anand2532/PocketMate/mechanical/freecad/README.md

# mechanical/freecad

> **Superseded:** the current enclosure is [`../release_v5/`](../release_v5/) (see [`../README.md`](../README.md)).

**Last FreeCAD version: v4_22c** — passive 22 mm aluminium unibody (layout final positions).
- `pocketmate_enclosure_v4_22c.FCStd` – FreeCAD model, built by `build_v4_22c.py`
- STEP: `pocketmate_al_unibody_v4_22c.step`, `pocketmate_assembly_v4_22c.step`, `pocketmate_plastics_v4_22c.step`, `pocketmate_sidekey_flex_v4_22c.step`
- Renders: `pocketmate_enclosure_v4_22c_*.png`
- Board outline: `board_outline_v4_22c.dxf` (generated by `gen_board_v4_22c.py`)
- Keep-outs: `keepouts_v4_22c.md` (a delta on v4_22b, which is not in this repo)

Earlier v2 files (`*_v2.*`, `build_enclosure_v2.py`) are kept for reference and are superseded.
Thermal notes live in `../` (`thermal_v2.md`, `thermal_v3.md`, `thermal_v3_ribs.md`, `thermal_v5_22.md`).
