anand2532/PocketMate/hardware/layout/placement_plan_v1.md

# PocketMate CM5 carrier: stackup and placement plan v1, rev B: mechanical v3 (2026-10-21)
Inputs: mechanical **v3** (`mechanical/board_outline_v3.dxf`, `keepouts_v3.md`; it supersedes v2), schematic v1 (`hardware/kicad`, ERC clean, final netlist still to come).
PCB: `hardware/kicad/PocketMate.kicad_pcb` (generated by `hardware/layout/make_pcb_v3.py`; net classes in `PocketMate.kicad_pro`, layer-specific impedance rules in `PocketMate.kicad_dru`).
Coordinates: **mech frame** = body centre origin, +Y to top edge, viewed from the display side (same as keepouts_v2). KiCad Y = -mech Y.

## 1. Stackup: JLCPCB JLC06161H-3313 (6 layers, 1.6 mm, 1 oz outer / 0.5 oz inner)
Source: JLCPCB stackup table (https://jlcpcb.com/impedance): L1 Cu 0.035 | PP 3313 0.0994 (Er 4.1) | L2 0.0152 | core 0.55 (Er 4.6) | L3 0.0152 | PP 2116 0.1088 (Er 4.16) | L4 0.0152 | core 0.55 | L5 0.0152 | PP 3313 0.0994 | L6 0.035. Solder mask Er 3.8.

| Layer | Use |
|---|---|
| L1 F (display side) | components, short HS breakouts to FPCs/USB-C, power copper |
| L2 | **solid GND** (reference for L1 and L3) |
| L3 | **HS stripline**: DSI, CSI, USB (refs L4 at 0.109 mm and L2 at 0.55 mm), plus slow signals |
| L4 | **solid GND** |
| L5 | power planes: VSYS, +5V_CM5 (wide pour under CM5 5V pins), VBAT, 3V3 islands |
| L6 B (back) | J1/J2 only inside the CM5 footprint; GND pour; HS escape stubs from J1/J2 |

Impedances: computed with my own 2D quasi-static finite-difference field solver using the JLC geometry above (`hardware/layout/fd_impedance.py`, results in `impedance_results.txt`). **JLC verification status: NOT JLC-verified.** I tried JLC's calculator page and its backend (`POST https://jlcpcb.com/api/jlcTools/impedance/calc`). The endpoint answers, but the calculation runs asynchronously: the page sends a job (accessId + uuid + param MD5) and gets the result back on a push channel inside the browser session. A plain fetch cannot get the results without driving the site's internal session, so I stopped there. Enter these in https://jlcpcb.com/pcb-impedance-calculator:
- Layers 6, thickness 1.6 mm, outer copper 1 oz, inner 0.5 oz, unit mm; select stackup **JLC06161H-3313**.
- (a) 100 Ω differential, layer L1 (ref L2), spacing 0.15 → expected width ≈0.12. (b) Same on L6 (ref L5; **note L5 is my power plane, so JLC refs L5. Either make L5 GND under the L6 escapes or keep L6 HS to ≤3 mm stubs.**) (c) 100 Ω differential, L3, upper ref L2, lower ref L4, spacing 0.15 → ≈0.11.
- (d) 90 Ω differential L1/L2, spacing 0.15 → ≈0.15. (e) 90 Ω differential L3 (L2/L4), spacing 0.15 → ≈0.14.
- (f) 50 Ω single-ended L1 (ref L2) → ≈0.18. (g) 50 Ω single-ended L3 (L2/L4) → ≈0.15.
If JLC returns widths more than ±0.01 mm different, update `PocketMate.kicad_dru` and the net classes to the JLC numbers. Production uses JLC's numbers.

| Target | Layer | Width / gap (mm) | Solved | JLC-verified |
|---|---|---|---|---|
| 100 Ω diff (DSI, CSI) | L1/L6 microstrip | 0.12 / 0.15 | 99.8 Ω | no (pending) |
| 100 Ω diff | L3 stripline | 0.11 / 0.15 | 101.5 Ω | no (pending) |
| 90 Ω diff (USB 2.0) | L1/L6 | 0.15 / 0.15 | 90.8 Ω | no (pending) |
| 90 Ω diff | L3 | 0.14 / 0.15 | 90.2 Ω | no (pending) |
| 50 Ω SE | L1/L6 | 0.18 | 49.8 Ω | no (pending) |
| 50 Ω SE | L3 | 0.15 | 50.7 Ω | no (pending) |
Keep GND pours at least 3× the width away from pairs, or ≥0.3 mm. Place GND stitching vias next to every layer-change via. Do not route L3 HS pairs across any L4 split; L4 stays unbroken.

## 2. Board file (done, rev B to v3)
- v3 changes: boss keep-outs R3.2 at (57.5,±31.5), off-board, so no corner trim. SoC pad zone (no B-side parts except J1/J2) moved to X 7..37, Y -28..2. **No-copper, no-parts rule area, all layers, X 47.5..54, Y -11.5..-0.5** (CM5 antenna edge). No parts on F/B along the U.FL pigtail path at Y 0..2, X 47.5..54. F-side no-parts area X 9..21, Y 24..27 for the display FPC drop onto J3 (≥15 mm free length). The RF free volume X 54.4..60, Y -25..11 is off-board (marked on User.Comments); the board edge at X 54 sits 0.4 mm short of it.
- USB-C **J6 = HRO TYPE-C-31-M-17** (KiCad `USB_C_Receptacle_HRO_TYPE-C-31-M-17`), placed and locked at (20,-32.1), mouth at Y -35.5. No fully SMD 16-pin USB2 receptacle exists in the KiCad library (GCT USB4135 is 6-pin/power only), so I chose the one whose rear shell pegs are at **Y -29.1 (<-29 ✔)**. Their pad copper reaches Y -28.25 at X 24.32. That is only ≈0.15 mm from the J2 body edge (Y -28.4) in Y, on the opposite side. Check this against the real J2 footprint once it is placed. Cleaner alternative: move USB-C to centre X 12 (needs an enclosure opening change). Front pegs at -32.9 sit 0.25 mm from the board edge (local rule J6 edge ≥0.2 mm).
- J_NTC (JST SH SM02B-SRSS-TB) placed at (2,-20).
- DRC after v3: **0 errors**, 0 unconnected (warnings: silk/text only).
- Earlier v2-based content:
- 6 layers, 1.6 mm. Outline from v2: X -1..54, Y -34..35, R3 corners, camera notch removed (X≥27, Y≥10.5).
- H1–H4: M2.5 Ø2.7 at (2.5,-26.5) (50.5,-26.5) (2.5,6.5) (50.5,6.5), no copper. Rule areas R3.0 around each hole (no tracks/vias/pours, F+B).
- Boss keep-out R3.2 at (57,-31), all layers.
- B side: rule area over the CM5 footprint (X -1..54, Y -30..10), J1/J2 only. SoC pad zone (11.5..41.5, -25..5) also allows no footprints on B.
- F.Fab/B.Fab: drawings of the connector zones, CM5 and J1/J2; User.Comments: height limits. DRC: 0 errors (only text/silk warnings).

## 3. CM5 B2B J1/J2 (Amphenol 10164227-1001A1RLF, 1.5 mm stack), verified against the official drawing
Source: Raspberry Pi *Compute Module 5 datasheet*, §4.1.1 Figure 4 "Mechanical specification… viewed from the top" (https://datasheets.raspberrypi.com/cm5/cm5-datasheet.pdf, p.16), plus Table 13 (mounting holes at (3.5,3.5) (51.5,3.5) (3.5,36.5) (51.5,36.5)).
From the figure (module top view, origin at the bottom-left corner): both connectors are centred **21.5 mm from the hole centre = X 25.0**. Their centrelines are **3.0 mm** from the long edges (Y 3.0 for pins 101–200, Y 37.0 for pins 1–100). Pin 1/2 and pin 101/102 sit at the right (high-X) end. The SoC centre is at (31.99, 16.975). The UFL is 2.567 mm from the left edge, in the wireless cut-out at the left edge.
Mapping (inverted CM5 seen from the display side = mirror in X): **carrier X = 54 - mx, Y = -30 + my**. The holes map onto H1–H4 exactly.

| Ref | Side | Centre, mech (X,Y) | Centre, KiCad (X,Y) | Orientation |
|---|---|---|---|---|
| **J1** (CM5 pins 1–100) | B | **(29.0, 7.0)** | (29.0, -7.0) | long axis along X; pin 1/2 end at X≈18 (low-X end) |
| **J2** (CM5 pins 101–200) | B | **(29.0, -27.0)** | (29.0, 27.0) | long axis along X; pin 101/102 end at X≈18 |
- Each body is about 22.5 × 2.8 mm (J1 X 17.75..40.25 / Y 5.6..8.4; J2 Y -28.4..-25.6). Mirror the footprint (B side), then check pin 1 against the module with a 1:1 print before release. The datasheet figure is labelled "approximate". **Cross-check the exact centres against the CM5 design-files package (KiCad/STEP) once downloaded** before routing.
- **Correction to keepouts_v2**: it shows J1/J2 at "X 3..25 / 28..50, Y 0..4". That is wrong. The two connectors run along the two 55 mm edges (Y 7 and Y -27), both at X≈18..40.
- SoC lands at mech **(22.0, -13.0)**. The v2 pad/pedestal is centred at (26.5,-10), 4.5 mm/3 mm off. It still covers the die but should be recentred.
- The wireless cut-out/antenna is at carrier X≈47.5..54, Y≈-11.5..-0.5. The UFL is at about (51.4, 1.0) and faces the Al back plate.

## 4. Connector placement (top/F side unless noted)
| Item | Position (mech) | Notes |
|---|---|---|
| USB-C J6 | X 15.5..24.5, Y -34..-28.1, mouth flush at Y -35.5 wall | Its body sits directly over J2 (B side, Y -28.4..-25.6). **Use an SMD-only receptacle with SMD shell tabs, or keep the THT shell pegs at Y < -29.** No THT may enter the J2 B-side area. ESD (USBLC6) and TVS go right behind it at X 9..15. |
| J_BATT (J7) JST ZH 3p side-entry S3B-ZR-SM4A-TF | X 0.75..8.25, Y 21.75..26.25, mouth −X, 3.5 mm tall | BAT+/NTC/BAT−. The 10 mΩ gauge shunt and MAX17055 go within 10 mm at X 2..12, Y 12..20. BAT+/BAT− get ≥1.5 mm traces plus a pour on L1/L5. |
| DSI J3 22p 0.5 mm | X 10..20, Y 20..24 | Display flex exit still to verify. 4.0 mm ledge band if it is within 2 mm of the glass edge. |
| CSI J4 22p 0.5 mm | X 28..40, Y 7..10 | Flex to the camera in the notch (X 28..53, Y 11..35). Lies over J1 on the opposite side. Fine, but keep its vias out of the J1 pad field. |
| Flex J (speaker, 2 mics, mute switch, 4 buttons, ALS, **case NTC**) | X 44..52, Y -33..-30 | Proposed: 0.5 mm FPC, about 24p. The pin count needs the final netlist. |
| **Case NTC** (on the Al back plate inner face at (-55.3,-10)) | wiring | It is not on the carrier, and schematic v1 has **no case-NTC circuit**. Proposal: 10 k NTC (0402 on a small Kapton flex, or a glued bead) → 2-wire 32 AWG / flex tail along the back plate under the battery-pocket bottom edge (Y≈-33, X -55→-1, ~65 mm) → **dedicated 2-pin JST SH SM02B-SRSS-TB (top side, 2.9 mm tall) at X 0..4, Y -22..-18**. Alternative: join the main flex, but that adds ~110 mm of routing to the right end. The divider goes to a +3V3_AON 10 k ref and an STM32U031 ADC pin (MCU next to it, see §5), with 100 nF at the ADC. |
| SWD TC2030 | X 4..12, Y -8..-2 (top) | |

## 5. Power / PMIC / thermal zoning (top side)
- **Input/charger zone**, bottom-left, X -1..15, Y -33..-14: STUSB4500, Q1, BQ25895 plus its 1 µH/2.2 µH inductor (max 4.9 mm; choose ≤2.0 mm, e.g. 4×4×2). Keep the input loop ≤10 mm from USB-C. Put VBUS/VSYS/BAT pours on L1 and duplicate them on L5. Thermal vias go into L2/L4.
- **Boost zone**, X 0..14, Y -12..4: TPS61088 with ≥10 thermal vias under its PowerPad, a 1 µH/≥6 A inductor ≤2 mm tall, and output caps. +5V_CM5 runs on an L5 pour to the J2 and J1 5V pins (the CM5 5V pins are on J1 pins 77–87 area; confirm against the netlist). Load switch Q2/Q3 sits near the boost output. Keep the boost hot loop on L1 only, over solid L2.
- **MCU + AON LDO**, X 2..12, Y 8..20 (near J_BATT, buttons flex via L3), plus the case-NTC connector.
- **Audio** (MAX98357A) near the flex at X 36..44, Y -33..-28. Its BCLK/LRCLK/DOUT come from J2-side GPIOs.
- **Sensors** (VEML7700 sits behind the ALS window at (-58,20) on the far left, so it goes on the flex, not the carrier; DRV2605L DNP) near the flex.
- Thermal: the SoC heat path is CM5 → pad → Al pedestal → back plate. The carrier top under the display holds the charger/boost: keep them ≥15 mm apart, keep the boost and charger out from under the display-backlight centre where possible, and put the charge/boost thermal vias into the L2/L4 GND. Fit a 0402 NTC on the board near the charger for skin-temperature control (BQ TS is used for the cell NTC).

## 6. High-speed routing
All MIPI and USB2 signals live on **J2** (CM5 pins 101–200, Y -27) on the CM4/CM5 pinout: USB2 D± ~103/105, MIPI0 CSI ~115–145, MIPI1 DSI ~157–193. Confirm the exact pins with the final netlist.
- **USB2 (90 Ω)**: J2 → L6 stub → via → L1 → USB-C. Length <10 mm, no stubs, ESD placed in-line on L1.
- **DSI (2 lanes + clk, 100 Ω)**: J2 B-side escape (≤3 mm) → via → **L3** stripline north under the CM5 area at X 12..20 → via near J3 → L1 into the FPC. Length ~55 mm. Intra-pair ≤0.1 mm, lane-to-clock ≤1 mm, pair-to-pair gap ≥0.45 mm (3W), 2 vias per signal max with GND stitch vias.
- **CSI (2 lanes + clk, 100 Ω)**: J2 → L3 north at X 28..36 → J4 (X 28..40, Y 7..10). Length ~38 mm. Avoid the J1 pad field: cross Y 5.6..8.4 only on L3.
- Keep L3 HS pairs away from the boost switch node (≥5 mm laterally, and L4 GND is unbroken beneath).
- I2C/I2S/GPIO go on L3/L1 in the remaining space. 5V and GND pins of J1/J2 get direct vias to L5/L2/L4.

## 7. Height limits (from keepouts_v2)
Top: 4.9 mm everywhere, 4.0 mm in the display-ledge band. B side in the CM5 footprint: J1/J2 only. B side Y -34..-30 / 10..10.5: 5.6 mm. Hole R3.0 and boss R3.2: no parts. Tallest planned top parts: USB-C 3.3, J_BATT 3.5, inductors ≤2.0, SH 2.9: all OK.

## 8. Changes needed from Enclosure
1. **Fix J1/J2 in keepouts/DXF**: J1 centre (29.0, 7.0), J2 centre (29.0, -27.0), both 22.5×2.8 mm, B side (not "X 3..25 / 28..50, Y 0..4").
2. **Recentre the thermal pad/pedestal on the SoC at (22.0, -13.0)** (currently (26.5,-10)).
3. **Wi-Fi antenna**: the CM5 antenna/UFL edge (X 47.5..54, Y -11.5..-0.5, UFL at ~(51.4,1.0)) faces the Al back plate, which will detune or block the onboard antenna. Either cut a window or a plastic insert in the plate over X 46..55, Y -13..1, or route a UFL pigtail to an external flex antenna (e.g. under the plastic right-end/action-button area). An external antenna is my recommendation.
4. **Boss (57,-31) clearance**: the board edge at X 54 is 3.0 mm from the boss centre, but the R3.2 requirement needs 3.2. Either move the boss to X 57.2+ or let me cut the board corner: X ≤ 53.8 for Y < -28. Please confirm which.
5. **Case NTC lead path**: provide a channel/clip along the back plate from (-55.3,-10) to the carrier at about (2,-20) (~65 mm) for a 2-wire 32 AWG or 3 mm flex tail.
6. Display FPC drop defined in v3 (X 9..21, Y 24..27); still verify it against the panel drawing. Previously: confirm the display FPC exit position (DSI J3 at X 10..20, Y 20..24) and the camera flex length/bend into J4.
7. USB-C: confirm the receptacle's mid-plane Z (9.6..12.9) and whether any shell pegs are allowed to go through the board (they would clash with J2).

## 9. Open issues
- **Schematic**: add the case-NTC circuit and its connector. Final netlist still pending: the J1/J2 pin-to-signal split and the flex pin count are provisional.
- J1/J2 centres come from the datasheet figure; confirm them in the CM5 design-files CAD.
- The impedances come from my own solver, not the fab's tool; JLC calculator confirmation is pending.
- The Akyga cell PCM length is unverified (Enclosure note).

## 10. Open items after v3
- **JLC impedance confirmation** (inputs in §1). The L6 microstrip reference is L5 (power), so keep the L6 HS escapes ≤3 mm or add a GND island on L5 under them.
- J6 rear pegs are ~0.15 mm from the J2 body edge (Y); decide whether to keep X 20 or move USB-C to X 12 (needs an Enclosure change).
- The RF free volume begins at X 54.4. The board ends at 54, but the CM5 edge is also at 54, so 0.4 mm margin, as Enclosure stated.
- CM5 firmware external-antenna setting: verify. The custom FPC antenna needs RF/SAR certification.

---
## 11. Rev C (netlist v2.1, JLC impedance, rough placement). This section supersedes conflicting text above.
### 11.1 Impedance: JLC calculator values (JLC06161H-3313, finished 1.54 mm, gap 0.15), now used in net classes and `PocketMate.kicad_dru`
| Target | Layer | JLC width | Used (w / gap) | Status |
|---|---|---|---|---|
| 100 Ω diff | L1/L6 | 0.1041 | 0.105 / 0.15 | JLC-verified |
| 100 Ω diff | L3 | 0.0975 (below 0.1 min, flagged) | **0.10 / 0.16 provisional** | my solver calibrated to JLC's 0.0975/0.15 point; **re-check 0.10/0.16 in JLC** |
| 90 Ω diff | L1/L6 | 0.1356 | 0.135 / 0.15 | JLC-verified |
| 90 Ω diff | L3 | 0.1278 | 0.128 / 0.15 | JLC-verified |
| 50 Ω SE | L1/L6 | 0.1509 | 0.15 | JLC-verified |
| 50 Ω SE | L3 | 0.1420 | 0.142 | JLC-verified |
My FD solver came out **10–15 % wider than JLC** for the same impedance. JLC's numbers govern; the solver is used only for relative moves. My solver puts L3 at w 0.10 → 100 Ω at a gap of about 0.155–0.16 (grid noise ±2 Ω), not 0.18–0.20. Skew: MIPI ≤0.1 mm, USB ≤3.8 mm.

### 11.2 CM5 signal locations (netlist v2.1)
- **J1**: I2S on pins 25/26/27/49 (plus power/GPIO). The audio block (U1, mics, mute switch) therefore routes to J1 (Y 7), not J2.
- **J2**: USB D− 103 / D+ 105, CSI 115–141, DSI 175–196. All high-speed signals start at the J2 row at Y −27 (pin 101 end at X 19.2, pin 199 end at X≈38.8).
- DSI (J2 175–196 = X≈34..38.4) → L3 north → J3. CSI (115–141 = X≈22..27) → L3 north → J4.

### 11.3 Placement (rough, done in PCB; no routing except USB)
- No UI flex. VEML7700 (U10), buttons SW1–SW4 and the mute switch SW5 are on the carrier.
- **J3 DSI FH12-22S** at (17, 19.1) rot 180: courtyard X 8.45..25.55, Y 16.1..24.0. The cable enters from +Y (FPC drop X 9..21, Y 24..27 kept clear).
- **J4 CSI FH12-22S** at (36, 5.4) rot 180: X 27.45..44.55, Y 2.4..10.3, cable from +Y (camera notch). FH12 is 17.1 mm wide, so it extends beyond the old 10–12 mm zones.
- **J6 USB-C HRO TYPE-C-31-M-12** moved from X 20 to **centre X 13.5** (mouth Y −35.5). At X 20, the rear shell pegs (S1 at fp y −3.13 → Y −28.72) and the NPTH Ø0.65 pegs (Y −29.25) landed on or right beside the J2 B-side pads (verified by DRC shorts). Note: in the footprint, +1.05 is the *front* (mouth-side) peg pair; the rear pair is at −3.13. At X 13.5: pegs X 9.18/17.82, NPTH 10.61/16.39. Right rear peg copper ends at X 18.32 vs J2 pad 101 at 19.1, so 0.78 mm clear. Courtyard X 8.13..18.86, Y −36.05..−26.54. **Enclosure USB opening X: 20 → 13.5.**
- (superseded by §17–18) **J7 Molex Pico-Lock 205338-0005 (was 504050-0391)** at (4.6, 23.6) rot 270, mouth −X: courtyard **X 0.73..8.45, Y 18.32..28.88** (10.46×7.62; it extends 2.6 mm further in +Y than the old JST zone). Pins 1 BAT+, 2 NTC, 3 BAT−.
- **J10** (case NTC, SH 2p) at (2,−20).
- L2 XAL5030 (3.1 mm) at (13,−5) top, outside the ledge band. The boost U8, Q2, Q3 are nearby. Charger U5/L1 at (8..14,−17). STUSB4500 U4 at (10,−24). The gauge U6 sits at the J7-side power area (auto-nudged).
- MCU U9 (6,13), LDO U7 (13,14), SWD J8 (20,13), Q4/Q5 at Y 10.
- Top strip Y 28..35: MK1 (25,33.2) by mic port X 22; MK2 (2.5,32); mute SW5 (6.5,32.3) by the slider at X 8; D1; SW1 power (14,31.3).
- SW3/SW4 had no room in the top strip and are parked at (32,−4)/(38,−4). SW2 action is at (40,−1). **The buttons don't line up with the case:** power/vol are at X −45..−18 over the cell, and the action button is at X 62.5, Y 20, both off-board. Enclosure must provide plungers/light-pipes or move the buttons, or they go back on a flex.
- U10 VEML7700 at (30,1): the ALS window is at (−58,20), off-board, so it needs a light pipe or a window move.
- Audio U1 (42,−26), speaker J5 (47,−30); U11/J9 haptics (42..46,−14..−18).
- Passives are auto-placed next to the IC they share a signal net with (rough; they need hand placement).

### 11.4 USB route (done)
J6 A6/A7 (B6/B7 tied through L3 vias) → F.Cu 0.135/0.15 north to U2 USBLC6 (rot 0 at (17.6,−22), flow-through pins 1→6 / 3→4) → vias (0.45/0.2) at (20.2,−24.3) DP and (19.4,−23.6) DM → B.Cu into J2 105/103 pad tips. Open: **DP/DM length mismatch of 6.4 mm** (DRC skew error vs 3.8 mm), mainly from the B6 tie dogleg. It needs a tune or a tie rework.

## 12. Rev D (keepouts_v4_22)
- **Z limits (v4_22)**: carrier Z 9.94..11.54. Top side 4.9 mm (4.0 in the ledge band). B side outside the CM5 7.6 mm, but 5.6 mm in the heat-sink zone X 2..42, Y -33..7. Inside the CM5 footprint J1/J2 only. (Noted on User.Comments in the PCB.)
- **J6 HRO TYPE-C-31-M-12**: centre **(13.5, -33.25)**, mouth **Y -36.9** (0.6 mm inside the outer wall at -37.5). Moved 1.4 mm in -Y, not 3 mm: the front shell legs (fp +1.05 → Y -34.3) must stay on copper. To allow this the carrier gets a **local tab X 8.3..18.7 down to Y -35.3** (0.2 mm short of the inner wall at -35.5). The shell overhangs the tab by 1.6 mm and the nominal edge (-34) by 2.9 mm. Rear legs at **Y -30.12** (<-29 ✔), 0.78 mm clear of the J2 pads in X. Courtyard X 8.13..18.86, Y -37.45..-27.93.
- USB-C Z: the shell sits on the carrier top (Z 11.54) → Z 11.54..14.70 against the opening Z 11.45..15.05. That leaves 0.09 mm below and 0.35 mm above; recentre the opening to about Z 11.36..14.96, or accept it. **Opening X must move 20 → 13.5.**
- **J3**: centre (18.33, 19.1), courtyard X 9.71..26.89 (it cannot fit X 11..21; the FH12-22S is 17.1 wide), Y 16.05..24.05. It clears the J7 window (X ≤ 9.73) by 0.03 mm courtyard / ~0.5 mm copper, and sits 0.1 mm courtyard (0.65 mm copper) inside the camera-notch edge at X 27.
- **D2** at (6.5,-31.0) rot 90, clear of the edge.
- **USB length-matched**: DP 24.944 / DM 24.964 mm (Δ 0.02 mm), using a 2-bump meander on DM (L1, h 1.6 mm) between J6 and U2.
- **FH12-16S side-key flex (requested X 22..35, Y 27..31): NOT placed.** X ≥ 27 at Y ≥ 10.5 is the camera notch (no board), and the FH12-16S is about 12 mm wide. Candidate spots: X 14.5..26.5, Y 28..32 (after the carrier buttons/mics move to the flex), or the top-left strip X 0..12, Y 29..34.

## 13. Rev E (new parts, side-key flex)
- **Side-key flex FH12-16S**: the top-left X 0..12, Y 29..34 **does not fit**. The connector courtyard is 7.9 mm deep (Y), but only 6.1 mm is free between the J7 window top (Y 28.88 courtyard) and the board edge (Y 35). It is placed instead at **(19, 30.1) rot 180, courtyard X 11.9..26.09, Y 27.05..35.05**, with cable entry at the top edge. It clears the DSI FPC drop zone (Y ≤ 27) and the camera notch. Reserved as board-only `J_SIDEKEY`. The current schematic calls it J11 (fan = J12), but **PocketMate.net (155 parts) has not been re-exported** with J11/J13/U13/C58/R54. Once it is, J11 lands on the same spot.
- U12 TLV62585 at (17.5,-5.3) and L3 at (16,-9.7), both in the boost/power zone next to U8/L2.
- J12 fan (DNP) on the display side at the bottom edge (29.7,-29.8), courtyard X 25.7..33.6, Y -33.1..-26.5. That is outside the RF, USB and ribbon zones.
- D5 (24.5,26), TP3 (17.5,14.6).
- Temporarily moved to make room (they go to the flex): MK1 (44,-6), SW5 mute (36,-9).
- **Board outline fix**: the three corner arcs were drawn as 270° (concave) since v1. They are corrected to 90° convex R3 corners, and `make_pcb_v3.py` is fixed too.

## 14. Rev F (netlist v3, 160 parts; 141 on the carrier)
- **Flex parts (SideFlex sheet, not on the carrier)**: J13 (flex tail), SW1 POWER, SW2 ACTION, SW3 VOL+, SW4 VOL−, SW5 mic-mute DPDT, D1 mute LED + R54 1k, MK1/MK2 SPH0645 + C55/C56 100 nF, R50/R51 0R, R52/R53 100k, U10 VEML7700 + C57 100 nF / C58 1 µF. DRC shows these as "missing footprint" (expected).
- **J11 FH12-16S** at (19, 30.1) rot 180, locked (J_SIDEKEY removed).
- J11 support parts on the **B side directly under J11** (outside the CM5 footprint and the heat-sink zone, B limit 7.6 mm). The top side above J3 has no room. U13 TPD4E05U06 (19,32), D5 (13.5,31.5), D4 (24.5,31.5); C49–C52, R7, R8, R19, R20, R41–R44 (pull-ups, 10 nF, 33R mic data, 10k/100k divider) in two rows at Y 28.6 / 26.4, X 12.6..25.2. This needs short vias from J11 pads.
- U7 is now SOT-23-5: no clearance issue, no local rule needed (there was none).
- TP3 removed. Locked: J1, J2, J3, J4, J6, J7, J11, J12 (J12 nudged to (30,−30.2) for edge clearance). USB route kept (DP 24.944 / DM 24.964 mm).

## 15. Impedance: final, all JLC-verified (JLC06161H-3313, finished 1.54 mm)
| Target | Layer | Width / gap (mm) | JLC result | Status |
|---|---|---|---|---|
| 100 Ω diff | L1/L6 | 0.105 / 0.15 | 0.1041 @0.15 | JLC-verified |
| 100 Ω diff | L3 | **0.106 / 0.18** | 0.1064 @0.18 (0.16 gave 0.1011, flagged <4 mil) | JLC-verified |
| 90 Ω diff | L1/L6 | 0.135 / 0.15 | 0.1356 | JLC-verified |
| 90 Ω diff | L3 | 0.128 / 0.15 | 0.1278 | JLC-verified |
| 50 Ω SE | L1/L6 | 0.15 | 0.1509 | JLC-verified |
| 50 Ω SE | L3 | 0.142 | 0.1420 | JLC-verified |
This supersedes the provisional L3 0.10/0.16 in §11.1. The MIPI net class default stays 0.105/0.15 (outer); `PocketMate.kicad_dru` enforces 0.106/0.18 on L3.

## 16. Rev G (netlist v3.1, placement pass)
- Flex list additions: **D6 GREEN REC LED + R57 1.3k** (also R55 100k, R56 1k on SideFlex).
- **U14 TPS22917 (MIC_FEED switch)** on the B side right under J11 (19.8,23.0). C53 (VIN 100 nF) and R46 (EN 100k pulldown) are at X 16.4; C54 (MIC_FEED 100 nF) and R45 (QOD 0R) at X 23.2. MIC_FEED → J11 pin 3 is about 6 mm via one via. +3V3_PERIPH comes from U12 (17.5,-5.3) on an L5 pour.
- Passive pass (`place_passives.py`): each F-side R/C goes to the nearest free spot next to the IC pad it serves. Decoupling caps (power+GND) are placed first, and spots are courtyard-, track-, hole- and keep-out-checked. Still >5 mm from their pin (power zone is dense; hand-tune during routing): U5 charger caps C22/C23/C29/C30/C39/C40 (~8–9 mm), U8 boost caps C36–C38 (~6 mm), U4 C14–C16 (~6 mm), U3 C27/C28 (~6 mm).
- Renders: `pcb_top_render.png`, `pcb_bottom_render.png` (kicad-cli 3D render).

## 17. Rev: netlist v3.2, J7 205338-0005, power copper rules (2026-10-21)
- **J7 footprint vs Molex 2053380000-SD** (sales drawing p.2 recommended pattern, chart p.1): signal pads 1.10x1.45 at 2.00 pitch (B=8.0 for 5 ckt) match; mounting pads 1.35x2.90 match; MP c-c 13.79 vs chart A=13.95 (same 0.16 offset as KiCad stock -0004/-0006 vs A=11.95/15.95), consistent; signal-row to MP-centre 5.995 vs 1.45/2+3.8+2.9/2 = 5.975 (0.02 mm, same as stock). No change needed.
- **J7 placed** at (3.7, 25.2) rot 270, cable mouth -X at the left edge. Courtyard X -1.01..8.34, Y 17.09..33.31; MP pad 0.5 mm inside the (2,32) R3 corner arc. Clear of J3 (X>=9.71) and J11 (X>=11.9). Enclosure: battery window moves from X -0.73..9.73 / Y 20.19..27.81 to about Y 17.1..33.3, mated height 2.6 mm.
- R18 (10 mOhm 1206) at (3.4, 14.9), U6 MAX17055 at (7.2, 12.3), U9 moved to (14.5, 11.5), J8 to about (20, 3.4). Kelvin CSP/CSN sense traces go from the inner pad edges of R18, as a separate pair, to U6 (manual routing, which DRC cannot enforce).
- Power DRU rules added: VBAT and BAT_N track min 1.0, opt 3.0 (route as pours >=3 mm; via 0.6/0.3); VBUS_C, VBUS_CHG, VSYS, CHG_PMID, +5V_BOOST and the SW nodes (CHG_SW, BST_SW, BUCK3V3_SW) min 1.5, opt 2.0. ">=4 x 0.3 mm vias per VBAT layer change" is a routing checklist item (KiCad has no via-count rule). BAT_N pour: J7 to R18 to GND.
- U5 footprint (RTW-24 _ThermalVias) has 3x3 = 9 thermal vias in the EP, which meets the >=6 requirement.

## 18. Rev: netlist v3.4, Enclosure v4_22b, charger moved (2026-10-21)
- **Netlist v3.4** imported (v3.3 changes plus the J11 part number FH12-16S-0.5SH(55), same footprint). Q6 2N7002 mute-status inverter is at B-side (9.8, 30.4) beside the J11 group. Its 10k pull-up and the 100k/100nF on MIC_SW_LIVE are in the J11 B-side passive grid, which picks parts by J11/U13 nets, so the changed pins 11 (MIC_SW_LIVE) and 15 (+3V3_PERIPH) are re-checked automatically. D5 is on MIC_SW_LIVE. The old 10k/100k divider is gone. Nothing is routed in that group yet.
- **Outline v4_22b:** the DXF top edge is Y 34.5, not 35, so the board's top edge is now 34.5, with the R3 corner centre at (2, 31.5). Every other edge and the J6 tab (X 8.3..18.7 to Y -35.3) match the DXF.
- **J7 205338-0005** centre (3.76, 23.7) rot 270. Courtyard X -0.95..8.39 (0.05 inside X -1.0), Y 15.59..31.82, below the mute slider (Y >= 31.9). The brief asked for X 3.7; it is 3.76 to keep the 0.05 mm.
- **J11:** (19, 29.4), courtyard Y 26.36..34.34. The J11 B-side group moved -0.7 too. The DSI-drop keep-out is trimmed to Y 24.05..26.3, because the v4_22b tail drops into J3 at Y 24.05..26.5 and folds above J11.
- **J4:** (36, 4.9).
- **J12:** stays SM04B-SRSS-TB, right-angle, 2.95 tall.
- **Top-side keep-out:** no passives at Y >= 30.5 (side-key flex, slider, LED and mic zone).
- **Charger group:** U5 is at (5.8, 12), L1 at (12, 5.5), U6 at (9.8, 12.5), R18 at (1.0, 12.5) rot 90. VBAT runs 14.5 mm from the J7 pads to the U5 pads (target < 20). VBUS from J6 to U5 is about 45 mm along the left column, routed as a 1.5–2 mm trace or pour.
- **Moved:** U9 to (14, -2), U12/L3 to (13/17, -13), Q4/Q5/U7 to (13.2/17.1/21.7, 12.6), J8 SWD to (36, -12).
- **U5 thermal vias:** 9 PTH (3x3, 0.2 drill / 0.5 pad, GND) in the EP. Back-side placement now blocks the area over all PTH pads.
- **Flex parts (SideFlex sheet, not on the carrier):** C57, C58, C59 100nF; C60 1uF; D1 red mic-muted; D6 green REC; J13 flex tail; MK1/MK2 SPH0645LM4H-B; R51/R52 0R; R53 100k; R54 1k; R55 1.3k; SW1 POWER, SW2 ACTION, SW3 VOL+, SW4 VOL-, SW5 MIC MUTE (DPDT slide); U10 VEML7700-TT.
- **Open:** about 12–20 non-bulk passives (depending on the auto-placer seed) are 3–7 mm from their pin, mostly U8 FB/COMP, U5 ILIM/TS, and U1/J4 decoupling. They need a manual nudge before routing.
