anand2532/PocketMate/software/os/keys/CUSTODY.md

# Signing-key custody record (TEMPLATE — no secrets, §2.2.1)

| Asset | Fingerprint (SHA-256) | Token serial | Valid from → to | Location (generic) | Last verified |
|---|---|---|---|---|---|
| K-root (root CA) | TODO | n/a (offline USB A/B) | TODO | home / off-site | TODO |
| K-rel (release intermediate) | TODO | TODO (T1) | TODO | token T1 + offline backups | TODO |
| K-mcu (MCU fw ed25519) | TODO | TODO (T1 slot) | TODO | token T1 + offline backups | TODO |
| CRL | TODO | — | next update: TODO | repo `os/keys/public/` | TODO |

Annual drill log: (date, result) — TODO
