anand2532/PocketMate/research/market.md

# PocketMate: Market & Competitor Research
_Compiled 21 Oct 2026 (IST). Aligned with /workspace/pocketmate/PRD.md. Every factual claim has a URL. Recommendations marked **[Rec]** are my own conclusions drawn from the cited evidence._

## 1. Competitors

### Rabbit R1 (2024)
- **Price:** $199, no Rabbit subscription. Cellular use away from Wi-Fi needs your own SIM/data plan ($15–40/mo by carrier estimate), and paid services such as Midjourney cost extra. https://www.theverge.com/2024/1/9/24030667/rabbit-r1-ai-action-model-price-release-date ; https://www.androidauthority.com/rabbit-r1-subscription-3437340/
- **Features:** "Large Action Model" meant to use apps for you; Teenage Engineering design; camera, scroll wheel, small screen; MediaTek Helio G35; nano-SIM only, no eSIM. Sources: same as above.
- **Loved:** fun, whimsical design; first 10,000 units sold out at launch. https://www.theverge.com/24138746/rabbit-r1-hands-on-ai-gadget-chatgpt ; https://www.engadget.com/rabbit-r1-review-a-199-ai-toy-that-fails-at-almost-everything-161043050.html
- **Hated:** "underwhelming, underpowered, and undercooked", wrong vision answers (called a Dorito a taco) https://www.theverge.com/2024/5/2/24147159/rabbit-r1-review-ai-gadget ; poor battery that drained while idle, AI often fails, Uber integration didn't work, tiny screen, awkward scroll wheel, "chunkier and dumber phone" https://www.engadget.com/rabbit-r1-review-a-199-ai-toy-that-fails-at-almost-everything-161043050.html

### Humane AI Pin (2024–2025, shut down)
- **Price:** $699 at launch, cut to $499, plus a $24/mo subscription. https://arstechnica.com/gadgets/2025/02/truly-a-middle-finger-humane-bricking-700-ai-pins-with-limited-refunds/ ; https://www.slashgear.com/1794149/humane-ai-pin-shutdown-timeline-refund-details/
- **Features:** screenless voice wearable with laser projection display, gestures, calls and messaging. https://www.slashgear.com/1794149/humane-ai-pin-shutdown-timeline-refund-details/
- **Reviews:** The Verge said "it just doesn't work"; MKBHD called it "the worst product I've ever reviewed." https://www.theverge.com/news/614883/humane-ai-hp-acquisition-pin-shutdown . Complaints: inconsistent performance, sluggish responses, poor battery, few app integrations, charge-case recall. https://www.slashgear.com/1794149/humane-ai-pin-shutdown-timeline-refund-details/ . Returns at one point outpaced sales. https://www.reuters.com/markets/deals/ai-startup-humane-wind-down-wearable-pin-business-sell-assets-hp-2025-02-19/
- **Shutdown:** HP bought the assets for $116M. Pins stopped connecting on 28 Feb 2025 and kept only offline functions like battery level. User data was deleted. Refunds went only to units shipped on or after 15 Nov 2024. https://support.humane.com/hc/en-us/articles/34243204841997-Ai-Pin-Consumers-FAQ ; https://www.reuters.com/markets/deals/ai-startup-humane-wind-down-wearable-pin-business-sell-assets-hp-2025-02-19/ . Ars Technica called it "$700 e-waste". https://arstechnica.com/gadgets/2025/02/truly-a-middle-finger-humane-bricking-700-ai-pins-with-limited-refunds/

### Plaud NotePin / Note
- **Price:** NotePin $159 list (seen at $127.20–$169); Note $159; NotePin S $179; Note Pro $189. Plans: Starter free (300 min/mo), Pro $99.99/yr (1,200 min), Unlimited $239.99/yr. https://www.plaud.ai/products/plaud-notepin ; https://tldv.io/blog/plaud-notepin-review/ ; https://www.tomsguide.com/ai/plaud-notepin-review
- **Features:** 112 languages with speaker labels; 10,000+ summary templates; Ask Plaud; 20 h of recording; 40 days standby; 64 GB storage; worn as necklace, wristband, clip, or pin; ISO 27001, SOC 2, and HIPAA claims. https://www.plaud.ai/products/plaud-notepin
- **Loved:** excellent transcription of in-person meetings and interviews, customizable prompts https://www.tomsguide.com/ai/plaud-notepin-review ; compact, long battery https://tldv.io/blog/plaud-notepin-review/
- **Hated:** hardware plus subscription is "the worst of both worlds", about $399 in year one on Unlimited https://www.androidcentral.com/apps-software/ai/i-wore-an-ai-voice-recorder-on-my-wrist-for-a-week-heres-how-it-went ; no direct Zoom/Meet/Teams integration https://www.tomsguide.com/ai/plaud-notepin-review ; social friction, per the r/PlaudNoteUsers thread "Everyone Hates My Plaud" https://www.reddit.com/r/PlaudNoteUsers/comments/1icdc3z/everyone_hates_my_plaud/

### Limitless Pendant (acquired by Meta, Dec 2025)
- **Price:** $99. https://techcrunch.com/2025/12/05/meta-acquires-ai-device-startup-limitless/
- **Subscription (verified):** At the April 2024 launch, the free tier was "10 hours of AI features per month" and Pro was $19/mo. https://www.tomsguide.com/ai/forget-the-humane-ai-pin-this-new-ai-pendant-from-limitless-actually-looks-useful . The current FAQ says no subscription is required and the Free plan includes 1,200 min (20 h) of transcription per month, with Pro and Unlimited as upgrades. https://help.limitless.ai/en/articles/9124757-pendant-faq . fast.io says Unlimited previously cost $49/mo and is now free for existing users. https://fast.io/resources/limitless-ai-review-2026/
- **Features:** aluminum disc 1.25 in across and 0.62 in thick, Wi-Fi and Bluetooth, USB-C, claimed 100 h battery. https://www.tomsguide.com/ai/forget-the-humane-ai-pin-this-new-ai-pendant-from-limitless-actually-looks-useful . IP54; recording light that cannot be turned off "for privacy reasons"; can record 24/7 with pause; FAQ battery claim is "a full day of continuous recording"; iOS 18+ / Android 13+. https://help.limitless.ai/en/articles/9124757-pendant-faq
- **Reviews (secondary source):** fast.io says the 100 h figure was standby and that "reviewers consistently reported 6 to 7 hours" of continuous recording. It names no individual reviewers, so treat this as unconfirmed. It also reports strong English accuracy, weak non-English output, speaker mislabeling, and a cluttered app. https://fast.io/resources/limitless-ai-review-2026/
- **Outcome:** sales ended, existing users supported for one year, Rewind wound down. https://techcrunch.com/2025/12/05/meta-acquires-ai-device-startup-limitless/ . Service ended in the EU, UK, Brazil, South Korea, Israel, and Turkey. https://fast.io/resources/limitless-ai-review-2026/

### Bee (acquired by Amazon, Jul 2025)
- **Price:** $49.99 band plus $19/mo. https://techcrunch.com/2025/07/22/amazon-acquires-bee-the-ai-wearable-that-records-everything-you-say/
- **Features (verified in The Verge review):** wrist or clip, no screen, mics and a button; always listening; stores transcripts but no audio; optional access to email, calendar, contacts, location, and photos; to-dos, searchable history, and a chatbot that cites transcripts; daily diary entry at 8 PM; "fact Tinder"; red light when muted; iOS only at review time; cloud processing with a local mode planned. https://www.theverge.com/reviews/627056/bee-review-ai-wearable
- **Loved:** meeting summaries, task reminders, $50 price, battery of 3–7 days depending on mute use; the reviewer said she was "Pavlov'ed" into reading the 8 PM summary every night. Same source.
- **Hated:** invented events ("fanfiction"), mistakes TV, music, and podcasts for conversations, poor speaker separation, only 1 of 5 suggested to-dos was useful, fiddly button, no physical off switch, recorded a photographer after the reviewer thought it was disconnected, privacy guilt ("I no longer spoke as freely"). The reviewer's spouse: "not useful enough given how much it violates my privacy." Same source.

### Friend (v1 $129, Friend 2 $249)
- **Price and features:** v1 $129, always-on mics, Bluetooth to iPhone, replies only by text. https://www.wired.com/story/i-hate-my-ai-friend/ . Friend 2 is $249, adds a speaker, and runs on OpenAI models. https://www.wired.com/story/my-friend-has-no-soul/
- **Reviews:** snarky and unhelpful, makes people nearby uneasy https://www.wired.com/story/i-hate-my-ai-friend/ ; no to-do lists or transcripts, needs daily charging https://www.theverge.com/column/791010/optimizer-friend-ai-companion-wearables ; Friend 2 interrupts and is hard to silence https://www.wired.com/story/my-friend-has-no-soul/ ; nonexistent customer service https://www.goodhousekeeping.com/electronics/a68156015/friend-review/
- **Other:** Meta announced a "Muse Charm" AI pendant in 2026. https://www.wired.com/story/my-friend-has-no-soul/

## 2. Target-user pain points (evidence is thin; validate in user trials)
- **Students and educators:** professors push back on wearable AI recorders in class https://www.reddit.com/r/Professors/comments/1kkr3fr/wearable_ai_in_the_classroom/ ; students object to being recorded without consent https://www.reddit.com/r/CollegeRant/comments/1njtez5/am_i_overreacting/
- **Professionals:** recording-consent laws vary by state https://www.reddit.com/r/PLAUDAI/comments/1nvkqn9/recording_consent_states/ ; AI note-takers uploading meeting data without consent https://www.reddit.com/r/privacy/comments/1bjpz3q/warning_ai_company_readai_violates_privacy_rights/ ; need for virtual-meeting capture https://www.tomsguide.com/ai/plaud-notepin-review ; domain jargon (Plaud sells an "industry glossary") https://www.tomsguide.com/ai/plaud-notepin-review
- **Travelers and multilingual users:** cellular costs extra and needs a physical SIM (R1) https://www.androidauthority.com/rabbit-r1-subscription-3437340/ ; multilingual transcription is a selling point (Plaud: 112 languages) https://www.plaud.ai/products/plaud-notepin . I found no direct sourced data on offline needs, which is a research gap.
- **Makers:** no specific sourced data found, which is a research gap. Pursue in interviews.
- **Everyone:** battery anxiety https://www.engadget.com/rabbit-r1-review-a-199-ai-toy-that-fails-at-almost-everything-161043050.html ; fear of bricking https://support.humane.com/hc/en-us/articles/34243204841997-Ai-Pin-Consumers-FAQ

## 3. Ranked MVP features people would actually use [Rec]
1. **Push-to-talk voice notes with transcription and summaries.** Recording and transcription is the one category reviewers praise (Plaud). Push-to-talk avoids the always-listening backlash Bee and Friend got. Sources: Tom's Guide (Plaud), Wired (Friend), TechCrunch (Bee).
2. **Searchable memory with source-linked answers.** This was the core value of Limitless. Bee's "fanfiction" summaries show why citing the source matters. Sources: Reuters (Limitless), The Verge (Bee).
3. **Action items, reminders, and daily tasks.** Bee's main pitch; Friend got criticized for lacking it. Sources: TechCrunch (Bee), The Verge (Friend).
4. **Physical mic mute, visible recording LED, consent-friendly modes.** Answers the consent complaints and social friction. Sources: Reddit r/Professors, r/PLAUDAI, r/PlaudNoteUsers; Wired.
5. **Local-first processing with explicit cloud opt-in, plus export/delete.** Hedges against Humane-style bricking and shutdown data deletion. Sources: Humane FAQ, Ars Technica, TechCrunch (Limitless).
6. **Full-day battery with an honest battery gauge.** R1's battery was a top complaint, and Limitless's claimed vs. measured battery life diverged. Sources: Engadget, fast.io.
7. **Camera OCR for documents, whiteboards, and signs.** Do OCR rather than open-ended vision; R1's vision errors hurt credibility. Source: The Verge R1 review.
8. **Multilingual transcription and custom vocabulary.** Valued by Plaud users and by travelers and professionals. Sources: Plaud product page, Tom's Guide.

Deprioritize: app-automation "agents" (R1's LAM failed) https://www.engadget.com/rabbit-r1-review-a-199-ai-toy-that-fails-at-almost-everything-161043050.html ; companion persona chat (Friend) https://www.wired.com/story/i-hate-my-ai-friend/ ; phone replacement (Humane) https://www.slashgear.com/1794149/humane-ai-pin-shutdown-timeline-refund-details/

## 4. Pricing landscape
| Product | Launch price | Subscription | Status |
|---|---|---|---|
| Rabbit R1 | $199 | none from Rabbit; data plan extra | sold |
| Humane AI Pin | $699 (later $499) | $24/mo | shut down 28 Feb 2025 |
| Plaud NotePin / Note | $159 / $159 | free 300 min; $99.99/yr; $239.99/yr | sold |
| Limitless Pendant | $99 | free tier; Pro reported at $19/mo | sales ended (Meta) |
| Bee | $49.99 | $19/mo | acquired (Amazon) |
| Friend / Friend 2 | $129 / $249 | none reported | sold |
URLs are in Section 1.

**Recommended range [Rec]: $149–$249 one-time, with the core features working with no subscription. Any cloud add-on should be optional and cost less than Plaud Pro (about $8.33/mo billed annually).** Rationale: the screen-plus-camera devices sit at $199–$249 (R1, Friend 2). Reviewers penalize stacking hardware cost and a subscription (Android Central on Plaud). Humane's $699 plus $24/mo failed. The final figure should follow from the BOM and cost study the PRD calls for. I did not research CM5 BOM costs here.

## 5. Biggest pitfalls
1. **Overpromising general AI or agents.** Humane, R1, and Bee's "fanfiction" summaries all suffered. Ship narrow features that work reliably.
2. **Always-on or covert recording.** Friend, Bee, and the Reddit consent threads show how this hurts. Default to push-to-talk with a hardware mute.
3. **Cloud dependence, poor battery, and subscription stacking.** Humane was bricked, Limitless stopped selling, R1's battery drew complaints, and Plaud's pricing was called "insane". Go local-first and make sure the device still works if the company stops running servers.

## Gaps
- No MKBHD primary source was fetched; his quote comes via The Verge and Reuters.
- Maker and traveler pain points have weak direct sourcing.
- Bee and Limitless claims were verified on 21 Oct 2026 by opening the source pages (see Corrections).

## Corrections (21 Oct 2026, after opening the source pages)
- **Limitless free tier:** "free tier with 20 h/mo" is the current FAQ. At launch it was 10 h of AI features per month, and the $19/mo Pro was the launch-era price. Both are now cited separately.
- **Limitless battery:** the "6–7 h of recording" figure comes from fast.io citing unnamed "reviewers". It is now labeled secondary and unconfirmed. The official FAQ says "a full day of continuous recording".
- **Bee:** the Verge review confirmed "fanfiction", poor speaker separation, and 3–7 day battery. Added the review's positives (meeting summaries, habit-forming daily digest) that the earlier draft left out.

## 6. Best-in-class bar

### 6.1 What makes people use a device like this daily
- **A fixed daily ritual.** Bee's 8 PM digest made the reviewer check it every night. https://www.theverge.com/reviews/627056/bee-review-ai-wearable . **[Rec]** Offer an opt-in evening recap of notes, tasks, and reminders, using only explicit captures.
- **Reliability beats breadth.** The Humane reviewer could rely on it only to tell the time and had 3–4 failures per success. https://www.theverge.com/24126502/humane-ai-pin-review . One success in five to-dos made Bee's suggestions noise. https://www.theverge.com/reviews/627056/bee-review-ai-wearable
- **Remove friction.** Pixel Recorder transcribes live, works offline, and lets you search a word and jump to the audio, which reviewers call "game-changers". https://www.tomsguide.com/opinion/google-recorder-app-iphone-pixel ; https://www.techradar.com/news/google-recorder-is-a-real-time-transcription-app-that-even-works-when-youre-offline
- **Retention evidence.** Rabbit had sold over 100,000 R1s, but only about 5,000 people were using it at any given time. https://www.theverge.com/2024/9/25/24254253/rabbit-r1-5000-daily-users-ai-gadget ; the Verge correction (verified) says Rabbit's CEO gave about 20,000 daily users, peaking at about 34,000, and 100,000 R1s sold. https://www.theverge.com/2024/10/7/24264275/correction-only-5000-people-are-using-the-rabbit-r1-at-any-given-time-not-in-a-day . Humane returns outpaced sales. https://www.theverge.com/gadgets/615135/humane-ai-pin-shutdown-disaster . Gartner found 29% of smartwatches and 30% of fitness trackers abandoned. https://economictimes.indiatimes.com/tech/hardware/gartner-study-shows-high-abandonment-rates-for-wearables/articleshow/55851266.cms . A study of former tracker users found declining motivation and disrupted routines drive abandonment. https://www.sciencedirect.com/science/article/abs/pii/S0747563219303127
- **Ongoing free updates keep owners engaged** (Teenage Engineering OP-1). https://modulelabsdesign.com/design-review/2017/9/17/j2297awc8p7ablpszbav89mxwmbwq6

### 6.2 Delight details and benchmarks
| Dimension | Evidence | Source |
|---|---|---|
| Voice latency | Human turn gap is about 200–300 ms; Alexa-type assistants average 1,366 ms | https://www.semdial.org/anthology/Z25-Barthel_semdial_3315.pdf |
| | Best response window 200–500 ms after the user stops; fillers help | https://www.isca-archive.org/interspeech_2019/lala19_interspeech.html |
| | Optimal feedback at 750 ms; tolerance limit 1,850 ms | https://doi.org/10.1109/access.2023.3250278 |
| | Experience much worse beyond 4 s | https://dl.acm.org/doi/full/10.1145/3719160.3736636 |
| | Humane: about 10 s waits followed by errors | https://www.theverge.com/24126502/humane-ai-pin-review |
| Battery | Plaud NotePin: 20 h recording, 40 days standby | https://www.plaud.ai/products/plaud-notepin |
| | Bee: 3–7 days | https://www.theverge.com/reviews/627056/bee-review-ai-wearable |
| | R1 drained while idle, can't last a day | https://www.engadget.com/rabbit-r1-review-a-199-ai-toy-that-fails-at-almost-everything-161043050.html |
| | Humane Pin plus booster dead in 5 h untouched | https://www.theverge.com/24126502/humane-ai-pin-review |
| | Kindle Paperwhite: about 48 days real-world test | https://goodereader.com/blog/kindle/how-long-does-a-kindle-battery-last |
| | OP-1: 16 h, "sorted for long-haul flights" | https://djmag.com/content/teenage-kicks |
| Thermals | Humane: hot to the touch, frequent thermal shutdowns, projector limited to 6–9 min | https://www.engadget.com/the-humane-ai-pin-is-the-solution-to-none-of-technologys-problems-120002469.html |
| In-hand feel and materials | OP-1: CNC aluminum, "massively over specified" buttons, precise detented knobs; build quality 10/10 | https://sonicstate.com/news/2011/08/18/sonic-lab-teenage-engineering-op-1-review/ ; https://modulelabsdesign.com/design-review/2017/9/17/j2297awc8p7ablpszbav89mxwmbwq6 ; https://djmag.com/content/teenage-kicks |
| | Humane Pin "small and sturdy and genuinely nice to hold" was not enough on its own | https://www.theverge.com/gadgets/615135/humane-ai-pin-shutdown-disaster |
| | Limitless: aluminum, IP54 | https://help.limitless.ai/en/articles/9124757-pendant-faq |
| Haptics | Apple Watch Taptic Engine called a "huge step forward" for haptics: confirmations you both hear and feel (verified Macworld; this is a 2014 preview piece, not a review). The Guardian link is unverified | https://www.macworld.com/article/224270/taptic-haptics-and-the-body-fantastic-the-real-apple-watch-revolution.html ; https://www.theguardian.com/technology/2015/apr/28/apple-watch-review-smartwatch-iphone-taptic-siri |
| Controls | Complaints: R1 scroll wheel annoying, Bee button fiddly | Engadget R1 review; Verge Bee review |
| | Praise: Plaud's physical record button | https://fast.io/resources/limitless-ai-review-2026/ |
| Sound | OP-1 "tiny but surprisingly loud" speaker | https://sonicstate.com/news/2011/08/18/sonic-lab-teenage-engineering-op-1-review/ |
| | Friend 2 speaker "canned, tinny" | https://www.wired.com/story/my-friend-has-no-soul/ |
| UI polish | OP-1 animated, color-coded UI "a joy to tweak" | https://sonicstate.com/news/2011/08/18/sonic-lab-teenage-engineering-op-1-review/ |
| | Limitless app "cluttered" | https://fast.io/resources/limitless-ai-review-2026/ |
| | Pixel Recorder search highlights the match and jumps to the audio | https://www.techradar.com/news/google-recorder-is-a-real-time-transcription-app-that-even-works-when-youre-offline |

### 6.3 Concrete PocketMate targets [Rec, derived from the table above]
- **Press-to-feedback:** under 100 ms for an LED, haptic, or on-screen listening cue. This is my engineering choice, set well below the 750 ms optimum.
- **End of speech to first response:** 750 ms or less for local intents (note saved, reminder set); never more than 1.85 s without a progress cue or filler; hard ceiling of 4 s for cloud answers, with a visible "thinking" state.
- **Battery:** a full 16 h waking day of mixed use. Standby of at least 24 h through MCU-managed suspend or power-off, because CM5 lacks a phone-like deep sleep. Audio-capture mode should aim toward Plaud's 20 h.
- **Thermals:** no thermal throttle or shutdown in normal use, and a skin-safe surface. Target is my engineering choice: keep the CM5 under 65 °C sustained, which uConsole users reach with pads plus heatsinking.
- **Search:** a keyword hit should jump to the source note, audio timestamp, or photo, in the Pixel Recorder style.
- **Controls:** a firm, detented action button and a physical mic-mute slider with a light that cannot be disabled (the Limitless policy).

### 6.4 Maker pain points (gap filled)
- CM5 handhelds: battery life down about a third vs. CM4; about 4 h with LTE when undervolted; 1–1.5 h of video calls. https://www.reddit.com/r/ClockworkPi/comments/1kh0fmr/battery_life_with_a_cm5/
- Heat: spikes to 80 °C fixed by reseating pads and adding rear heatsinks (about 58 °C under cpuburn); hot in a backpack. https://forum.clockworkpi.com/t/effective-cm5-cooling-solution/18180 . A CM5 crashed at 82 °C under an SDR load. https://forum.clockworkpi.com/t/uconsole-with-cm4-cm5-with-and-without-waveshare-board/18642
- No true sleep: users rely on pseudo-sleep scripts, one reporting about 1%/h drain; the uConsole also lacks a mic. https://www.reddit.com/r/ClockworkPi/comments/1kakeud/uconsole_as_pda_cm5/ . "CM5 cannot really deep sleep like phones." https://news.ycombinator.com/item?id=45208681

### 6.5 Traveler pain points (gap filled)
- Travelers download offline language packs and test with data off. Offline translation works for menus and signs but is weaker on slang, long sentences, and noisy voice input. https://www.reddit.com/r/travel/comments/1oksnmt/using_offline_google_translate_and_how_is_it/ ; https://www.reddit.com/r/travel/comments/vdx722/translator_app_that_doesnt_need_internet/
- People want offline translation of text they point the camera at (Japan). https://www.reddit.com/r/JapanTravelTips/comments/1p6hbz3/good_offline_app_or_dictionary_for_translating/
- Many keep airplane mode on or use Wi-Fi only to avoid roaming charges. https://www.reddit.com/r/onebag/comments/13co4wj/anyone_else_travel_internationally_with_only/
- Dedicated pocket translators are debated on whether they're worth it vs. a phone. https://www.reddit.com/r/JapanTravelTips/comments/1al0m3o/pocket_translation_is_worth_it/
- **[Rec]** Offline camera OCR plus an on-device translation pack is a traveler differentiator, but PocketMate must beat the phone on speed to use.
- Thread contents above are from search summaries of these Reddit pages; spot-check before quoting.

## Verification status (21 Oct 2026)
- **Rabbit daily users:** verified. CEO figures of about 20,000 daily (34,000 peak), 5,000 concurrent, 100,000 sold. https://www.theverge.com/2024/10/7/24264275/correction-only-5000-people-are-using-the-rabbit-r1-at-any-given-time-not-in-a-day
- **Apple Watch haptics:** partly verified. The Macworld piece is pre-launch commentary, not a hands-on review. https://www.macworld.com/article/224270/taptic-haptics-and-the-body-fantastic-the-real-apple-watch-revolution.html
- **Reddit traveler threads:** NOT verified. Reddit blocked the fetch ("blocked by network security"). Treat §6.5 thread contents as unconfirmed.

## 7. India market (target: under ₹30,000, about $350)

### 7.1 Availability and INR prices
| Product | India price | Channel / notes | Source |
|---|---|---|---|
| Plaud NotePin S | ₹19,990 at launch (Aug 2026); ₹15,278 on Amazon.in now; ₹14,990 on the Plaud India shop | official; Amazon, Blinkit, in.plaud.ai | https://www.gadgets360.com/ai/news/plaud-note-pro-notepin-s-ai-note-takers-launch-india-price-specifications-11955108 ; https://www.amazon.in/Plaud-Notetaker-Transcribe-Summarize-Languages/dp/B0G4M8MTJN ; https://in.plaud.ai/pages/shop-plaud |
| Plaud Note Pro | ₹20,990 at launch | four mics, display | https://www.91mobiles.com/hub/plaud-note-pro-notepin-s-ai-recording-devices-india-launch-price/ |
| Plaud NotePin / Note | ₹13,990–15,990 / ₹15,990 | 300 free min/mo; 1-year warranty, 7-day returns | https://in.plaud.ai/products/plaud-notepin ; https://in.plaud.ai/pages/shop-plaud |
| Rabbit R1 | ₹36,683 on Amazon.in (third party) | Rabbit does not ship to India, and Rabbit's warranty does not apply to this channel (search summary) | https://www.rabbit.tech/support/article/which-countries-does-rabbit-r1-ship-to ; https://www.amazon.in/Rabbit-Voice-Activated-Assistant-Transcription-Summarization/dp/B0DYK831XY |
| NeoSapien Neo 1 (Indian, Bengaluru) | ₹15,999 (Business Standard); "around ₹10,000" (Inc42, earlier) | no screen or speaker; phone and cloud dependent; boAt co-founder Sameer Mehta is an investor | https://www.business-standard.com/technology/tech-reviews/neosapien-neo-1-ai-pendant-review-price-features-india-126030200848_1.html ; https://inc42.com/startups/ai-wearables-neosapien-make-the-most-of-this-wave/ |
| Noise / boAt AI recorders | No dedicated AI recorder product found in my searches (gap, not proof of absence) | | |
| Humane, Limitless, Bee, Friend | Not found sold officially in India; Limitless is discontinued everywhere | §1 |

### 7.2 Hindi, English and Hinglish speech recognition
- **Code-switched WER, lower is better.** Source: the Trelis model card, a vendor-run comparison. https://huggingface.co/Trelis/whisper-hinglish-preview
  - CoSHE-500 conversational Hinglish: Sarvam Saaras-v3 11.47; ElevenLabs Scribe-v2 12.43; Trelis Hinglish fine-tune 13.67; Whisper-large-v3 29.74.
  - cs-FLEURS: Scribe 7.57; Trelis 10.19; Sarvam 16.47; Whisper-large-v3 33.92.
  - Hindi FLEURS: Sarvam 10.07; Whisper-large-v3 27.50.
- **Takeaway:** stock Whisper roughly doubles Hinglish errors compared with fine-tuned models.
- **AI4Bharat:** IndicWhisper had the best WER on 39 of 59 Vistaar benchmarks across 12 languages, with open weights. https://www.isca-archive.org/interspeech_2023/bhogale23_interspeech.html
- **Clinical audit:** some models are competitive on Indian English but fail on code-mixed or vernacular speech, with gaps by speaker role and gender. https://arxiv.org/pdf/2512.10967
- **[Rec]** Use a fine-tuned Indic/Hinglish model, either an IndicWhisper or Hinglish Whisper fine-tune on-device, or opt-in Sarvam in the cloud. Benchmark it on CM5 before committing; I have no CM5 latency data for these models.

### 7.3 Indic OCR
- **Sarvam Indic OCR Bench** (6,909 samples, 22 languages, vendor-run), word accuracy:
  - Hindi: Sarvam Vision 93.52; Gemini 92.11; Google Cloud Vision 84.29.
  - Overall: Sarvam 87.39 vs. Google Cloud Vision 71.76. AWS Textract scored under 20 on every listed language.
  - Source: https://www.sarvam.ai/blogs/sarvam-vision-2-1
- **Tesseract vs. PaddleOCR on printed Gujarati:** Tesseract 18.2% CER vs. PaddleOCR 4.5% CER. https://ijrpr.com/uploads/V6ISSUE10/IJRPR53627.pdf
- **Open scene-text toolkit:** IndicPhotoOCR (Bhashini/IITJ) covers 11 Indian languages plus English. https://github.com/Bhashini-IITJ/IndicPhotoOCR
- **[Rec]** On-device, try PaddleOCR or IndicPhotoOCR rather than Tesseract, with opt-in cloud for hard scripts.

### 7.4 Buyer expectations and pain points (India)
- Mint asks whether "this pocket AI can beat your phone" and frames value against what a phone can do. https://www.livemint.com/mint-lounge/business-of-life/plaud-note-notepin-detailed-user-review-11764388748099.html . Paid Plaud plans in India start at about ₹825/mo or ₹9,900/yr (search summary of Mint and plaud.in; verify).
- Neo 1 review: setup on Android is "slightly tricky" because permissions vary by brand; the device is cloud and phone dependent. https://www.business-standard.com/technology/tech-reviews/neosapien-neo-1-ai-pendant-review-price-features-india-126030200848_1.html
- Plaud India warranty is replacement-only for 12 months (search summary) https://in.plaud.ai/pages/warranty-policy ; a NotePin became unusable after a firmware update with no fix for 40+ days. https://www.reddit.com/r/PLAUDAI/comments/1sutx3q/plaud_notepin_became_unusable_after_firmware/
- **Gap:** I found no relevant r/india, r/IndianGaming or r/developersIndia threads, and Reddit blocks direct fetches. Indian-buyer sentiment needs primary interviews.

### 7.5 Import duty, BIS and pricing implications
- **BIS CRS:** lithium cells and batteries for portable use (IS 16046 Part 2) must be registered. Cells and batteries are registered independently, and host devices on the CRS list (laptops/tablets, mobile phones, power banks, and others) need their own registration. https://www.crsbis.in/BIS/products-bis.do ; https://www.crsbis.in/BIS/app_srv/tdc/gl/docs/Modified_FAQs.pdf . Foreign makers need an Authorised Indian Representative, and products carry an R-number. https://pcnindiaglobal.com/2026/06/10/bis-crs-registration-lithium-ion-batteries-india-is-16046/
- **Duty example (smartphones, HSN 8517 13 00):** 20% basic customs duty plus 10% social welfare surcharge plus 18% IGST, about 49% of CIF value (aggregator source; verify with CBIC). https://eximpe.com/hsncode-finder/85171300 . PocketMate's HSN classification is not yet determined; get a customs broker's ruling.
- **Implication [Rec]:** importing finished units could add around 40–50% on landed cost if duty is similar to phones. Assembling in India with registered cells avoids duty on the finished device (components still attract duty). Budget for BIS testing time. If classified as a laptop/tablet-type data-processing device, the device itself may need CRS registration, so confirm early.

### 7.6 How ₹30,000 compares
- **Recorders:** Plaud ₹13,990–20,990; Neo 1 ₹15,999; grey-import R1 ₹36,683 (sources above).
- **Phones:** under ₹30,000 you can buy, for example, the Motorola Edge 70 (₹29,999), iQOO Neo 10R (₹26,999), or Realme P4 Pro (₹24,999). https://www.digit.in/mobiles/best-phones-under-30000.html ; https://www.gadgets360.com/mobiles/guide/best-mobiles-in-india-under-30000-2026-11291130
- **[Rec] Reweighted India price: ₹17,999–24,999 launch MRP**, leaving room for festival discounts, with ₹30,000 as a hard ceiling only for a premium SKU. Reasons:
  - At ₹30,000 it costs as much as a capable phone and roughly double a Plaud.
  - It must justify itself with what a phone lacks: physical controls, offline Hinglish capture and search, Indic OCR, no subscription.
  - This replaces the earlier $149–249 global range for India.

### 7.7 Reweighted MVP ranking for India [Rec]
1. Push-to-talk capture with offline **Hinglish/Hindi/English** transcription (§7.2).
2. Searchable, source-linked memory.
3. Reminders and action items, with Hinglish phrasing.
4. **Camera OCR plus translation for Devanagari and other Indic scripts** (moved up from #7; §7.3; also serves travelers).
5. Physical mute and recording light (consent).
6. No mandatory subscription; local-first (Plaud's India paid tiers are an opening).
7. Full-day battery and thermals for Indian heat. Limitless rated 0–45 °C as a reference point. https://help.limitless.ai/en/articles/9124757-pendant-faq
8. A simple Android companion that avoids brand-specific permission pain (Neo 1 review), plus a domestic warranty and service network.
