anand2532/PocketMate/mechanical/release_v5/drawings/pocketmate_drawings_release_v5.pdf

40

## UNIBODY 6061-T6 - plan section Z=10.0 (cell/CM5 level) and Z=14.0 (LTE shelf level)

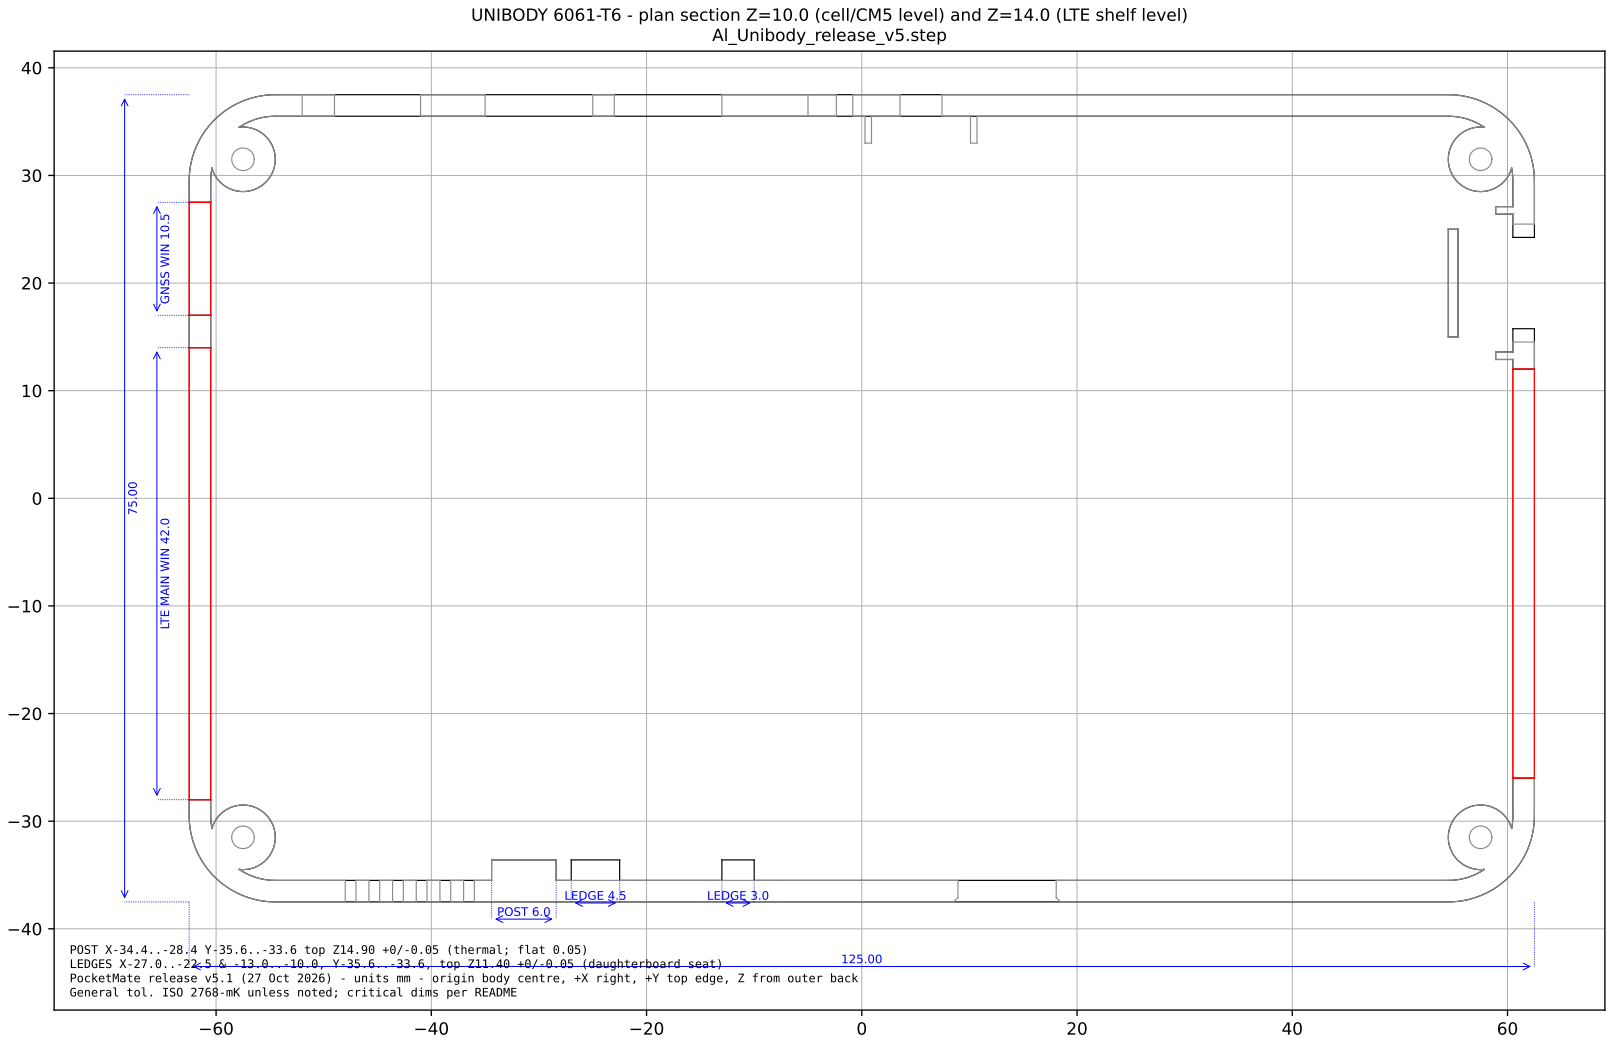
[picture p1: page 1]
POST 6.0; LEDGE 4.5; LEDGE 3.0; LEDGES X-27.0..-22.5; top Z11.40 +0/-0.05 (daughterboard seat); PocketMate release v5.1 (27 Oct 2026) - units mm -; origin body centre, +X right,; +Y top edge, Z from outer back; Al_Unibody_release_v5.step

LTE MAIN WIN 42.0 GNSS WIN 10.5

POST X-34.4..-28.4 Y-35.6..-33.6 top Z14.90 +0/-0.05 (thermal; flat 0.05)
General tol. ISO 2768-mK unless noted; critical dims per README

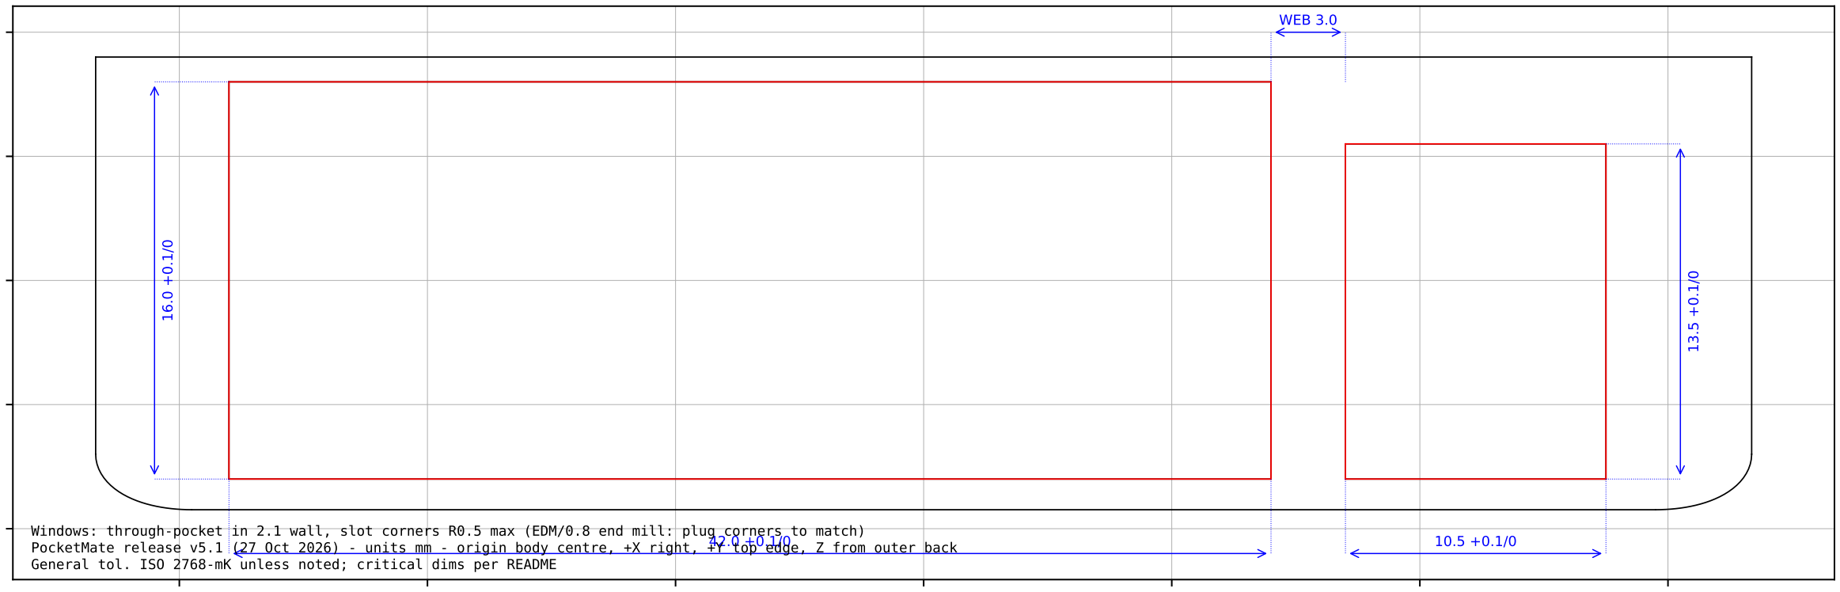
[picture p2: figure]
WEB 3.0

−30 | −20 | −10 | 0 | 10 | 20 | 30

0

5

10

15

20

Windows: through-pocket | in 2.1 wall, slot corners R0.5 max (EDM/0.8 end mill: | plug corners to match)
PocketMate release | v5.1 | (27 Oct 2026) - units mm - origin body centre, +X right, +Y top edge, Z from outer | back
General tol. ISO 2768-mK unless noted; critical | dims per README

## LEFT END WALL - section X=-61.5 (looking +X) - LTE main + GNSS windows Al_Unibody + RF windows

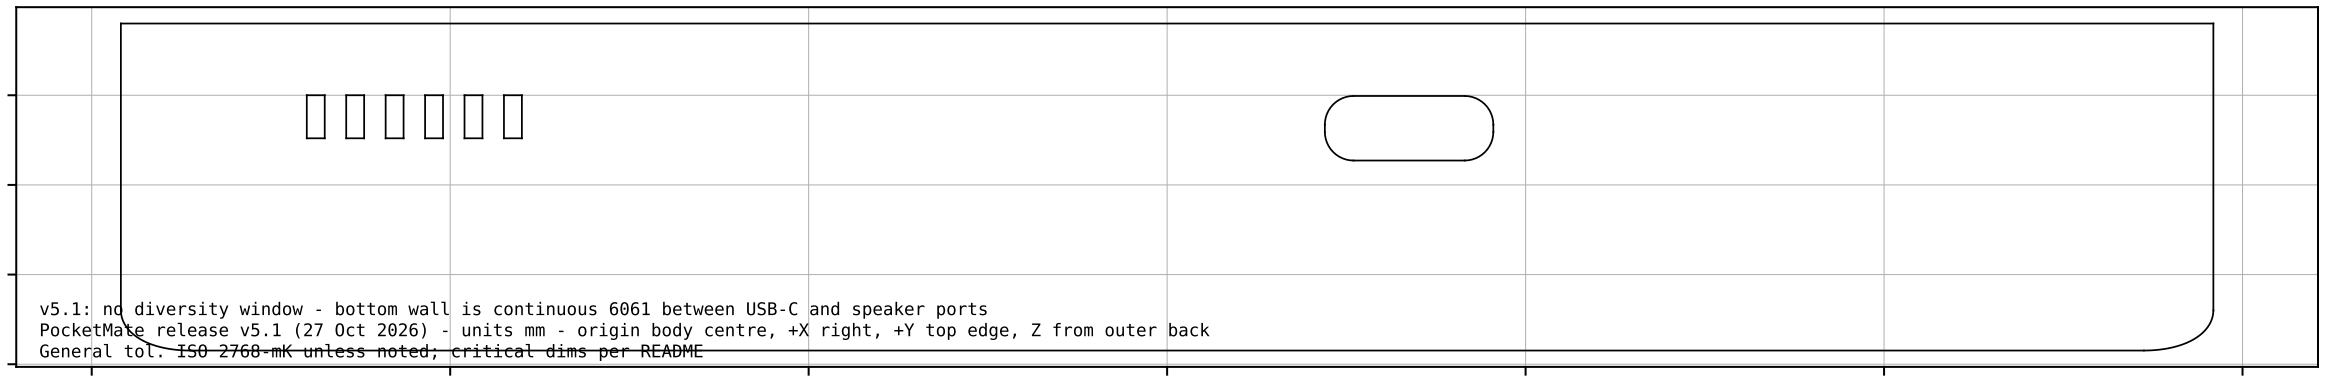
[picture p3: figure]

−60 | −40 | −20 | 0 | 20 | 40 | 60

0

5

10

15

v5.1: | no diversity window - bottom wall | is continuous 6061 between USB-C | and speaker ports
PocketMate release v5.1 (27 Oct 2026) - | units mm - origin body centre, +X | right, +Y top edge, Z from outer | back
General tol. ISO 2768-mK unless noted; | critical dims per README

## BOTTOM WALL - section Y=-36.5 - plain Al (v5.1: diversity window deleted) Al_Unibody + RF windows

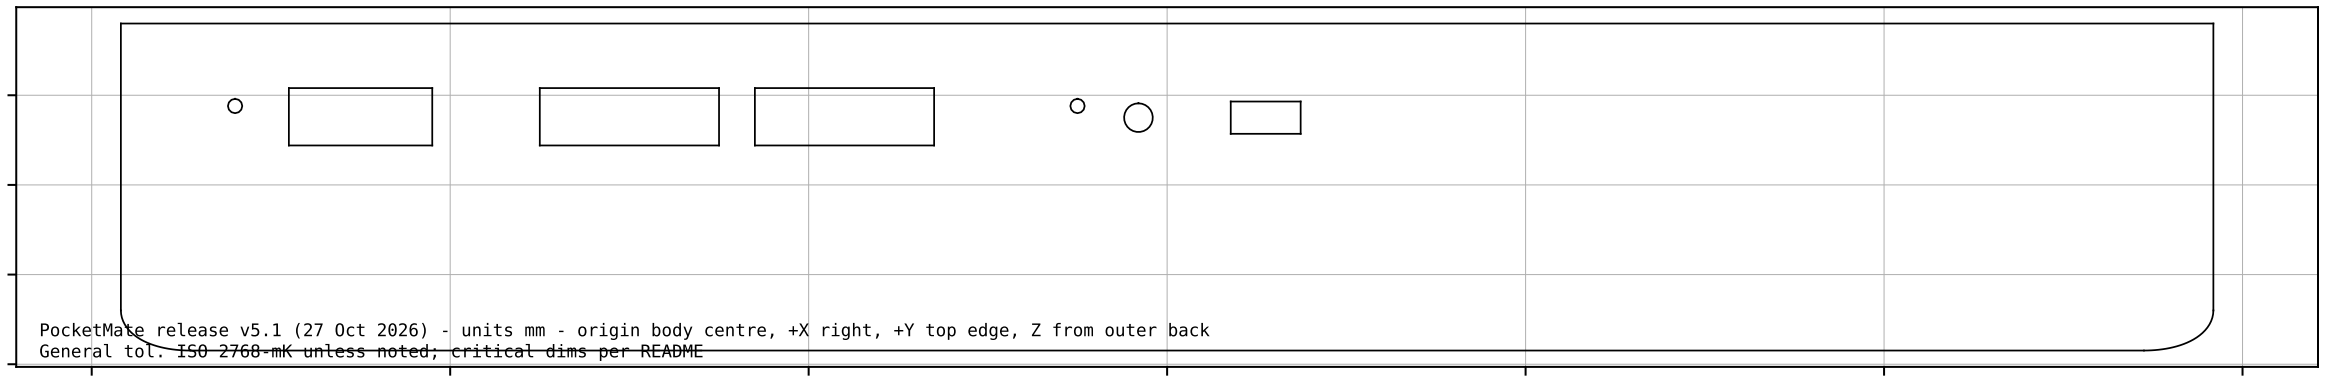
[picture p4: figure]

−60 | −40 | −20 | 0 | 20 | 40 | 60

0

5

10

15

PocketMate release v5.1 (27 Oct 2026) - | units mm - origin body centre, +X | right, +Y top edge, Z from outer | back
General tol. ISO 2768-mK unless noted; | critical dims per README

## TOP WALL - section Y=36.5 (unchanged from v4_22e) Al_Unibody + RF windows

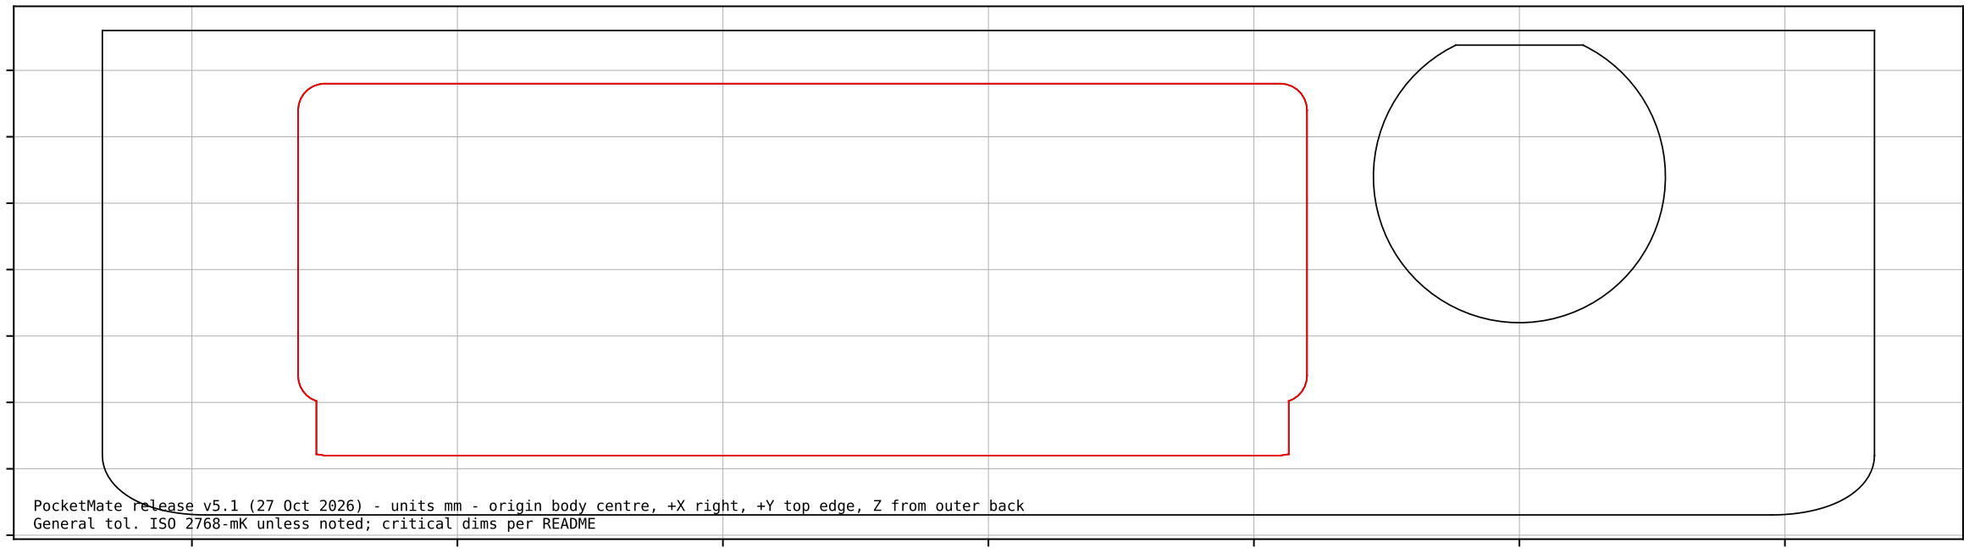
[picture p5: figure]

−30 | −20 | −10 | 0 | 10 | 20 | 30

0.0

2.5

5.0

7.5

10.0

12.5

15.0

17.5

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

## RIGHT END WALL - section X=61.5 - Wi-Fi window (unchanged) Al_Unibody + RF windows

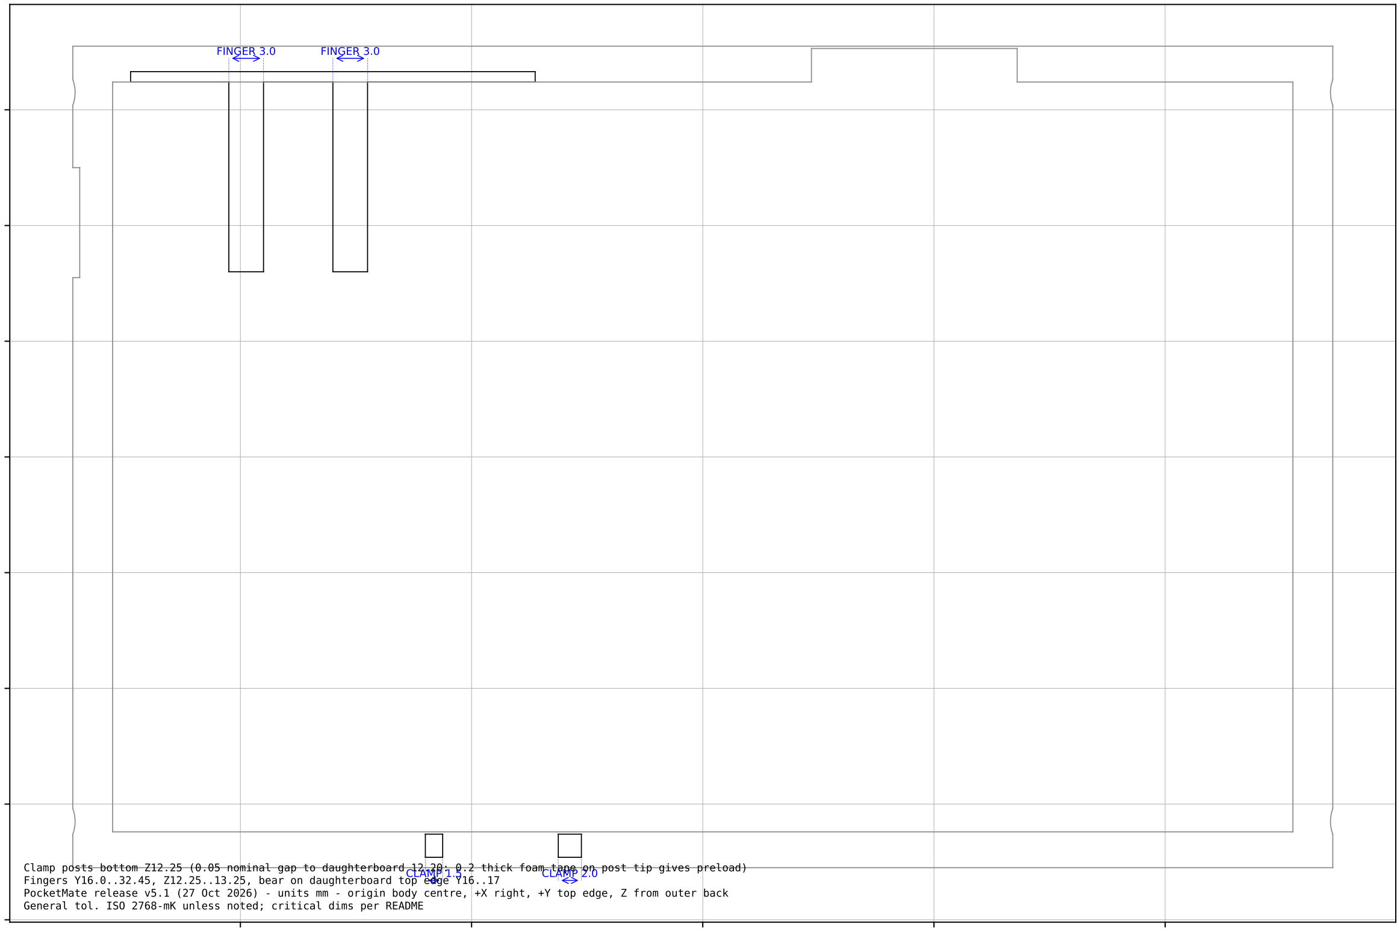
[picture p6: figure]
CLAMP; FINGER 3.0

−40 | −20 | 0 | 20 | 40

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
Clamp posts bottom Z12.25 (0.05 nominal gap to daughterboard 12.20: 0.2 thick foam tape on post tip gives preload) Fingers Y16.0..32.45, Z12.25..13.25, bear on daughterboard top edge Y16..17
PocketMate release v5.1 (27 Oct 2026) - units mm - origin body centre, | +X right, +Y top edge, Z from outer | back
General tol. ISO 2768-mK unless noted; critical dims per README

## BEZEL / DISPLAY FRAME (PC) - plan sections Z=13.0 (clamps, fingers) and Z=16.4 (lips)

## Bezel_DisplayFrame_PC_release_v5.step

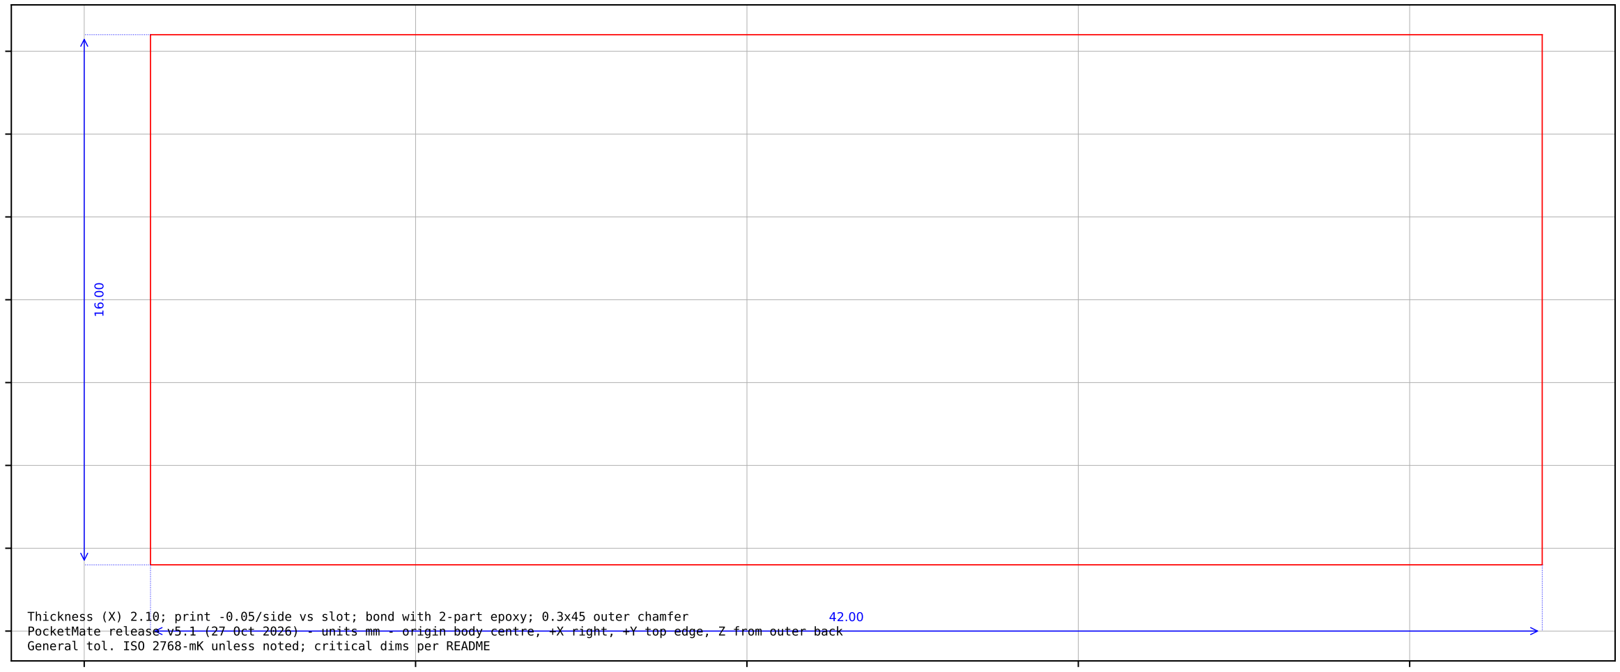
[picture p7: figure]

−30 | −20 | −10 | 0 | 10

0.0

2.5

5.0

7.5

10.0

12.5

15.0

17.5

Thickness (X) 2.10; print -0.05/side vs slot; bond with 2-part epoxy; 0.3x45 outer chamfer
PocketMate release v5.1 (27 Oct 2026) - units mm - origin body centre, +X right, +Y top edge, Z from outer back
General | tol. ISO 2768-mK unless noted; critical dims | per README

## RF WINDOW RFWindow_LTE_Main_L_PC - SLA clear/tough resin (NO metal-filled resin)

## stl/RFWindow_LTE_Main_L_PC_release_v5.stl

16 | 18 | 20 | 22 | 24 | 26 | 28

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
| | | 10.50
Thickness (X) PocketMate release v5.1 (27 Oct General tol. ISO 2768-mK unless | 2.10; print -0.05/side vs slot; bond with 2-part epoxy; 0.3x45 outer chamfer | 2026) - units mm - origin body centre, +X right, +Y top edge, Z from outer back noted; critical dims per README

13.50

## RF WINDOW RFWindow_GNSS_TL_PC - SLA clear/tough resin (NO metal-filled resin)

## stl/RFWindow_GNSS_TL_PC_release_v5.stl

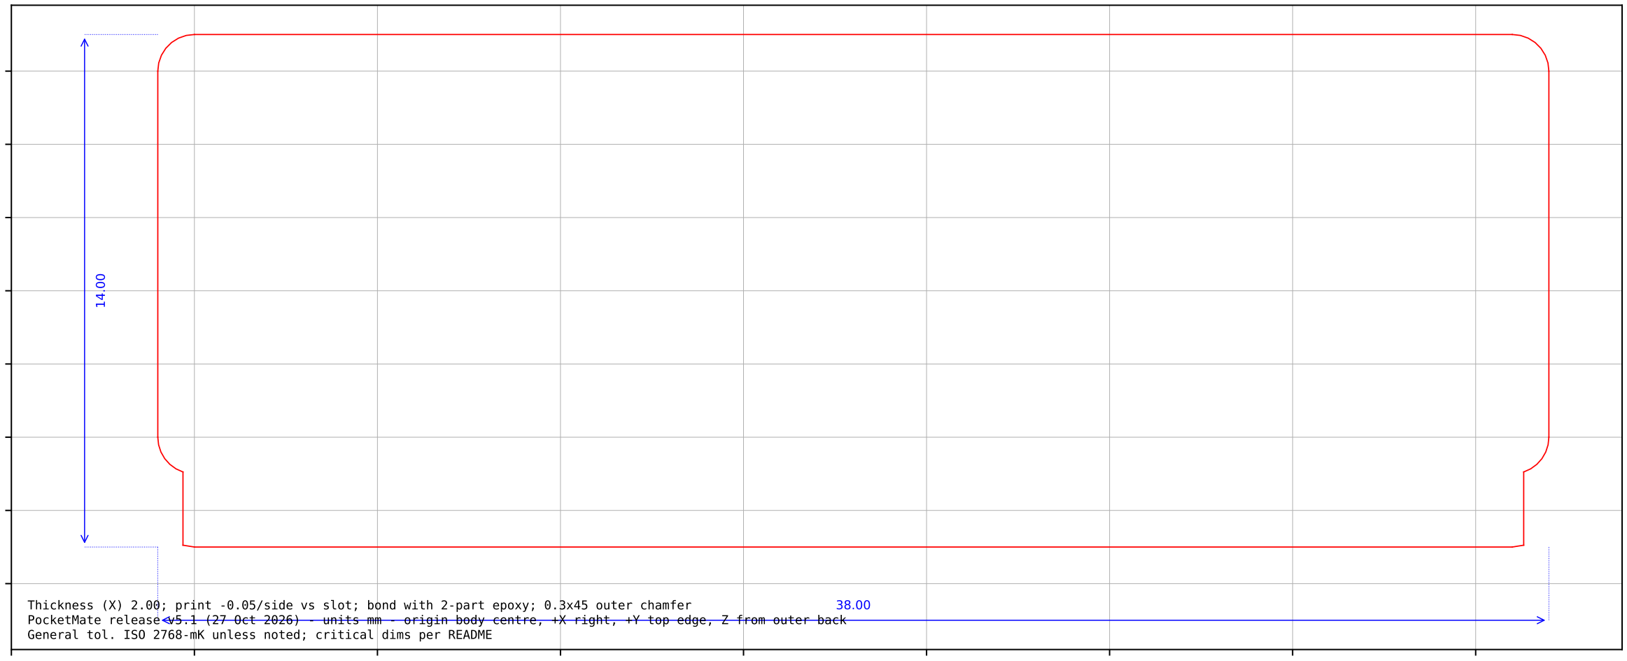
[picture p8: figure]

−30 | −25 | −20 | −15 | −10 | −5 | 0 | 5 | 10

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
Thickness (X) 2.00; print -0.05/side vs slot; bond with 2-part epoxy; 0.3x45 outer chamfer
PocketMate release v5.1 (27 Oct 2026) - units mm - origin body centre, +X right, +Y top edge, Z from outer back General tol. ISO 2768-mK unless noted; critical dims per README

## RF WINDOW RFWindow_PC - SLA clear/tough resin (NO metal-filled resin)

## stl/RFWindow_PC_release_v5.stl

−50 | −40 | −30 | −20 | −10

−30

−20

−10

0

10

46.40

48.40

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

## FLAT PATTERN Foam_Prod_0p5 PE/PU closed-cell foam 0.5 (production cell) - die/laser cut

−50 | −40 | −30 | −20 | −10

−30

−20

−10

0

10

46.40

48.40

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

## FLAT PATTERN Foam_Proto_2p0 PE/PU closed-cell foam 2.0 (Akyga proto cell)

−50 | −40 | −30 | −20 | −10

−30

−20

−10

0

10

20

30

50.50

61.60

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

## FLAT PATTERN Liner_PET_Prod PET/polyimide 0.1 insulating liner, adhesive one side, onto cell top

−50 | −40 | −30 | −20 | −10

−30

−20

−10

0

10

20

30

50.50

65.10

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

## FLAT PATTERN Liner_PET_Proto PET/polyimide 0.1 liner, Akyga cell; relief around leads

−55 | −50 | −45 | −40 | −35 | −30 | −25 | −20

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
| | | 29.40
PocketMate release General tol. ISO 2768-mK unless noted; | v5.1 (27 Oct 2026) | - units mm - origin critical dims per README | body centre, +X right, +Y top edge, Z | from outer back

33.00

## FLAT PATTERN ThermalPad_Shield_0p5 Gap pad 0.5, >=3 W/mK, 29.4 x 33.0

−36 | −34 | −32 | −30 | −28

−38

−37

−36

−35

−34

6.00

1.90

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

## FLAT PATTERN ThermalPad_Post_0p3 Gap pad 0.3, >=3 W/mK, 6.0 x 1.9

−55 | −50 | −45 | −40 | −35 | −30 | −25 | −20

−40

−30

−20

−10

0

10

30.20

46.80

Developed length tab+joggle+plate approx 46.0 (bend allowance 0.7 offset joggle); cut flat then form
PocketMate release v5.1 (27 Oct 2026) - units mm - origin body centre, | +X right, +Y top edge, Z from outer back
General tol. ISO 2768-mK unless noted; critical dims per | README

## FLAT PATTERN HeatSpreader_Cu_0p5

C1100 Cu 0.5, Ni plate; joggle 0.7 down at Y-22.7/-24.5; Kapton 0.05 on top face (display side)

−50 | −40 | −30 | −20 | −10

−30

−20

−10

0

10

47.0

40.40

NOTCH 8.6

U1 EC25/EC200U ROTATED 90 deg, centre (-35.8,-5.5); J1 FH12-22 rot 90 | mouth +X at X-5.0, contacts centred Y-6.5 (aligns with carrier J14)
v5.1: 47 mm wide (X-52..-5) per Layout; keep | speaker notch X<-34.4/Y<-23.4 and J7 notch X>-9.4/Y>15.5; NSIM-2-C at X-17.75..-5.35 Y-31.6..-17.6
Ears X-27..-22.5 and -13..-10 to Y-35.0 sit | on Al ledges; bezel clamp | posts above. No screws (no room over the cell).
PocketMate release | v5.1 (27 Oct 2026) - units mm - origin body centre, | +X right, +Y top edge, Z | from outer back
General tol. ISO 2768-mK unless noted; critical dims per README

## LTE DAUGHTERBOARD OUTLINE (Edge.Cuts proposal for hardware/kicad-lte) - 0.8 mm 4L mech coords; KiCad Y = -mech Y

−25 | −20 | −15 | −10 | −5 | 0 | 5 | 10 | 15

0

5

10

15

20

loop width 19.88 (c/l)

loop height 13.8 (c/l, R6.9)

Stock 66 mm Abracon cable: 73.6 mm centre line from solder tail to J2 (assumed, see README O15/O16); bends R6.9 (rule >=6.8) Post B: PA12/tough-resin printed, bonded to floor; prongs flank the left arc (0.10 gap/side) and let the loop Saddle A: floor clip on the bottom run, base Z1.5..2.7, prongs 0.5 thick, 0.10 gap to PocketMate release v5.1 (27 Oct 2026) - units mm - origin body centre, +X right, +Y top edge, Z from outer back General tol. | ISO 2768-mK unless noted; critical dims per README
cable. Clips NON-METAL; | grow 1.5 mm in width (+3 mm cable) only cable + clips enter the LTE keep-out

O15 STOCK-CABLE SLACK LOOP - elevation, section plane X=-55.59 (view from +X), Coax_Main centre line + clips + zone

## Coax_Main / Clip_Slack_Saddle_A / Clip_Slack_Post_B / Vol_Coax_SlackZone

−62.5 −60.0 −57.5 −55.0 −52.5 −50.0 −47.5

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
keep-out edge/cell X-60.2..-54.0

Window: view | limited by section | of | Z=3.5; cell face X=-54.0, keep-out X-60.2..-55.0, FPC X-60.4..-60.2; floor top Z1.5
PocketMate release v5.1 (27 Oct | 2026) - | units mm | - origin | body | centre, +X right, +Y top edge, Z from outer back
General tol. | ISO 2768-mK unless | noted; critical dims per | README

## O15 STOCK-CABLE SLACK LOOP - plan section Z=3.5 (bottom run, clips, cell face) Coax_Main / clips / Vol_Battery / Al_Unibody / FPC volume
