anand2532/PocketMate/design/overview.png

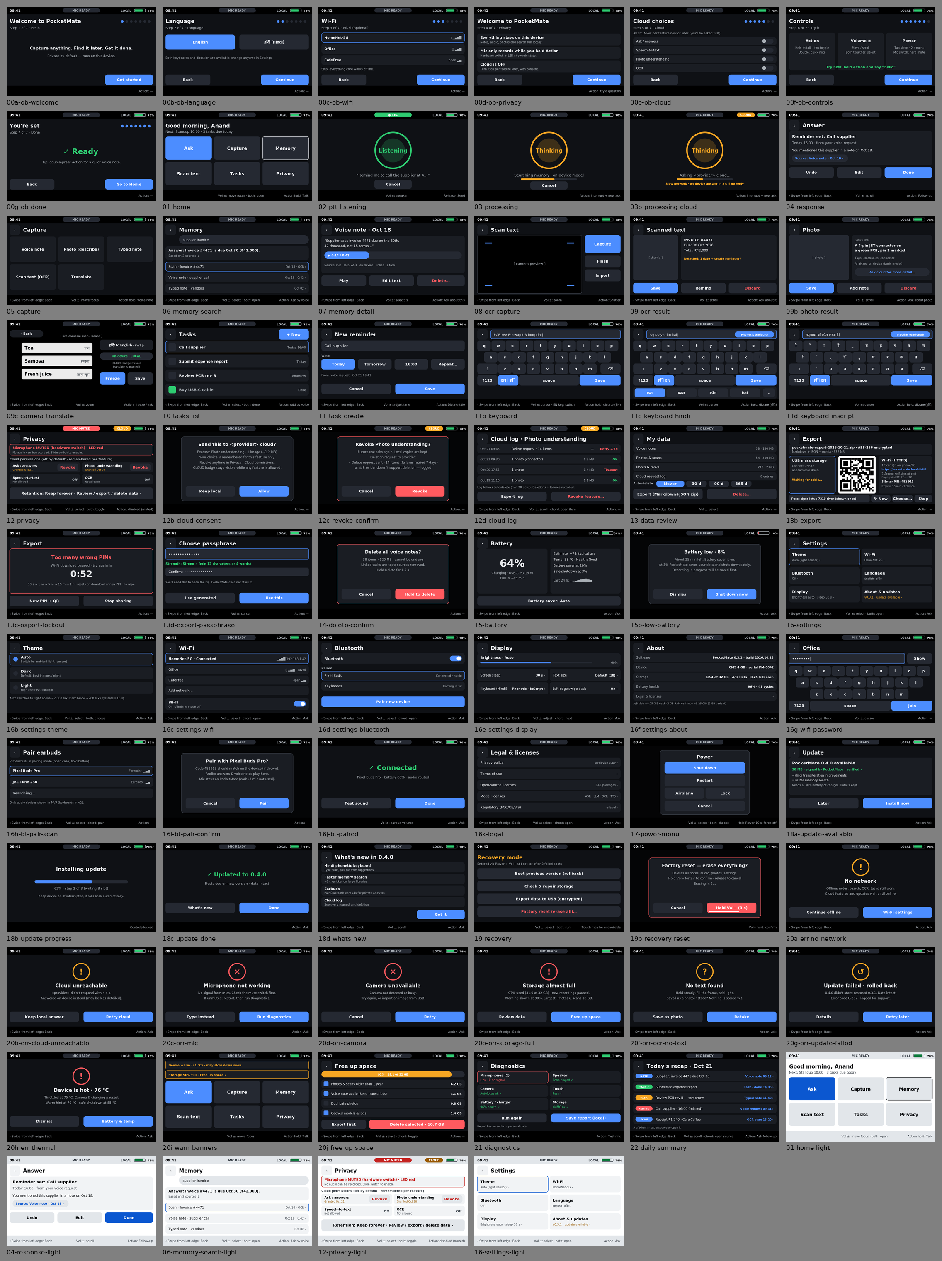
design/overview.png
