anand2532/PocketMate/design/png/00a-ob-welcome.png

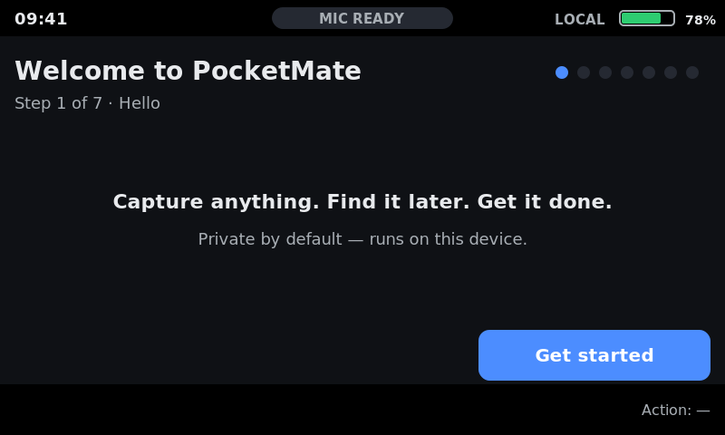
design/png/00a-ob-welcome.png
