anand2532/PocketMate/design/png/00b-ob-language.png

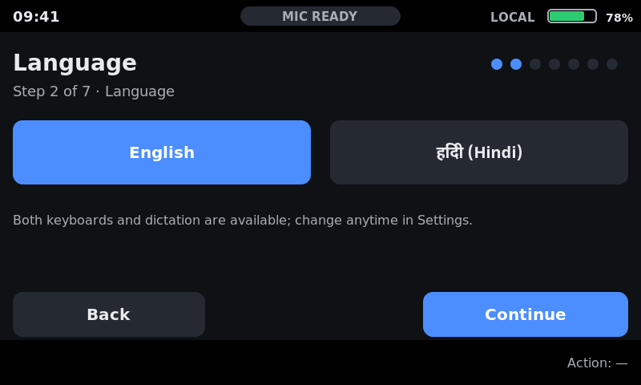
design/png/00b-ob-language.png
