anand2532/PocketMate/design/png/00c-ob-wifi.png

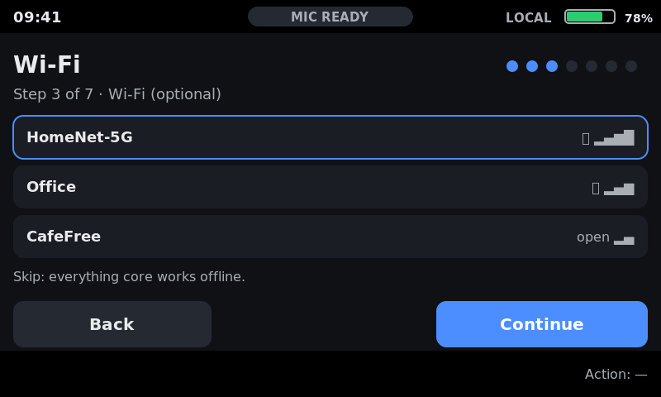
design/png/00c-ob-wifi.png
