anand2532/PocketMate/design/png/00d-ob-privacy.png

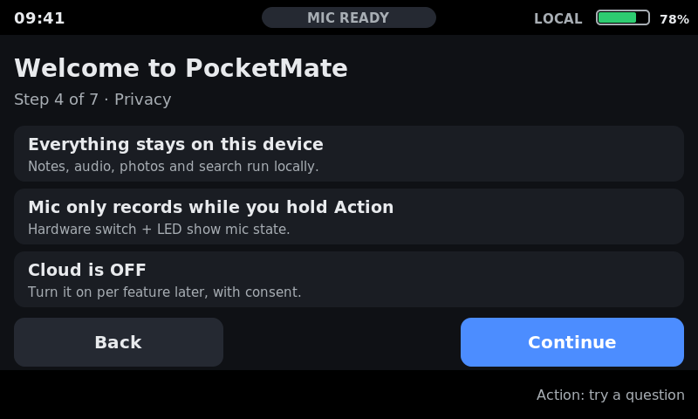
design/png/00d-ob-privacy.png
