anand2532/PocketMate/design/png/00e-ob-cloud.png

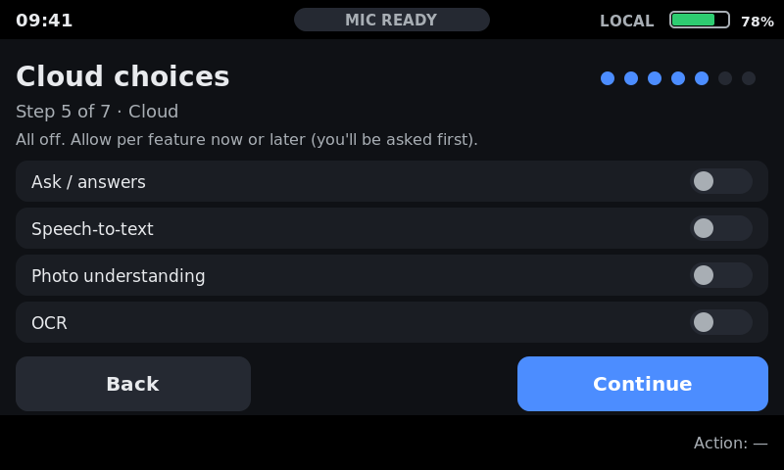
design/png/00e-ob-cloud.png
