anand2532/PocketMate/design/png/00f-ob-controls.png

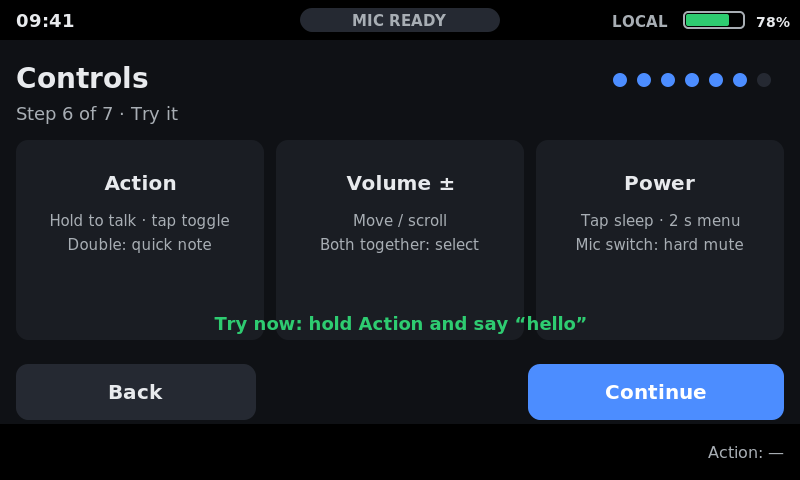
design/png/00f-ob-controls.png
