anand2532/PocketMate/design/png/00g-ob-done.png

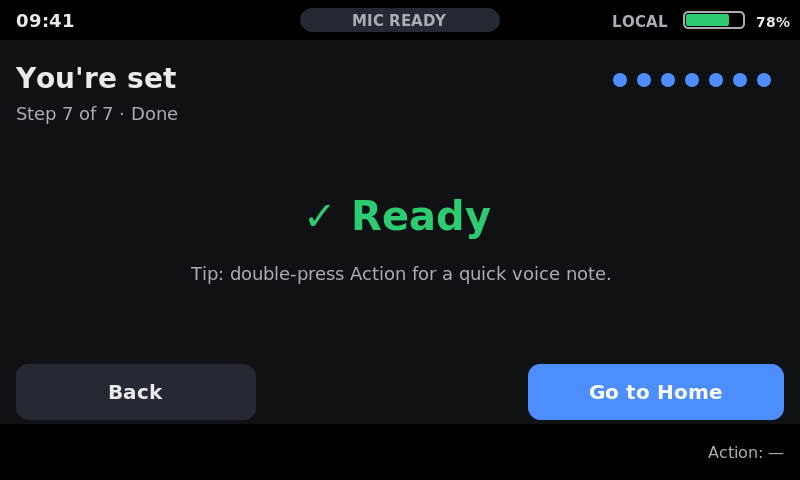
design/png/00g-ob-done.png
