anand2532/PocketMate/design/png/01-home-light.png

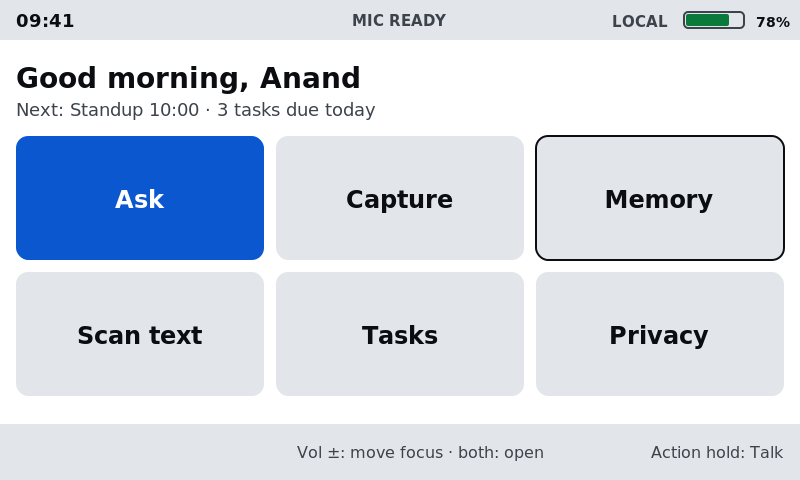
design/png/01-home-light.png
