anand2532/PocketMate/design/png/01-home.png

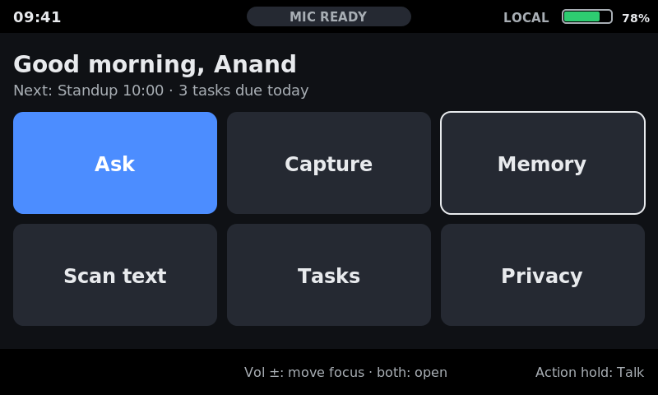
design/png/01-home.png
