anand2532/PocketMate/design/png/02-ptt-listening.png

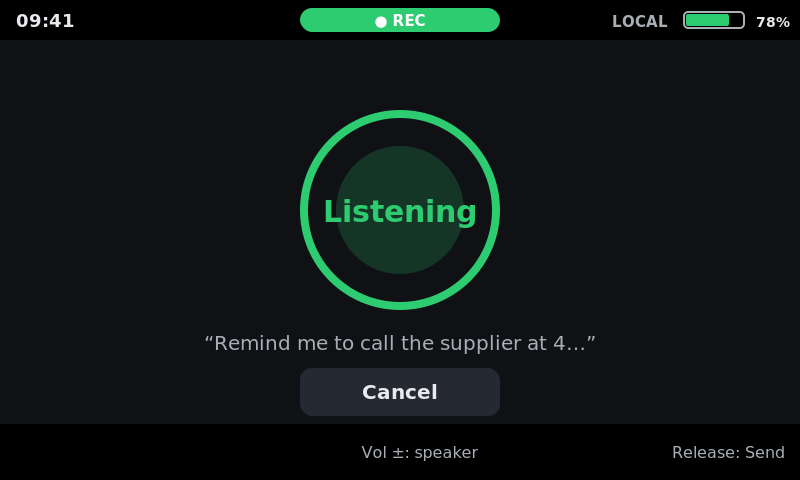
design/png/02-ptt-listening.png
