anand2532/PocketMate/design/png/03-processing.png

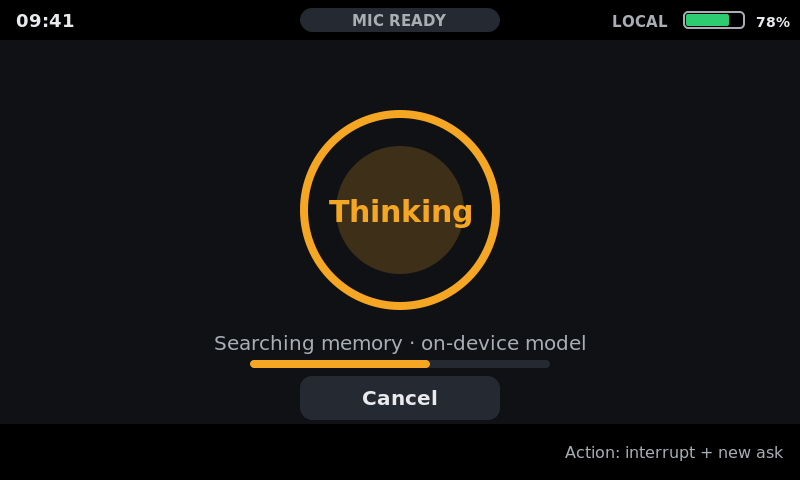
design/png/03-processing.png
