anand2532/PocketMate/design/png/04-response-light.png

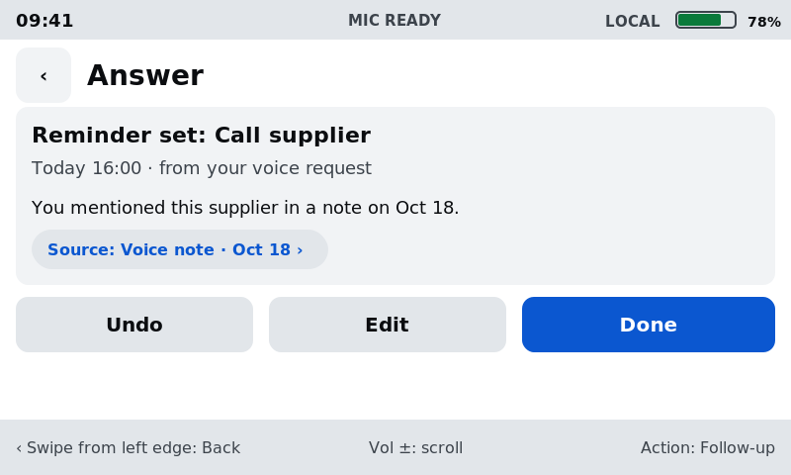
design/png/04-response-light.png
