anand2532/PocketMate/design/png/04-response.png

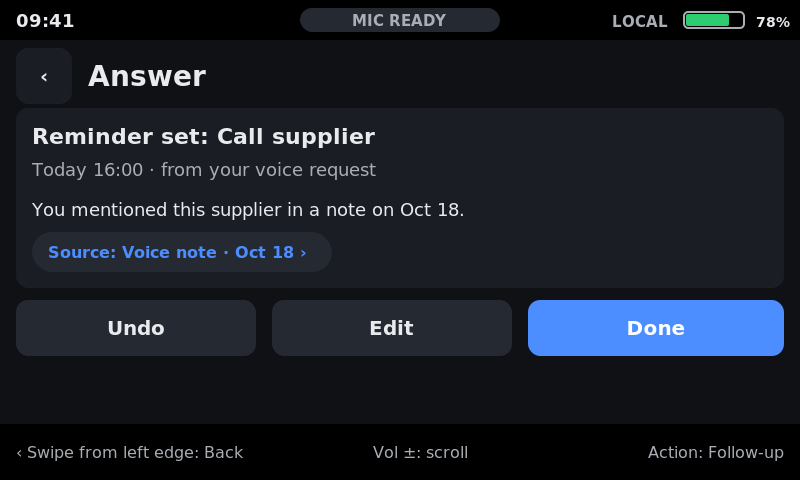
design/png/04-response.png
