anand2532/PocketMate/design/png/05-capture.png

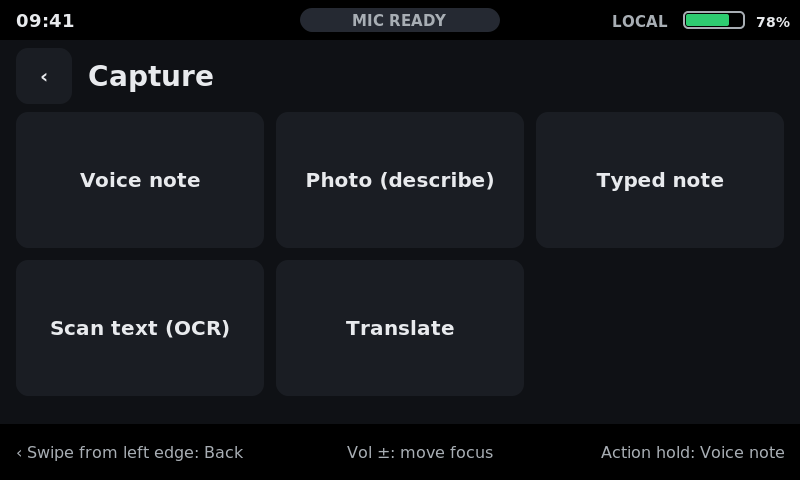
design/png/05-capture.png
