anand2532/PocketMate/design/png/06-memory-search-light.png

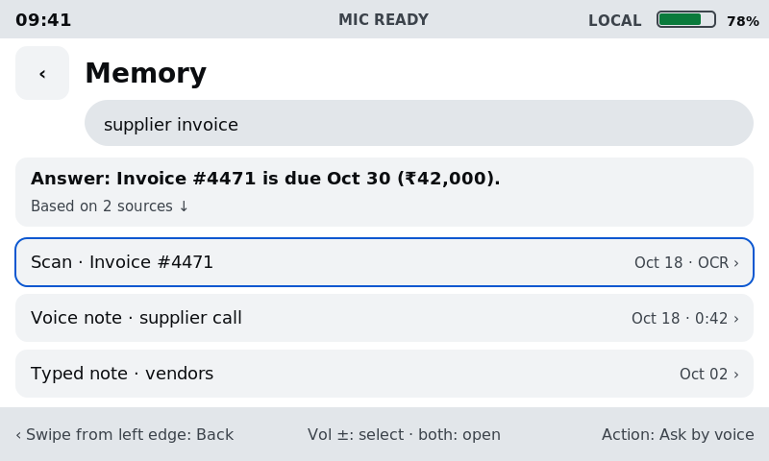
design/png/06-memory-search-light.png
