anand2532/PocketMate/design/png/06-memory-search.png

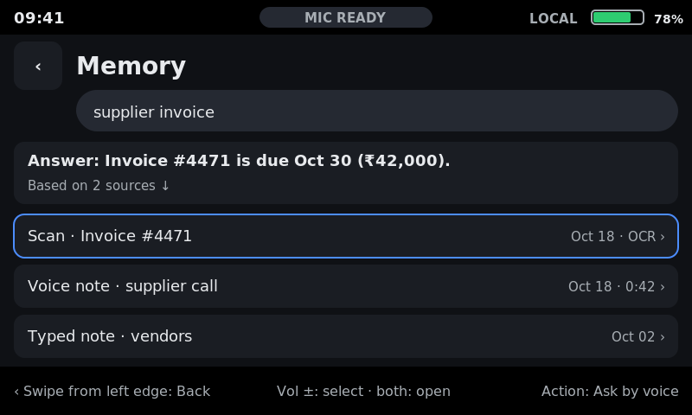
design/png/06-memory-search.png
