anand2532/PocketMate/design/png/07-memory-detail.png

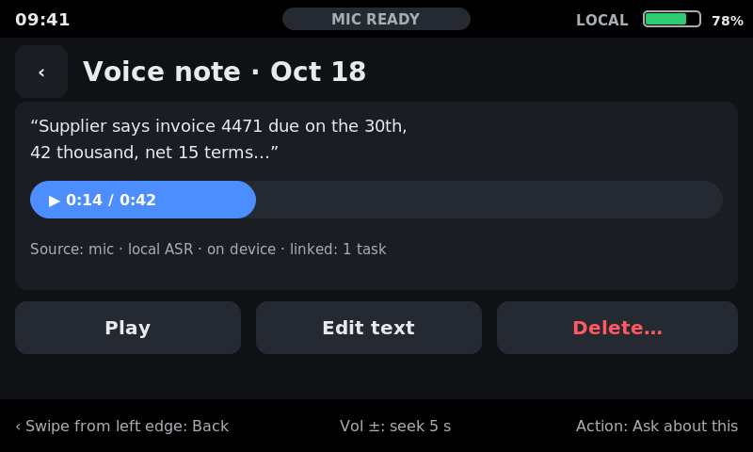
design/png/07-memory-detail.png
