anand2532/PocketMate/design/png/08-ocr-capture.png

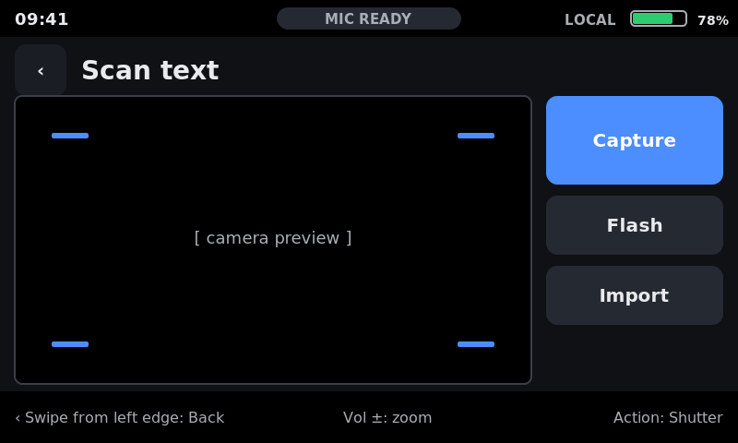
design/png/08-ocr-capture.png
