anand2532/PocketMate/design/png/09c-camera-translate.png

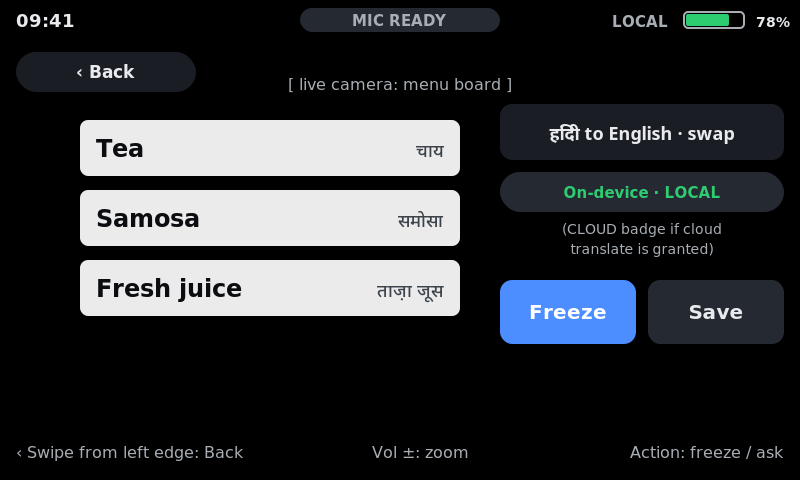
design/png/09c-camera-translate.png
