anand2532/PocketMate/design/png/10-tasks-list.png

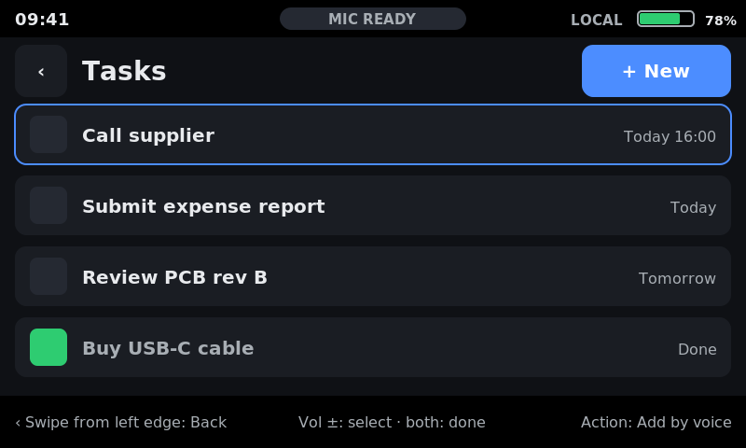
design/png/10-tasks-list.png
