anand2532/PocketMate/design/png/11-task-create.png

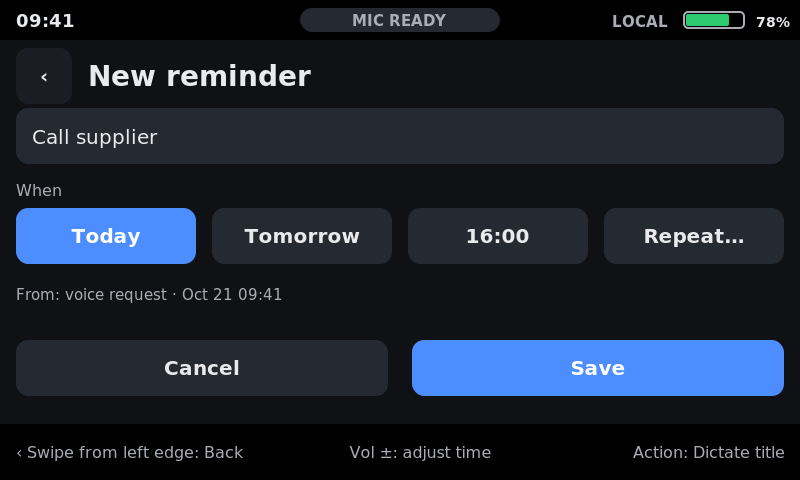
design/png/11-task-create.png
