anand2532/PocketMate/design/png/11b-keyboard.png

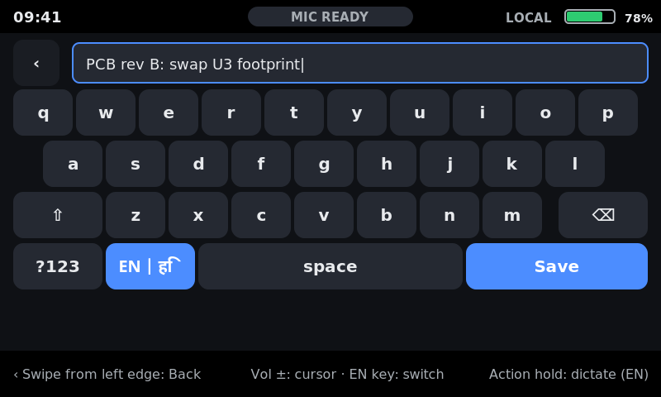
design/png/11b-keyboard.png
