anand2532/PocketMate/design/png/11c-keyboard-hindi.png

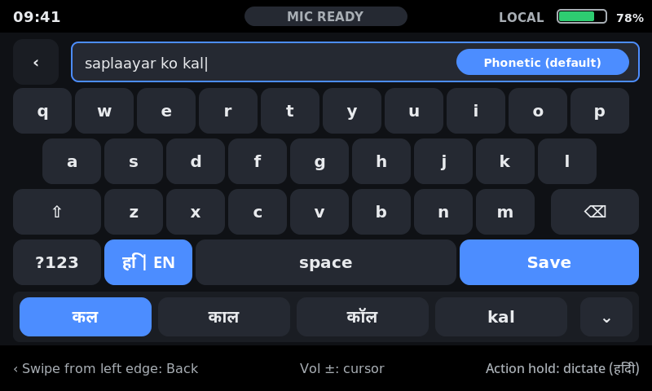
design/png/11c-keyboard-hindi.png
