anand2532/PocketMate/design/png/11d-keyboard-inscript.png

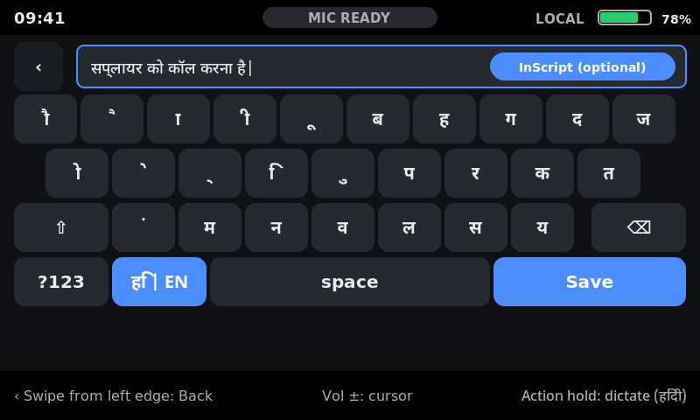
design/png/11d-keyboard-inscript.png
