anand2532/PocketMate/design/png/12-privacy-light.png

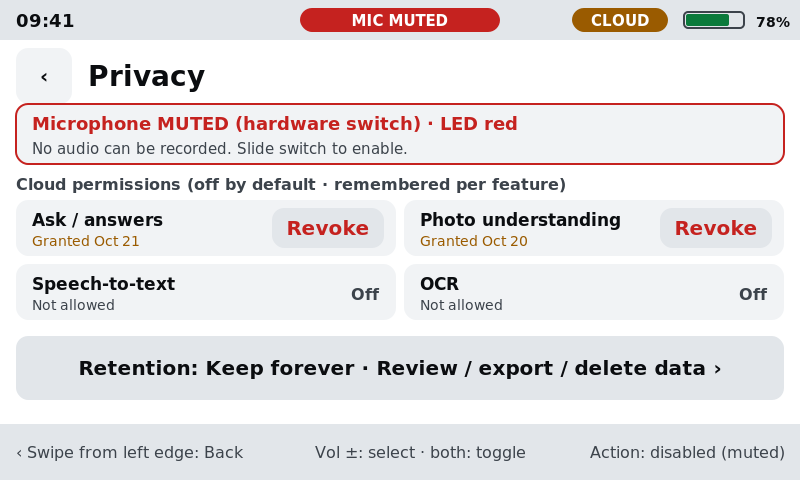
design/png/12-privacy-light.png
