anand2532/PocketMate/design/png/12-privacy.png

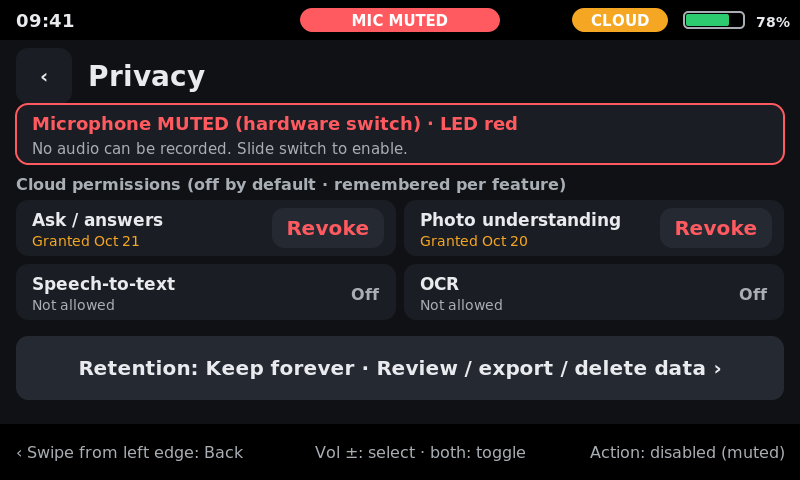
design/png/12-privacy.png
