anand2532/PocketMate/design/png/12b-cloud-consent.png

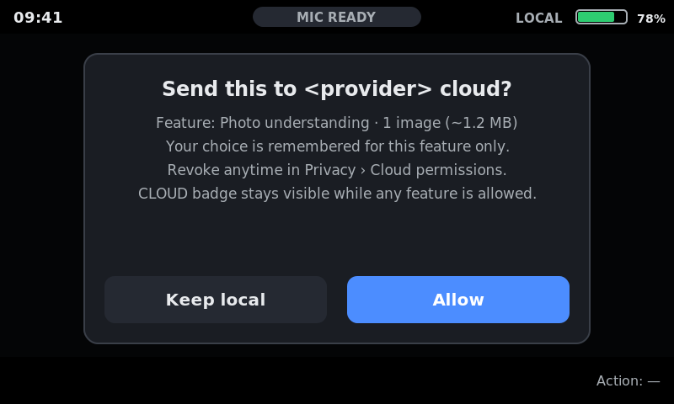
design/png/12b-cloud-consent.png
