anand2532/PocketMate/design/png/12c-revoke-confirm.png

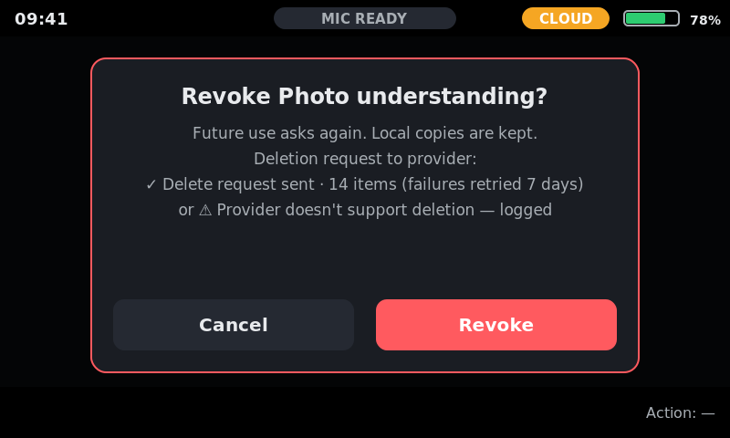
design/png/12c-revoke-confirm.png
