anand2532/PocketMate/design/png/12d-cloud-log.png

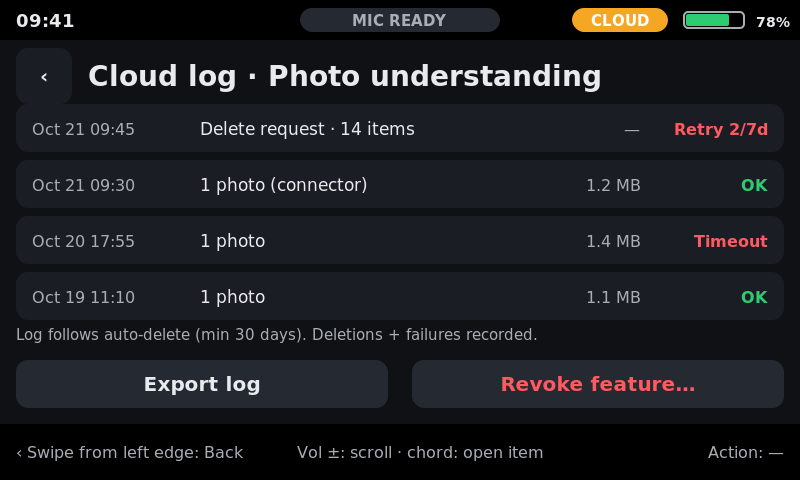
design/png/12d-cloud-log.png
