anand2532/PocketMate/design/png/13-data-review.png

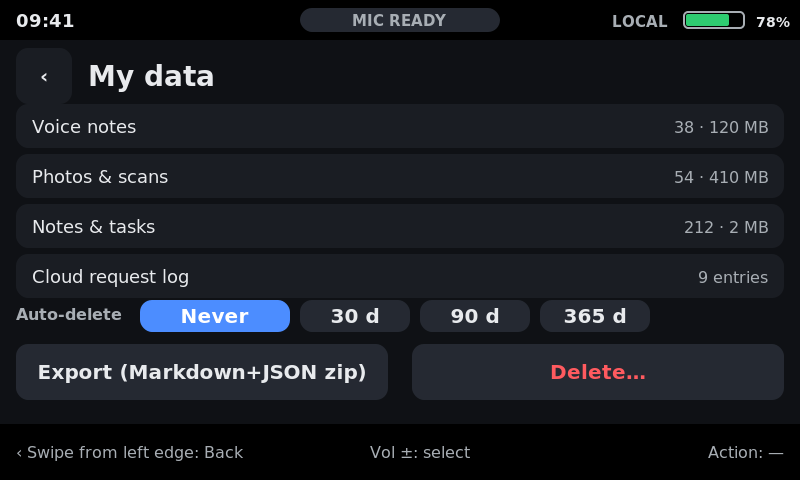
design/png/13-data-review.png
