anand2532/PocketMate/design/png/13b-export.png

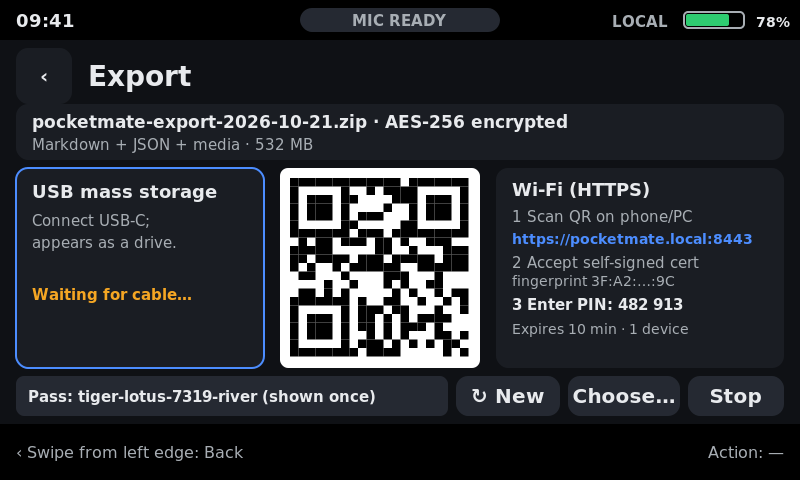
design/png/13b-export.png
