anand2532/PocketMate/design/png/13c-export-lockout.png

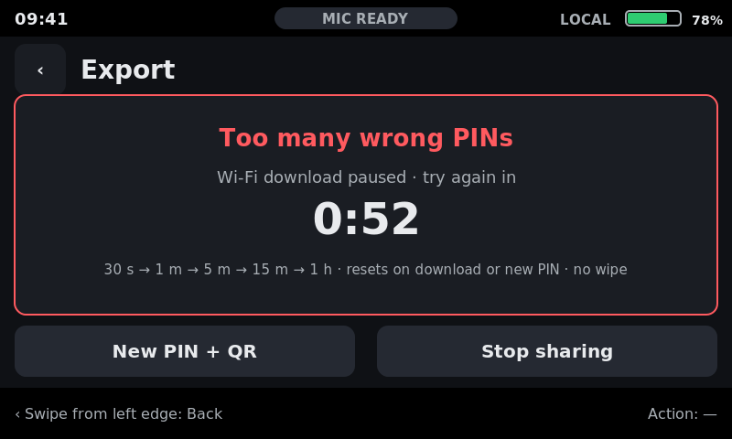
design/png/13c-export-lockout.png
