anand2532/PocketMate/design/png/13d-export-passphrase.png

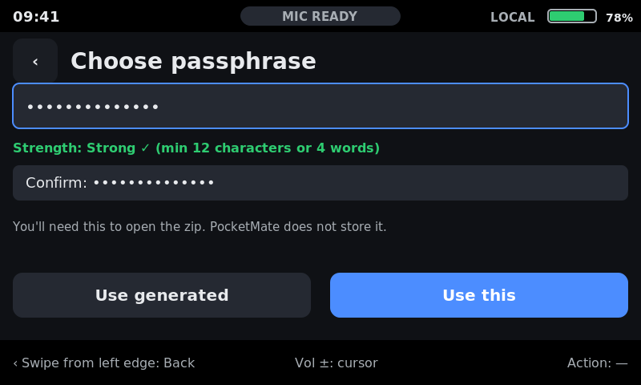
design/png/13d-export-passphrase.png
