anand2532/PocketMate/design/png/14-delete-confirm.png

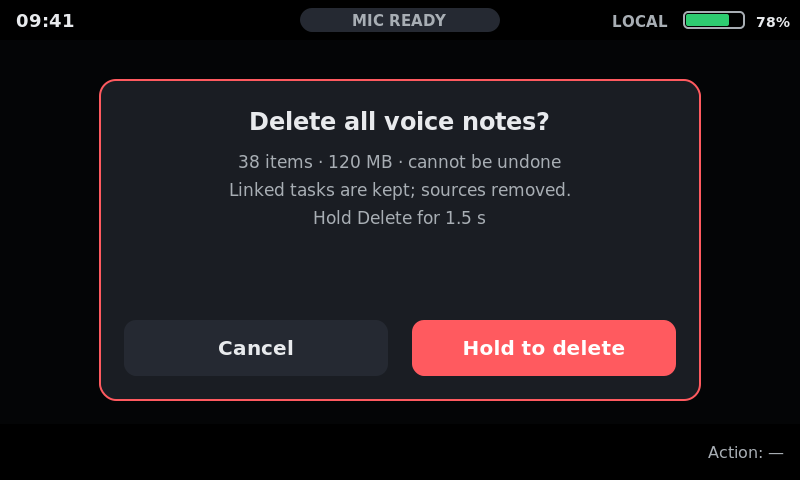
design/png/14-delete-confirm.png
