anand2532/PocketMate/design/png/15-battery.png

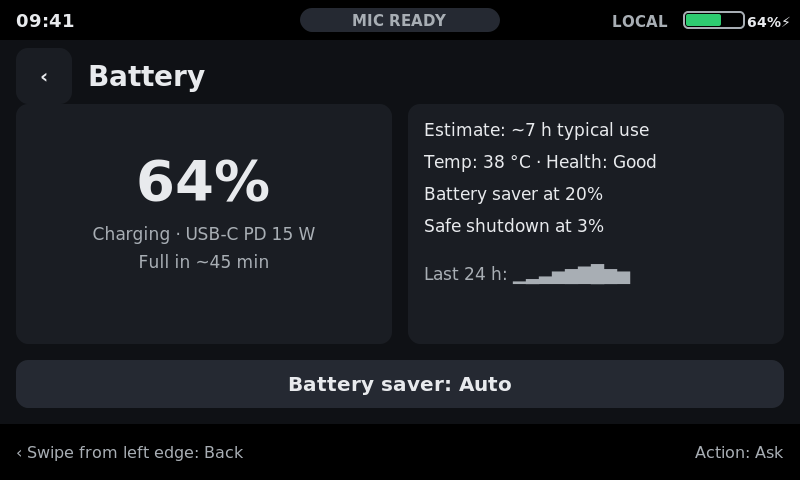
design/png/15-battery.png
