anand2532/PocketMate/design/png/16-settings-light.png

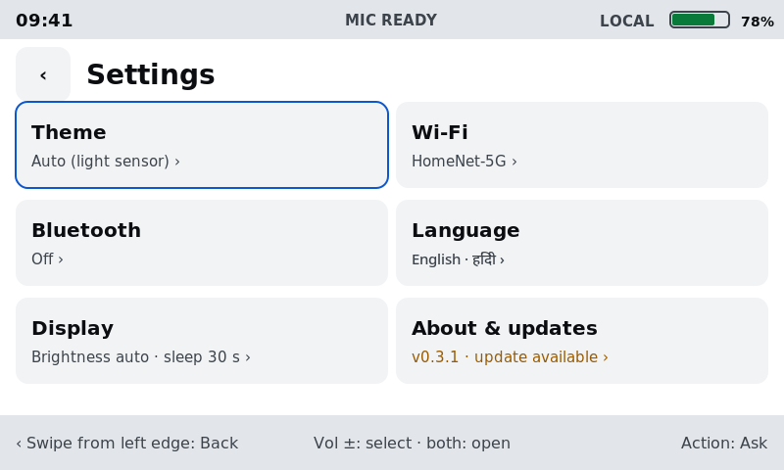
design/png/16-settings-light.png
