anand2532/PocketMate/design/png/16-settings.png

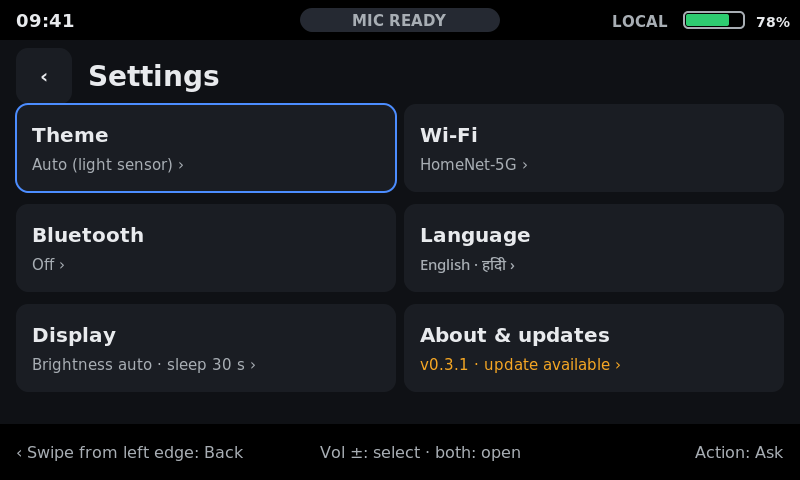
design/png/16-settings.png
