anand2532/PocketMate/design/png/16b-settings-theme.png

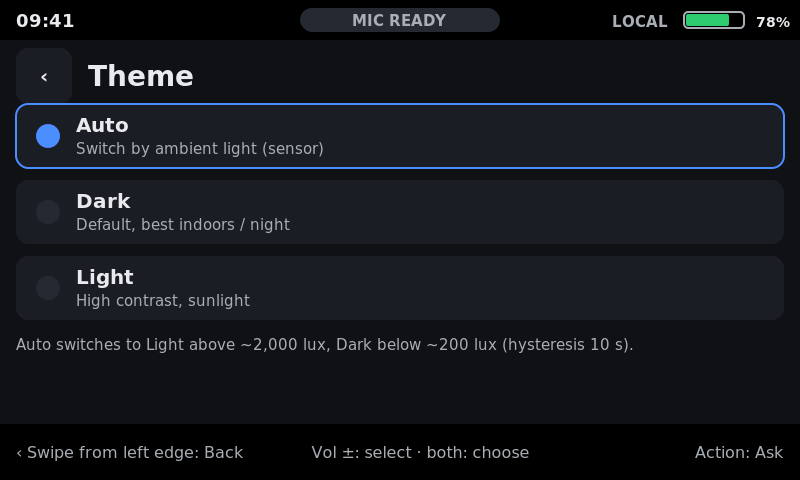
design/png/16b-settings-theme.png
