anand2532/PocketMate/design/png/16c-settings-wifi.png

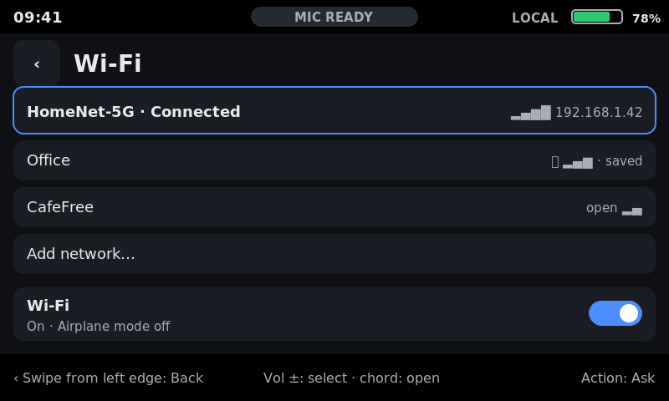
design/png/16c-settings-wifi.png
