anand2532/PocketMate/design/png/16d-settings-bluetooth.png

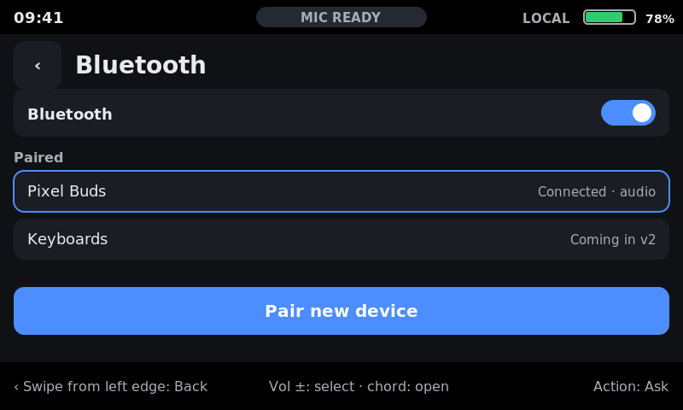
design/png/16d-settings-bluetooth.png
