anand2532/PocketMate/design/png/16e-settings-display.png

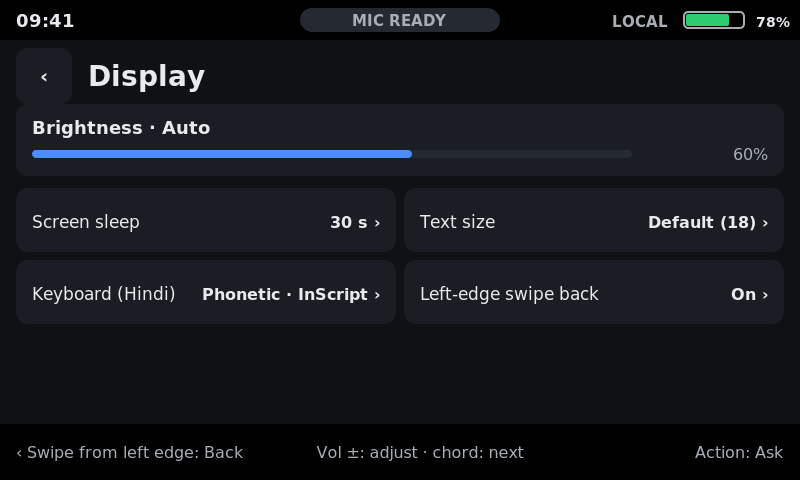
design/png/16e-settings-display.png
