anand2532/PocketMate/design/png/16f-settings-about.png

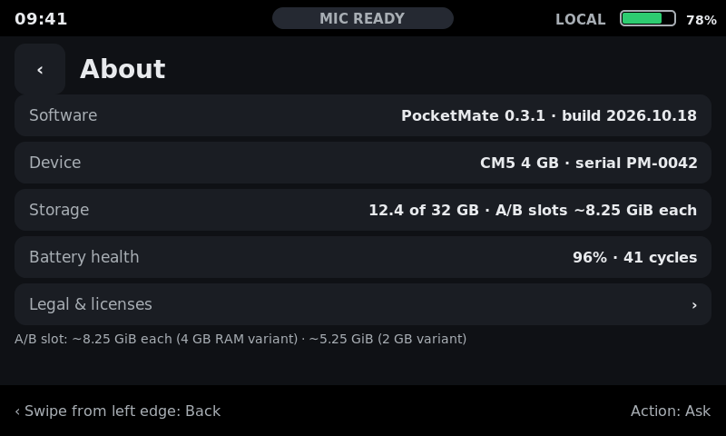
design/png/16f-settings-about.png
