anand2532/PocketMate/design/png/16g-wifi-password.png

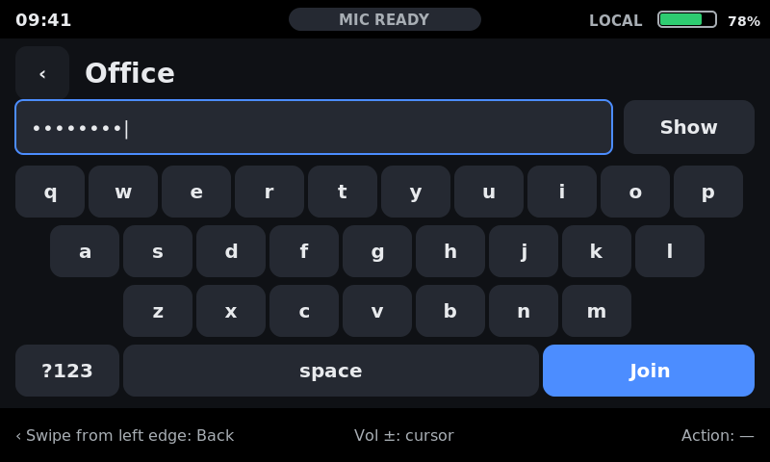
design/png/16g-wifi-password.png
