anand2532/PocketMate/design/png/16h-bt-pair-scan.png

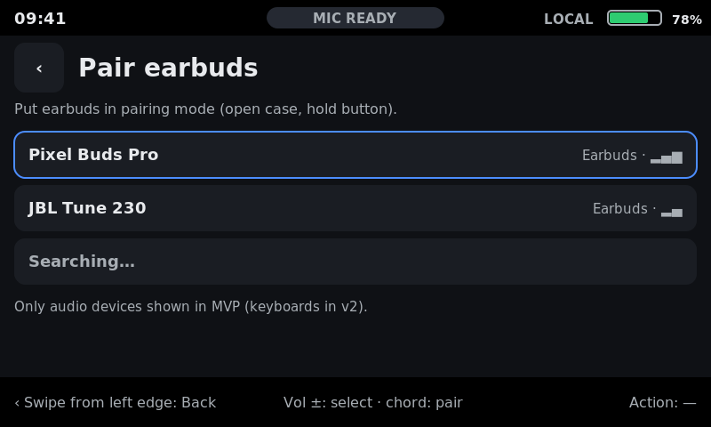
design/png/16h-bt-pair-scan.png
