anand2532/PocketMate/design/png/16j-bt-paired.png

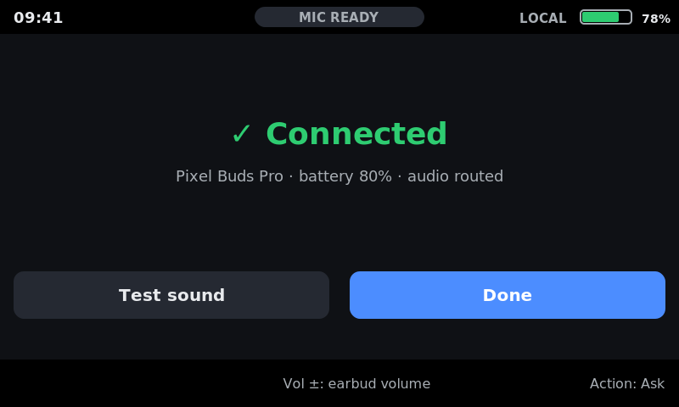
design/png/16j-bt-paired.png
