anand2532/PocketMate/design/png/16k-legal.png

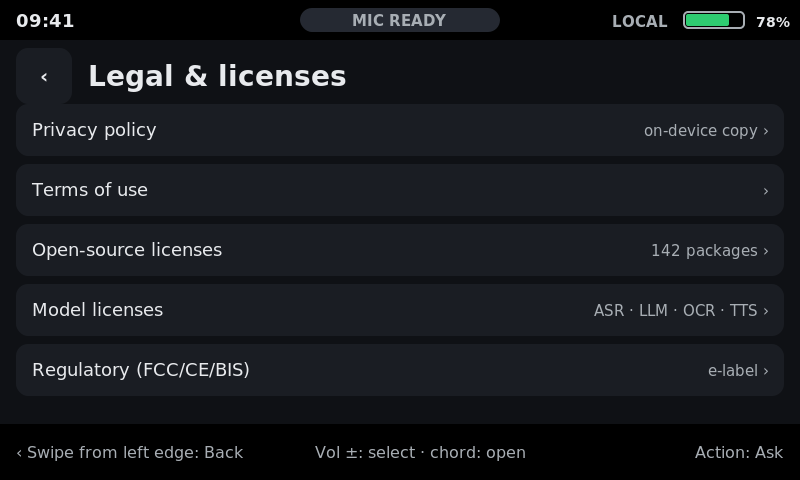
design/png/16k-legal.png
