anand2532/PocketMate/design/png/17-power-menu.png

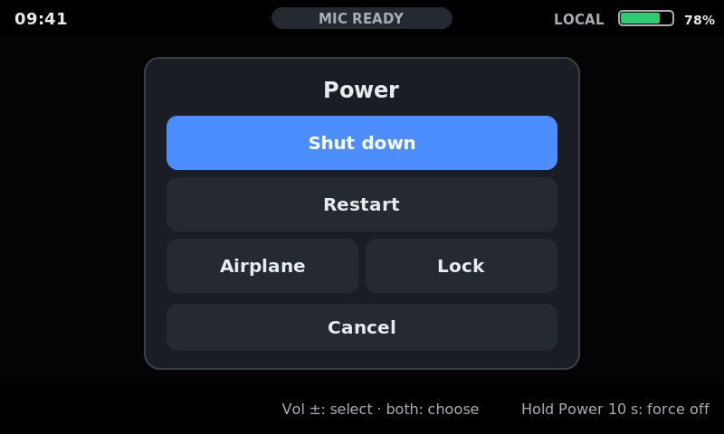
design/png/17-power-menu.png
