anand2532/PocketMate/design/png/18a-update-available.png

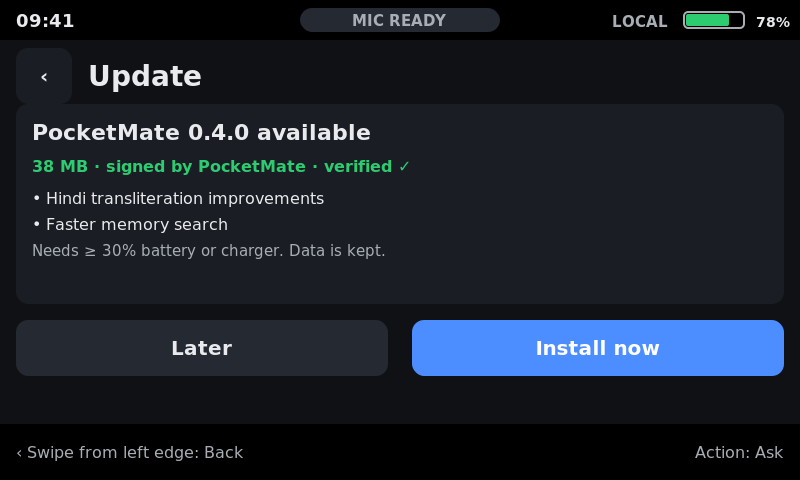
design/png/18a-update-available.png
