anand2532/PocketMate/design/png/18b-update-progress.png

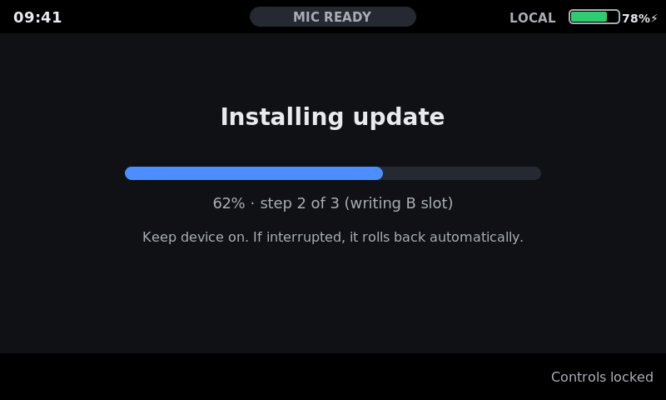
design/png/18b-update-progress.png
