anand2532/PocketMate/design/png/18c-update-done.png

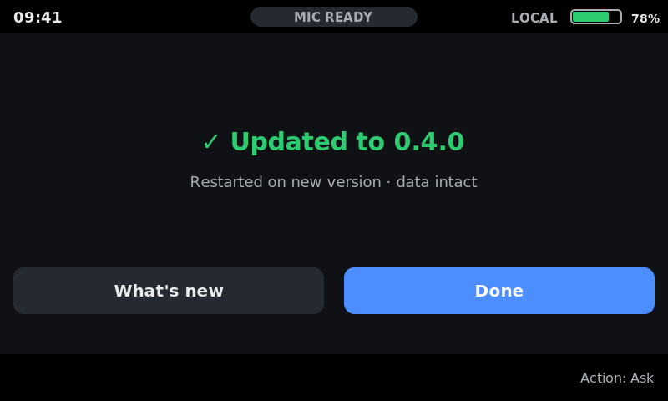
design/png/18c-update-done.png
