anand2532/PocketMate/design/png/18d-whats-new.png

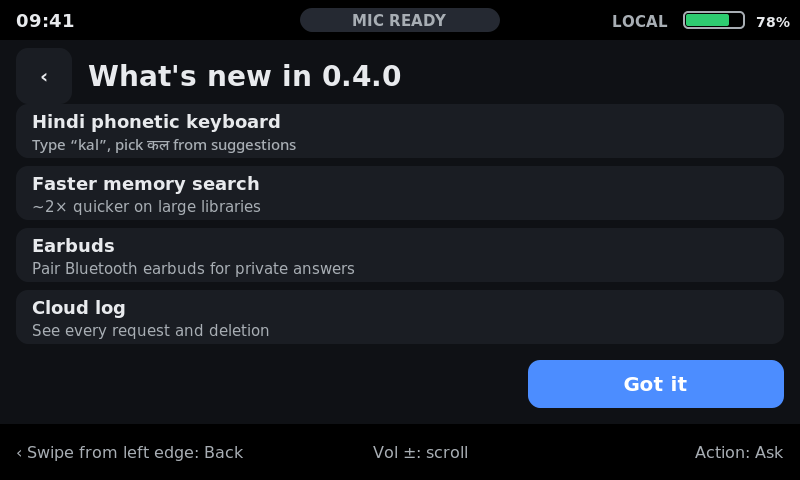
design/png/18d-whats-new.png
