anand2532/PocketMate/design/png/19-recovery.png

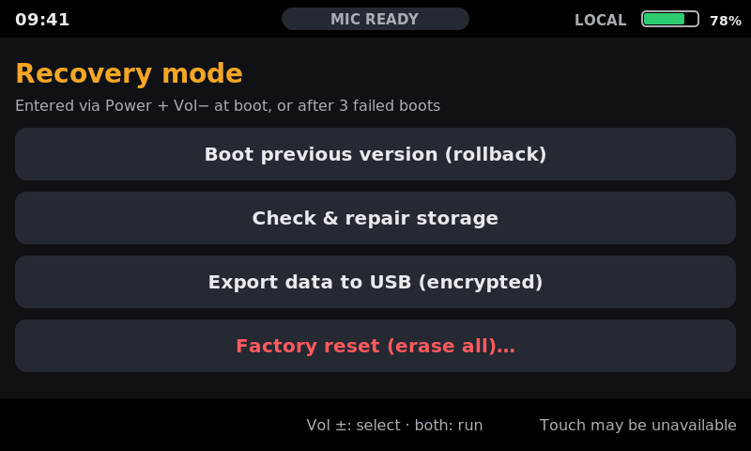
design/png/19-recovery.png
