anand2532/PocketMate/design/png/19b-recovery-reset.png

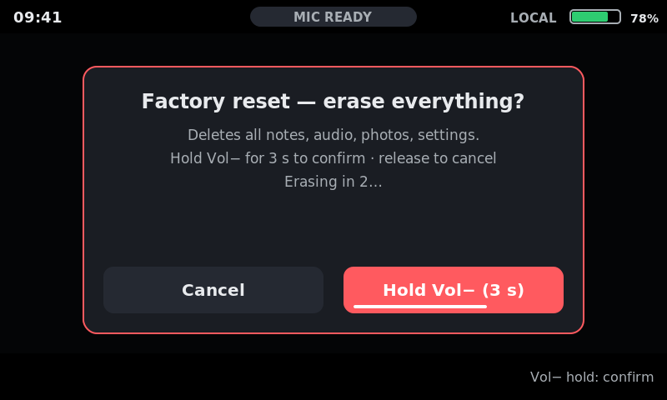
design/png/19b-recovery-reset.png
