anand2532/PocketMate/design/png/20a-err-no-network.png

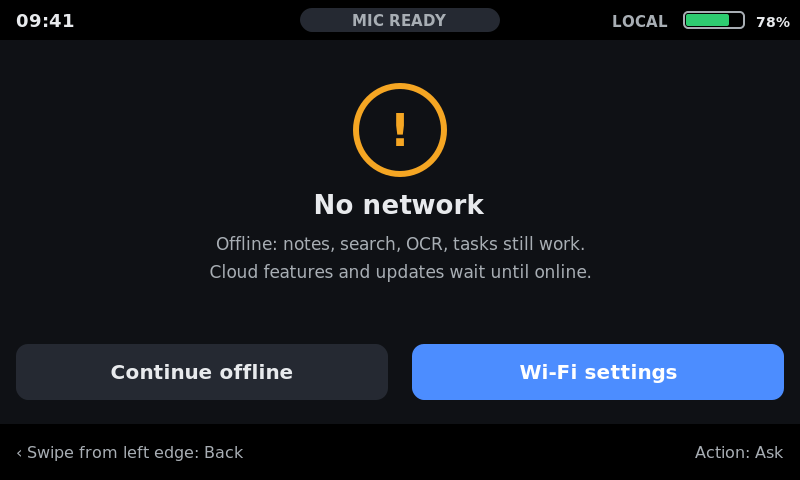
design/png/20a-err-no-network.png
