anand2532/PocketMate/design/png/20e-err-storage-full.png

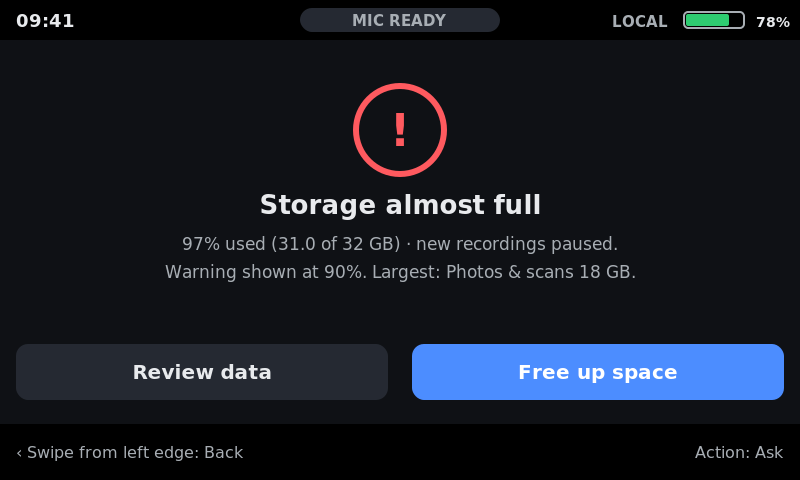
design/png/20e-err-storage-full.png
