anand2532/PocketMate/design/png/20j-free-up-space.png

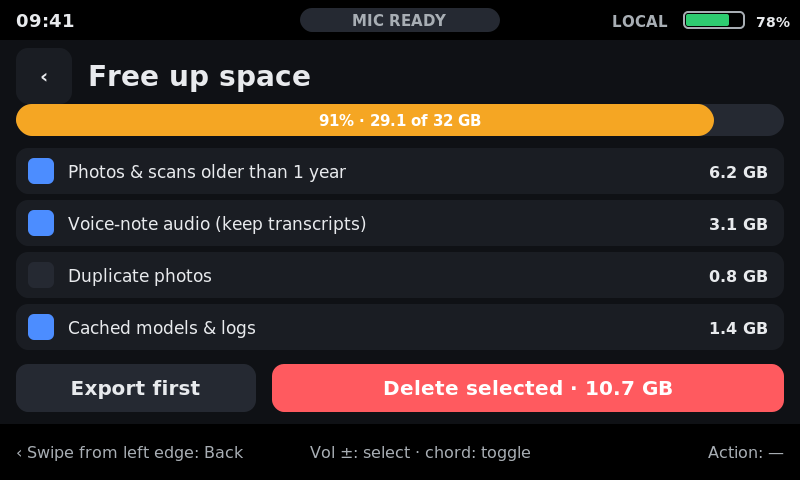
design/png/20j-free-up-space.png
