anand2532/PocketMate/design/png/21-diagnostics.png

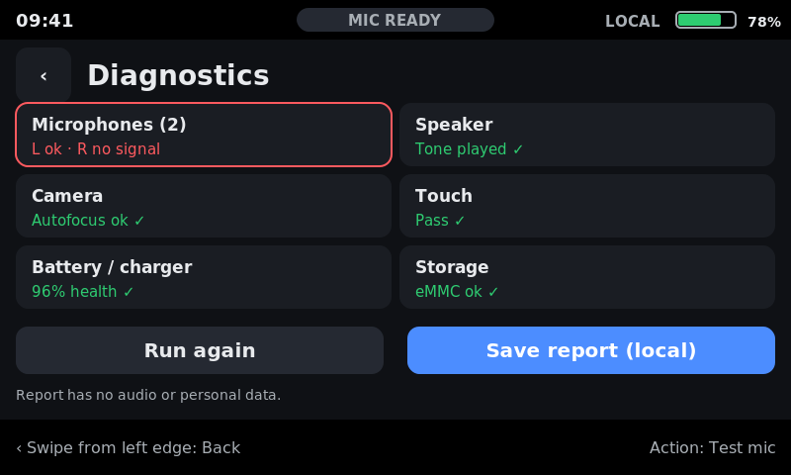
design/png/21-diagnostics.png
