anand2532/PocketMate/design/png/22-daily-summary.png

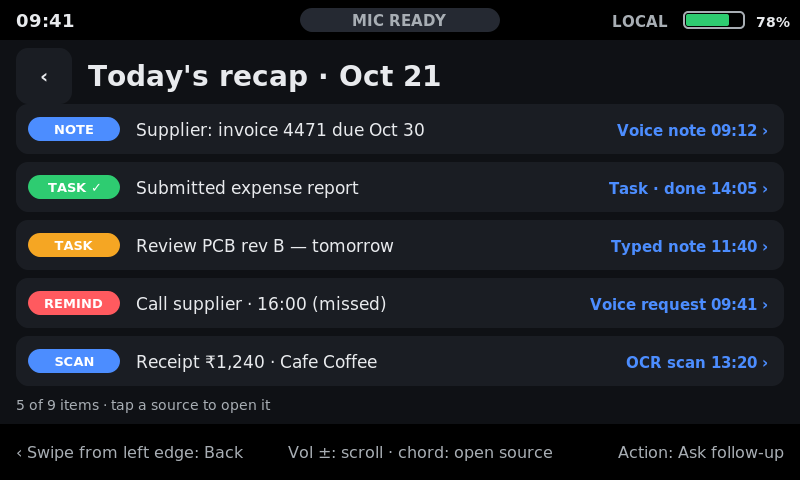
design/png/22-daily-summary.png
