anand2532/PocketMate/hardware/layout/pcb_bottom_render.png

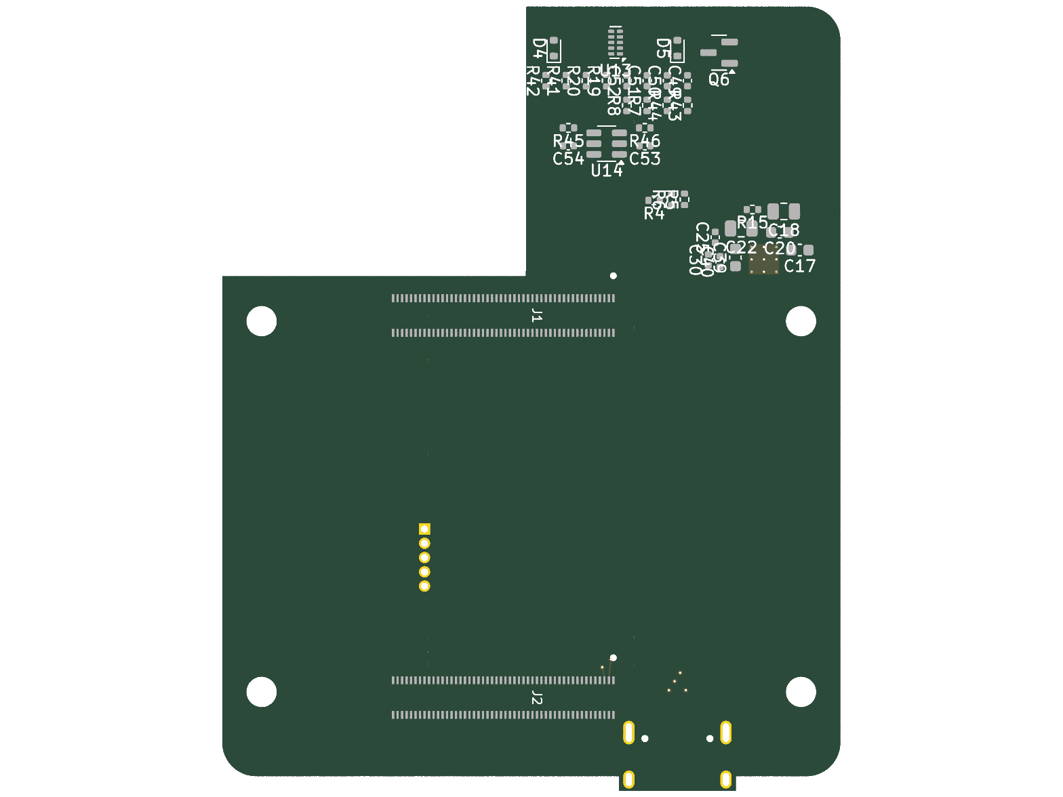
hardware/layout/pcb_bottom_render.png
