anand2532/PocketMate/hardware/layout/pcb_top_render.png

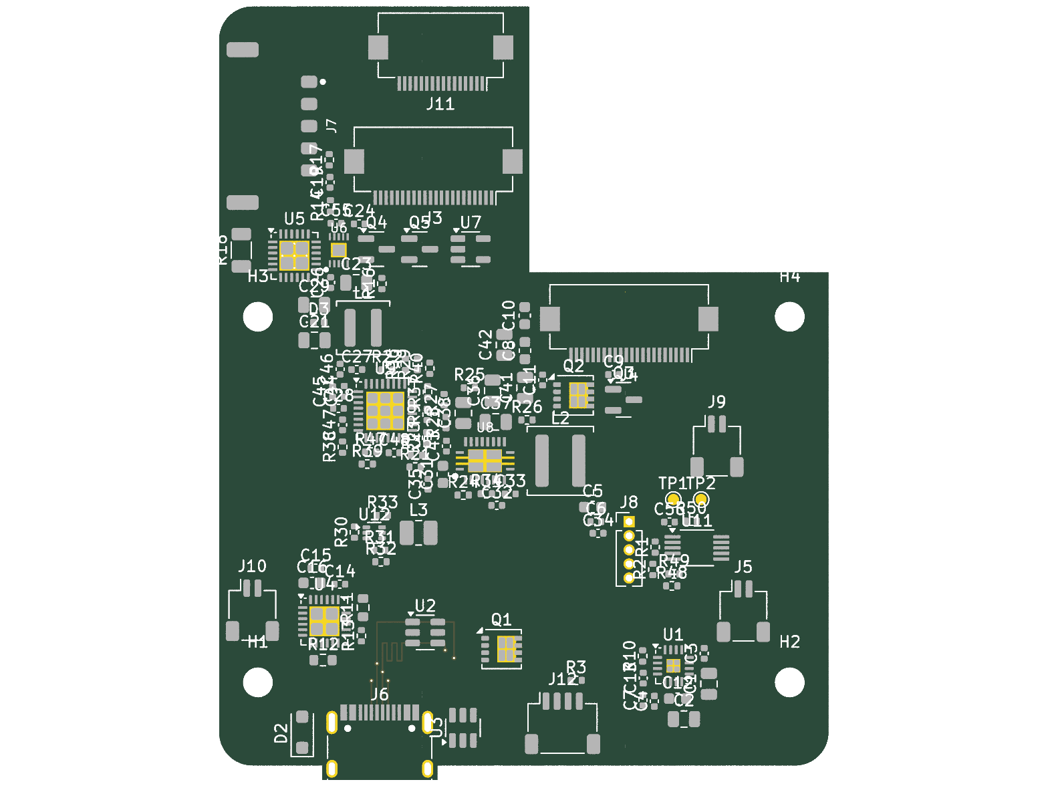
hardware/layout/pcb_top_render.png
