anand2532/PocketMate/mechanical/freecad/pocketmate_enclosure_v2_rear_iso.png

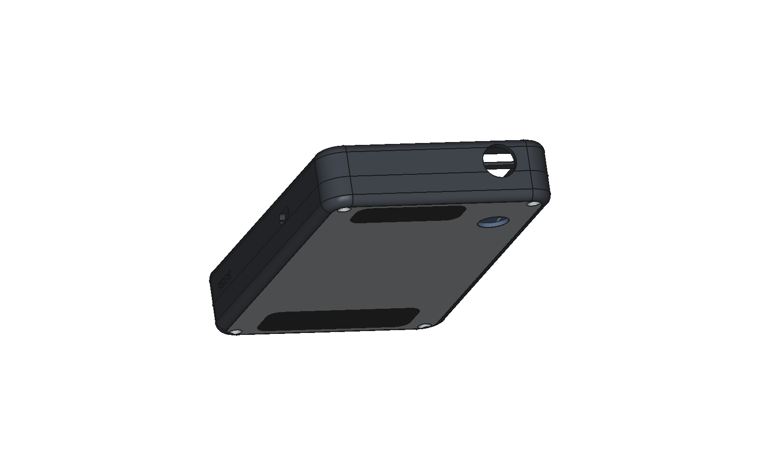
mechanical/freecad/pocketmate_enclosure_v2_rear_iso.png
