anand2532/PocketMate/mechanical/freecad/pocketmate_enclosure_v4_22c_internal_top.png

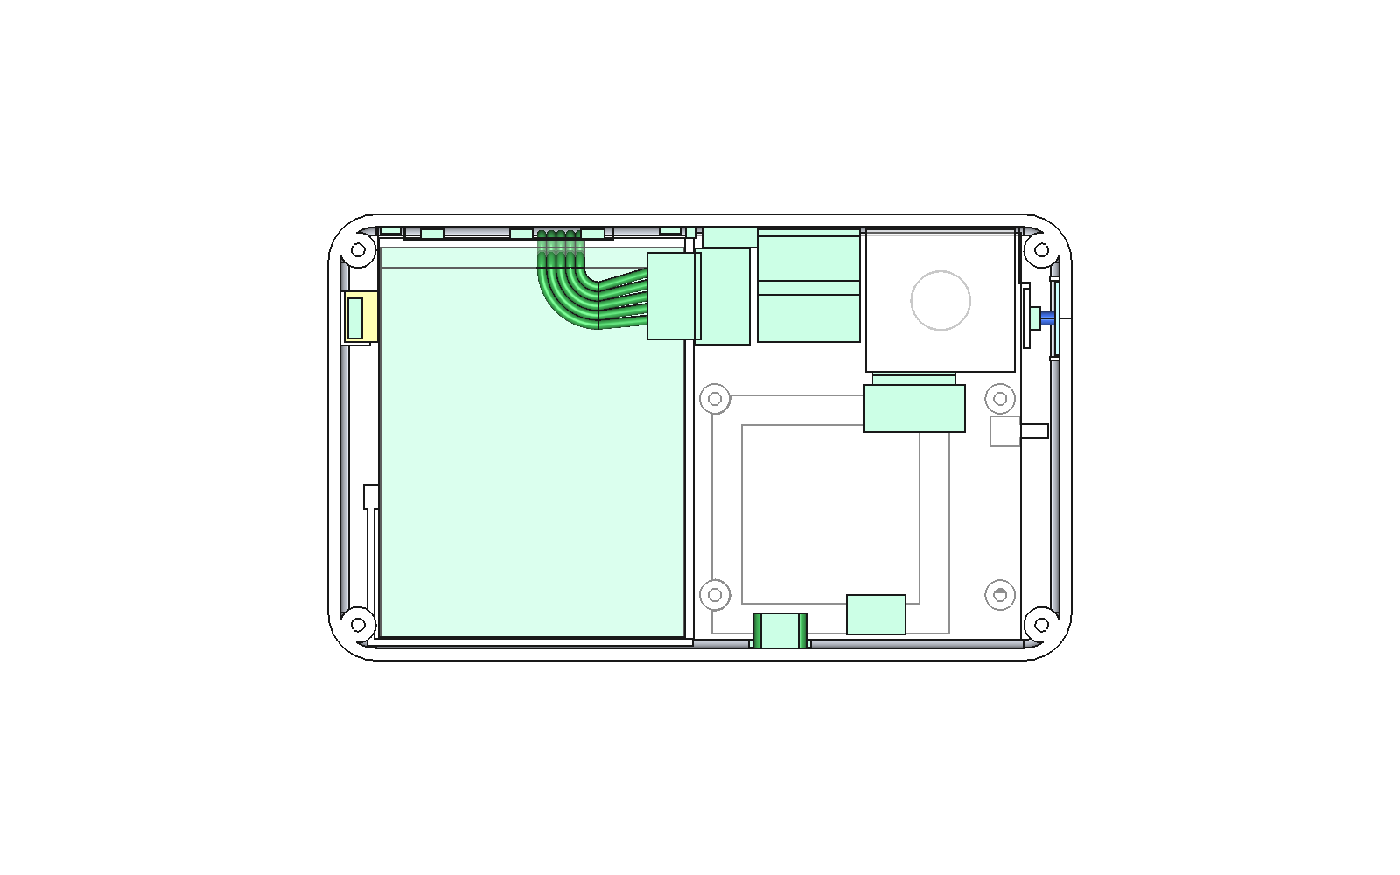
mechanical/freecad/pocketmate_enclosure_v4_22c_internal_top.png
