anand2532/PocketMate/mechanical/freecad/pocketmate_enclosure_v4_22c_rear_iso.png

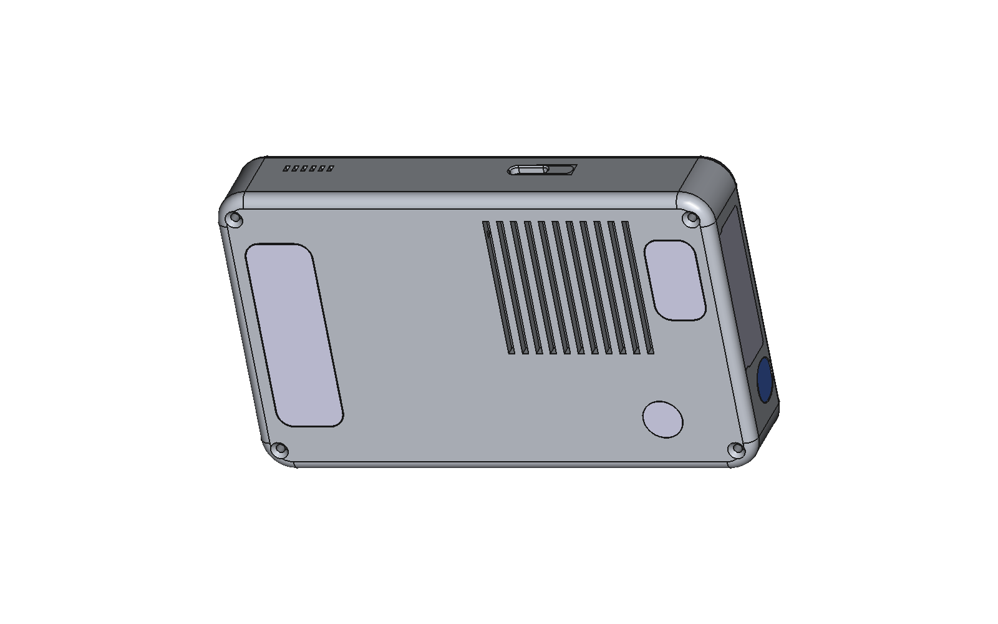
mechanical/freecad/pocketmate_enclosure_v4_22c_rear_iso.png
