anand2532/PocketMate/mechanical/freecad/pocketmate_enclosure_v4_22c_top_edge.png

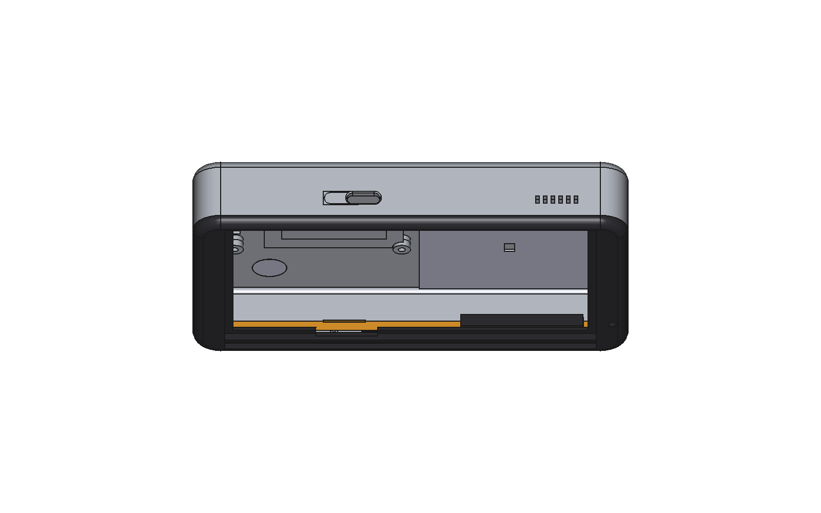
mechanical/freecad/pocketmate_enclosure_v4_22c_top_edge.png
