anand2532/PocketMate/mechanical/release_v5/renders/01_front_iso_closed.png

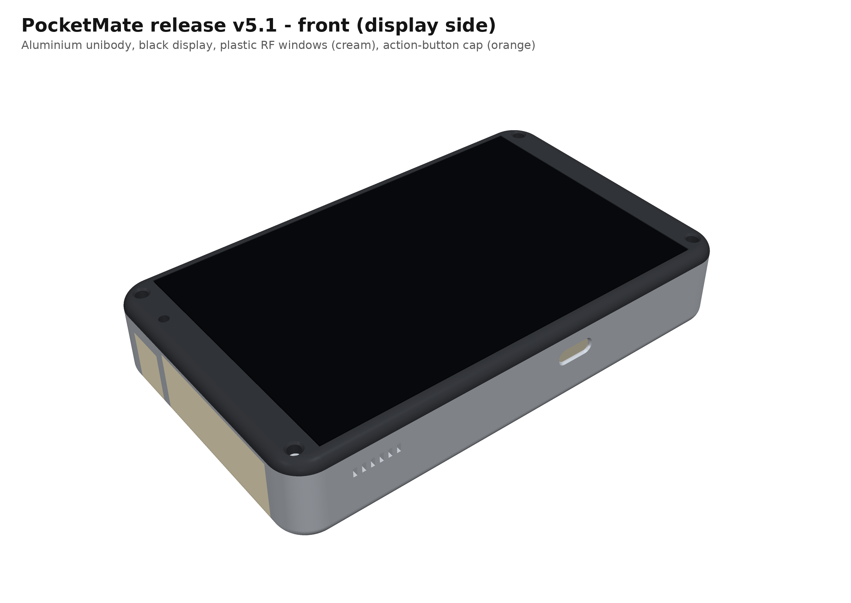
mechanical/release_v5/renders/01_front_iso_closed.png
