anand2532/PocketMate/mechanical/release_v5/renders/01b_front_iso_closed_right.png

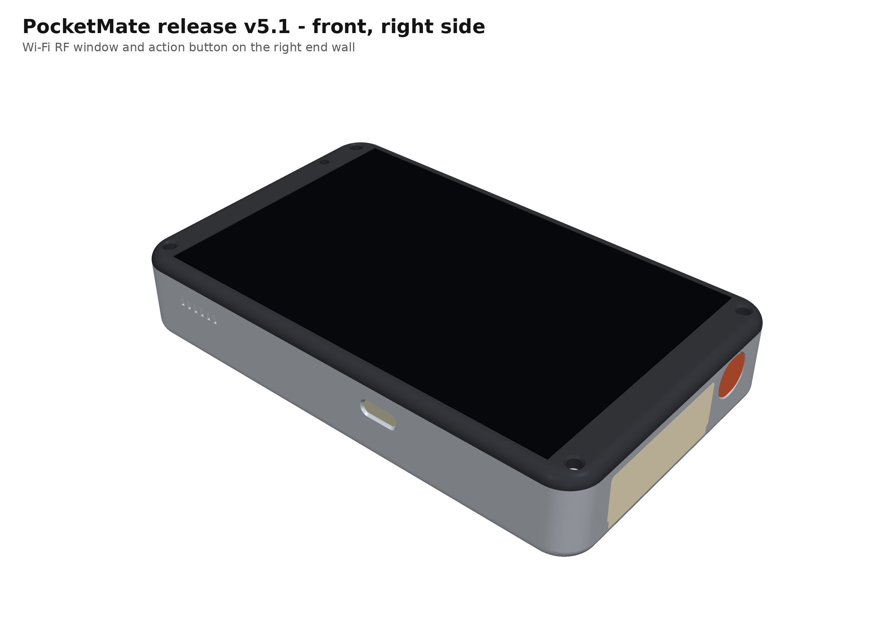
mechanical/release_v5/renders/01b_front_iso_closed_right.png
