anand2532/PocketMate/mechanical/release_v5/renders/02_back_iso.png

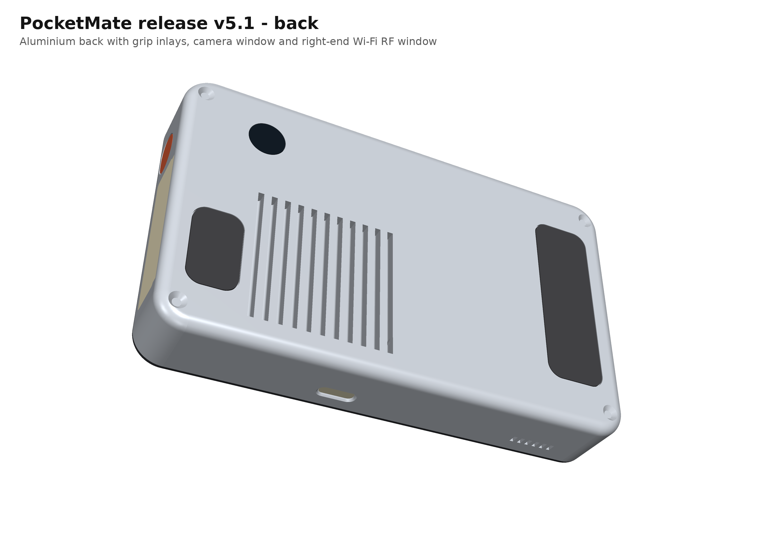
mechanical/release_v5/renders/02_back_iso.png
