anand2532/PocketMate/mechanical/release_v5/renders/03_exploded.png

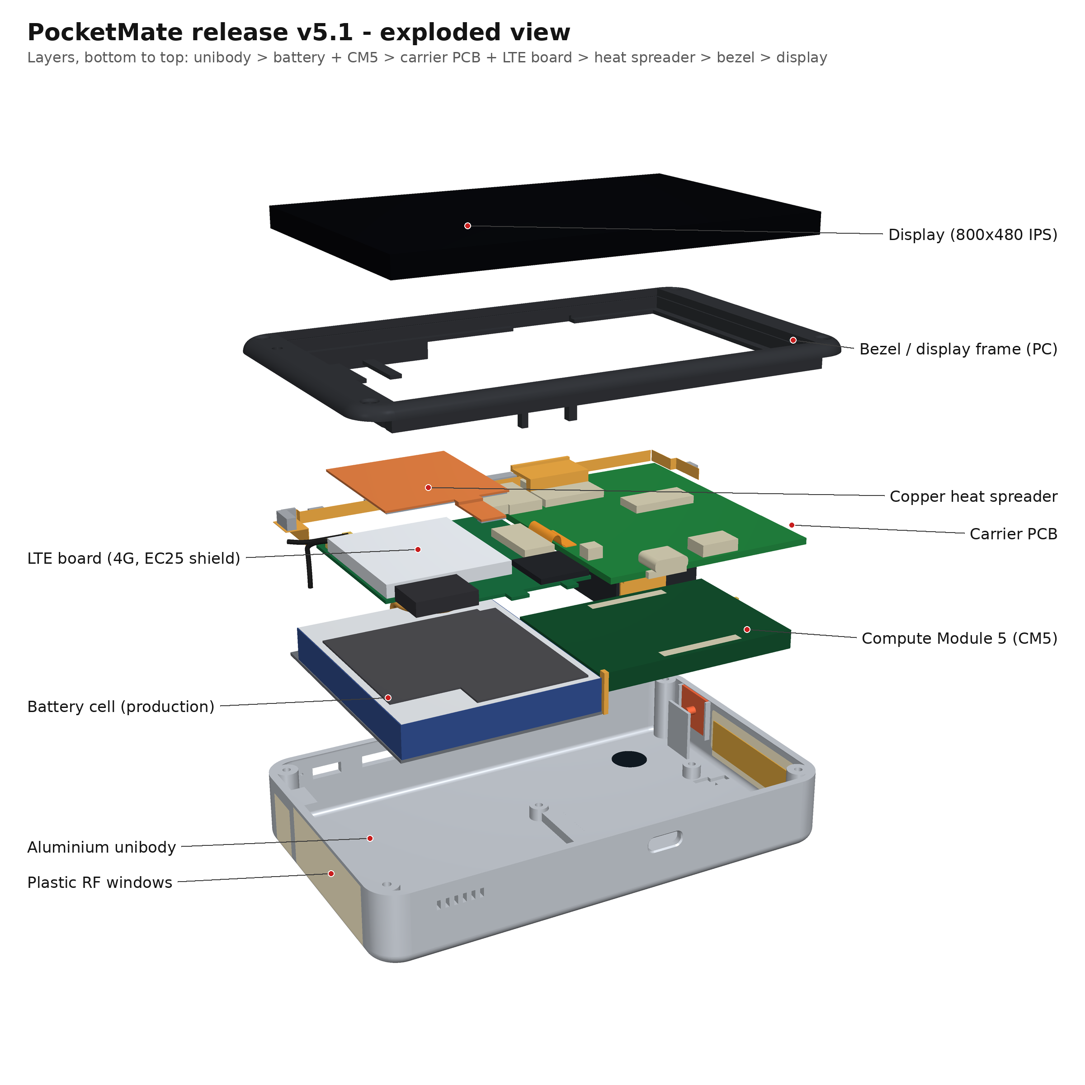
mechanical/release_v5/renders/03_exploded.png
