anand2532/PocketMate/mechanical/release_v5/renders/04_cutaway_section.png

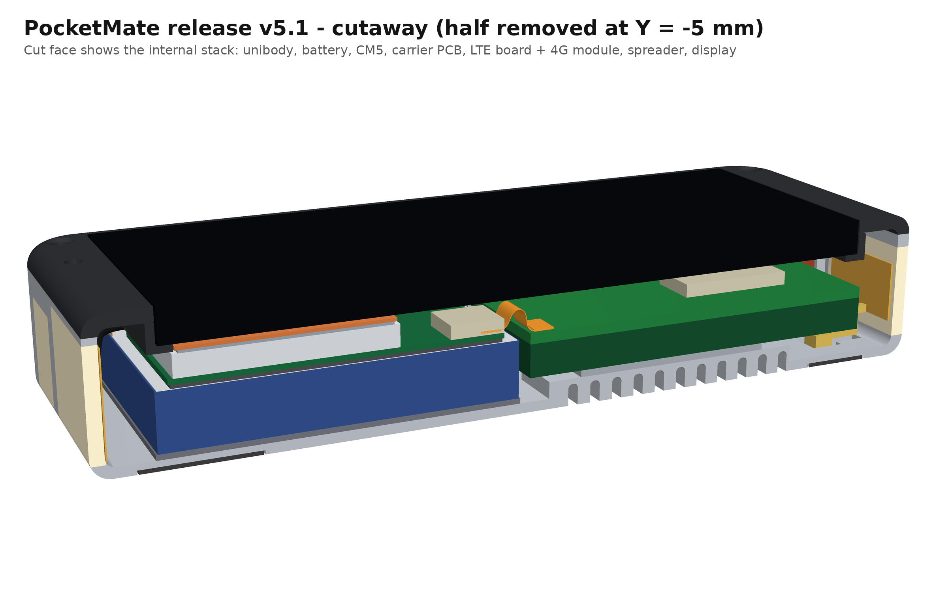
mechanical/release_v5/renders/04_cutaway_section.png
