anand2532/PocketMate/mechanical/release_v5/renders/04b_section_elevation.png

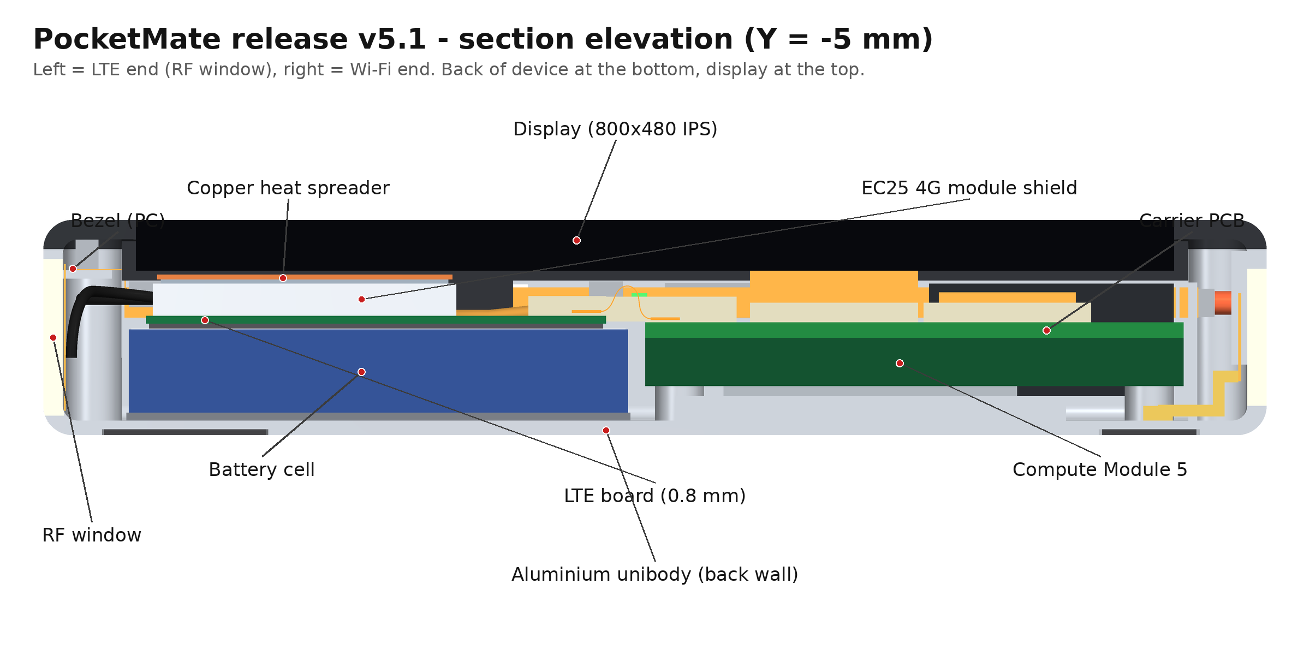
mechanical/release_v5/renders/04b_section_elevation.png
