anand2532/PocketMate/hardware/kicad/PocketMate_BOM.csv

Reference | Value | Footprint | QUANTITY | DNP
C1,C2,C21,C22,C29,C36,C37,C38,C41,C42 | 22uF | Capacitor_SMD:C_0805_2012Metric | 10
C3,C4,C6,C9,C11,C13,C24,C28,C30,C32,C40,C44,C45,C47,C48,C53,C54,C57,C58,C59 | 100nF | Capacitor_SMD:C_0402_1005Metric | 20
C5,C8,C10,C12,C39 | 10uF | Capacitor_SMD:C_0603_1608Metric | 5
C7,C14,C15,C26,C27,C46,C55,C56,C60 | 1uF | Capacitor_SMD:C_0402_1005Metric | 9 | DNP
C16,C17 | 1uF | Capacitor_SMD:C_0603_1608Metric | 2
C18,C23 | 10uF | Capacitor_SMD:C_0805_2012Metric | 2
C19,C33 | 47nF | Capacitor_SMD:C_0402_1005Metric | 2
C20 | 4.7uF | Capacitor_SMD:C_0603_1608Metric | 1
C25 | 470nF | Capacitor_SMD:C_0402_1005Metric | 1
C31 | 2.2uF | Capacitor_SMD:C_0603_1608Metric | 1
C34 | 2.7nF | Capacitor_SMD:C_0402_1005Metric | 1
C35 | 18pF | Capacitor_SMD:C_0402_1005Metric | 1
C43,C49,C50,C51,C52 | 10nF | Capacitor_SMD:C_0402_1005Metric | 5
D1 | RED mic-muted | LED_SMD:LED_0402_1005Metric | 1
D2 | SMF15A (VBUS TVS) | Diode_SMD:D_SOD-123F | 1
D3 | GREEN charge | LED_SMD:LED_0402_1005Metric | 1
D4 | RB521S30 (QON wake) | Diode_SMD:D_SOD-523 | 1
D5 | PESD5V0S1BB (ESD, MIC_SW_LIVE) | Diode_SMD:D_SOD-523 | 1
D6 | GREEN REC (APTD1608LZGCK) | LED_SMD:LED_0603_1608Metric | 1
J1 | 10164227-1001A1RLF | PocketMate:CM5_B2B_10164227_Pins1-100 | 1
J2 | 10164227-1001A1RLF | PocketMate:CM5_B2B_10164227_Pins101-200 | 1
J3 | DSI1 22p 0.5mm FH12-22S-0.5SH (Pi5 DSI pinout) | Connector_FFC-FPC:Hirose_FH12-22S-0.5SH_1x22-1MP_P0.50mm_Horizontal | 1
J4 | CSI0 22p 0.5mm FH12-22S-0.5SH (Pi5 CSI pinout) | Connector_FFC-FPC:Hirose_FH12-22S-0.5SH_1x22-1MP_P0.50mm_Horizontal | 1
J5 | Speaker 8R 1W | Connector_JST:JST_SH_SM02B-SRSS-TB_1x02-1MP_P1.00mm_Horizontal | 1
J6 | TYPE-C-31-M-12 | Connector_USB:USB_C_Receptacle_HRO_TYPE-C-31-M-12 | 1
J7 | Molex 205338-0005 (BAT+,BAT+,BAT-,BAT-,NTC) | PocketMate:Molex_Pico-Lock_205338-0005_1x05-1MP_P2.00mm_Horizontal | 1
J8 | SWD (TC2030 pads) | Connector_PinHeader_1.27mm:PinHeader_1x05_P1.27mm_Vertical | 1
J9 | LRA motor | Connector_JST:JST_SH_SM02B-SRSS-TB_1x02-1MP_P1.00mm_Horizontal | 1 | DNP
J10 | Skin NTC 10k B3435 | Connector_JST:JST_SH_SM02B-SRSS-TB_1x02-1MP_P1.00mm_Horizontal | 1
J11 | FH12-16S-0.5SH(55) | Connector_FFC-FPC:Hirose_FH12-16S-0.5SH_1x16-1MP_P0.50mm_Horizontal | 1
J12 | Fan 5V/GND/PWM/TACH | Connector_JST:JST_SH_SM04B-SRSS-TB_1x04-1MP_P1.00mm_Horizontal | 1 | DNP
J13 | Flex tail to carrier J11 (placeholder) | PocketMate:FlexTail_16P_P0.50mm | 1
L1 | 1uH XAL4020-102ME | Inductor_SMD:L_Coilcraft_XAL4020-XXX | 1
L2 | 1uH XAL5030-102ME | Inductor_SMD:L_Coilcraft_XAL5030-XXX | 1
L3 | 1uH DFE252012F-1R0M | Inductor_SMD:L_1008_2520Metric | 1
MK1 | SPH0645LM4H-B (Left, SEL=GND) | Sensor_Audio:Knowles_SPH0645LM4H-6_3.5x2.65mm | 1
MK2 | SPH0645LM4H-B (Right, SEL=VDD) | Sensor_Audio:Knowles_SPH0645LM4H-6_3.5x2.65mm | 1
Q1,Q2 | DMP3013SFV | Package_SON:Diodes_PowerDI3333-8 | 2
Q3,Q4,Q5,Q6 | 2N7002 | Package_TO_SOT_SMD:SOT-23 | 4
R1,R2,R4,R17,R49,R50 | 2.2k | Resistor_SMD:R_0402_1005Metric | 6 | DNP
R3,R9,R21,R22,R23,R28,R32,R36,R40 | 10k | Resistor_SMD:R_0402_1005Metric | 9 | DNP
R5,R6,R19,R20 | 4.7k | Resistor_SMD:R_0402_1005Metric | 4
R7 | 33R | Resistor_SMD:R_0402_1005Metric | 1
R8,R13,R29,R33,R34,R35,R41,R42,R43,R44,R46,R47,R48,R53 | 100k | Resistor_SMD:R_0402_1005Metric | 14 | DNP
R10 | 1M | Resistor_SMD:R_0402_1005Metric | 1
R11 | 1k | Resistor_SMD:R_0603_1608Metric | 1
R12 | 220R | Resistor_SMD:R_0603_1608Metric | 1
R14 | 130R 1% | Resistor_SMD:R_0402_1005Metric | 1
R15 | 5.23k | Resistor_SMD:R_0402_1005Metric | 1
R16 | 30.1k | Resistor_SMD:R_0402_1005Metric | 1
R18 | 10m 1% 1206 0.5W | Resistor_SMD:R_1206_3216Metric | 1
R24 | 150k 1% | Resistor_SMD:R_0402_1005Metric | 1
R25 | 127k 1% | Resistor_SMD:R_0402_1005Metric | 1
R26 | 182k 1% | Resistor_SMD:R_0402_1005Metric | 1
R27 | 56k 1% | Resistor_SMD:R_0402_1005Metric | 1
R30 | 100k 1% | Resistor_SMD:R_0402_1005Metric | 1
R31 | 22.1k 1% | Resistor_SMD:R_0402_1005Metric | 1
R37 | 10k 1% | Resistor_SMD:R_0402_1005Metric | 1
R38,R39,R54 | 1k | Resistor_SMD:R_0402_1005Metric | 3
R45,R51,R52 | 0R | Resistor_SMD:R_0402_1005Metric | 3
R55 | 1.3k | Resistor_SMD:R_0402_1005Metric | 1
SW1 | POWER | Button_Switch_SMD:SW_SPST_PTS810 | 1
SW2 | ACTION | Button_Switch_SMD:SW_SPST_PTS810 | 1
SW3 | VOL+ | Button_Switch_SMD:SW_SPST_PTS810 | 1
SW4 | VOL- | Button_Switch_SMD:SW_SPST_PTS810 | 1
SW5 | MIC MUTE (DPDT slide) | Button_Switch_SMD:SW_DPDT_CK_JS202011JCQN | 1
TP1 | nRPIBOOT | TestPoint:TestPoint_Pad_D1.0mm | 1
TP2 | GND | TestPoint:TestPoint_Pad_D1.0mm | 1
U1 | MAX98357AETE+ | Package_DFN_QFN:TQFN-16-1EP_3x3mm_P0.5mm_EP1.23x1.23mm | 1
U2 | USBLC6-2SC6 (D+/D-) | Package_TO_SOT_SMD:SOT-23-6 | 1
U3 | USBLC6-2SC6 (CC1/CC2) | Package_TO_SOT_SMD:SOT-23-6 | 1
U4 | STUSB4500QTR | Package_DFN_QFN:QFN-24-1EP_4x4mm_P0.5mm_EP2.7x2.7mm | 1
U5 | BQ25895RTWR | Package_DFN_QFN:Texas_RTW_WQFN-24-1EP_4x4mm_P0.5mm_EP2.7x2.7mm_ThermalVias | 1
U6 | MAX17055ETB+ | PocketMate:Maxim_TDFN-10-1EP_2x2.5mm_P0.4mm_EP1.4x1.3mm_MAX17055 | 1
U7 | TPS7A0233PDBVR | Package_TO_SOT_SMD:SOT-23-5 | 1
U8 | TPS61088RHLR | PocketMate:TI_RHL0020A_VQFN-20_3.5x4.5mm_TPS61088 | 1
U9 | STM32U031K8U6 | Package_DFN_QFN:QFN-32-1EP_5x5mm_P0.5mm_EP3.45x3.45mm | 1
U10 | VEML7700-TT | PocketMate:Vishay_VEML7700 | 1
U11 | DRV2605LDGSR | Package_SO:VSSOP-10_3x3mm_P0.5mm | 1 | DNP
U12 | TLV62585DRLR | Package_TO_SOT_SMD:SOT-563 | 1
U13 | TPD4E05U06DQAR (flex buttons ESD) | Package_SON:USON-10_2.5x1.0mm_P0.5mm | 1
U14 | TPS22917DBVR | Package_TO_SOT_SMD:SOT-23-6 | 1
