anand2532/PocketMate/mechanical/release_v5/pocketmate_assembly_release_v5.step

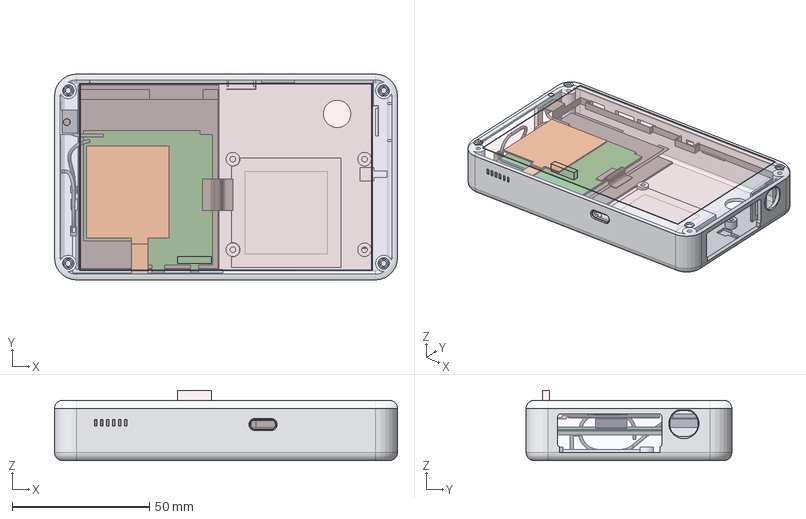
[picture p83: CAD file, 2026-10-27]
mechanical/release_v5/pocketmate_assembly_release_v5.step
125.0 x 75.0 x 25.6 mm
Al_Unibody
Bezel_DisplayFrame_PC
RFWindow_PC
GripInlay_L
GripInlay_R
CameraWindow_PC
BattPad_NTCpocket
ActionCap_PC
SideKey_Flex
Vol_Display
Vol_ThermalPad
Vol_CM5
Vol_UFL
Vol_J1_B2B
Vol_J2_B2B
Vol_NTC_Rise
Vol_J_NTC_SH
Vol_Carrier
Vol_Battery
Vol_NTC_Batt
Vol_NTC_Case
Vol_Antenna_FPC
Vol_Antenna_Keepout
Vol_Pigtail
Vol_Camera
Vol_Speaker
Vol_J6_USBC_HRO
Vol_J6_CarrierTab
Vol_J7_Molex205338
Vol_J7_Housing205341
Vol_Cell_Prod_62
Vol_Cell_Proto_Akyga
Vol_Leads_Prod62
Vol_Leads_ProtoAkyga
Vol_J3_FH12_22
Vol_DSI_FPC_b
Vol_J4_FH12_22
Vol_CamFPC
Vol_J11_FH12_16
Vol_J12_FanHdr_DNP
Vol_Mic1_SPH0645
Vol_Mic2_SPH0645
Vol_SW5_JS202011JCQN
Vol_SW5_Actuator_throw
Vol_MuteLED
Vol_ALS_VEML7700
Vol_SW_Pwr
Vol_SW_VolUp
Vol_SW_VolDn
Vol_SW_Action
LTE_Daughterboard_PCB
Vol_LTE_EC25_Shield
Vol_LTE_U1_Courtyard
Vol_LTE_UFL_GNSS
Vol_LTE_UFL_Main
Vol_LTE_NanoSIM_Hinged
Vol_LTE_SIM_LidSwing
Vol_LTE_DB_Conn_FH12_22
Vol_J14_FH12_22_Courtyard
LTE_Flex_22P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
