anand2532/PocketMate/mechanical/release_v5/step_parts/Coax_Main_release_v5.step

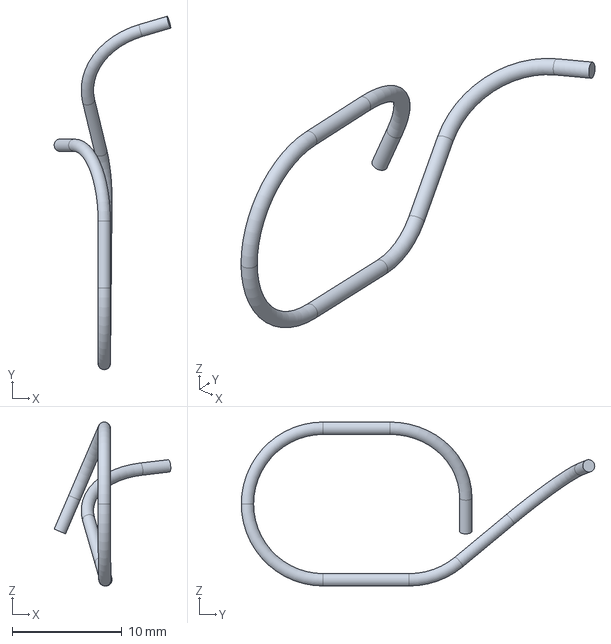
[picture p84: CAD file, 2026-10-27]
mechanical/release_v5/step_parts/Coax_Main_release_v5.step
10.6 x 32.2 x 14.9 mm
