anand2532/PocketMate/mechanical/freecad/pocketmate_assembly_v2.step

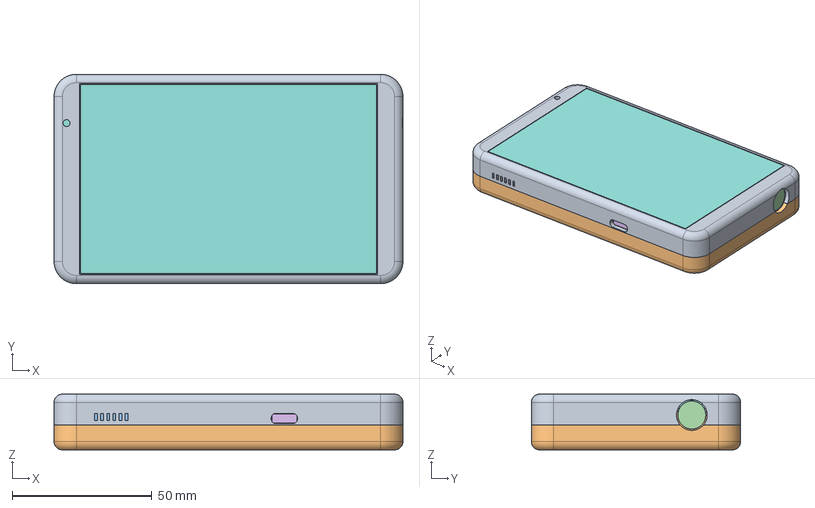
[picture p86: CAD file, 2026-10-21]
mechanical/freecad/pocketmate_assembly_v2.step
125.0 x 75.0 x 20.0 mm
FrontShell
BackFrame
AlBackPlate
GripInlay_L
GripInlay_R
CameraWindow_PC
BattPad_NTCpocket
Vol_Display
Vol_ThermalPad
Vol_CM5
Vol_Carrier
Vol_Battery
Vol_NTC_Batt
Vol_NTC_Case
Vol_BattConn_ZH
Vol_ALS
Vol_BattLeads
Vol_Camera
Vol_Speaker
Vol_ActionBtn
Vol_SideBtns
Vol_USBC
