anand2532/PocketMate/mechanical/release_v5/step_parts/RFWindow_LTE_Main_L_PC_release_v5.step

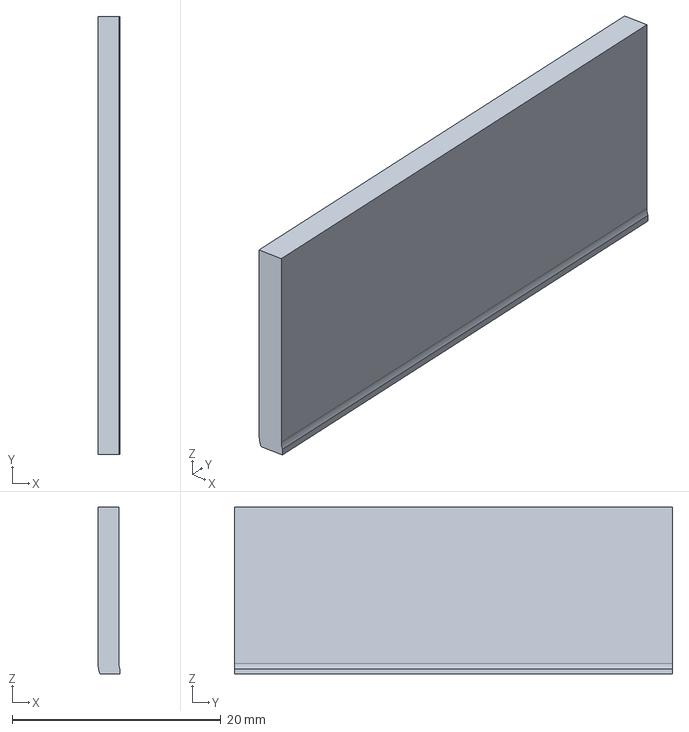
[picture p88: CAD file, 2026-10-27]
mechanical/release_v5/step_parts/RFWindow_LTE_Main_L_PC_release_v5.step
2.10 x 42.0 x 16.0 mm
