anand2532/PocketMate/mechanical/release_v5/drawings/unibody_top_wall_release_v5.dxf

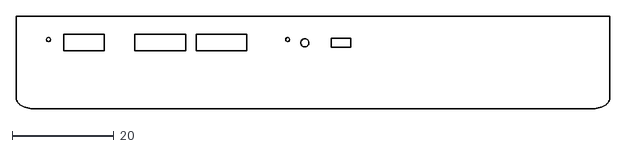
[picture p89: CAD file, 2026-10-27]
mechanical/release_v5/drawings/unibody_top_wall_release_v5.dxf
116.7 x 18.2
