anand2532/PocketMate/mechanical/release_v5/step_parts/Al_Unibody_release_v5.step

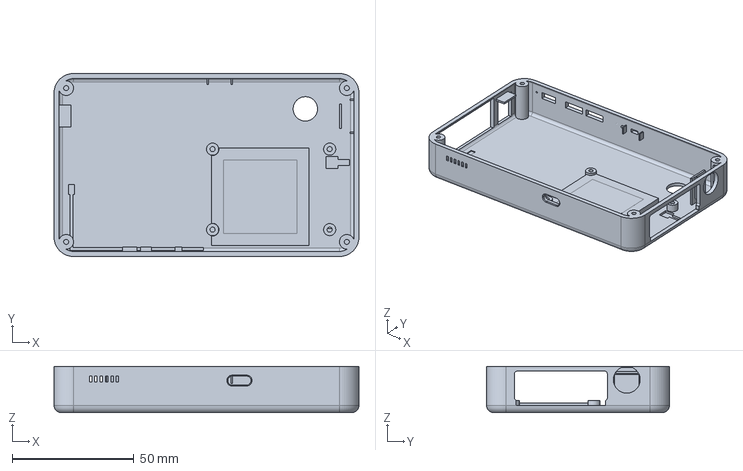
[picture p90: CAD file, 2026-10-27]
mechanical/release_v5/step_parts/Al_Unibody_release_v5.step
125.0 x 75.0 x 19.0 mm
