anand2532/PocketMate/mechanical/freecad/pocketmate_plastics_v4_22c.step

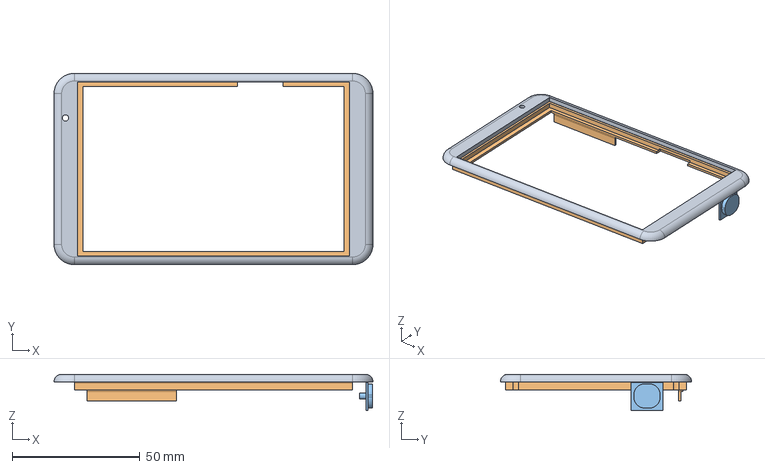
[picture p91: CAD file, 2026-10-27]
mechanical/freecad/pocketmate_plastics_v4_22c.step
125.0 x 75.0 x 14.3 mm
Bezel_DisplayFrame_PC
ActionCap_PC
