anand2532/PocketMate/mechanical/freecad/board_outline_v4_22c.dxf

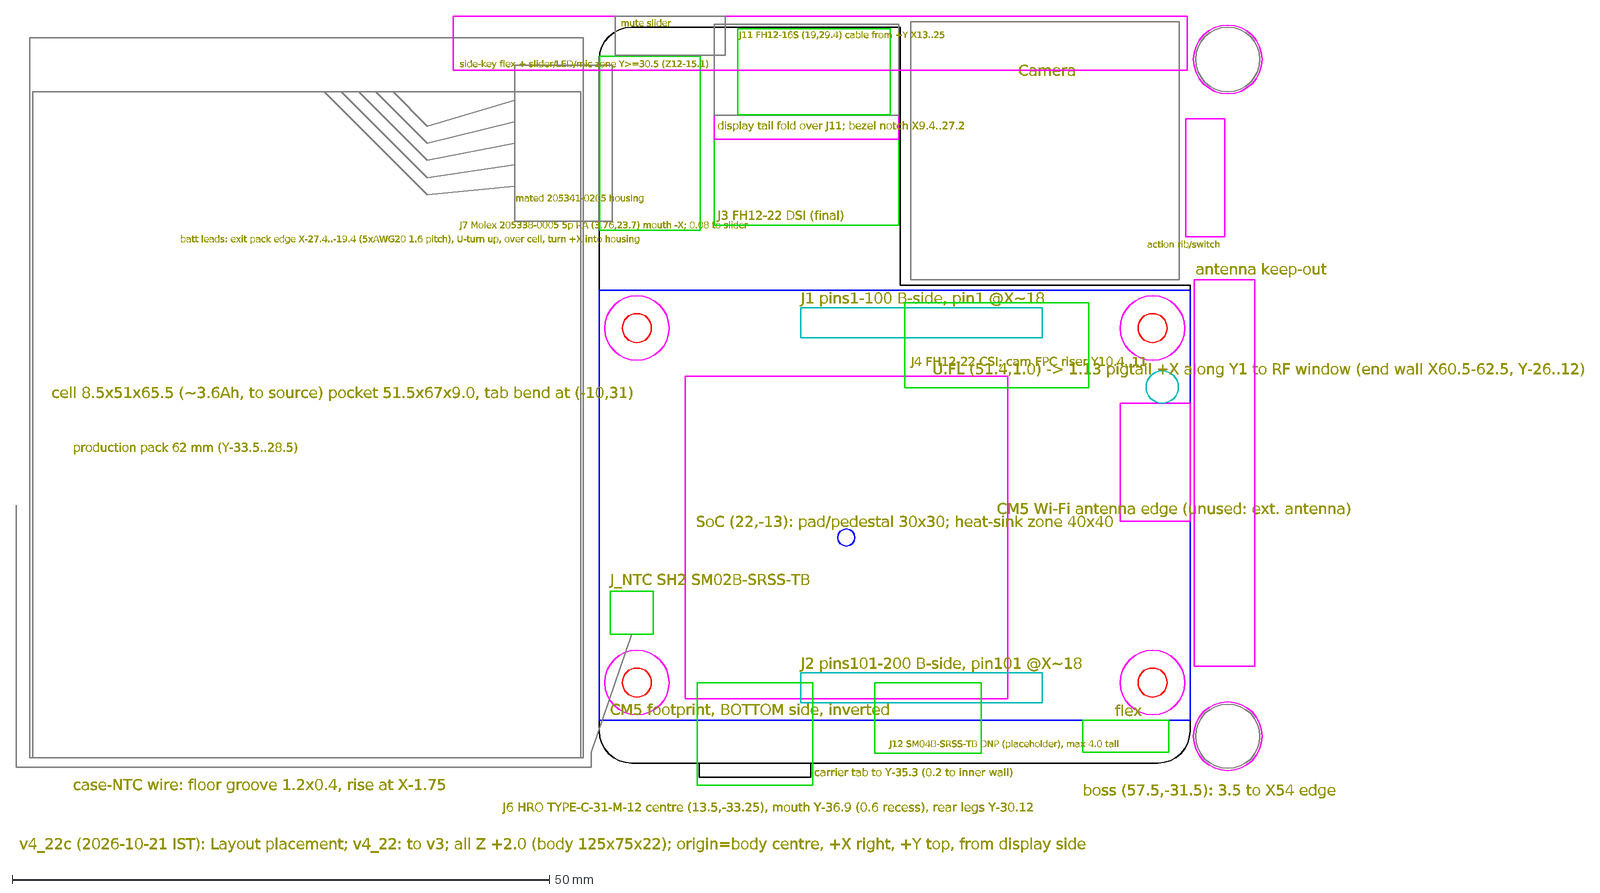
[picture p94: CAD file, 2026-10-27]
mechanical/freecad/board_outline_v4_22c.dxf
boss (57.5,-31.5): 3.5 to X54 edge
CM5 footprint, BOTTOM side, inverted
SoC (22,-13): pad/pedestal 30x30; heat-sink zone 40x40
J1 pins1-100 B-side, pin1 @X~18
J2 pins101-200 B-side, pin101 @X~18
CM5 Wi-Fi antenna edge (unused: ext. antenna)
U.FL (51.4,1.0) -> 1.13 pigtail +X along Y1 to RF window (end wall X60.5-62.5, Y-26..12)
antenna keep-out
flex
J_NTC SH2 SM02B-SRSS-TB
case-NTC wire: floor groove 1.2x0.4, rise at X-1.75
Camera
cell 8.5x51x65.5 (~3.6Ah, to source) pocket 51.5x67x9.0, tab bend at (-10,31)
v4_22c (2026-10-21 IST): Layout placement; v4_22: to v3; all Z +2.0 (body 125x75x22); origin=body centre, +X right, +Y top, from display side
J6 HRO TYPE-C-31-M-12 centre (13.5,-33.25), mouth Y-36.9 (0.6 recess), rear legs Y-30.12
carrier tab to Y-35.3 (0.2 to inner wall)
J7 Molex 205338-0005 5p RA (3.76,23.7) mouth -X; 0.08 to slider
mated 205341-0205 housing
batt leads: exit pack edge X-27.4..-19.4 (5xAWG20 1.6 pitch), U-turn up, over cell, turn +X into housing
production pack 62 mm (Y-33.5..28.5)
J3 FH12-22 DSI (final)
display tail fold over J11; bezel notch X9.4..27.2
J4 FH12-22 CSI; cam FPC riser Y10.4..11
J11 FH12-16S (19,29.4) cable from +Y X13..25
J12 SM04B-SRSS-TB DNP (placeholder), max 4.0 tall
side-key flex + slider/LED/mic zone Y>=30.5 (Z12-15.1)
mute slider
action rib/switch
