anand2532/PocketMate/mechanical/release_v5/drawings/slack_loop_plan_release_v5.dxf

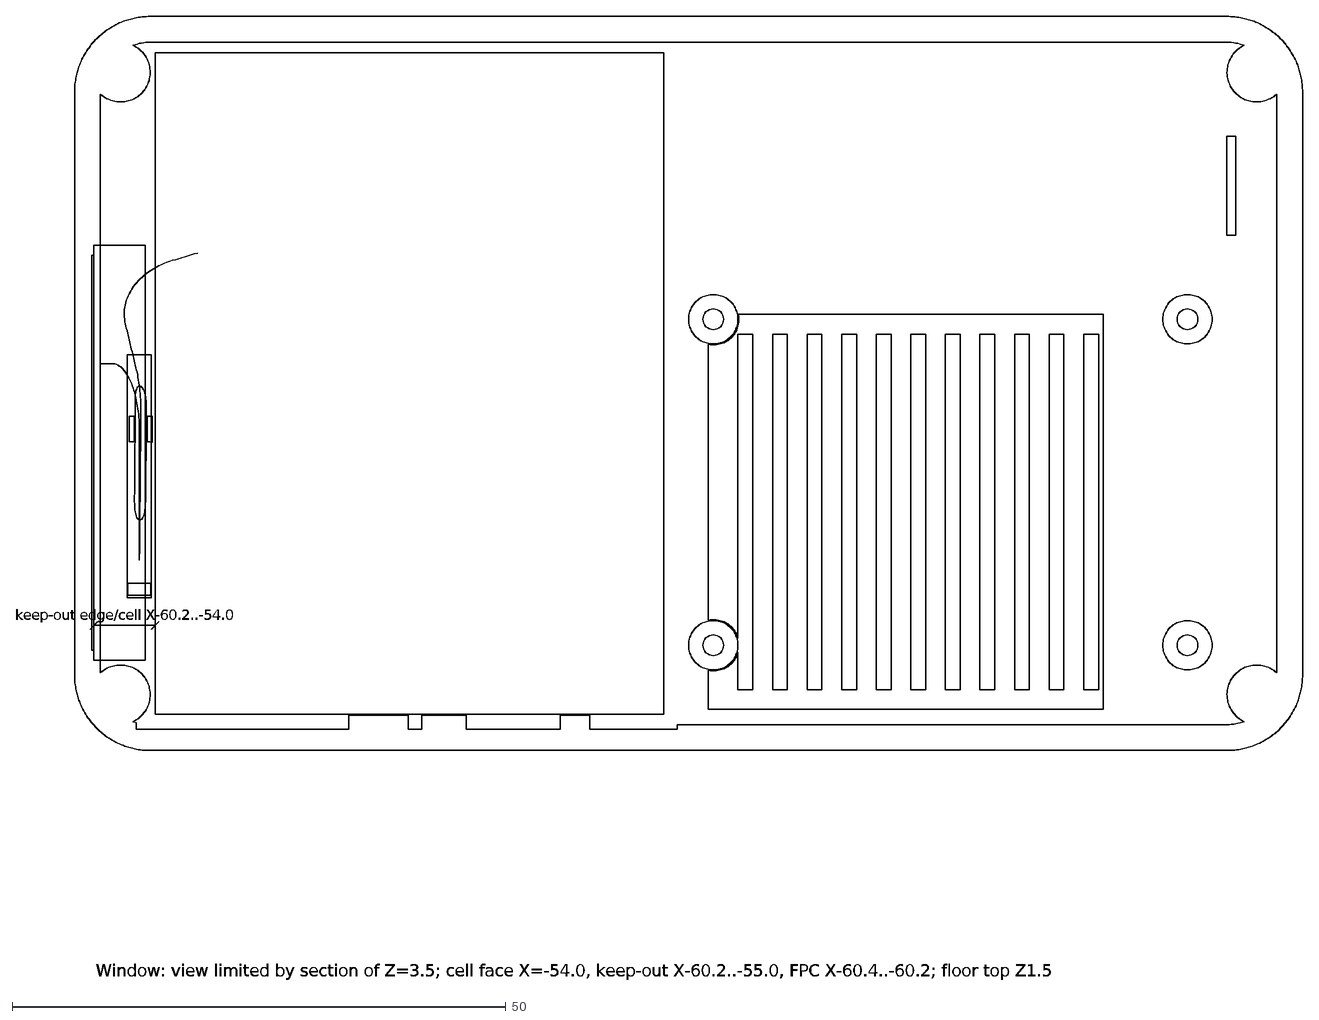
[picture p95: CAD file, 2026-10-27]
mechanical/release_v5/drawings/slack_loop_plan_release_v5.dxf
keep-out edge/cell X-60.2..-54.0
Window: view limited by section of Z=3.5; cell face X=-54.0, keep-out X-60.2..-55.0, FPC X-60.4..-60.2; floor top Z1.5
