anand2532/PocketMate/mechanical/release_v5/step_parts/LTE_Daughterboard_PCB_release_v5.step

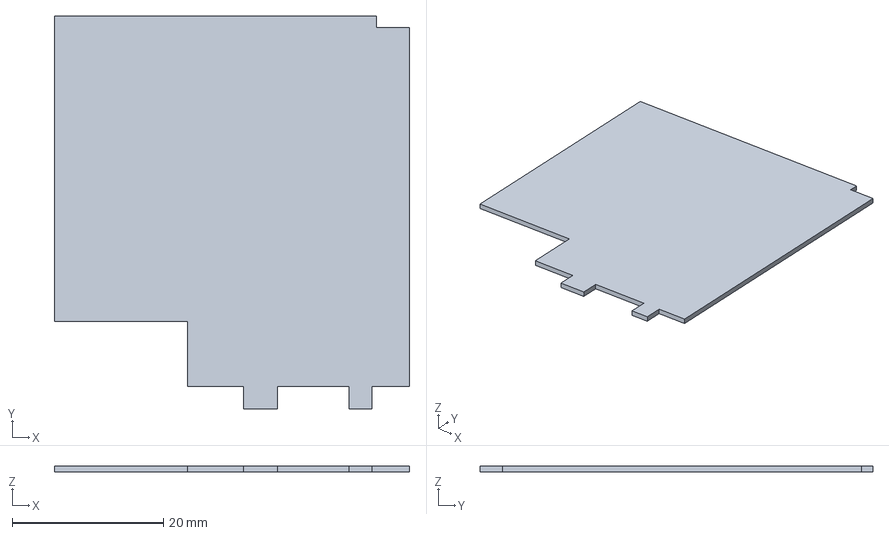
[picture p96: CAD file, 2026-10-27]
mechanical/release_v5/step_parts/LTE_Daughterboard_PCB_release_v5.step
47.0 x 52.0 x 0.8 mm
