anand2532/PocketMate/mechanical/freecad/pocketmate_sidekey_flex_v4_22c.step

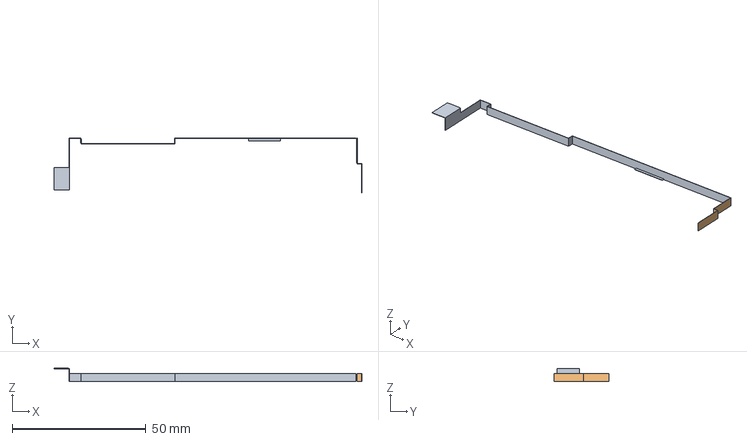
[picture p97: CAD file, 2026-10-27]
mechanical/freecad/pocketmate_sidekey_flex_v4_22c.step
115.3 x 20.5 x 4.97 mm
