anand2532/PocketMate/mechanical/release_v5/drawings/lte_daughterboard_outline_release_v5.dxf

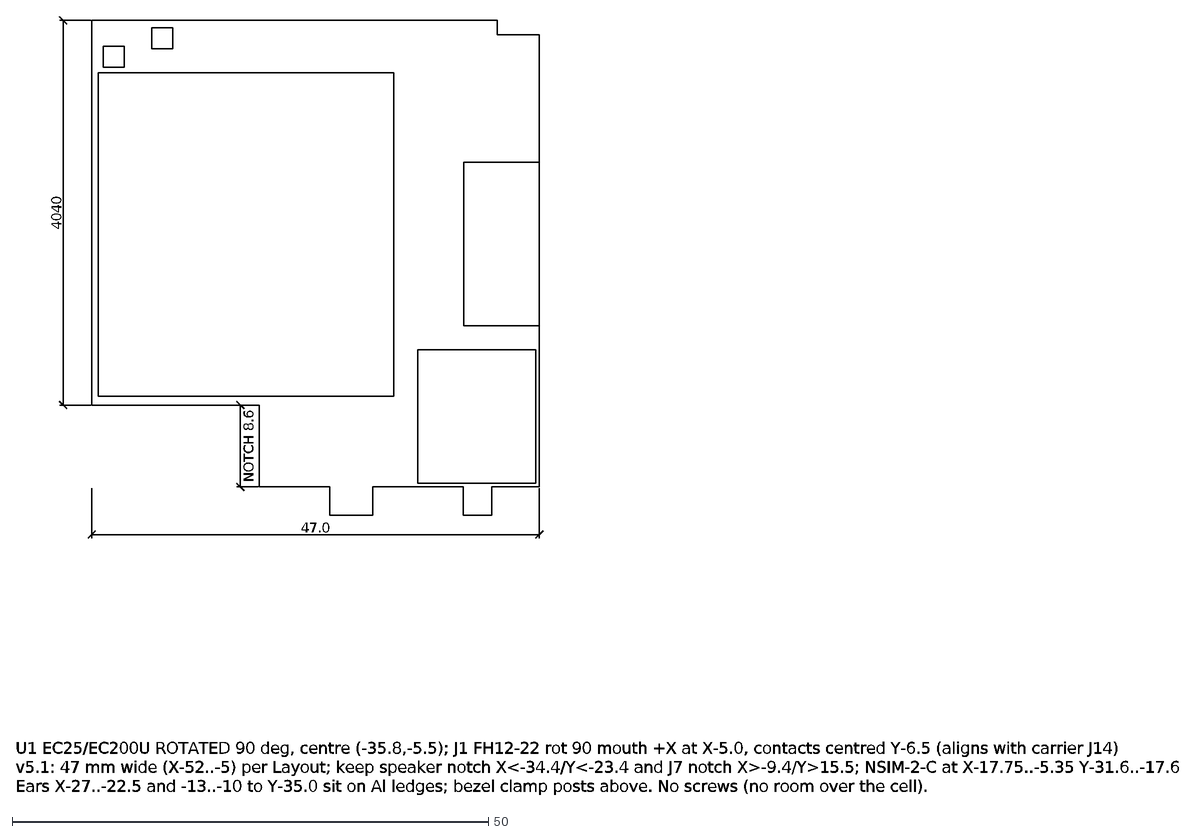
[picture p98: CAD file, 2026-10-27]
mechanical/release_v5/drawings/lte_daughterboard_outline_release_v5.dxf
47.0
4040
NOTCH 8.6
U1 EC25/EC200U ROTATED 90 deg, centre (-35.8,-5.5); J1 FH12-22 rot 90 mouth +X at X-5.0, contacts centred Y-6.5 (aligns with carrier J14)
v5.1: 47 mm wide (X-52..-5) per Layout; keep speaker notch X<-34.4/Y<-23.4 and J7 notch X>-9.4/Y>15.5; NSIM-2-C at X-17.75..-5.35 Y-31.6..-17.6
Ears X-27..-22.5 and -13..-10 to Y-35.0 sit on Al ledges; bezel clamp posts above. No screws (no room over the cell).
