anand2532/PocketMate/mechanical/freecad/pocketmate_al_unibody_v4_22c.step

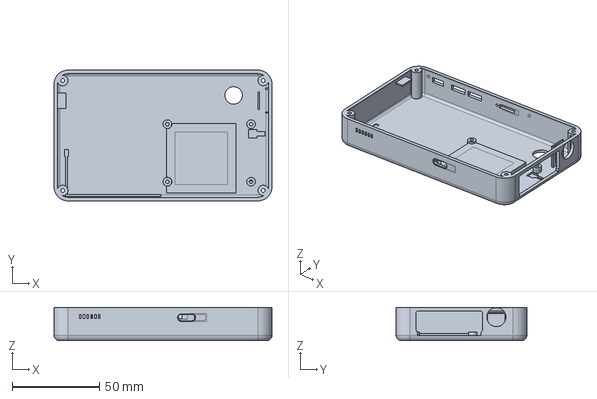
[picture p99: CAD file, 2026-10-27]
mechanical/freecad/pocketmate_al_unibody_v4_22c.step
125.0 x 75.0 x 19.0 mm
