anand2532/PocketMate/mechanical/release_v5/drawings/slack_loop_elevation_release_v5.dxf

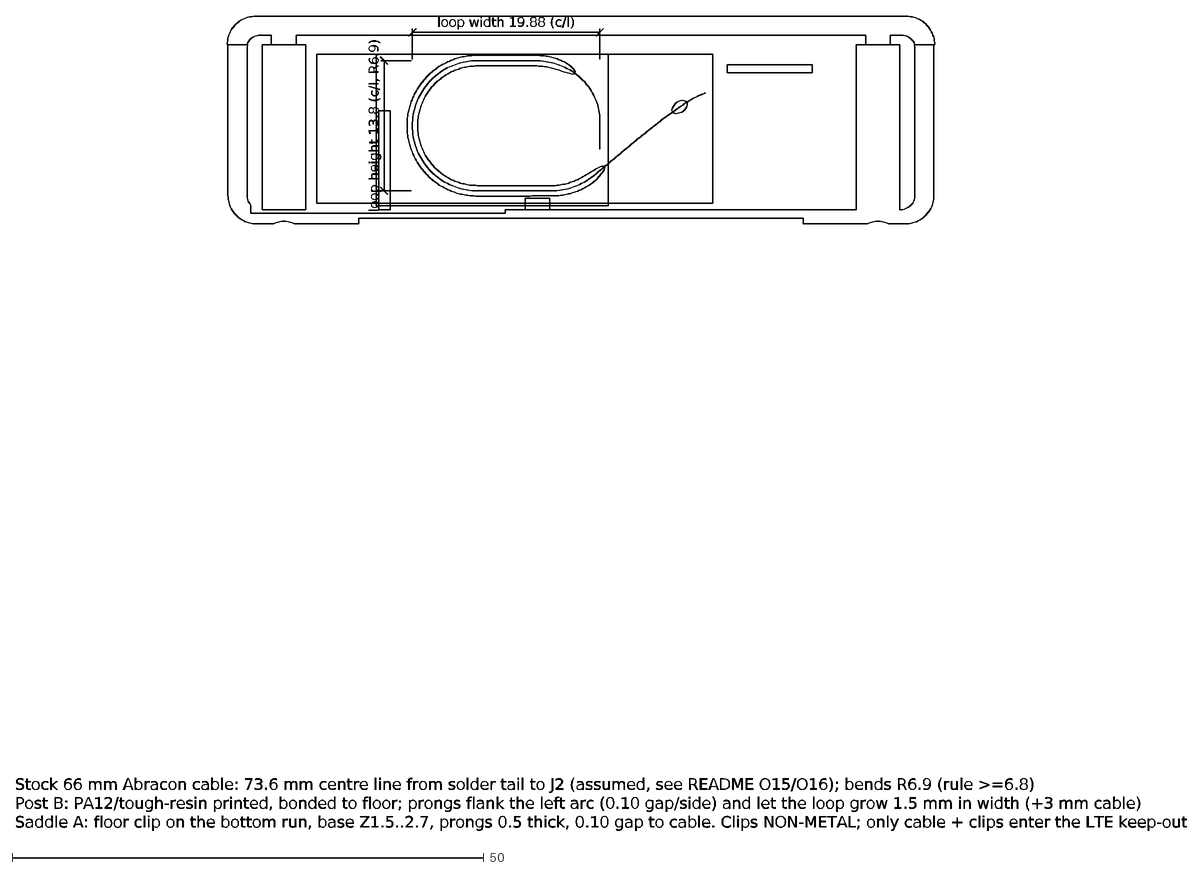
[picture p100: CAD file, 2026-10-27]
mechanical/release_v5/drawings/slack_loop_elevation_release_v5.dxf
loop width 19.88 (c/l)
loop height 13.8 (c/l, R6.9)
Stock 66 mm Abracon cable: 73.6 mm centre line from solder tail to J2 (assumed, see README O15/O16); bends R6.9 (rule >=6.8)
Post B: PA12/tough-resin printed, bonded to floor; prongs flank the left arc (0.10 gap/side) and let the loop grow 1.5 mm in width (+3 mm cable)
Saddle A: floor clip on the bottom run, base Z1.5..2.7, prongs 0.5 thick, 0.10 gap to cable. Clips NON-METAL; only cable + clips enter the LTE keep-out
