anand2532/PocketMate/mechanical/release_v5/step_parts/Liner_PET_Proto_release_v5.step

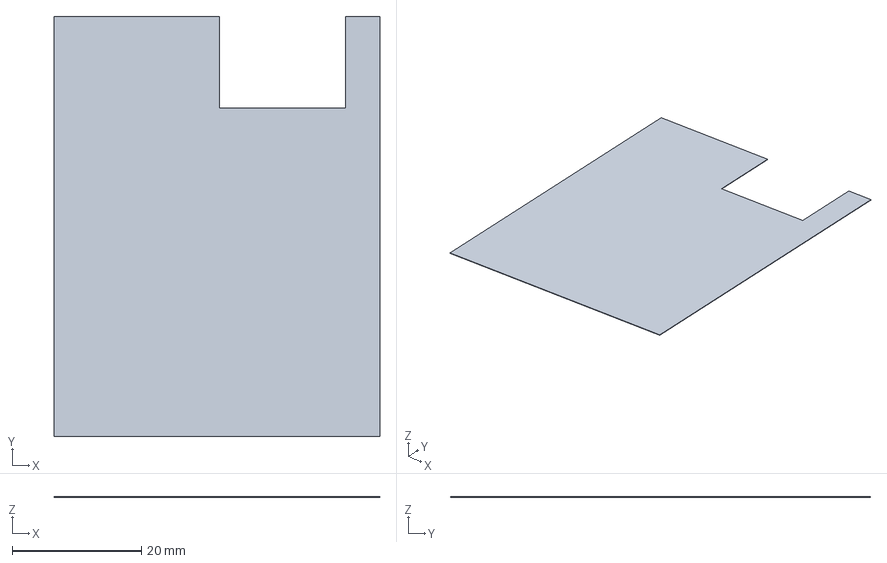
[picture p101: CAD file, 2026-10-27]
mechanical/release_v5/step_parts/Liner_PET_Proto_release_v5.step
50.5 x 65.1 x 0.1 mm
