anand2532/PocketMate/mechanical/release_v5/drawings/window_RFWindow_GNSS_TL_PC_release_v5.dxf

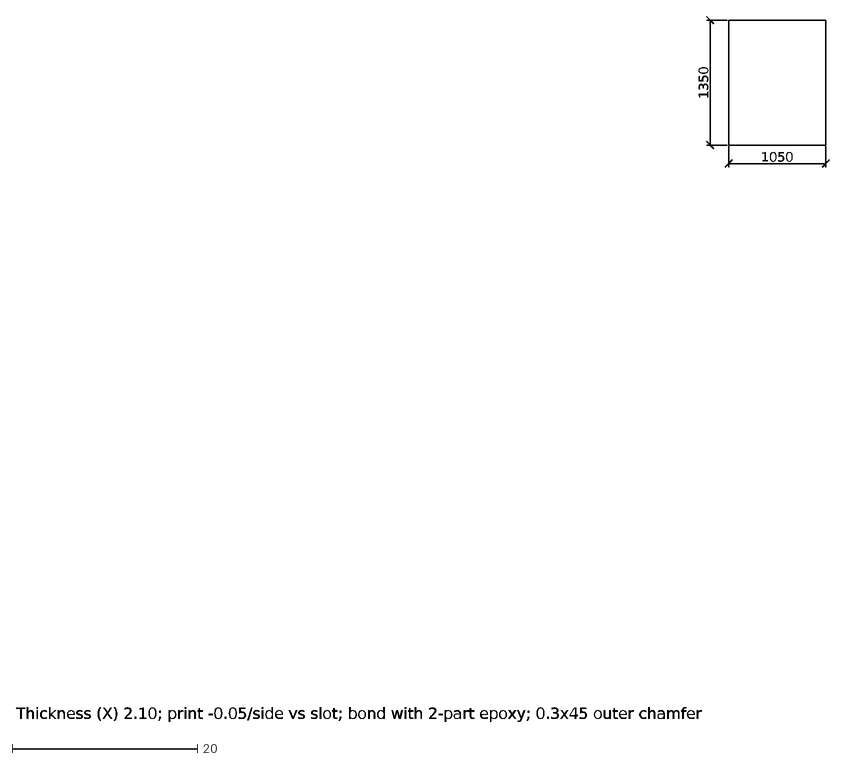
[picture p102: CAD file, 2026-10-27]
mechanical/release_v5/drawings/window_RFWindow_GNSS_TL_PC_release_v5.dxf
1050
1350
Thickness (X) 2.10; print -0.05/side vs slot; bond with 2-part epoxy; 0.3x45 outer chamfer
