anand2532/PocketMate/mechanical/release_v5/step_parts/RFWindow_PC_release_v5.step

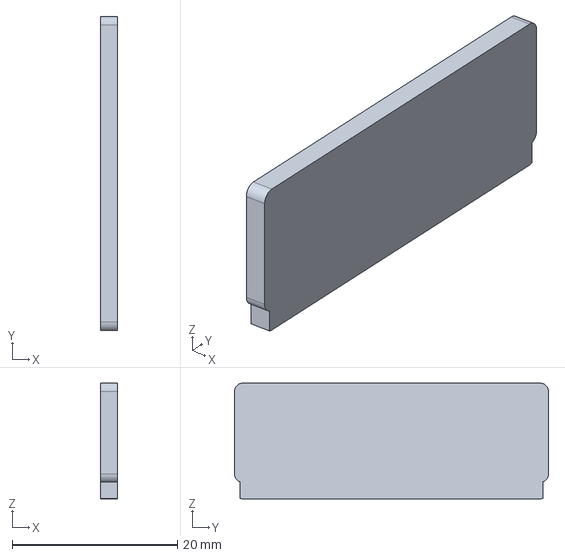
[picture p103: CAD file, 2026-10-27]
mechanical/release_v5/step_parts/RFWindow_PC_release_v5.step
2.00 x 38.0 x 14.0 mm
