anand2532/PocketMate/mechanical/freecad/pocketmate_back_frame_v2.step

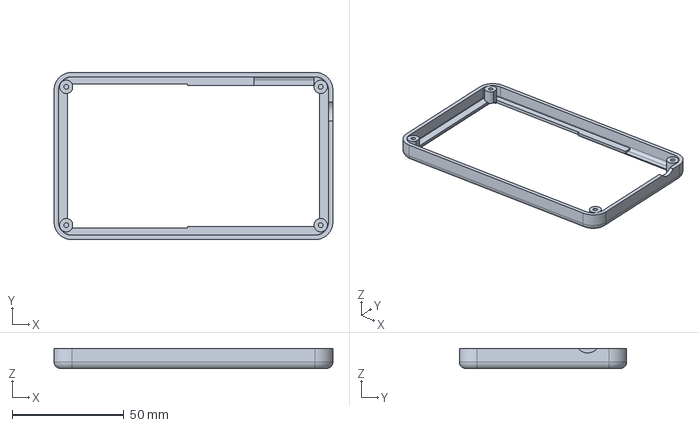
[picture p104: CAD file, 2026-10-21]
mechanical/freecad/pocketmate_back_frame_v2.step
125.0 x 75.0 x 9.00 mm
