anand2532/PocketMate/mechanical/release_v5/drawings/window_RFWindow_PC_release_v5.dxf

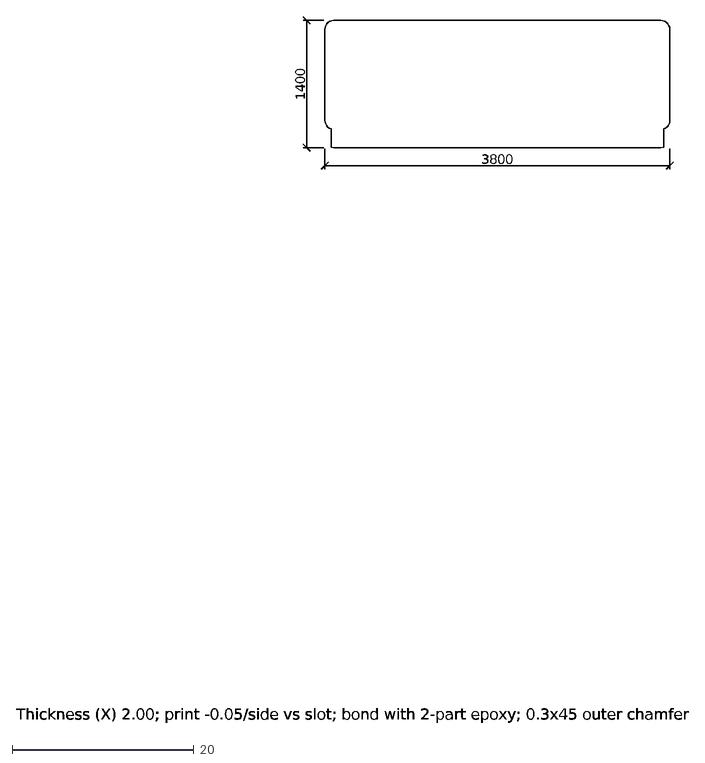
[picture p105: CAD file, 2026-10-27]
mechanical/release_v5/drawings/window_RFWindow_PC_release_v5.dxf
3800
1400
Thickness (X) 2.00; print -0.05/side vs slot; bond with 2-part epoxy; 0.3x45 outer chamfer
