anand2532/PocketMate/mechanical/release_v5/step_parts/LTE_Flex_22P_release_v5.step

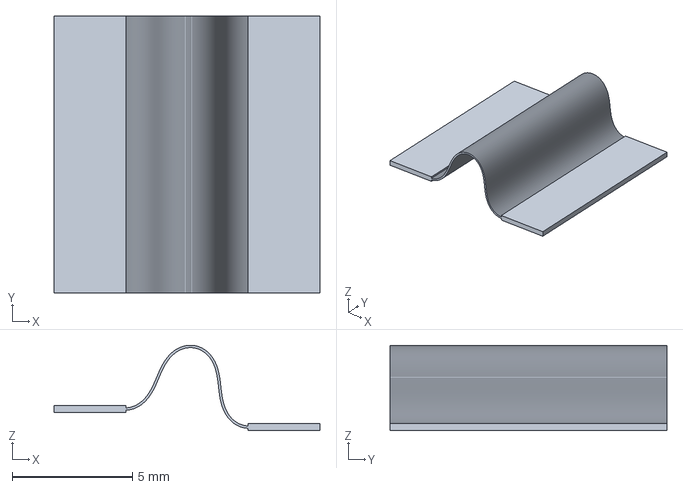
[picture p106: CAD file, 2026-10-27]
mechanical/release_v5/step_parts/LTE_Flex_22P_release_v5.step
11.1 x 11.5 x 3.55 mm
