anand2532/PocketMate/mechanical/freecad/pocketmate_al_back_plate_v2.step

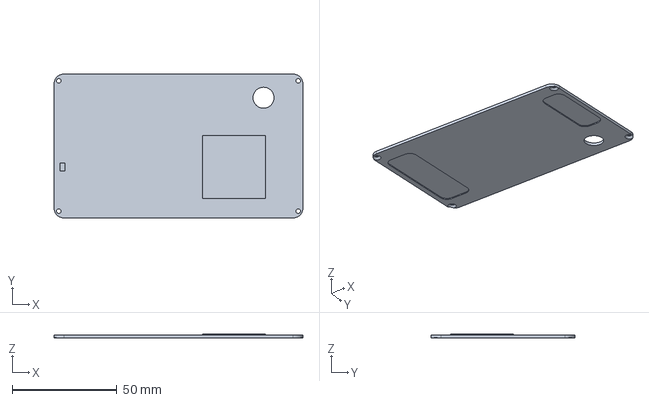
[picture p107: CAD file, 2026-10-21]
mechanical/freecad/pocketmate_al_back_plate_v2.step
118.6 x 68.6 x 2.00 mm
