anand2532/PocketMate/mechanical/release_v5/drawings/flat_Foam_Proto_2p0_release_v5.dxf

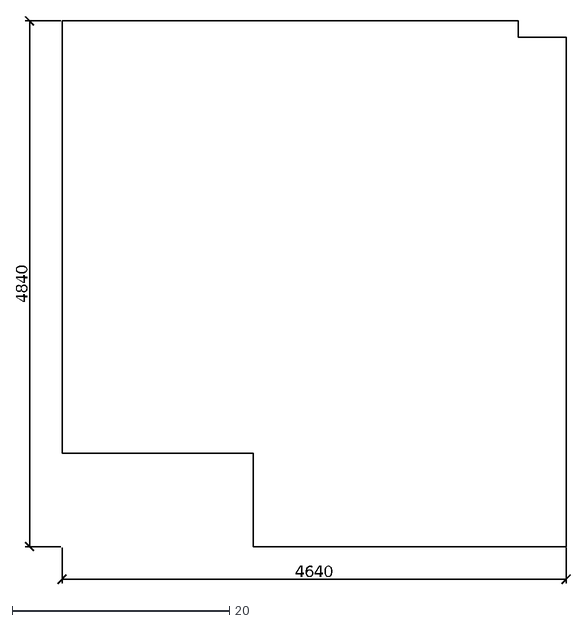
[picture p108: CAD file, 2026-10-27]
mechanical/release_v5/drawings/flat_Foam_Proto_2p0_release_v5.dxf
4640
4840
