anand2532/PocketMate/mechanical/release_v5/step_parts/Foam_Prod_0p5_release_v5.step

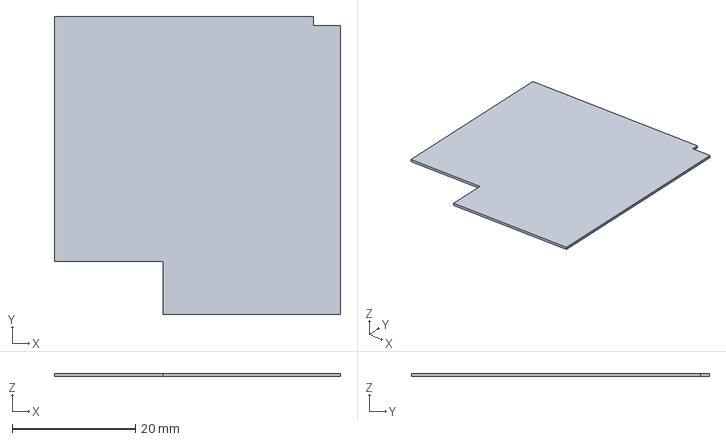
[picture p109: CAD file, 2026-10-27]
mechanical/release_v5/step_parts/Foam_Prod_0p5_release_v5.step
46.4 x 48.4 x 0.5 mm
