anand2532/PocketMate/mechanical/freecad/pocketmate_inserts_v2.step

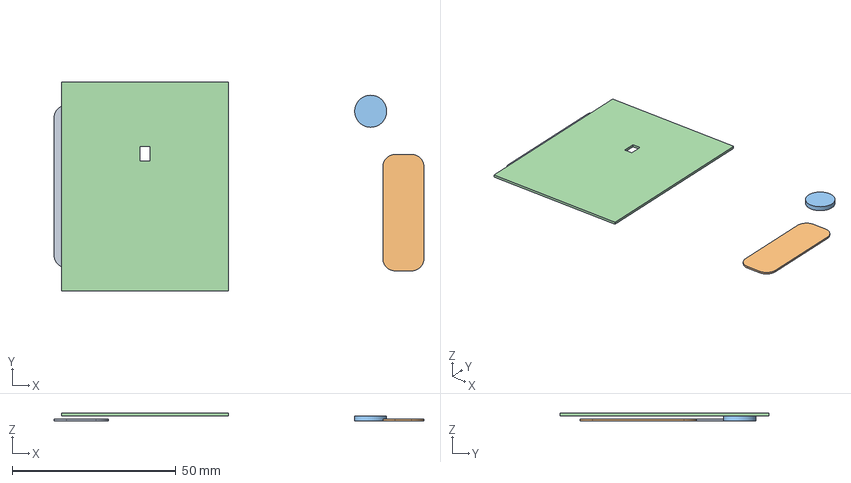
[picture p110: CAD file, 2026-10-21]
mechanical/freecad/pocketmate_inserts_v2.step
113.1 x 64.0 x 2.30 mm
GripInlay_L
GripInlay_R
CameraWindow_PC
BattPad_NTCpocket
