anand2532/PocketMate/mechanical/release_v5/drawings/flat_ThermalPad_Shield_0p5_release_v5.dxf

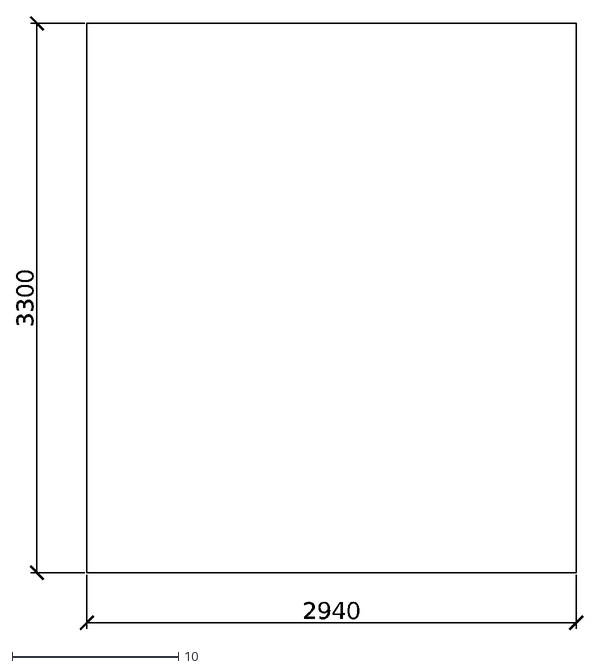
[picture p111: CAD file, 2026-10-27]
mechanical/release_v5/drawings/flat_ThermalPad_Shield_0p5_release_v5.dxf
2940
3300
