anand2532/PocketMate/mechanical/release_v5/step_parts/SideKey_Flex_release_v5.step

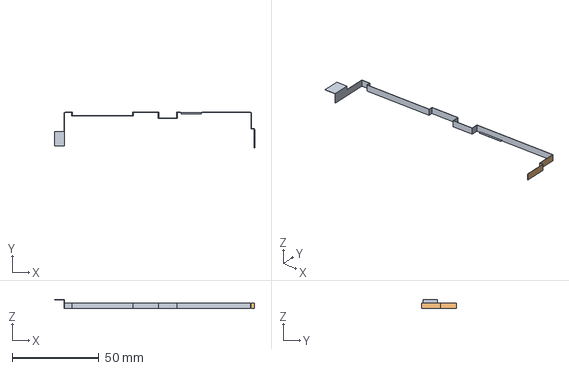
[picture p112: CAD file, 2026-10-27]
mechanical/release_v5/step_parts/SideKey_Flex_release_v5.step
115.3 x 20.5 x 4.97 mm
