anand2532/PocketMate/mechanical/release_v5/drawings/unibody_left_end_release_v5.dxf

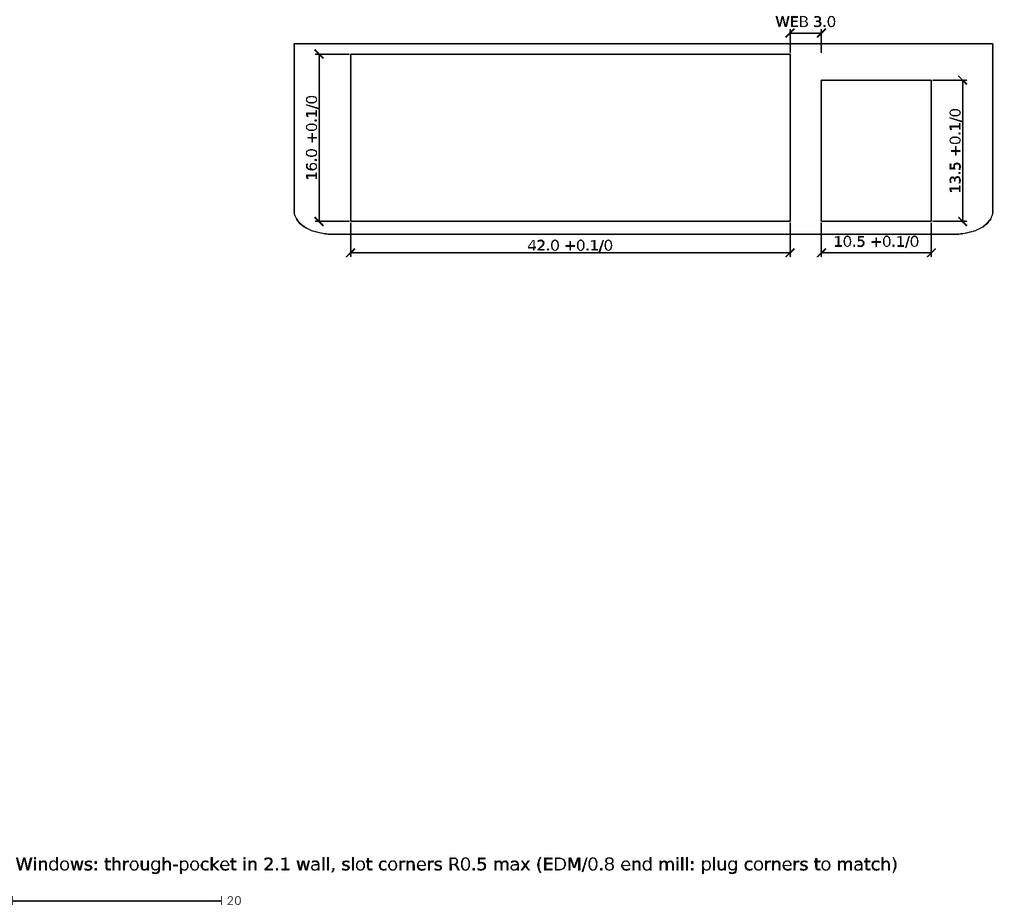
[picture p113: CAD file, 2026-10-27]
mechanical/release_v5/drawings/unibody_left_end_release_v5.dxf
42.0 +0.1/0
16.0 +0.1/0
10.5 +0.1/0
13.5 +0.1/0
WEB 3.0
Windows: through-pocket in 2.1 wall, slot corners R0.5 max (EDM/0.8 end mill: plug corners to match)
