anand2532/PocketMate/mechanical/release_v5/step_parts/GripInlay_R_release_v5.step

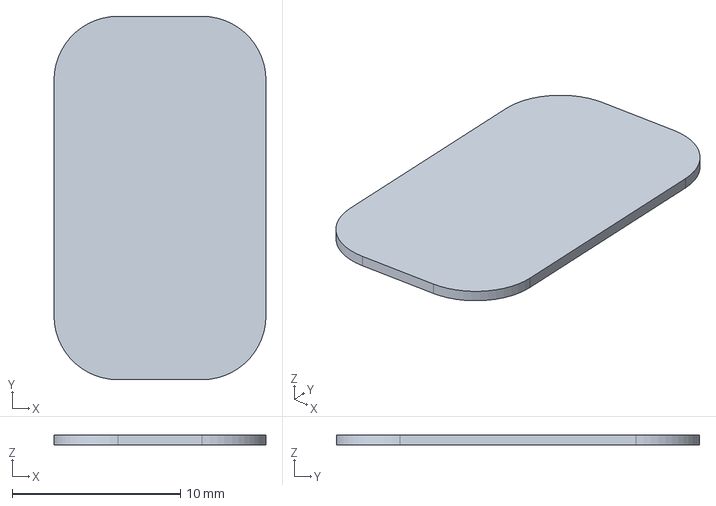
[picture p114: CAD file, 2026-10-27]
mechanical/release_v5/step_parts/GripInlay_R_release_v5.step
12.6 x 21.6 x 0.6 mm
