anand2532/PocketMate/mechanical/release_v5/drawings/unibody_right_end_release_v5.dxf

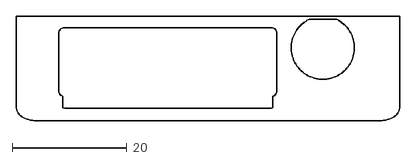
[picture p115: CAD file, 2026-10-27]
mechanical/release_v5/drawings/unibody_right_end_release_v5.dxf
66.7 x 18.2
