anand2532/PocketMate/mechanical/release_v5/step_parts/Clip_Slack_Post_B_release_v5.step

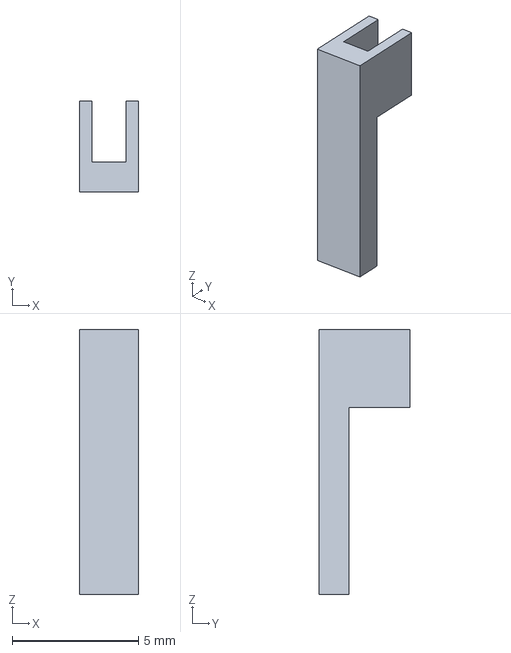
[picture p116: CAD file, 2026-10-27]
mechanical/release_v5/step_parts/Clip_Slack_Post_B_release_v5.step
2.33 x 3.62 x 10.5 mm
