anand2532/PocketMate/mechanical/freecad/pocketmate_front_shell_v2.step

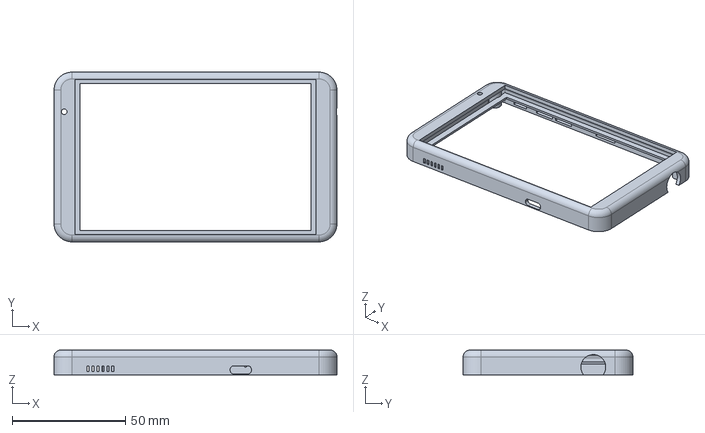
[picture p117: CAD file, 2026-10-21]
mechanical/freecad/pocketmate_front_shell_v2.step
125.0 x 75.0 x 11.0 mm
