anand2532/PocketMate/mechanical/release_v5/drawings/unibody_plan_sections_release_v5.dxf

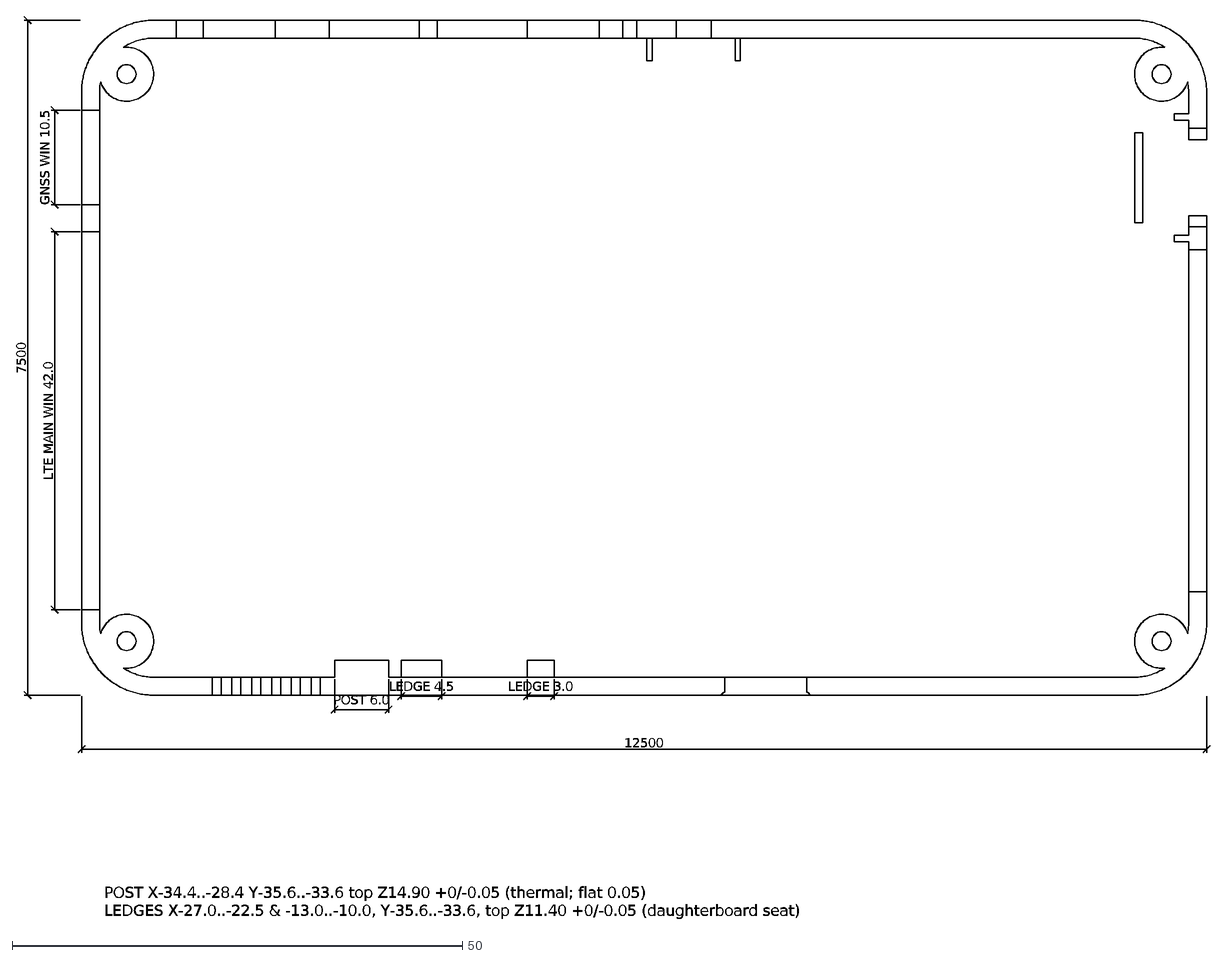
[picture p118: CAD file, 2026-10-27]
mechanical/release_v5/drawings/unibody_plan_sections_release_v5.dxf
12500
7500
POST 6.0
LEDGE 4.5
LEDGE 3.0
LTE MAIN WIN 42.0
GNSS WIN 10.5
POST X-34.4..-28.4 Y-35.6..-33.6 top Z14.90 +0/-0.05 (thermal; flat 0.05)
LEDGES X-27.0..-22.5 & -13.0..-10.0, Y-35.6..-33.6, top Z11.40 +0/-0.05 (daughterboard seat)
