anand2532/PocketMate/mechanical/release_v5/step_parts/CameraWindow_PC_release_v5.step

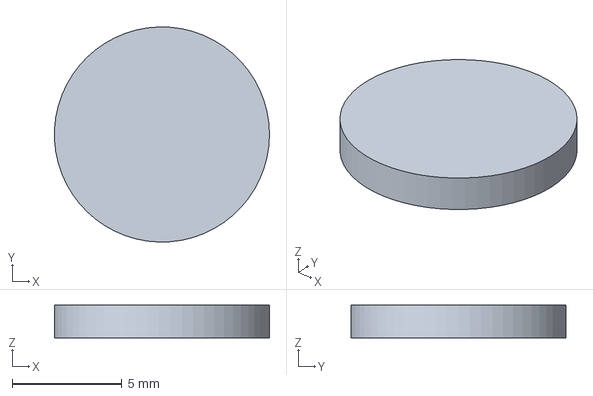
[picture p119: CAD file, 2026-10-27]
mechanical/release_v5/step_parts/CameraWindow_PC_release_v5.step
9.79 x 9.80 x 1.50 mm
