anand2532/PocketMate/mechanical/release_v5/drawings/flat_ThermalPad_Post_0p3_release_v5.dxf

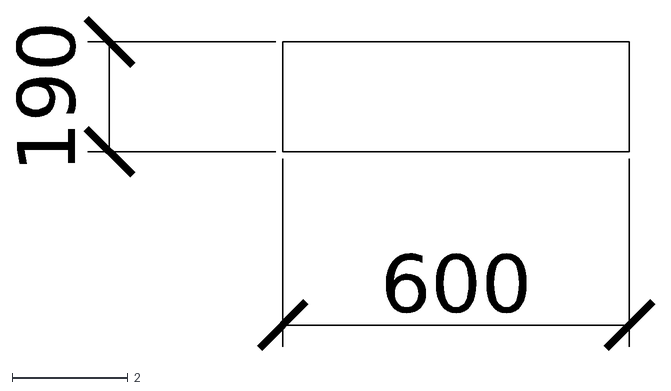
[picture p120: CAD file, 2026-10-27]
mechanical/release_v5/drawings/flat_ThermalPad_Post_0p3_release_v5.dxf
600
190
