anand2532/PocketMate/mechanical/release_v5/step_parts/Foam_Proto_2p0_release_v5.step

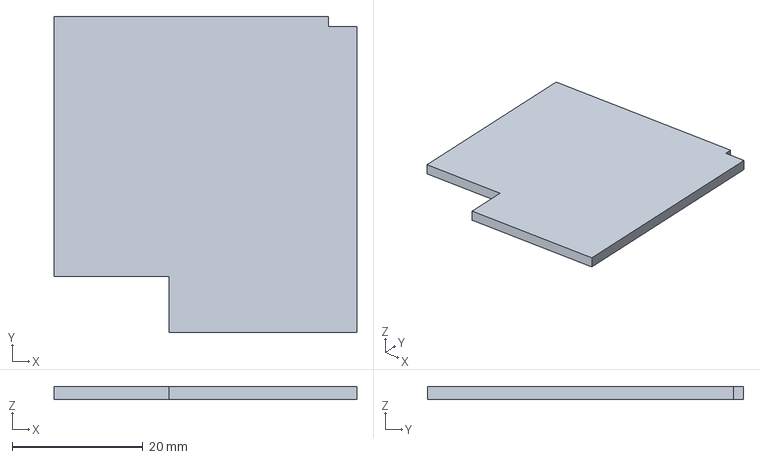
[picture p121: CAD file, 2026-10-27]
mechanical/release_v5/step_parts/Foam_Proto_2p0_release_v5.step
46.4 x 48.4 x 2.00 mm
