anand2532/PocketMate/mechanical/release_v5/drawings/bezel_plan_release_v5.dxf

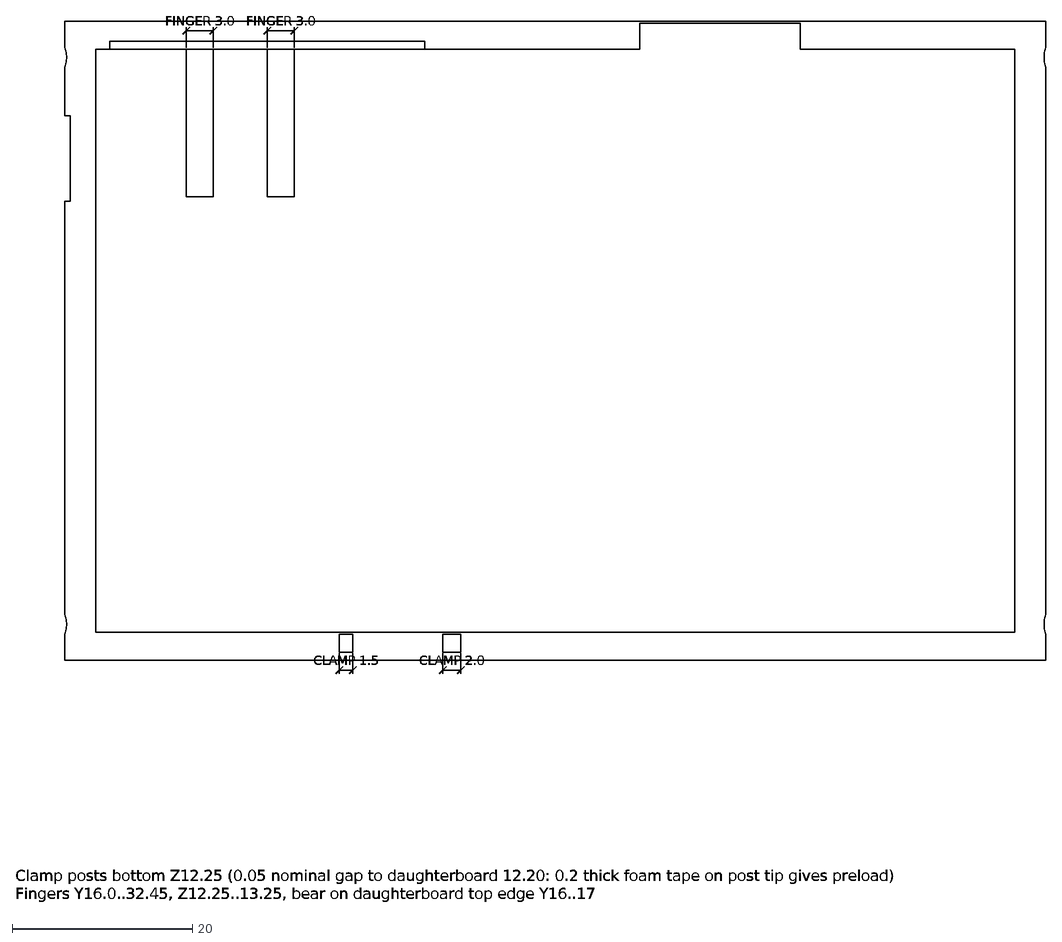
[picture p122: CAD file, 2026-10-27]
mechanical/release_v5/drawings/bezel_plan_release_v5.dxf
CLAMP 1.5
CLAMP 2.0
FINGER 3.0
Clamp posts bottom Z12.25 (0.05 nominal gap to daughterboard 12.20: 0.2 thick foam tape on post tip gives preload)
Fingers Y16.0..32.45, Z12.25..13.25, bear on daughterboard top edge Y16..17
