anand2532/PocketMate/mechanical/release_v5/step_parts/Bezel_DisplayFrame_PC_release_v5.step

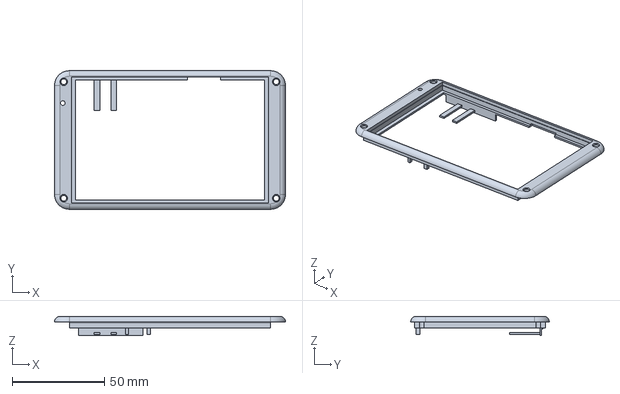
[picture p123: CAD file, 2026-10-27]
mechanical/release_v5/step_parts/Bezel_DisplayFrame_PC_release_v5.step
125.0 x 75.0 x 10.5 mm
