anand2532/PocketMate/mechanical/release_v5/step_parts/ThermalPad_Shield_0p5_release_v5.step

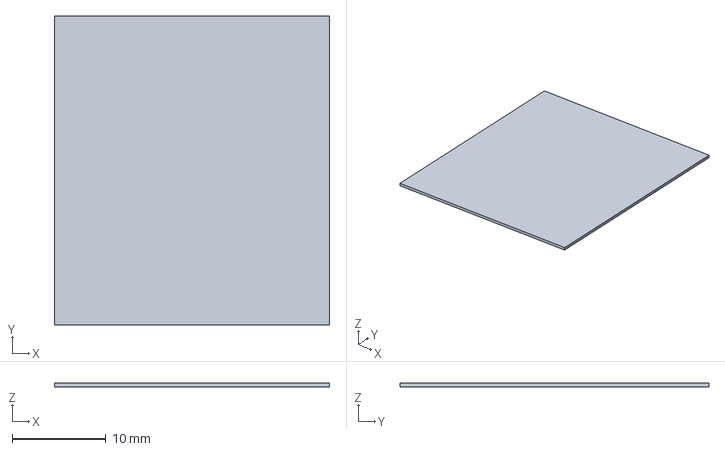
[picture p124: CAD file, 2026-10-27]
mechanical/release_v5/step_parts/ThermalPad_Shield_0p5_release_v5.step
29.4 x 33.0 x 0.4 mm
