anand2532/PocketMate/mechanical/release_v5/drawings/flat_Liner_PET_Prod_release_v5.dxf

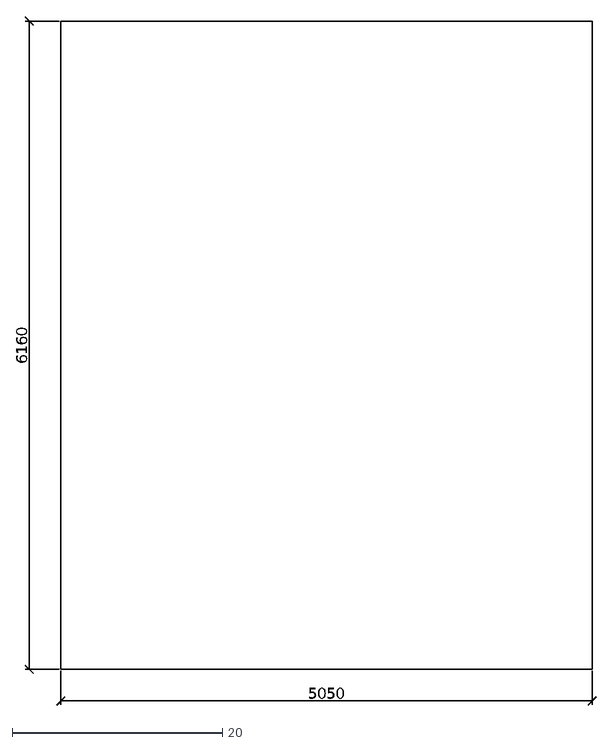
[picture p125: CAD file, 2026-10-27]
mechanical/release_v5/drawings/flat_Liner_PET_Prod_release_v5.dxf
5050
6160
