anand2532/PocketMate/mechanical/release_v5/step_parts/HeatSpreader_Cu_0p5_release_v5.step

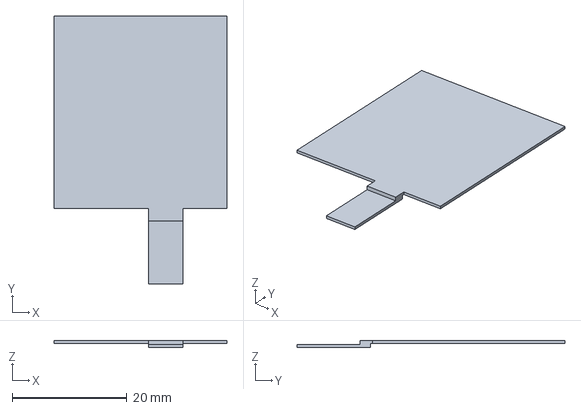
[picture p126: CAD file, 2026-10-27]
mechanical/release_v5/step_parts/HeatSpreader_Cu_0p5_release_v5.step
30.2 x 46.8 x 1.20 mm
