anand2532/PocketMate/mechanical/release_v5/drawings/unibody_bottom_wall_release_v5.dxf

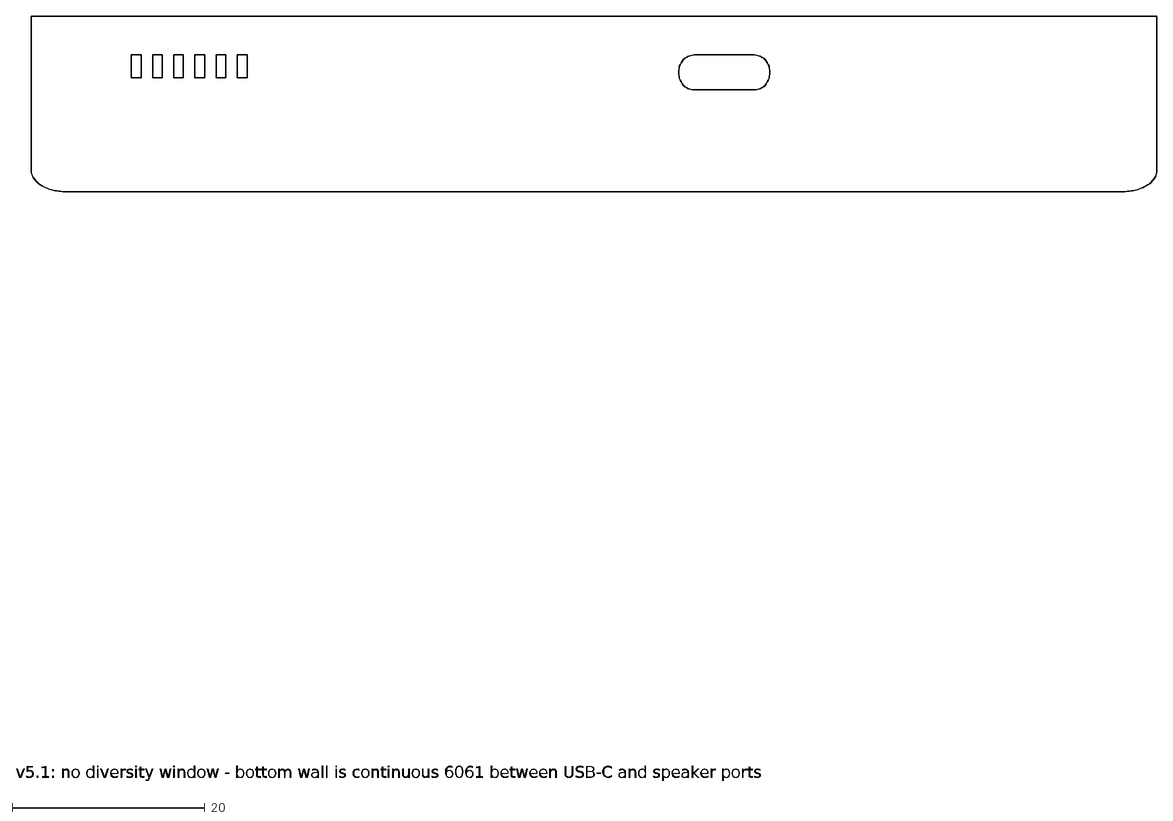
[picture p127: CAD file, 2026-10-27]
mechanical/release_v5/drawings/unibody_bottom_wall_release_v5.dxf
v5.1: no diversity window - bottom wall is continuous 6061 between USB-C and speaker ports
