anand2532/PocketMate/mechanical/release_v5/drawings/flat_Liner_PET_Proto_release_v5.dxf

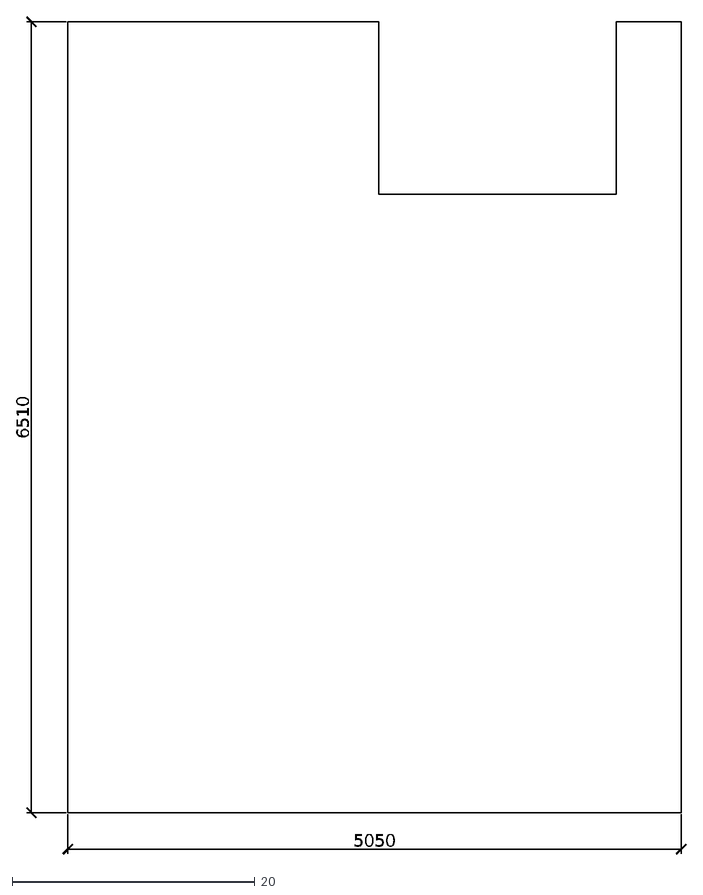
[picture p129: CAD file, 2026-10-27]
mechanical/release_v5/drawings/flat_Liner_PET_Proto_release_v5.dxf
5050
6510
