anand2532/PocketMate/mechanical/release_v5/step_parts/GripInlay_L_release_v5.step

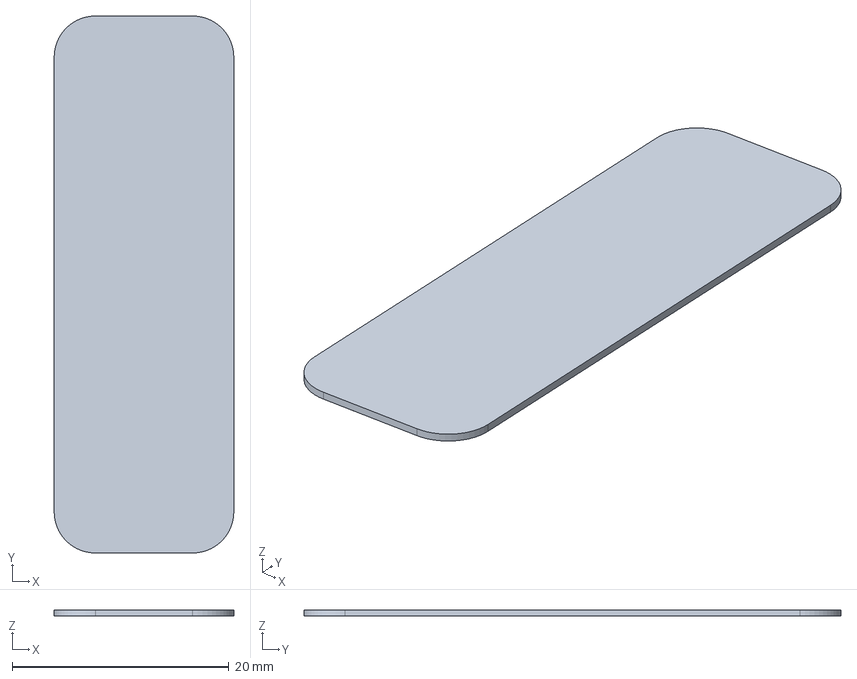
[picture p130: CAD file, 2026-10-27]
mechanical/release_v5/step_parts/GripInlay_L_release_v5.step
16.6 x 49.6 x 0.6 mm
