anand2532/PocketMate/mechanical/release_v5/drawings/flat_HeatSpreader_Cu_0p5_release_v5.dxf

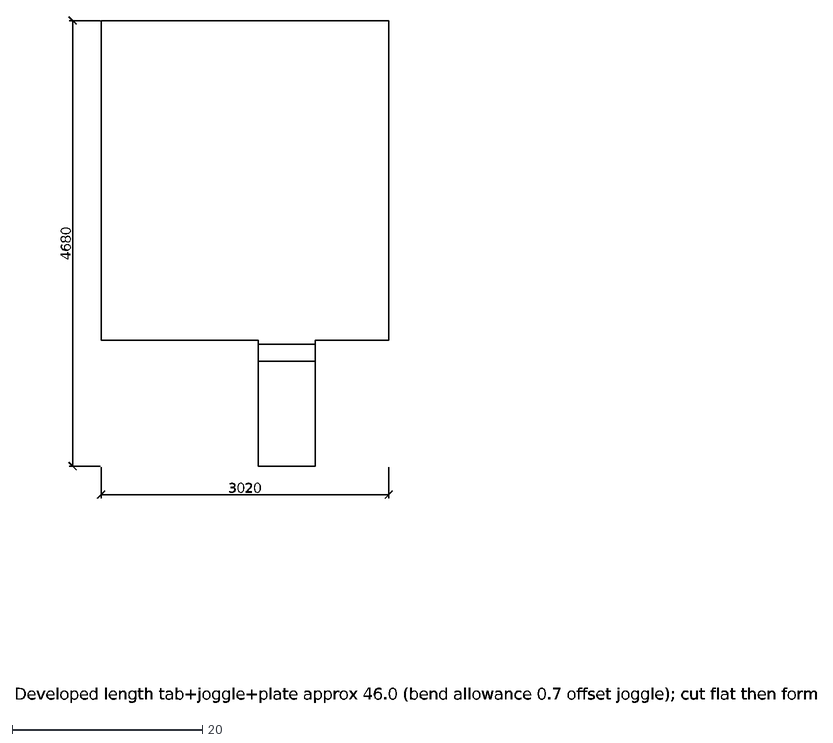
[picture p131: CAD file, 2026-10-27]
mechanical/release_v5/drawings/flat_HeatSpreader_Cu_0p5_release_v5.dxf
3020
4680
Developed length tab+joggle+plate approx 46.0 (bend allowance 0.7 offset joggle); cut flat then form
