anand2532/PocketMate/mechanical/release_v5/step_parts/RFWindow_GNSS_TL_PC_release_v5.step

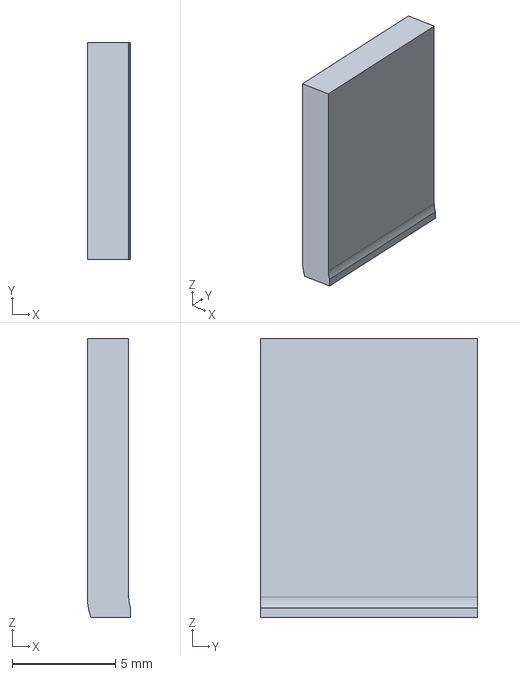
[picture p132: CAD file, 2026-10-27]
mechanical/release_v5/step_parts/RFWindow_GNSS_TL_PC_release_v5.step
2.10 x 10.5 x 13.5 mm
