anand2532/PocketMate/mechanical/release_v5/step_parts/Clip_Slack_Saddle_A_release_v5.step

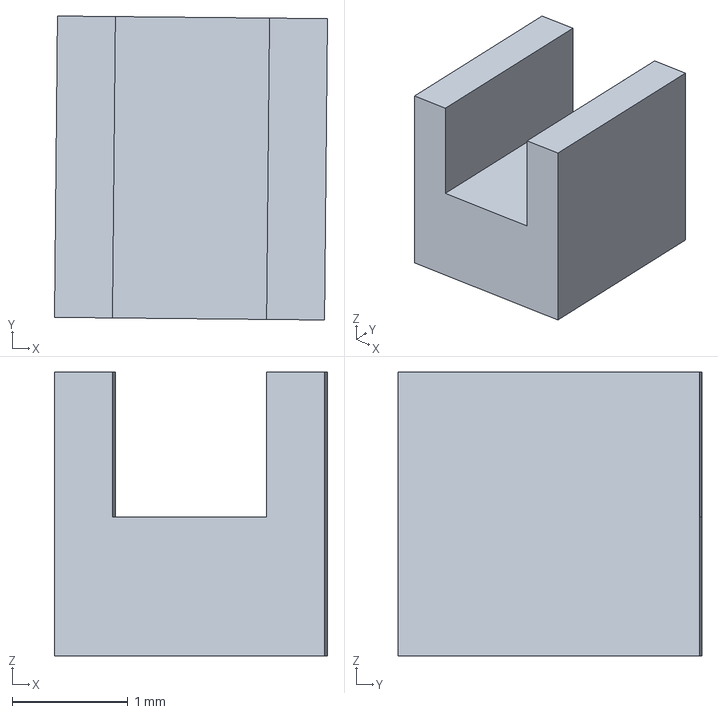
[picture p133: CAD file, 2026-10-27]
mechanical/release_v5/step_parts/Clip_Slack_Saddle_A_release_v5.step
2.36 x 2.62 x 2.45 mm
