anand2532/PocketMate/mechanical/release_v5/step_parts/Coax_GNSS_release_v5.step

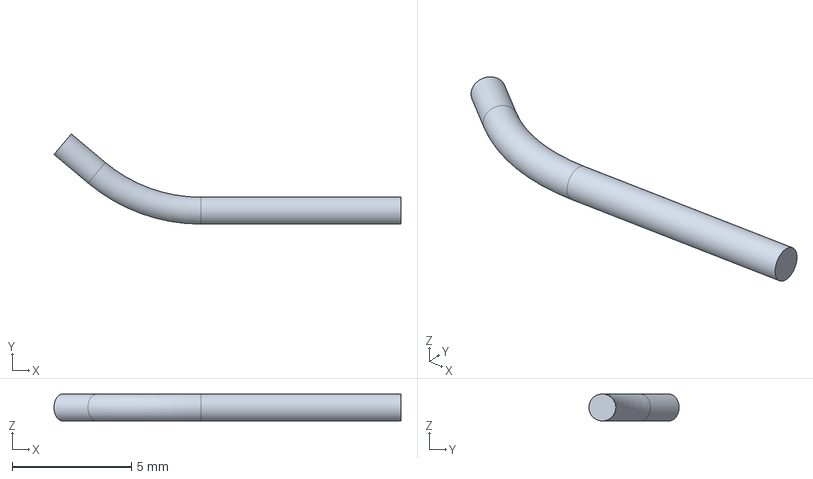
[picture p134: CAD file, 2026-10-27]
mechanical/release_v5/step_parts/Coax_GNSS_release_v5.step
14.6 x 3.79 x 1.13 mm
