anand2532/PocketMate/mechanical/release_v5/step_parts/ActionCap_PC_release_v5.step

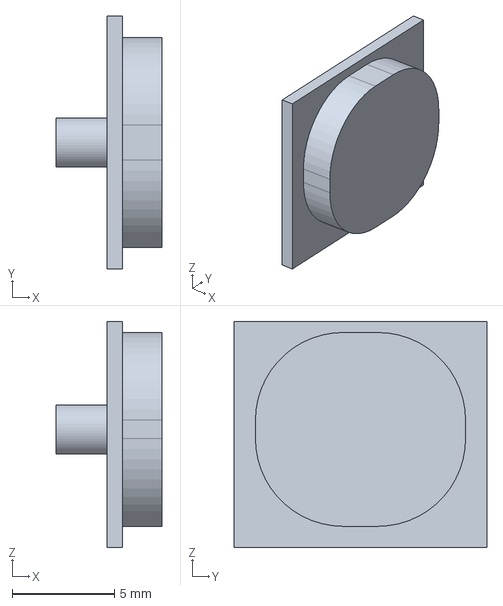
[picture p135: CAD file, 2026-10-27]
mechanical/release_v5/step_parts/ActionCap_PC_release_v5.step
5.20 x 12.4 x 11.1 mm
