anand2532/PocketMate/mechanical/release_v5/step_parts/ThermalPad_Post_0p3_release_v5.step

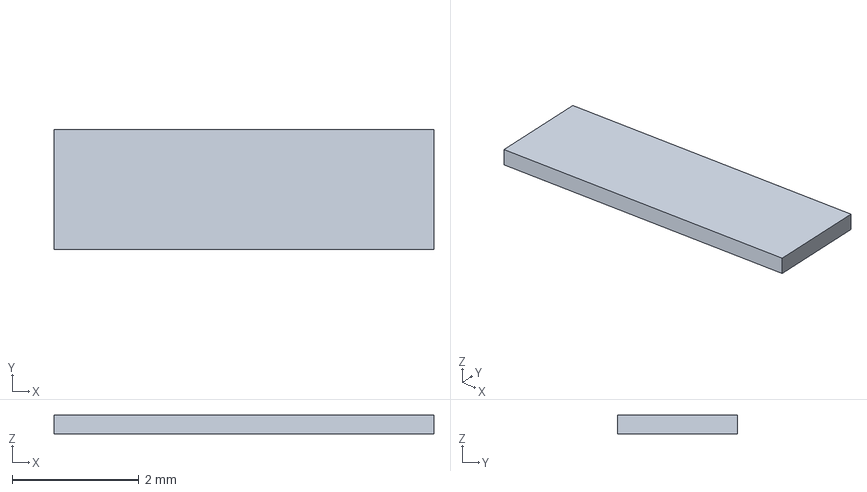
[picture p136: CAD file, 2026-10-27]
mechanical/release_v5/step_parts/ThermalPad_Post_0p3_release_v5.step
6.00 x 1.90 x 0.3 mm
