anand2532/PocketMate/mechanical/release_v5/step_parts/BattPad_NTCpocket_release_v5.step

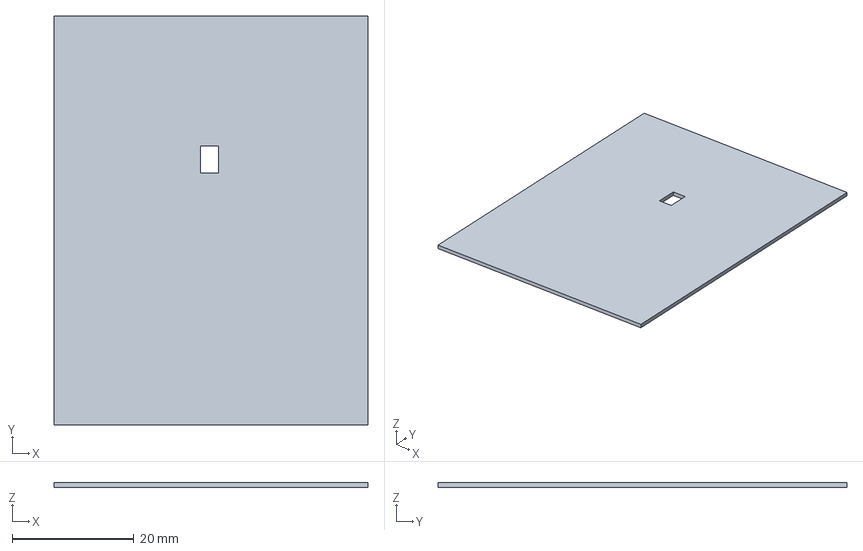
[picture p137: CAD file, 2026-10-27]
mechanical/release_v5/step_parts/BattPad_NTCpocket_release_v5.step
51.5 x 67.0 x 0.8 mm
