anand2532/PocketMate/(list of files, cad)

Other CAD files:
mechanical/freecad/pocketmate_enclosure_v4_22c.FCStd
mechanical/freecad/pocketmate_enclosure_v2.FCStd
mechanical/release_v5/stl/ActionCap_PC_release_v5.stl
mechanical/release_v5/stl/Al_Unibody_release_v5.stl
mechanical/release_v5/stl/Bezel_DisplayFrame_PC_release_v5.stl
mechanical/release_v5/stl/CameraWindow_PC_release_v5.stl
mechanical/release_v5/stl/Clip_Slack_Post_B_release_v5.stl
mechanical/release_v5/stl/Clip_Slack_Saddle_A_release_v5.stl
mechanical/release_v5/stl/GripInlay_L_release_v5.stl
mechanical/release_v5/stl/GripInlay_R_release_v5.stl
mechanical/release_v5/stl/HeatSpreader_Cu_0p5_release_v5.stl
mechanical/release_v5/stl/LTE_Daughterboard_PCB_release_v5.stl
mechanical/release_v5/stl/RFWindow_GNSS_TL_PC_release_v5.stl
mechanical/release_v5/stl/RFWindow_LTE_Main_L_PC_release_v5.stl
mechanical/release_v5/stl/RFWindow_PC_release_v5.stl
