anand2532/PocketMate/design/png/09-ocr-result.png

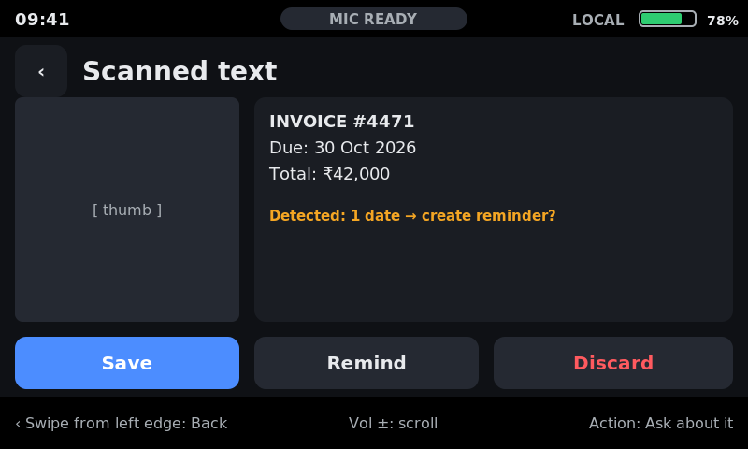
design/png/09-ocr-result.png
