anand2532/PocketMate/design/png/09b-photo-result.png

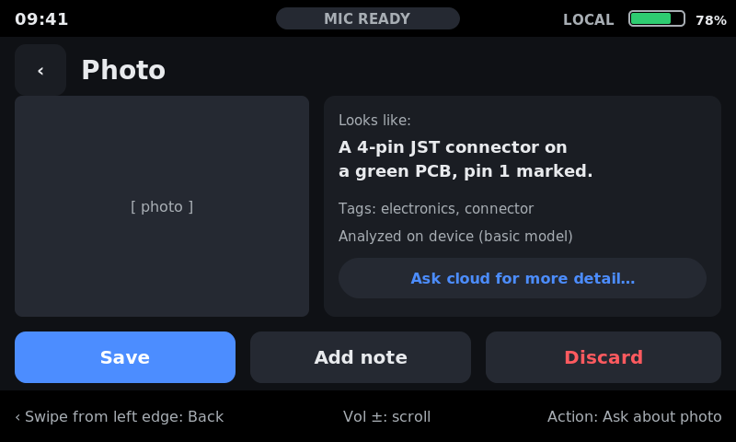
design/png/09b-photo-result.png
