anand2532/PocketMate/hardware/kicad/PocketMate.pdf

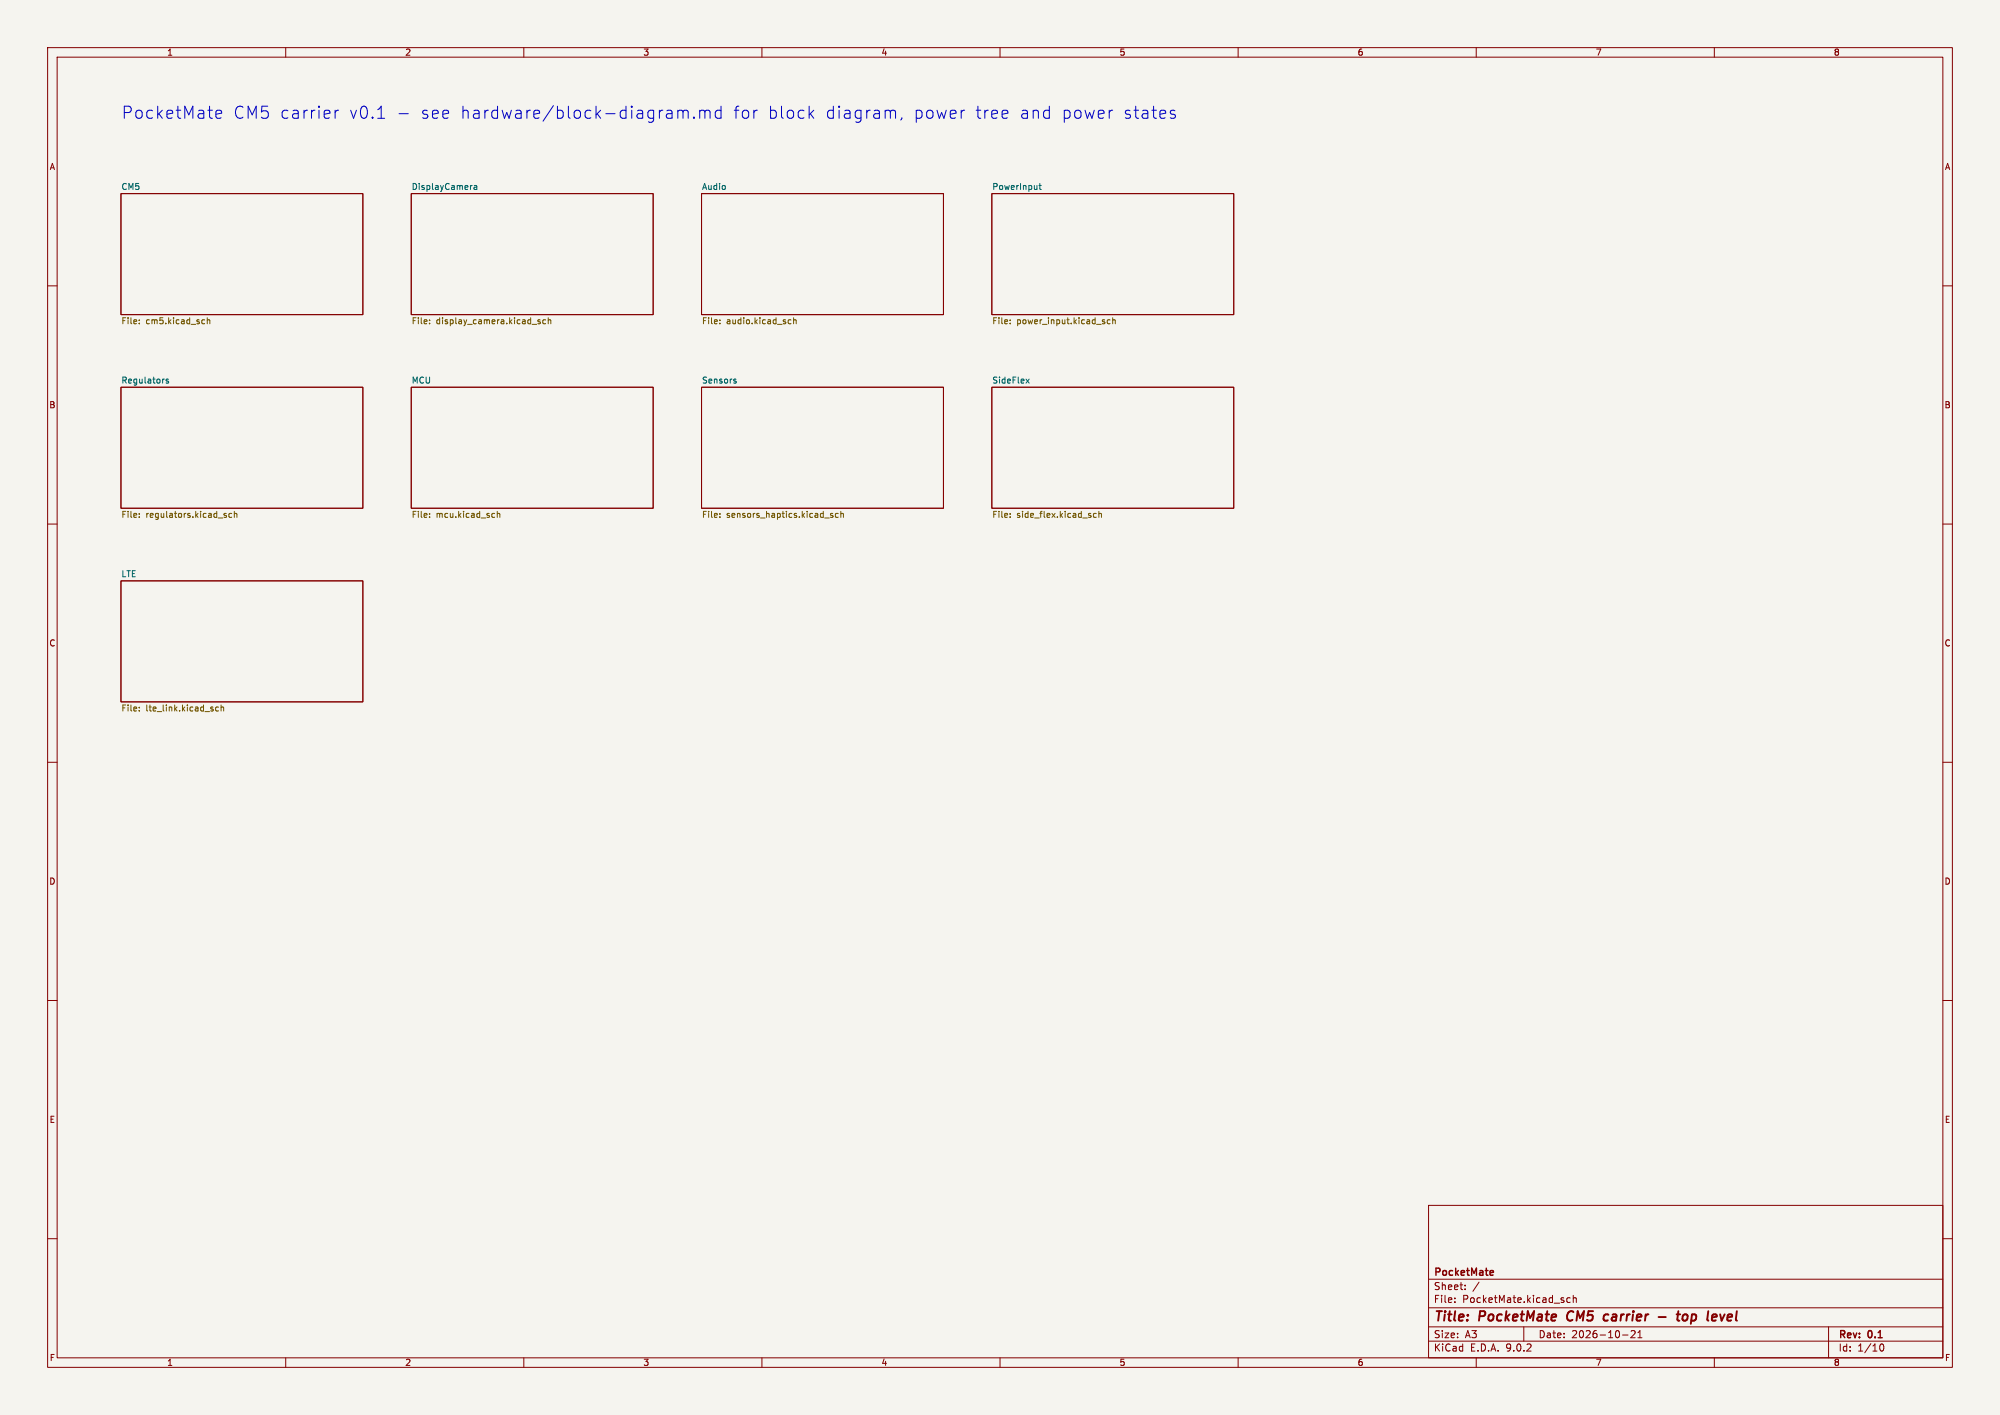
[picture p140: page 1]

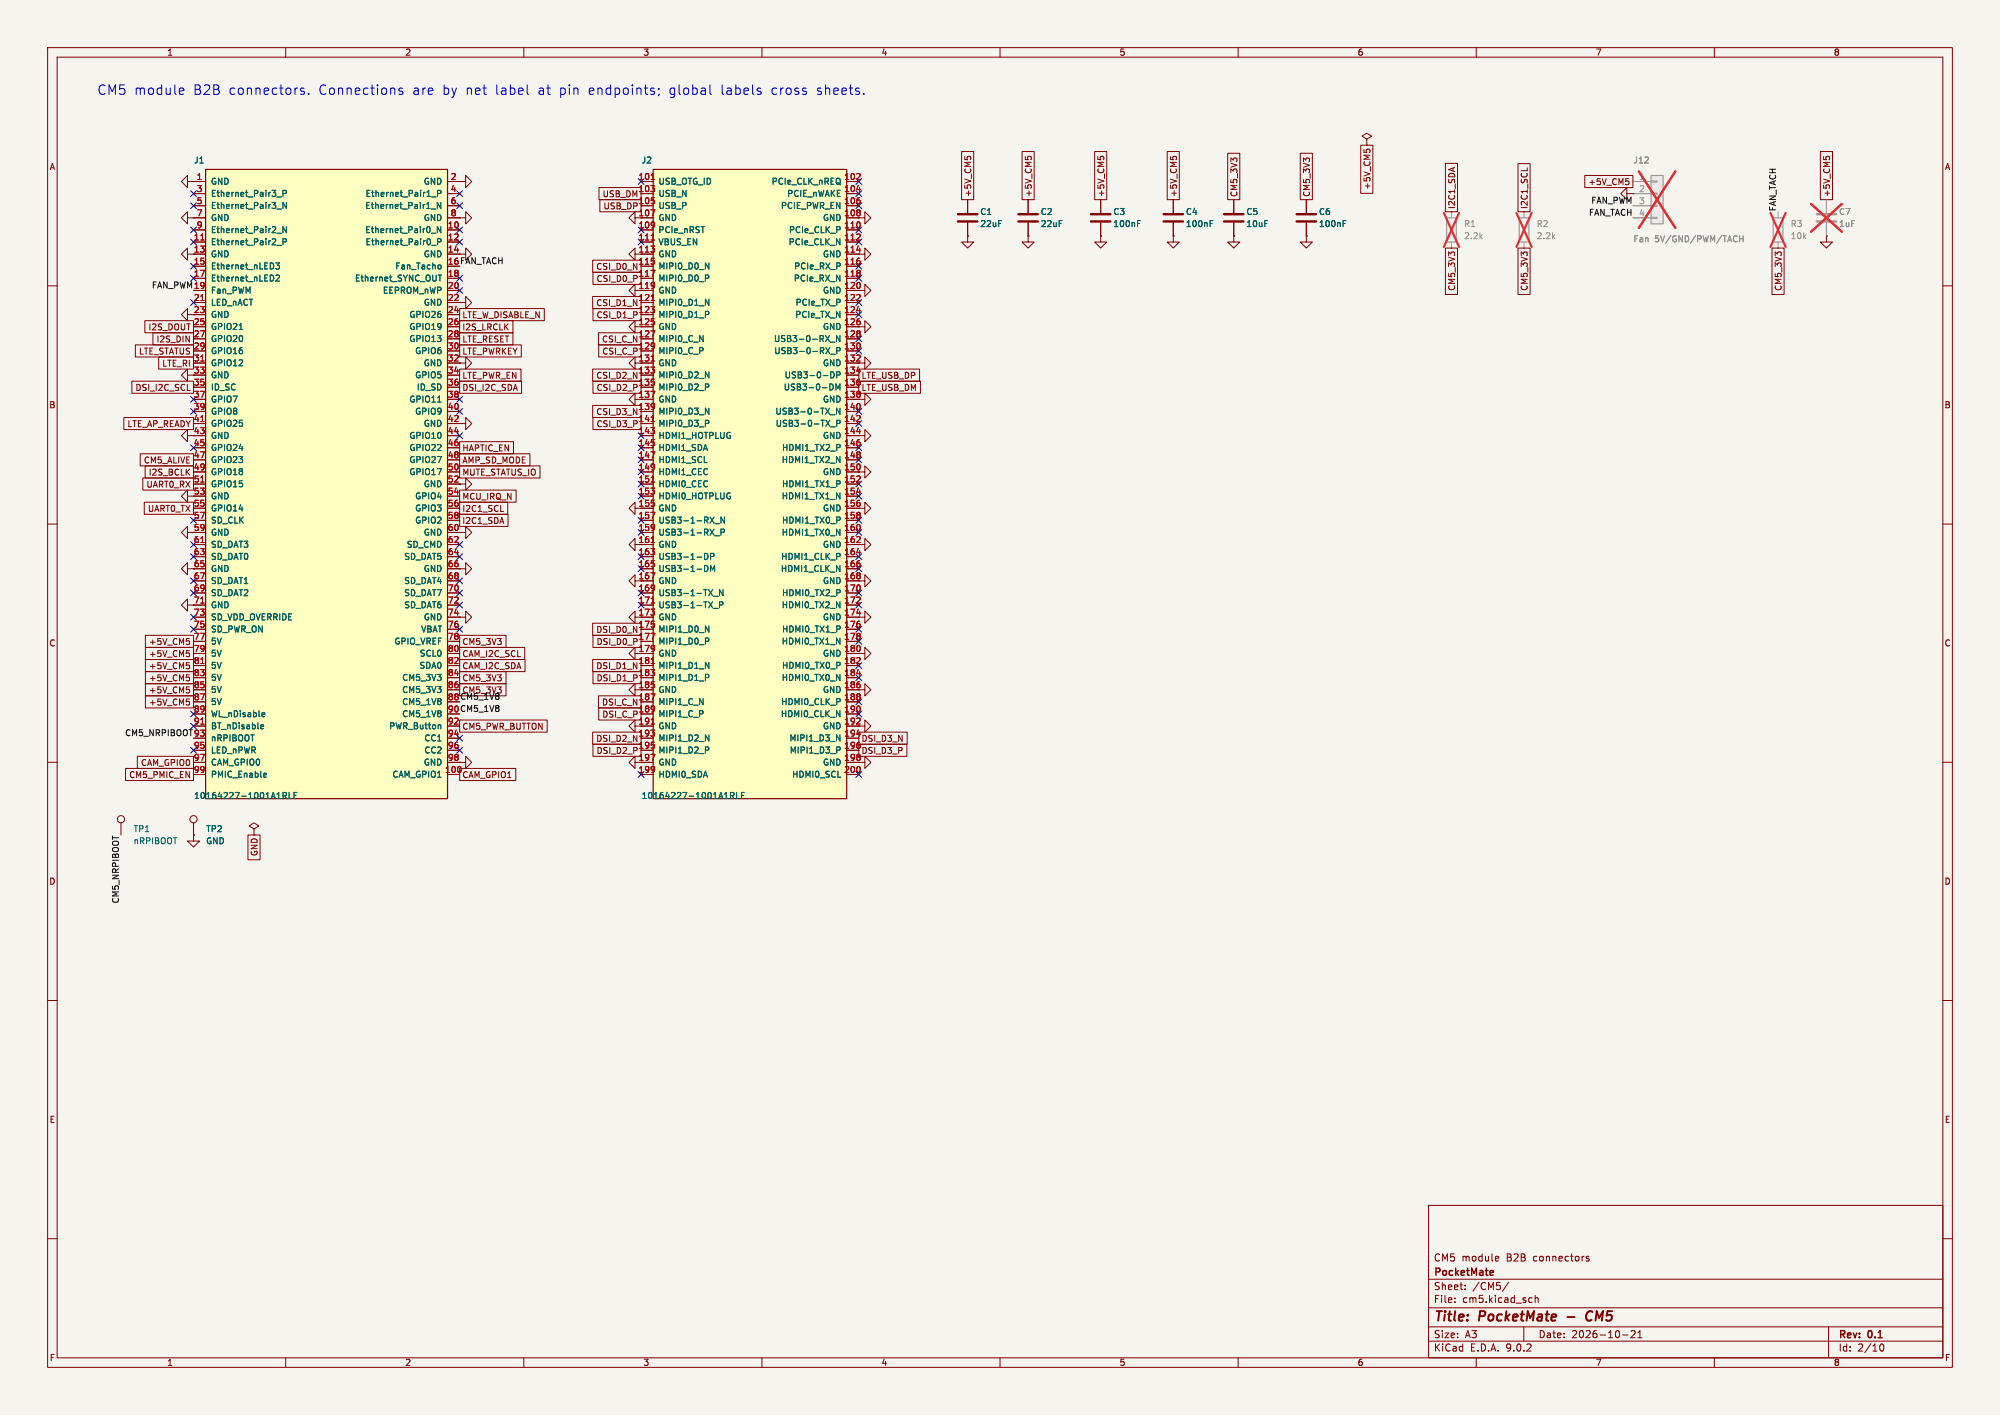
[picture p141: page 2]

USB_OTG_ID 101 USB_N 103 USB_P 105 GND 107 PCIe_nRST 109 VBUS_EN 111 GND 113 MIPI0_D0_N 115 MIPI0_D0_P 117 GND 119 MIPI0_D1_N 121 MIPI0_D1_P 123 GND 125 MIPI0_C_N 127 MIPI0_C_P 129 GND 131 MIPI0_D2_N 133 MIPI0_D2_P 135 GND 137 MIPI0_D3_N 139 MIPI0_D3_P 141 HDMI1_HOTPLUG 143 HDMI1_SDA 145 HDMI1_SCL 147 HDMI1_CEC 149 HDMI0_CEC 151 HDMI0_HOTPLUG 153 GND 155 USB3-1-RX_N 157 USB3-1-RX_P 159 GND 161 USB3-1-DP 163 USB3-1-DM 165 GND 167 USB3-1-TX_N 169 USB3-1-TX_P 171 GND 173 MIPI1_D0_N 175 MIPI1_D0_P 177 GND 179 MIPI1_D1_N 181 MIPI1_D1_P 183 GND 185 MIPI1_C_N 187 MIPI1_C_P 189 GND 191 MIPI1_D2_N 193 MIPI1_D2_P 195 GND 197 HDMI0_SDA 199

J12 Fan 5V/GND/PWM/TACH

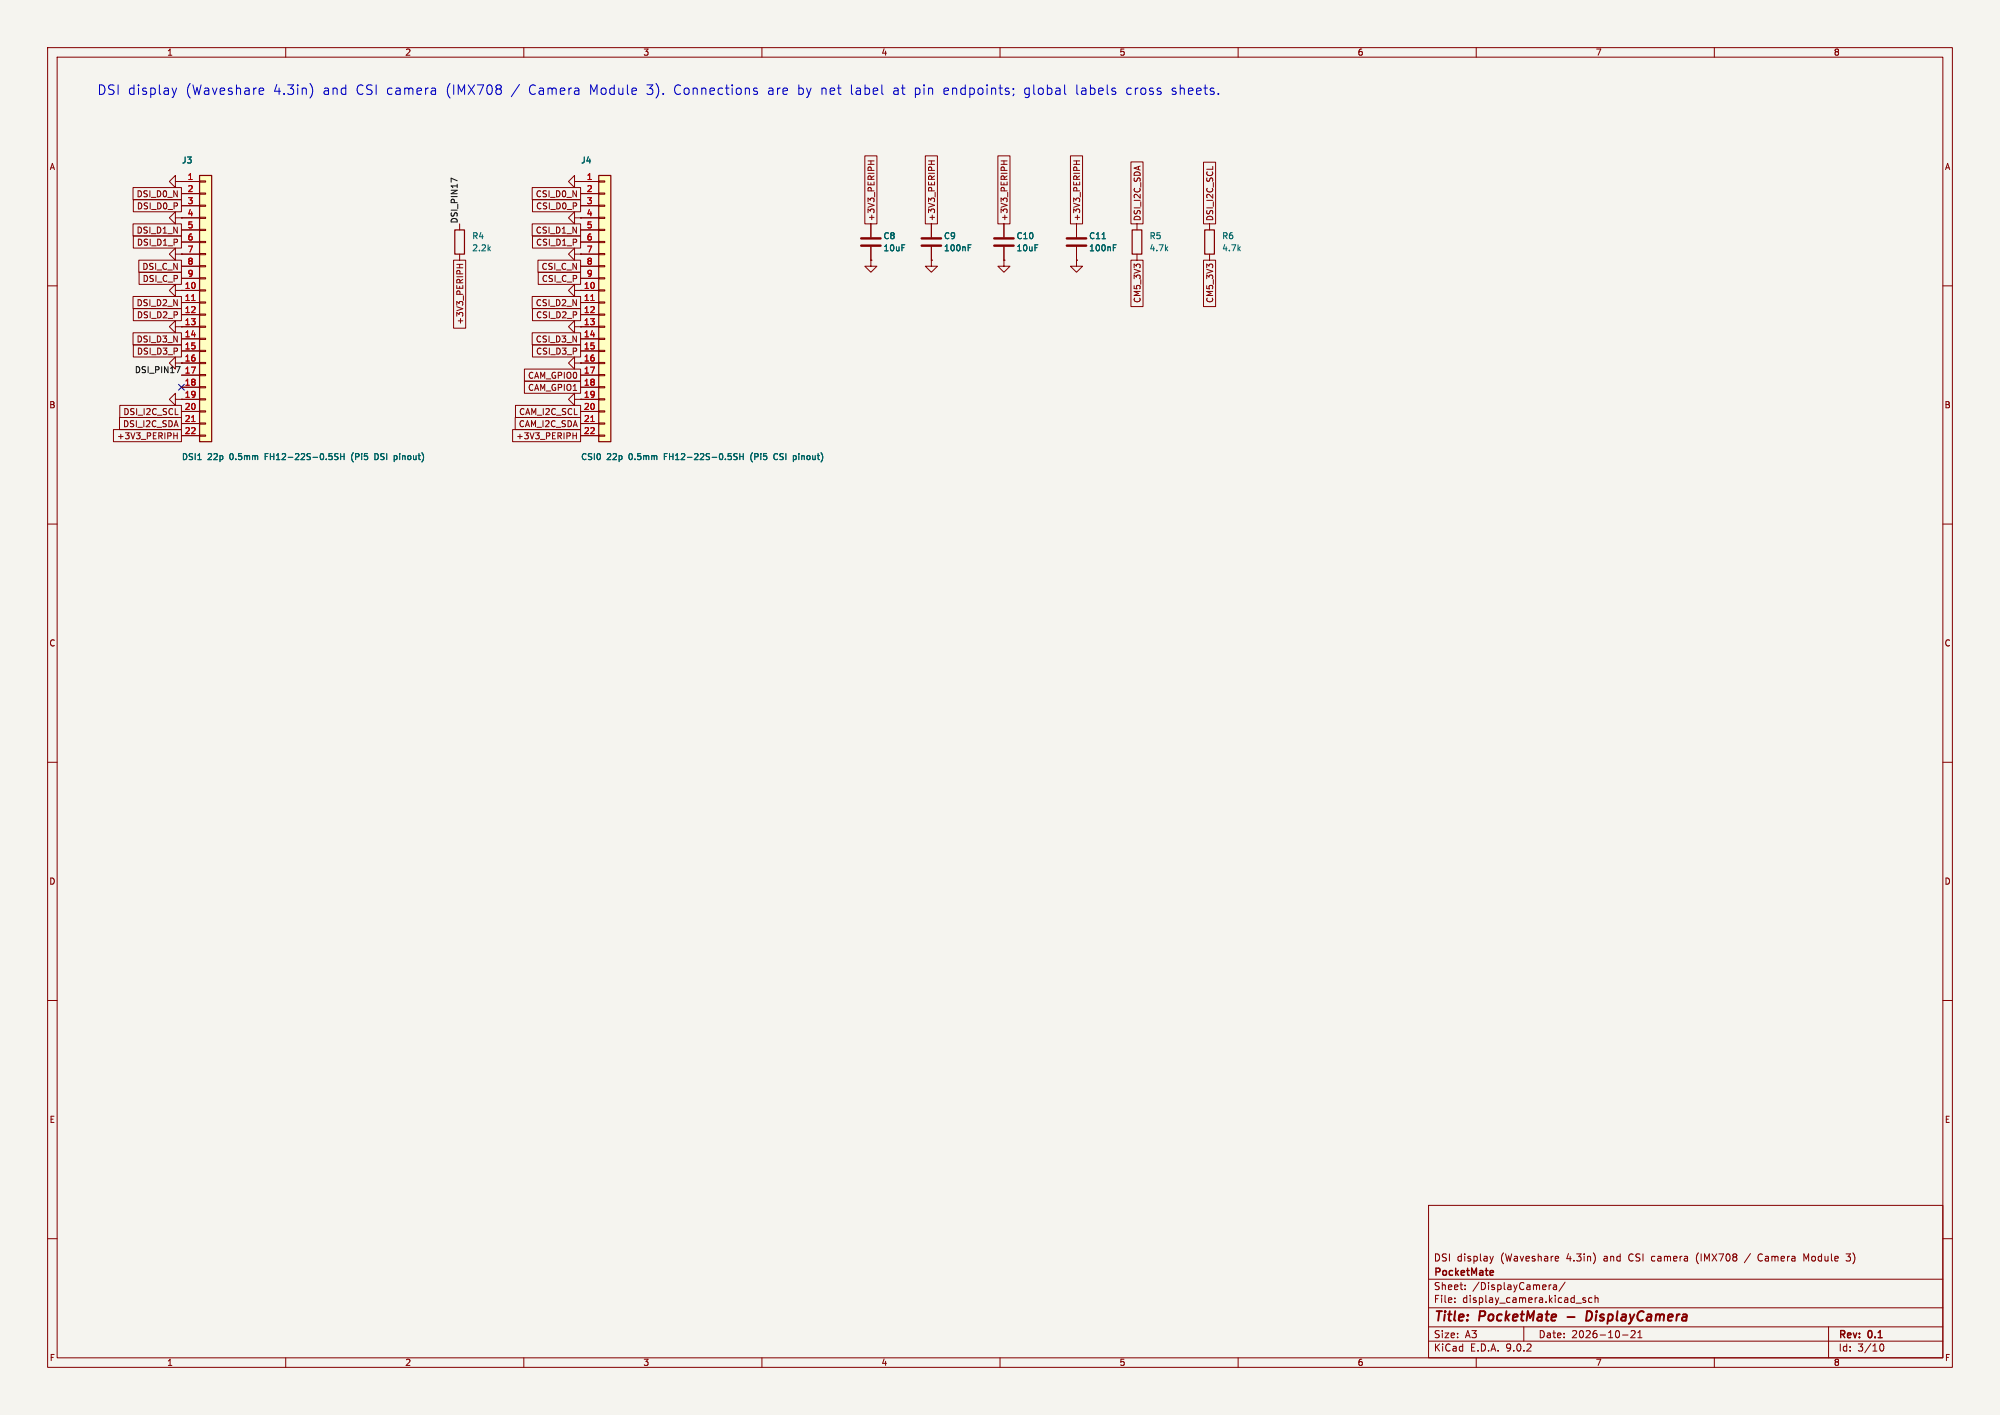
[picture p142: page 3]

Id: 3/10 Title: PocketMate - DisplayCamera

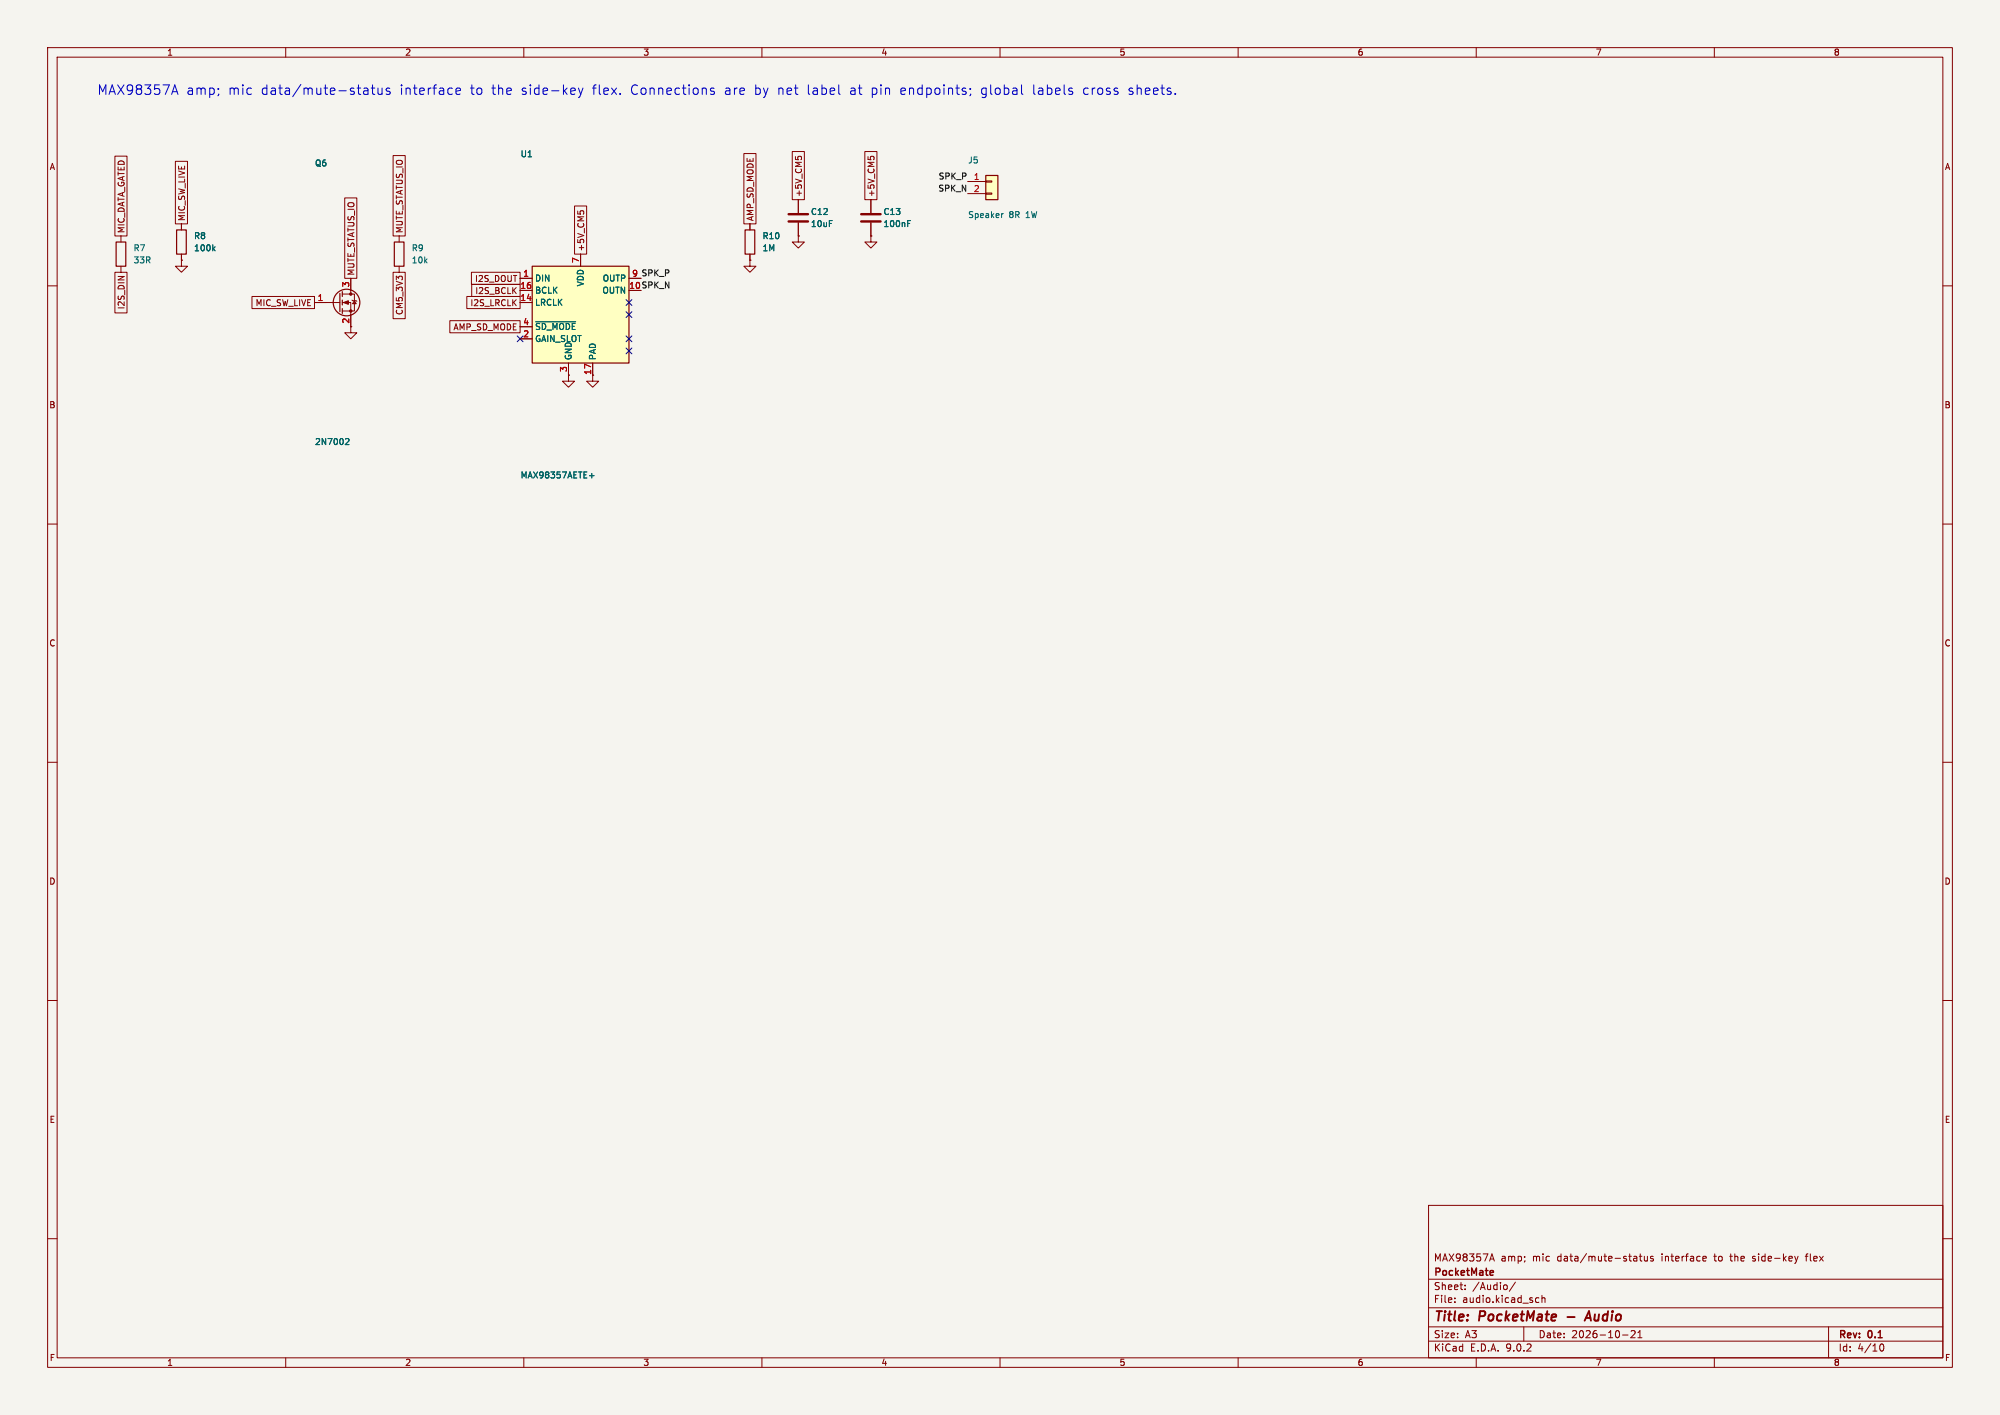
[picture p143: page 4]

Id: 4/10 Title: PocketMate - Audio

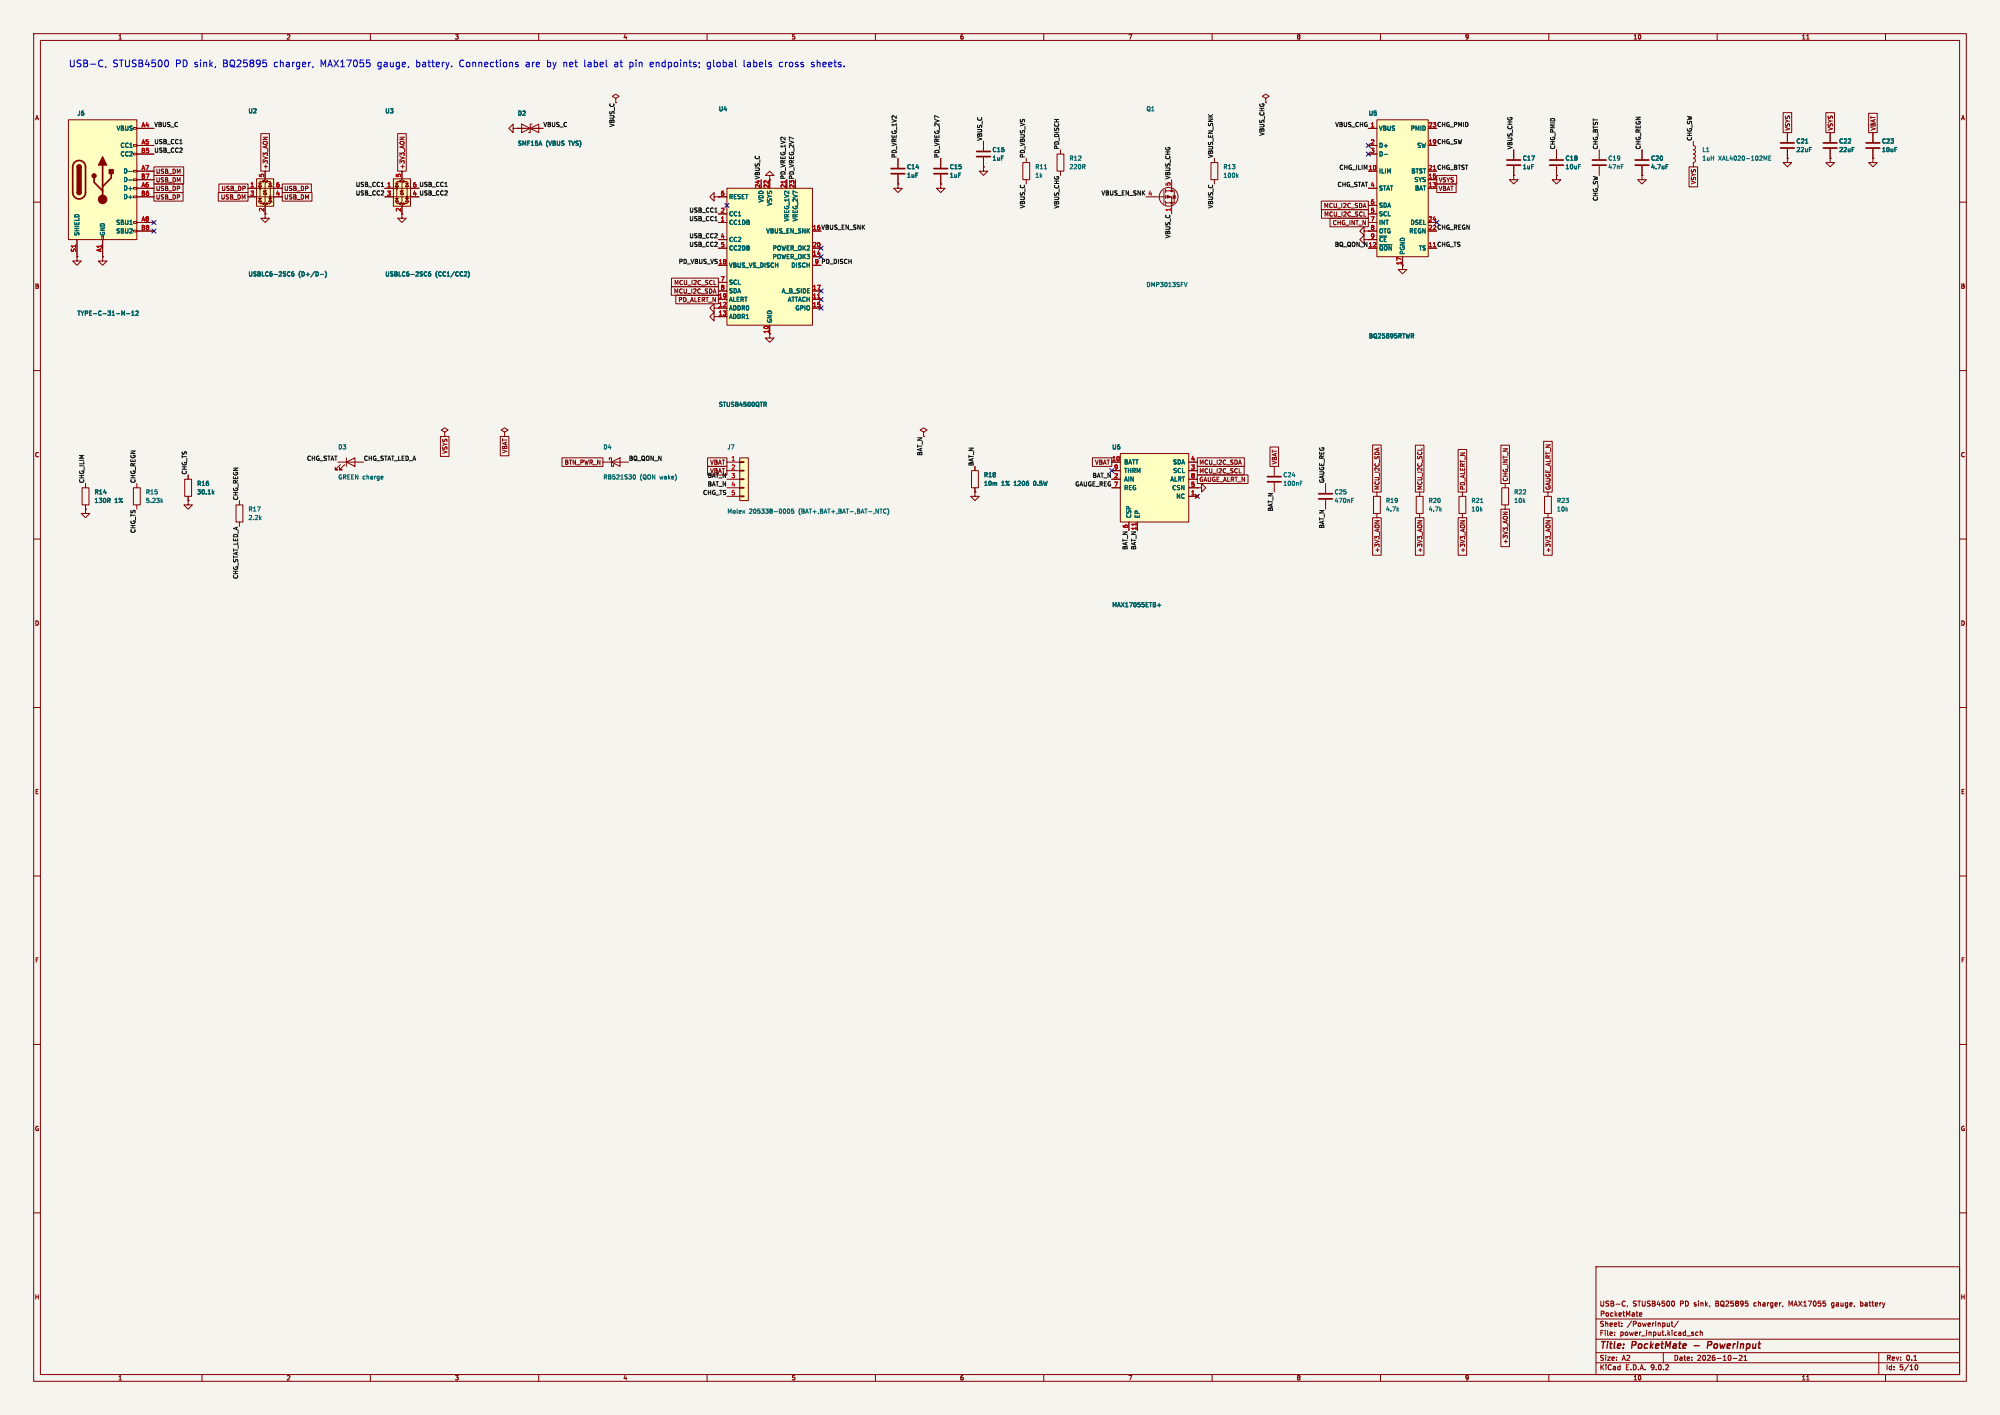
[picture p144: page 5]

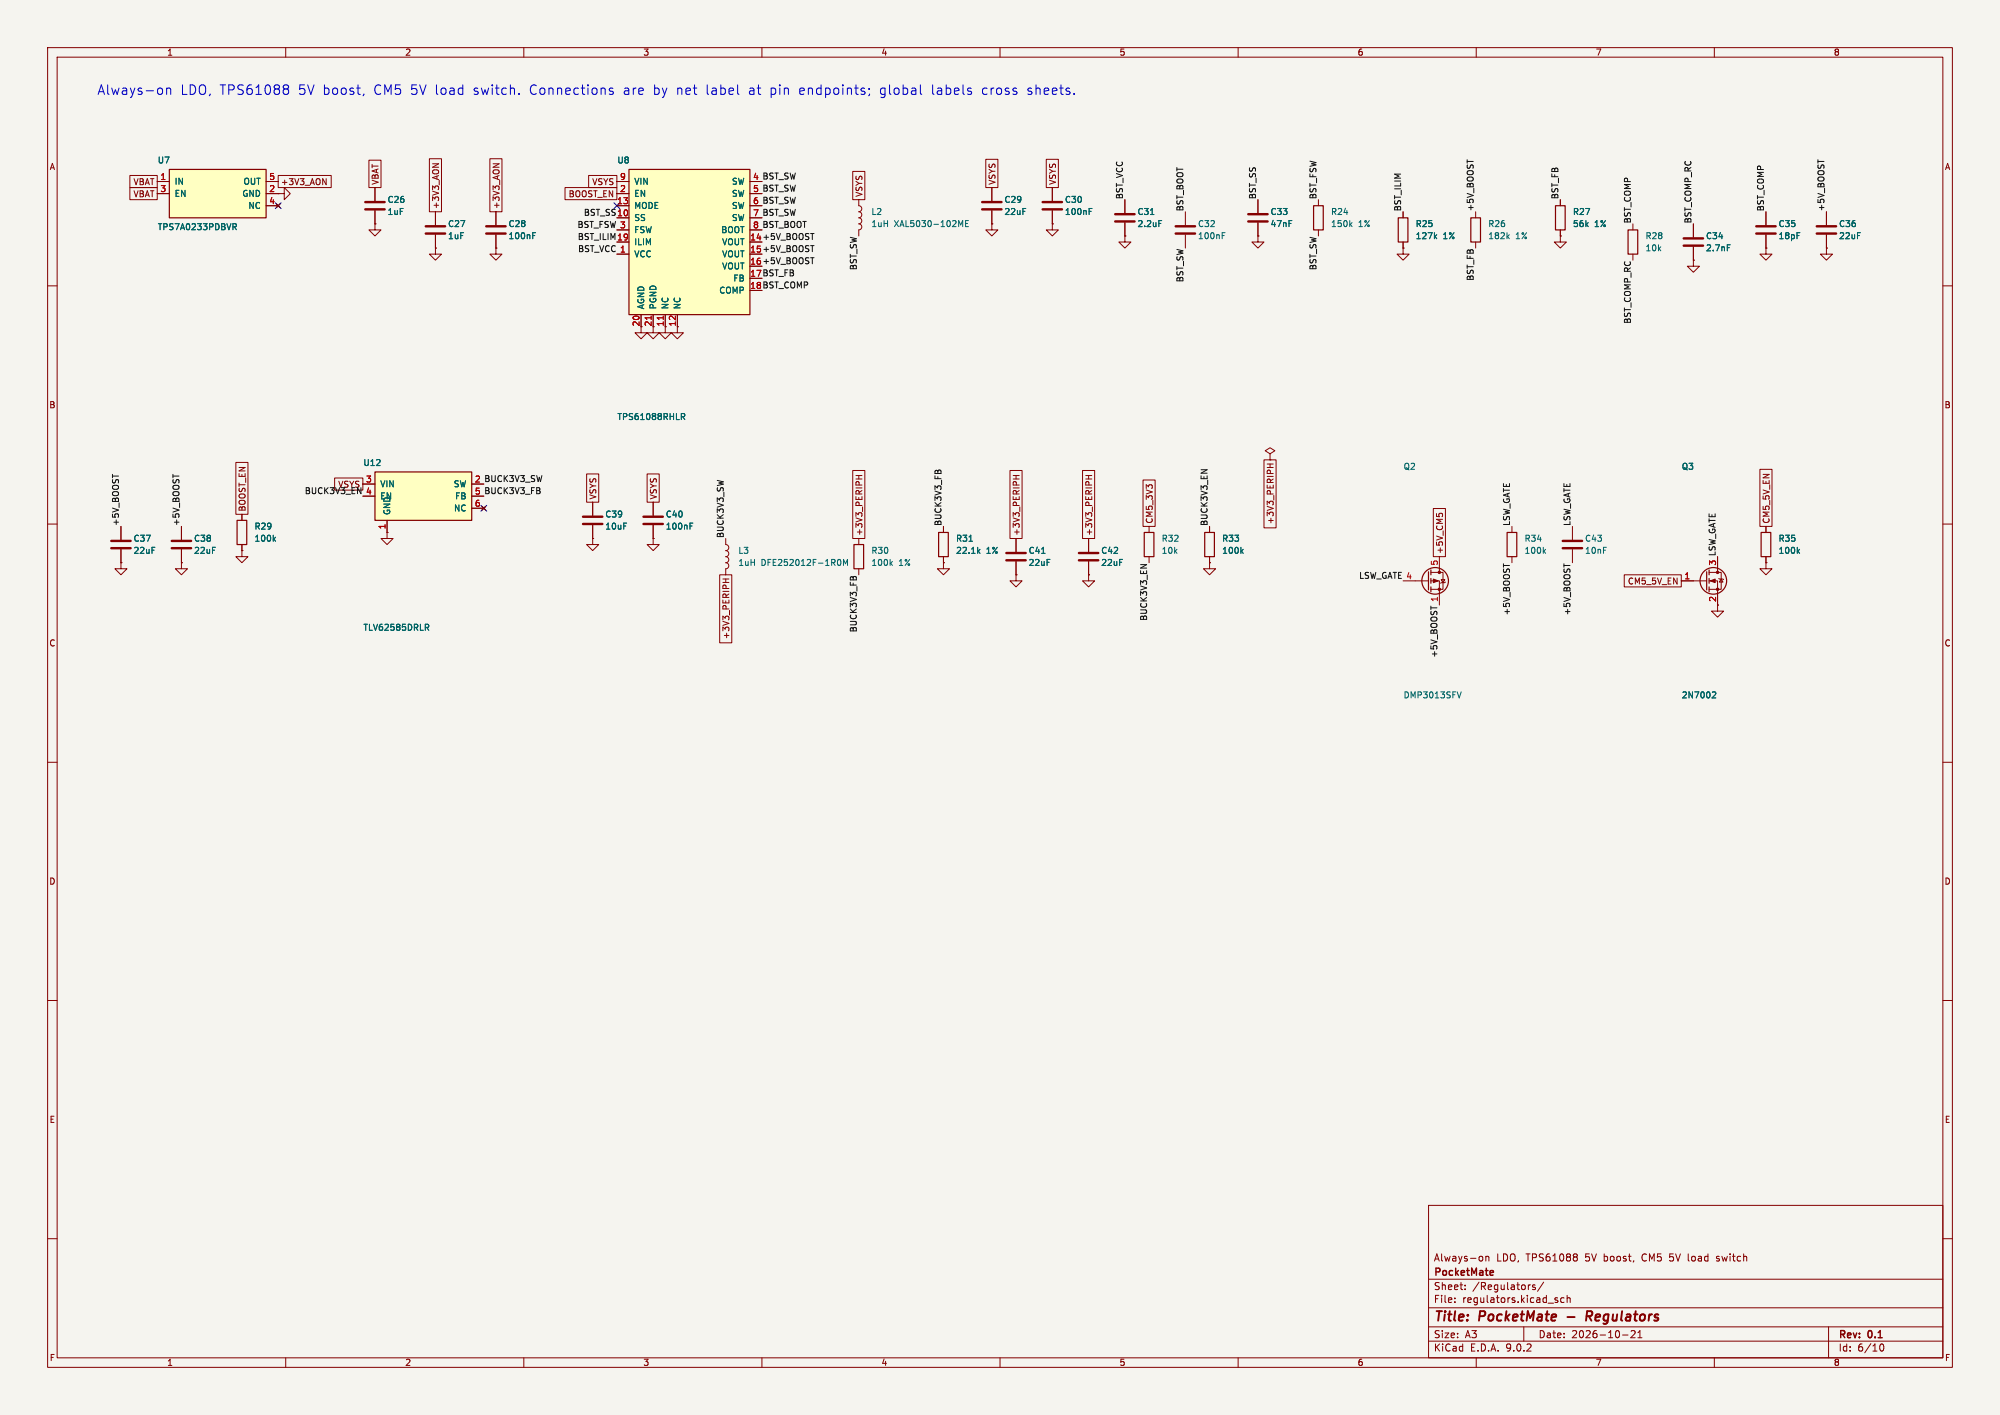
[picture p145: page 6]

Id: 6/10 Title: PocketMate - Regulators

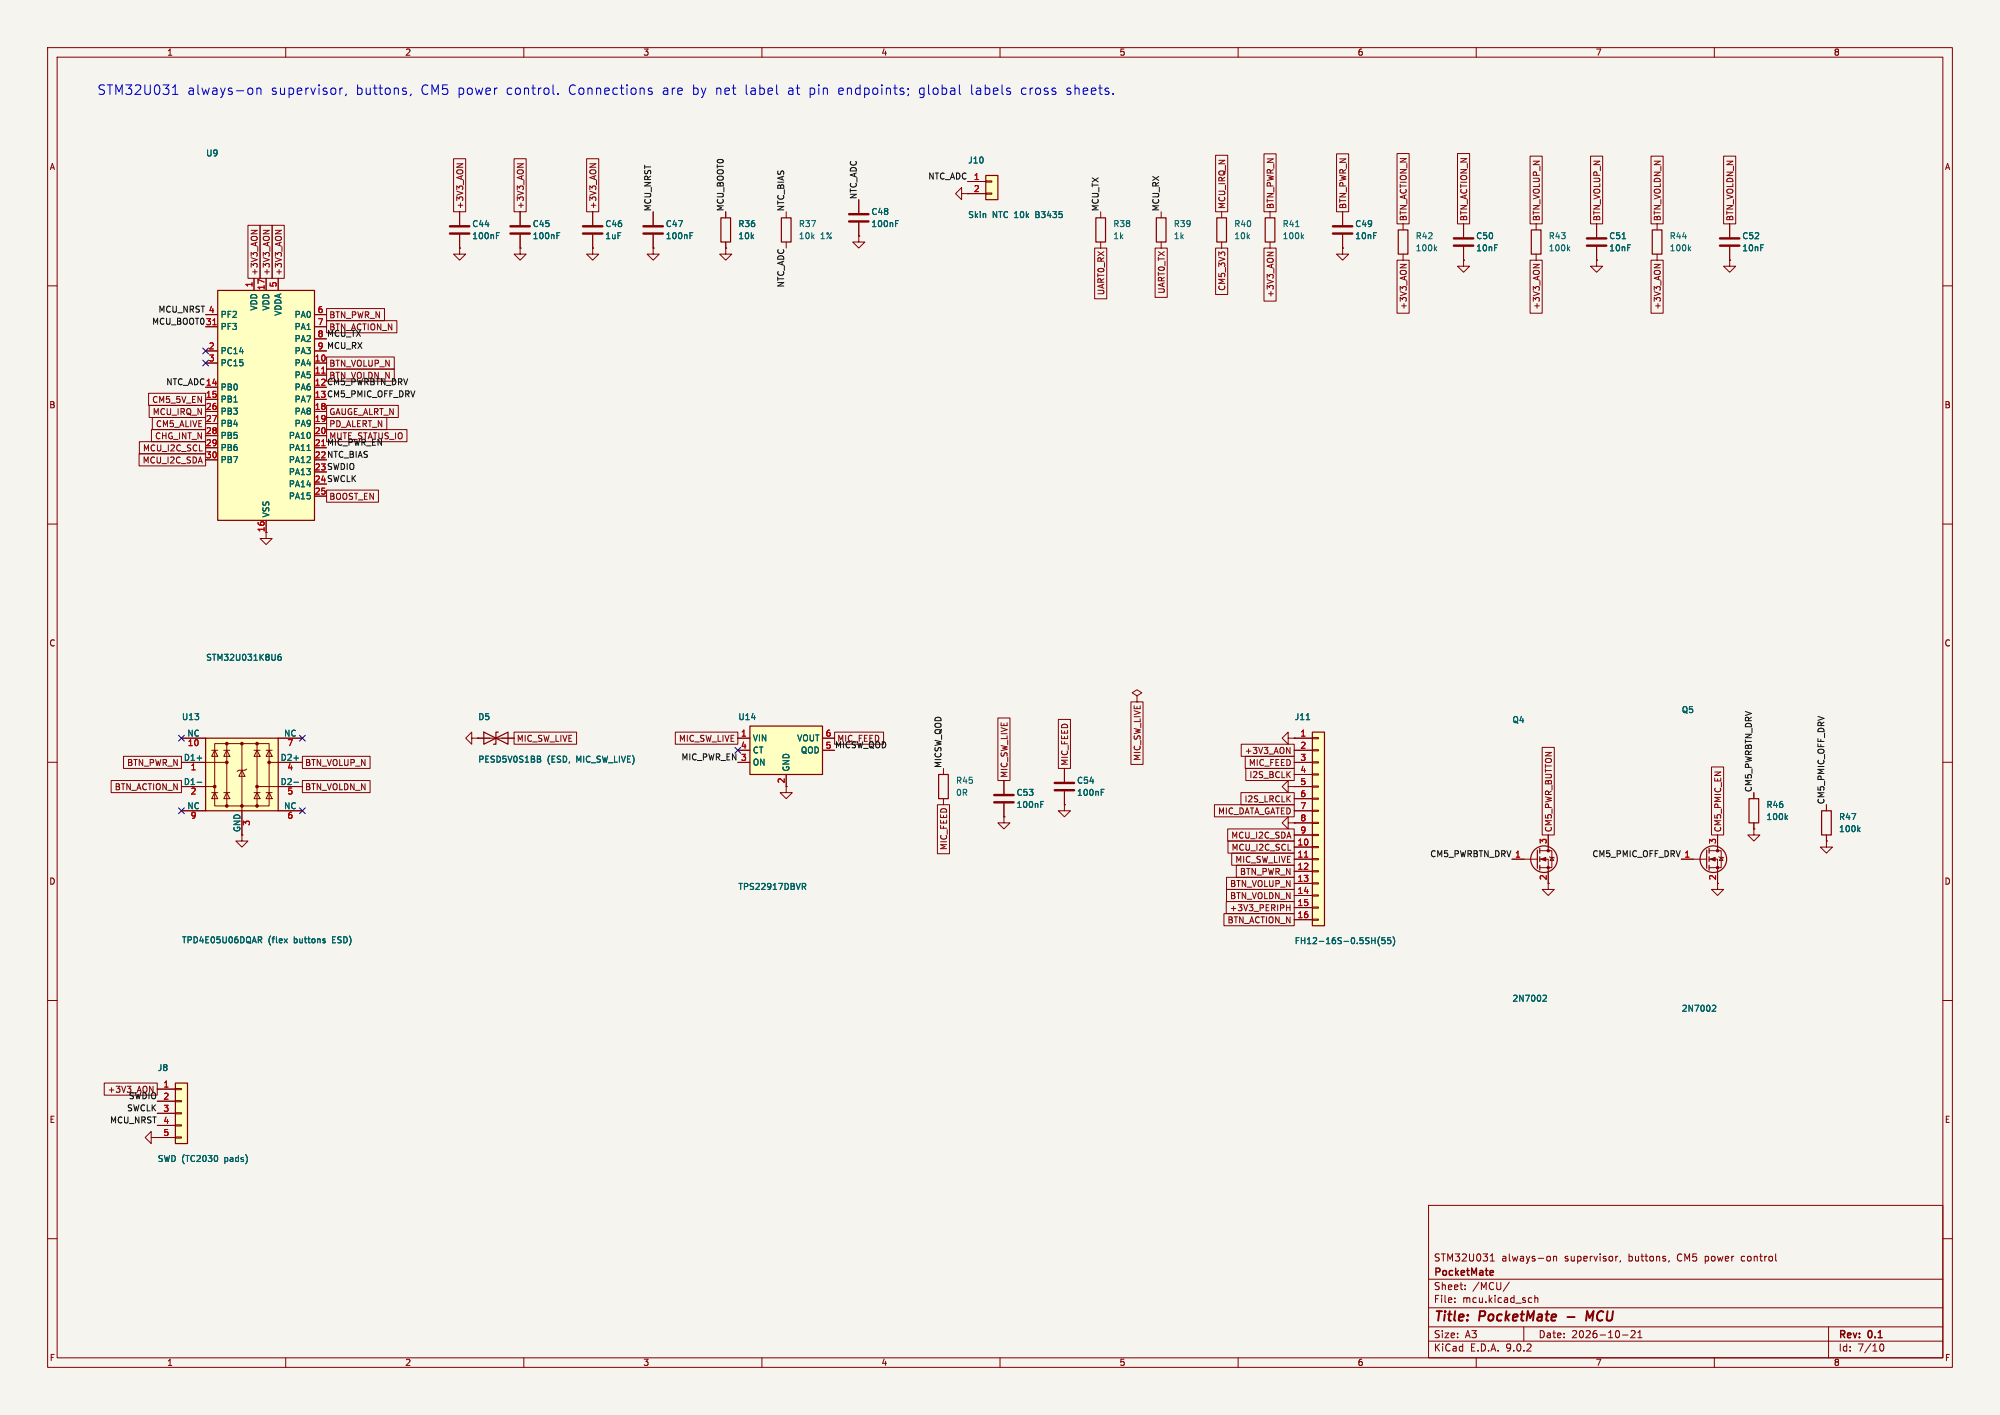
[picture p146: page 7]

10nF U13 TPD4E05U06DQAR (flex buttons ESD) NC

Id: 7/10 Title: PocketMate - MCU

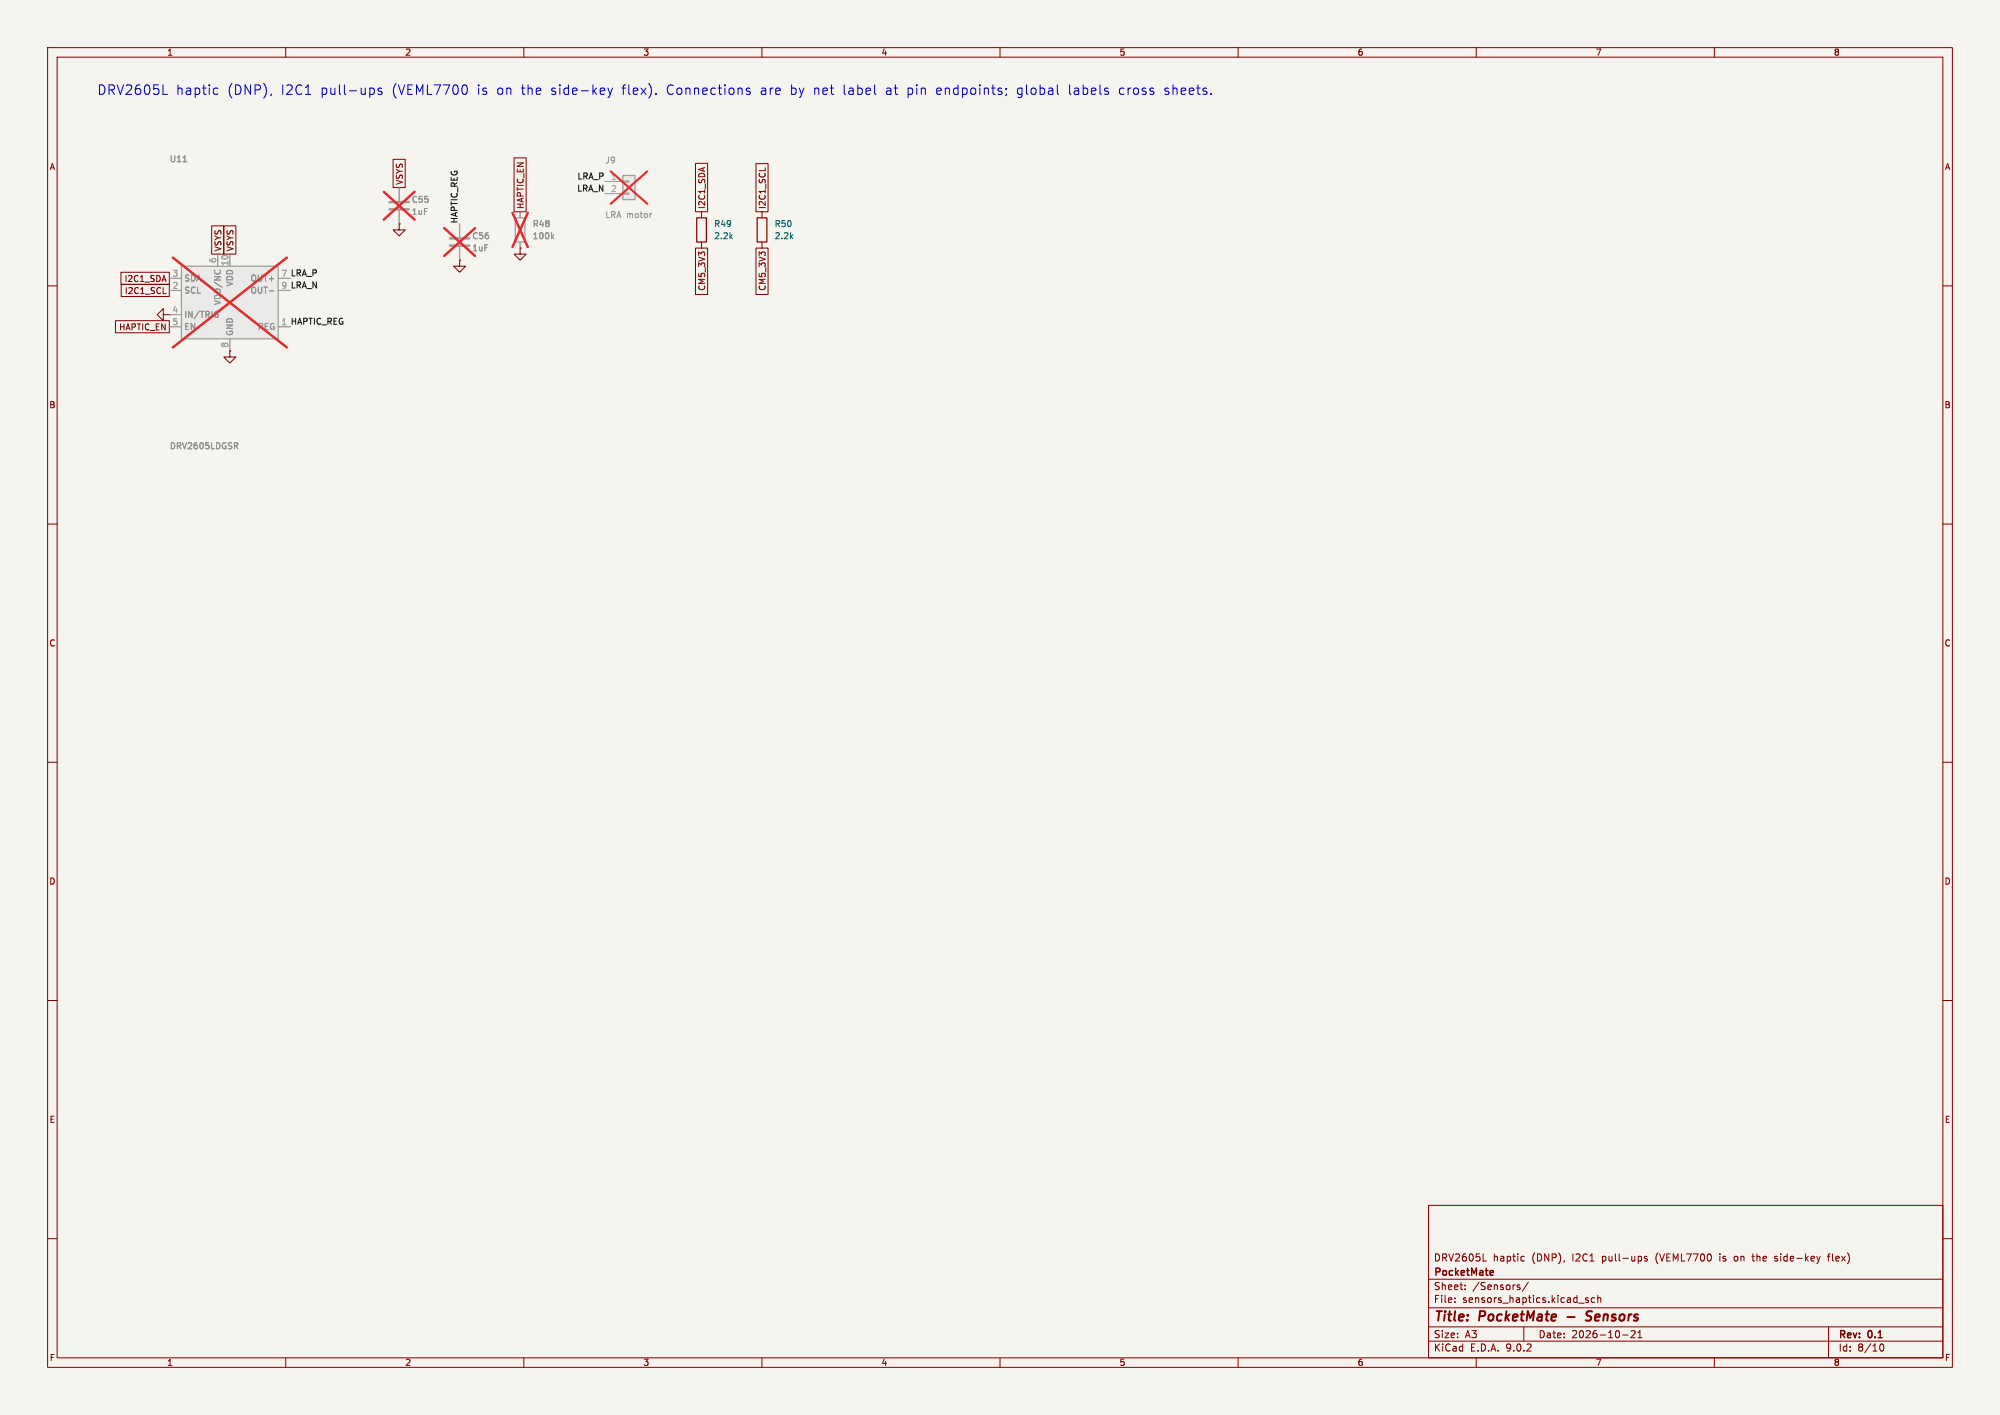
[picture p147: page 8]

Id: 8/10 Title: PocketMate - Sensors

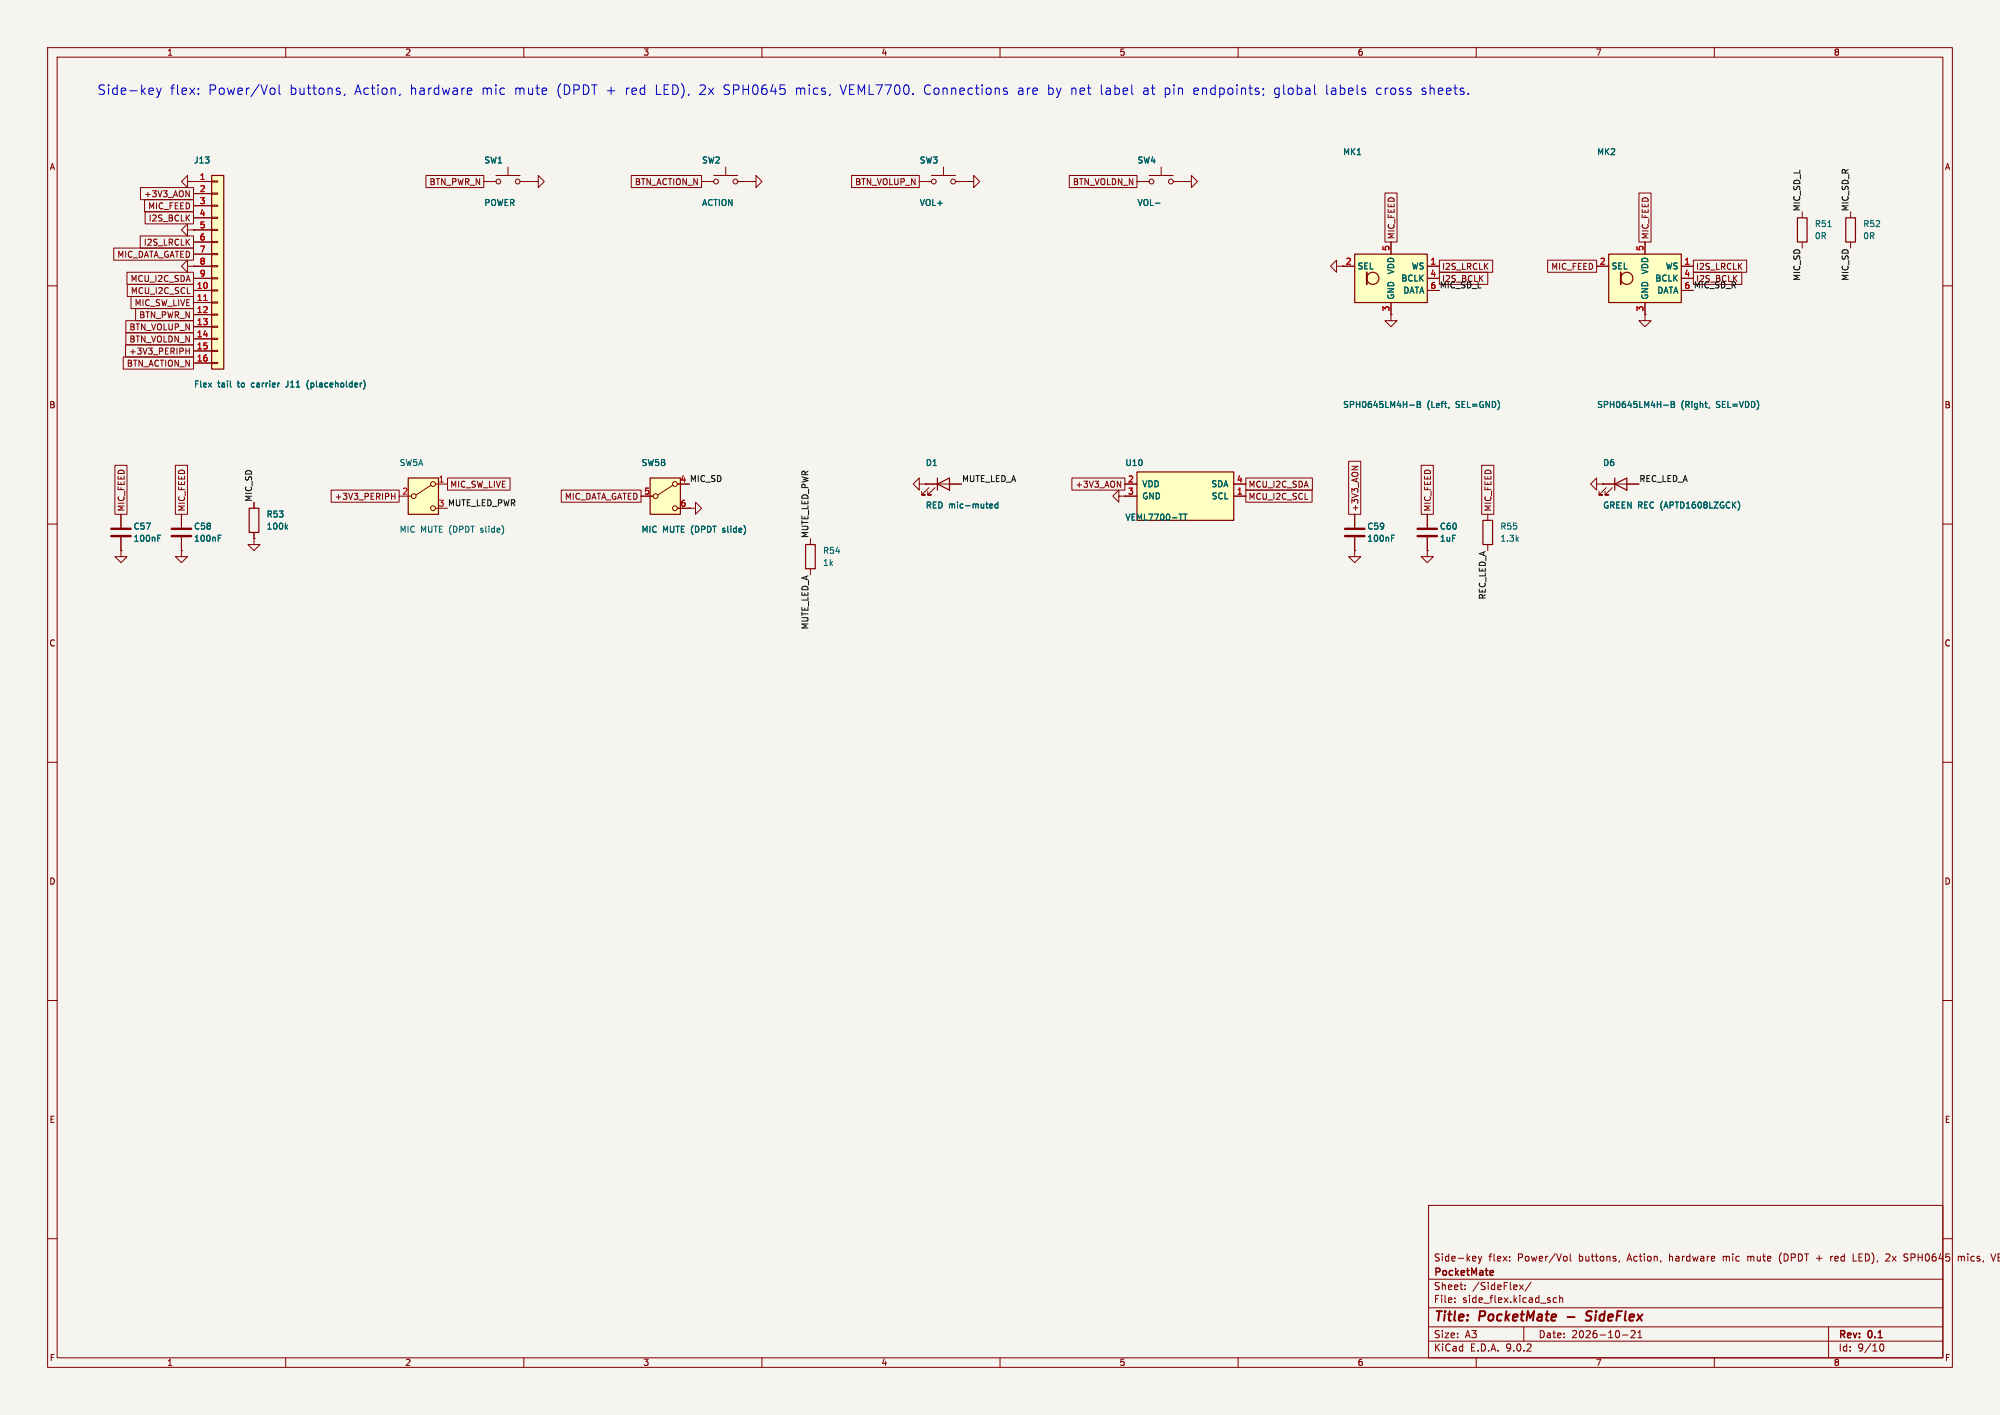
[picture p148: page 9]

3 WS 1 BCLK 4 DATA 6 MK1 SPH0645LM4H-B (Left, SEL=GND) R53
+3V3_PERIPH MIC_FEED
I2S_BCLK

J13 Flex tail to carrier J11 (placeholder) C57

6 SW5B MIC MUTE (DPDT slide) 5

3 SW5A MIC MUTE (DPDT slide) C58

6 SW5B MIC MUTE (DPDT slide)

Id: 9/10 Title: PocketMate - SideFlex

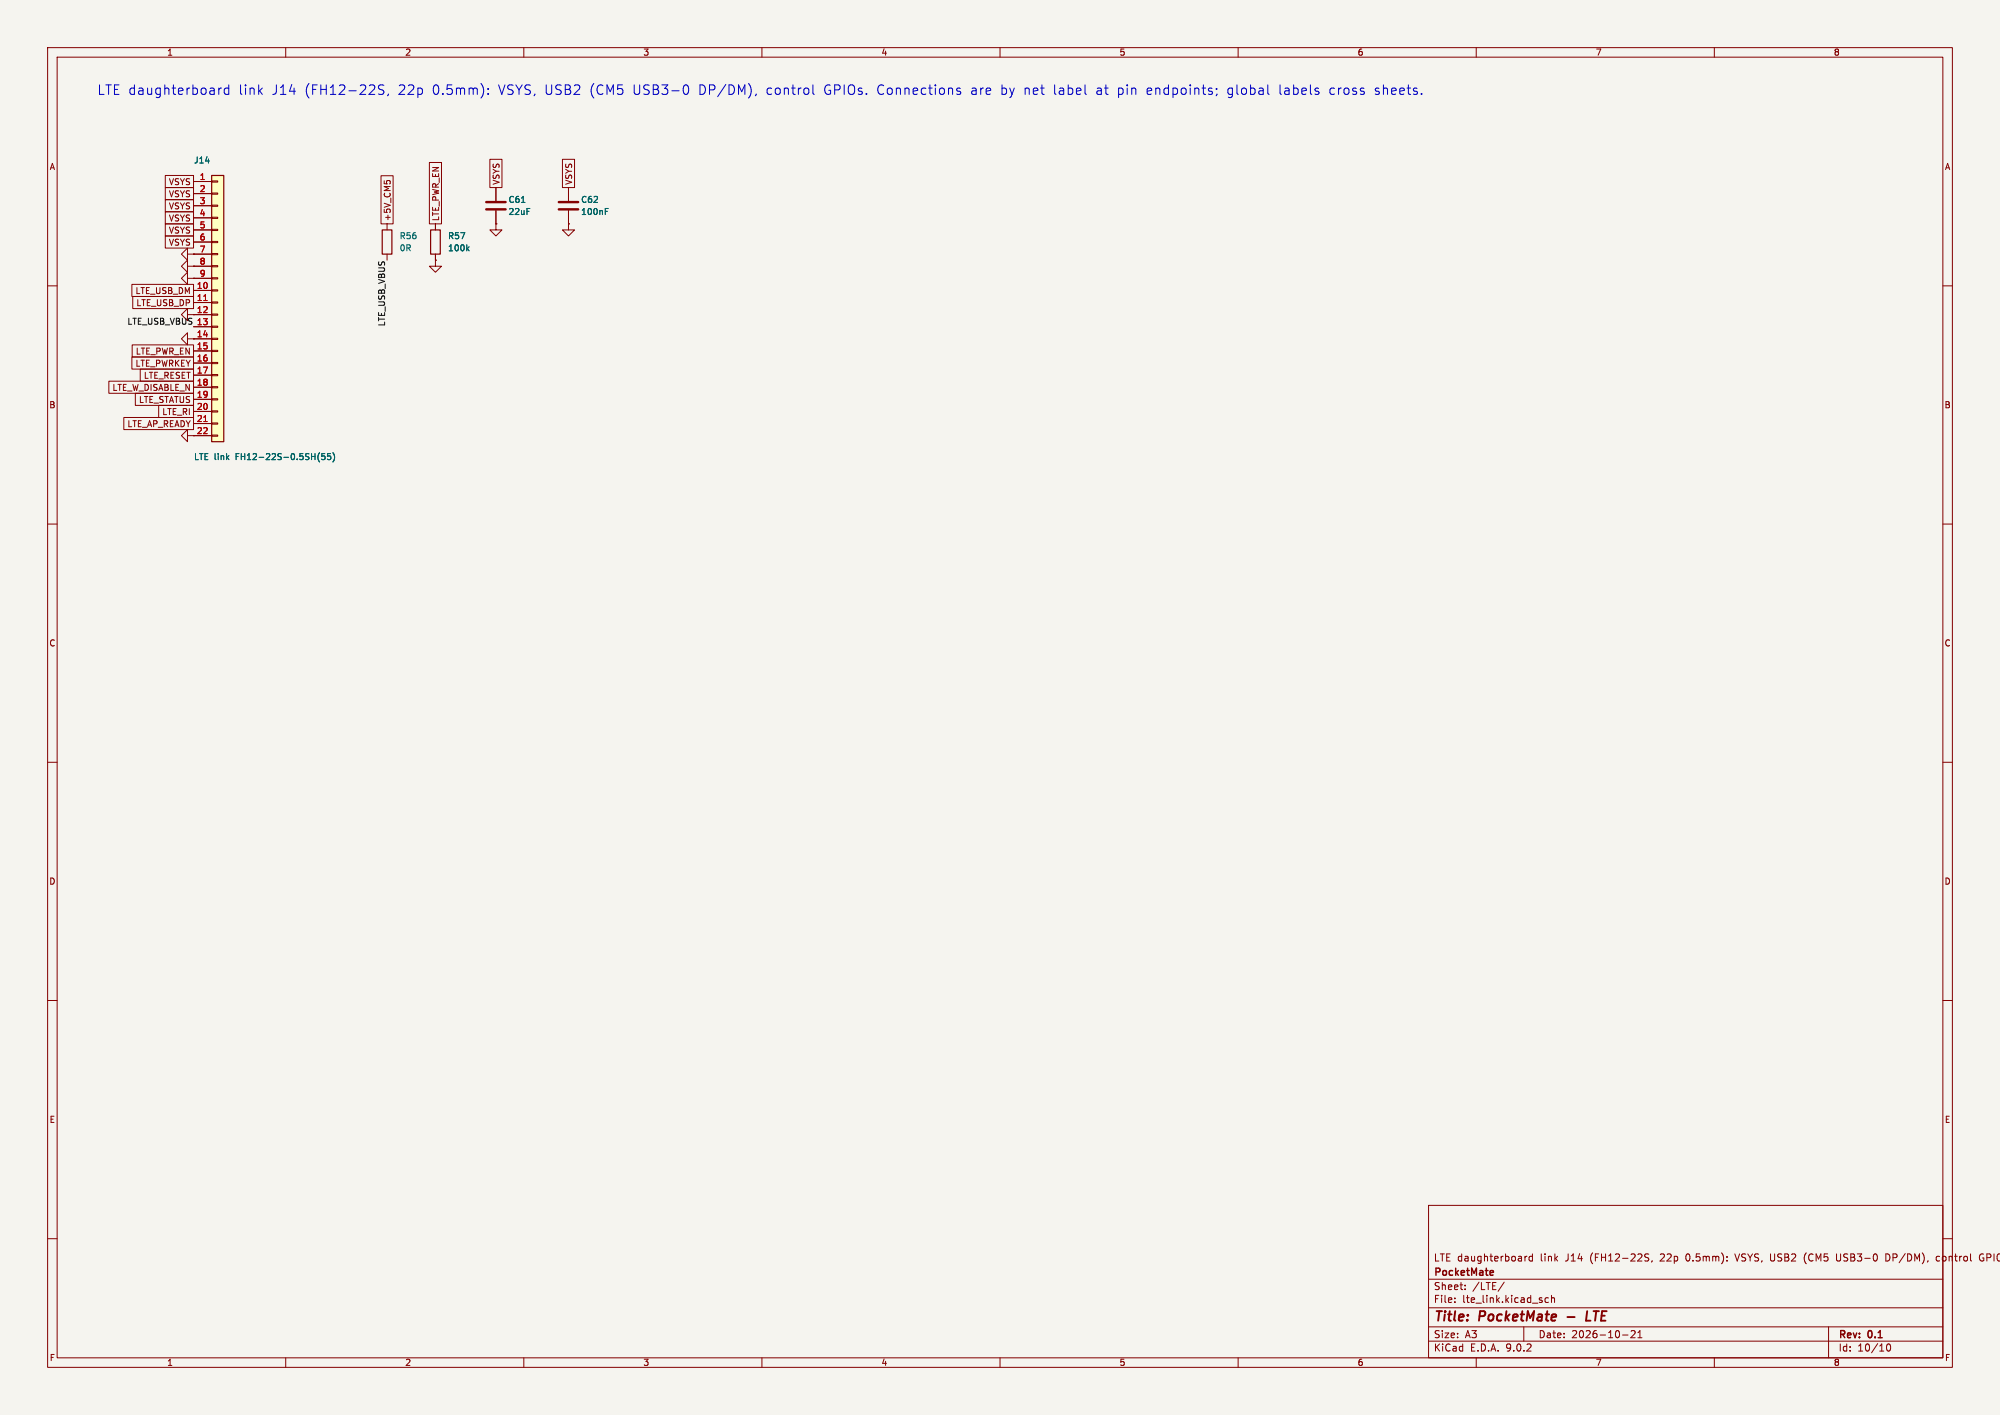
[picture p149: page 10]

File: lte_link.kicad_sch Sheet: /LTE/ PocketMate

Id: 10/10 Title: PocketMate - LTE
