anand2532/PocketMate/hardware/kicad/PocketMate.kicad_pcb

## KiCad design hardware/kicad/PocketMate.kicad_pcb (2026-10-27)

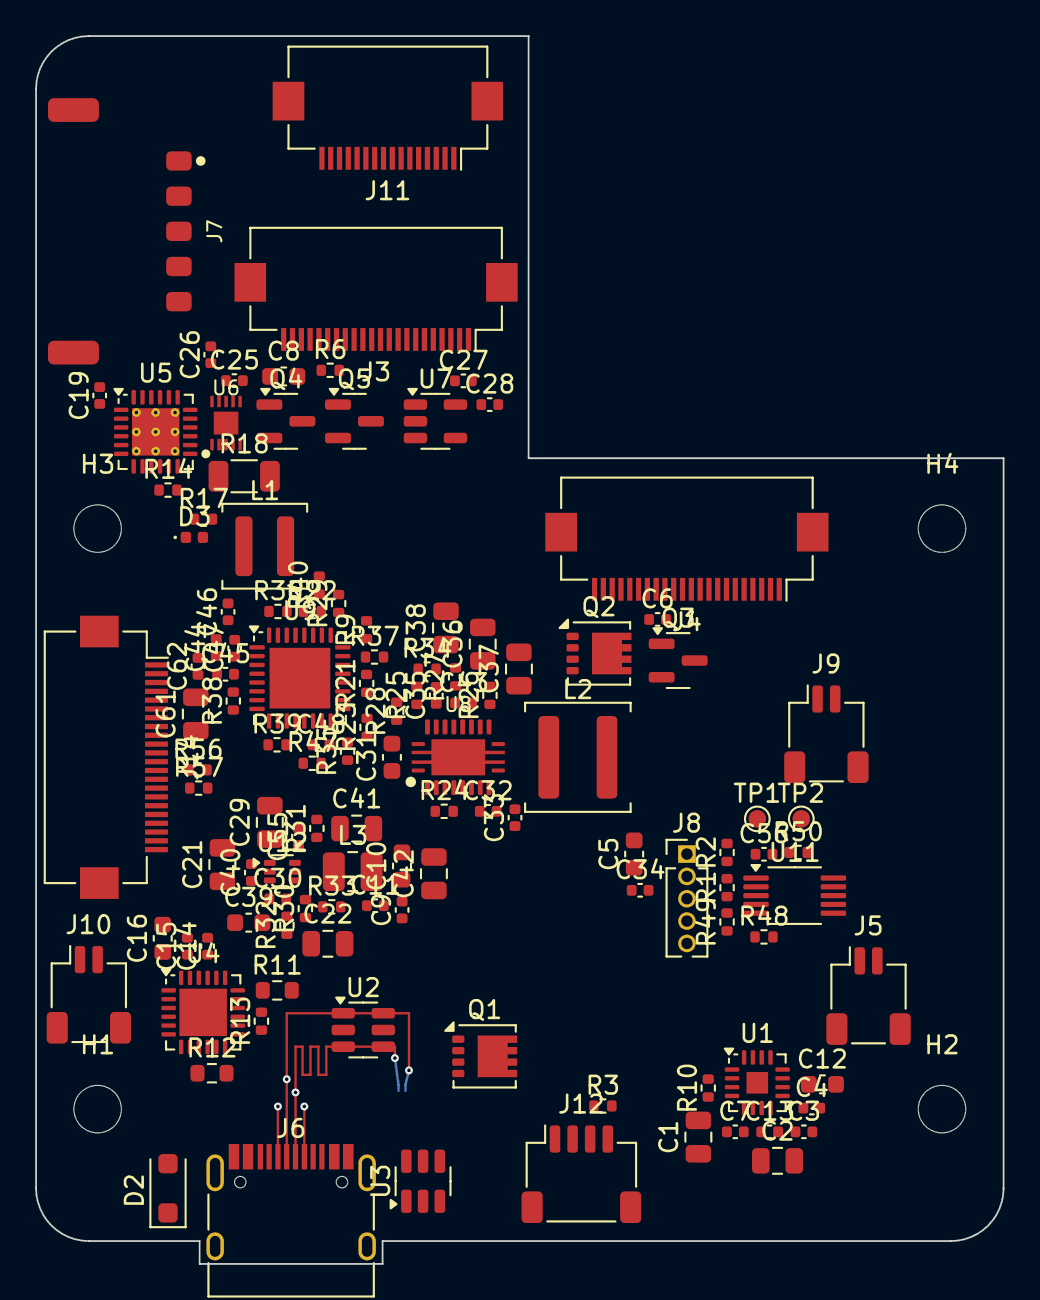
[picture p150: board PocketMate.kicad_pcb from above]

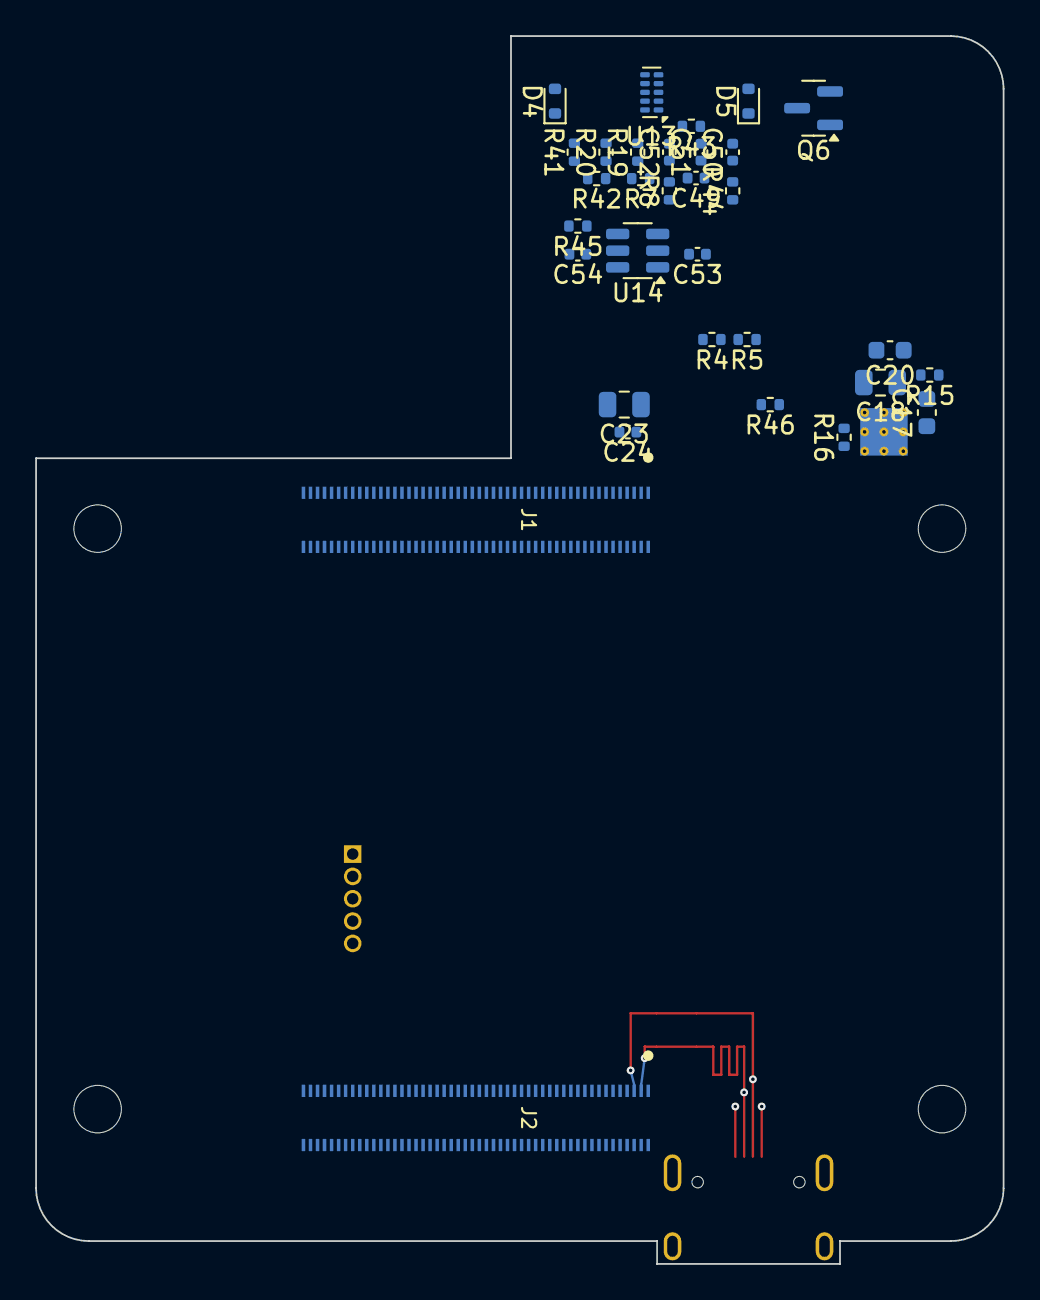
[picture p151: board PocketMate.kicad_pcb from below]

Board: 6 copper layers, 55.0 x 69.8 mm, 155 parts (32 on the bottom side), 130 nets.

Parts:
C1, C2, C21, C22, C29, C36, C37, C38, C41, C42, C61: 22uF; C_0805_2012Metric
C3, C4, C6, C9, C11, C13, C24, C28, C30, C32, C40, C44, C45, C47, C48, C53, C54, C62: 100nF; C_0402_1005Metric
C5, C8, C10, C12, C39: 10uF; C_0603_1608Metric
C7, C14, C15, C26, C27, C46, C55, C56: 1uF; C_0402_1005Metric
C16, C17: 1uF; C_0603_1608Metric
C18, C23: 10uF; C_0805_2012Metric
C19, C33: 47nF; C_0402_1005Metric
C20: 4.7uF; C_0603_1608Metric
C25: 470nF; C_0402_1005Metric
C31: 2.2uF; C_0603_1608Metric
C34: 2.7nF; C_0402_1005Metric
C35: 18pF; C_0402_1005Metric
C43, C49, C50, C51, C52: 10nF; C_0402_1005Metric
D2: SMF15A (VBUS TVS); D_SOD-123F
D3: GREEN charge; LED_0402_1005Metric
D4: RB521S30 (QON wake); D_SOD-523
D5: PESD5V0S1BB (ESD, MIC_SW_LIVE); D_SOD-523
H1, H2, H3, H4: MountingHole_2.7mm_M2.5
J1: 10164227-1001A1RLF; CM5_B2B_10164227_Pins1-100
J2: 10164227-1001A1RLF; CM5_B2B_10164227_Pins101-200
J3: DSI1 22p 0.5mm FH12-22S-0.5SH (Pi5 DSI pinout); Hirose_FH12-22S-0.5SH_1x22-1MP_P0.50mm_Horizontal
J4: CSI0 22p 0.5mm FH12-22S-0.5SH (Pi5 CSI pinout); Hirose_FH12-22S-0.5SH_1x22-1MP_P0.50mm_Horizontal
J5: Speaker 8R 1W; JST_SH_SM02B-SRSS-TB_1x02-1MP_P1.00mm_Horizontal
J6: TYPE-C-31-M-12; USB_C_Receptacle_HRO_TYPE-C-31-M-12
J7: Molex 205338-0005 (BAT+,BAT+,BAT-,BAT-,NTC); Molex_Pico-Lock_205338-0005_1x05-1MP_P2.00mm_Horizontal
J8: SWD (TC2030 pads); PinHeader_1x05_P1.27mm_Vertical
J9: LRA motor; JST_SH_SM02B-SRSS-TB_1x02-1MP_P1.00mm_Horizontal
J10: Skin NTC 10k B3435; JST_SH_SM02B-SRSS-TB_1x02-1MP_P1.00mm_Horizontal
J11: FH12-16S-0.5SH(55); Hirose_FH12-16S-0.5SH_1x16-1MP_P0.50mm_Horizontal
J12: Fan 5V/GND/PWM/TACH; JST_SH_SM04B-SRSS-TB_1x04-1MP_P1.00mm_Horizontal
J14: LTE link FH12-22S-0.5SH(55); Hirose_FH12-22S-0.5SH_1x22-1MP_P0.50mm_Horizontal
L1: 1uH XAL4020-102ME; L_Coilcraft_XAL4020-XXX
L2: 1uH XAL5030-102ME; L_Coilcraft_XAL5030-XXX
L3: 1uH DFE252012F-1R0M; L_1008_2520Metric
Q1, Q2: DMP3013SFV; Diodes_PowerDI3333-8
Q3, Q4, Q5, Q6: 2N7002; SOT-23
R1, R2, R4, R17, R49, R50: 2.2k; R_0402_1005Metric
R3, R9, R21, R22, R23, R28, R32, R36, R40: 10k; R_0402_1005Metric
R5, R6, R19, R20: 4.7k; R_0402_1005Metric
R7: 33R; R_0402_1005Metric
R8, R13, R29, R33, R34, R35, R41, R42, R43, R44, R46, R47, R48, R57: 100k; R_0402_1005Metric
R10: 1M; R_0402_1005Metric
R11: 1k; R_0603_1608Metric
R12: 220R; R_0603_1608Metric
R14: 130R 1%; R_0402_1005Metric
R15: 5.23k; R_0402_1005Metric
R16: 30.1k; R_0402_1005Metric
R18: 10m 1% 1206 0.5W; R_1206_3216Metric
R24: 150k 1%; R_0402_1005Metric
R25: 127k 1%; R_0402_1005Metric
R26: 182k 1%; R_0402_1005Metric
R27: 56k 1%; R_0402_1005Metric
R30: 100k 1%; R_0402_1005Metric
R31: 22.1k 1%; R_0402_1005Metric
R37: 10k 1%; R_0402_1005Metric
R38, R39: 1k; R_0402_1005Metric
R45, R56: 0R; R_0402_1005Metric
TP1: nRPIBOOT; TestPoint_Pad_D1.0mm
TP2: GND; TestPoint_Pad_D1.0mm
U1: MAX98357AETE+; TQFN-16-1EP_3x3mm_P0.5mm_EP1.23x1.23mm
U2: USBLC6-2SC6 (D+/D-); SOT-23-6
U3: USBLC6-2SC6 (CC1/CC2); SOT-23-6
U4: STUSB4500QTR; QFN-24-1EP_4x4mm_P0.5mm_EP2.7x2.7mm
U5: BQ25895RTWR; Texas_RTW_WQFN-24-1EP_4x4mm_P0.5mm_EP2.7x2.7mm_ThermalVias
U6: MAX17055ETB+; Maxim_TDFN-10-1EP_2x2.5mm_P0.4mm_EP1.4x1.3mm_MAX17055
U7: TPS7A0233PDBVR; SOT-23-5
U8: TPS61088RHLR; TI_RHL0020A_VQFN-20_3.5x4.5mm_TPS61088
U9: STM32U031K8U6; QFN-32-1EP_5x5mm_P0.5mm_EP3.45x3.45mm
U11: DRV2605LDGSR; VSSOP-10_3x3mm_P0.5mm
U12: TLV62585DRLR; SOT-563
U13: TPD4E05U06DQAR (flex buttons ESD); USON-10_2.5x1.0mm_P0.5mm
U14: TPS22917DBVR; SOT-23-6

Connections:
+3V3_AON: C27.1, C28.1, C44.1, C45.1, C46.1, J8.1, J11.2, R19.2, R20.2, R21.2, R22.2, R23.2, R41.2, R42.2, R43.2, R44.2, U2.5, U3.5, U7.5, U9.1, U9.5, U9.17
+3V3_PERIPH: C8.1, C9.1, C10.1, C11.1, C41.1, C42.1, J3.22, J4.22, J11.15, L3.2, R4.2, R30.1
+5V_CM5: C1.1, C2.1, C3.1, C4.1, C7.1, C12.1, C13.1, J1.77, J1.79, J1.81, J1.83, J1.85, J1.87, J12.1, Q2.5, R56.1, U1.7, U1.8
/Audio/SPK_N: J5.2, U1.10
/Audio/SPK_P: J5.1, U1.9
/CM5/CM5_1V8: J1.88, J1.90
/CM5/CM5_NRPIBOOT: J1.93, TP1.1
/CM5/FAN_PWM: J1.19, J12.3
/CM5/FAN_TACH: J1.16, J12.4, R3.1
/DisplayCamera/DSI_PIN17: J3.17, R4.1
/LTE/LTE_USB_VBUS: J14.13, R56.2
/MCU/CM5_PMIC_OFF_DRV: Q5.1, R47.1, U9.13
/MCU/CM5_PWRBTN_DRV: Q4.1, R46.1, U9.12
/MCU/MCU_BOOT0: R36.1, U9.31
/MCU/MCU_NRST: C47.1, J8.4, U9.4
/MCU/MCU_RX: R39.1, U9.9
/MCU/MCU_TX: R38.1, U9.8
/MCU/MICSW_QOD: R45.1, U14.5
/MCU/MIC_PWR_EN: U9.21, U14.3
/MCU/NTC_ADC: C48.1, J10.1, R37.2, U9.14
/MCU/NTC_BIAS: R37.1, U9.22
/MCU/SWCLK: J8.3, U9.24
/MCU/SWDIO: J8.2, U9.23
/PowerInput/BAT_N: C24.2, C25.2, J7.3, J7.4, R18.1, U6.2, U6.6, U6.11
/PowerInput/BQ_QON_N: D4.2, U5.12
/PowerInput/CHG_BTST: C19.1, U5.21
/PowerInput/CHG_ILIM: R14.1, U5.10
/PowerInput/CHG_PMID: C18.1, U5.23
/PowerInput/CHG_REGN: C20.1, R15.1, R17.1, U5.22
/PowerInput/CHG_STAT: D3.1, U5.4
/PowerInput/CHG_STAT_LED_A: D3.2, R17.2
/PowerInput/CHG_SW: C19.2, L1.1, U5.19, U5.20
/PowerInput/CHG_TS: J7.5, R15.2, R16.1, U5.11
/PowerInput/GAUGE_REG: C25.1, U6.7
/PowerInput/PD_DISCH: R12.1, U4.9
/PowerInput/PD_VBUS_VS: R11.1, U4.18
/PowerInput/PD_VREG_1V2: C14.1, U4.21
/PowerInput/PD_VREG_2V7: C15.1, U4.23
/PowerInput/USB_CC1: J6.A5, U3.1, U3.6, U4.1, U4.2
/PowerInput/USB_CC2: J6.B5, U3.3, U3.4, U4.4, U4.5
/PowerInput/VBUS_C: C16.1, D2.2, J6.A4, J6.A9, J6.B4, J6.B9, Q1.1, Q1.2, Q1.3, R11.2, R13.2, U4.24
/PowerInput/VBUS_CHG: C17.1, Q1.5, R12.2, U5.1
/PowerInput/VBUS_EN_SNK: Q1.4, R13.1, U4.16
/Regulators/+5V_BOOST: C36.1, C37.1, C38.1, C43.2, Q2.1, Q2.2, Q2.3, R26.1, R34.2, U8.14, U8.15, U8.16
/Regulators/BST_BOOT: C32.1, U8.8
/Regulators/BST_COMP: C35.1, R28.1, U8.18
/Regulators/BST_COMP_RC: C34.1, R28.2
/Regulators/BST_FB: R26.2, R27.1, U8.17
/Regulators/BST_FSW: R24.1, U8.3
/Regulators/BST_ILIM: R25.1, U8.19
/Regulators/BST_SS: C33.1, U8.10
/Regulators/BST_SW: C32.2, L2.2, R24.2, U8.4, U8.5, U8.6, U8.7
/Regulators/BST_VCC: C31.1, U8.1
/Regulators/BUCK3V3_EN: R32.2, R33.1, U12.4
/Regulators/BUCK3V3_FB: R30.2, R31.1, U12.5
/Regulators/BUCK3V3_SW: L3.1, U12.2
/Regulators/LSW_GATE: C43.1, Q2.4, Q3.3, R34.1
/Sensors/HAPTIC_REG: C56.1, U11.1
/Sensors/LRA_N: J9.2, U11.9
/Sensors/LRA_P: J9.1, U11.7
AMP_SD_MODE: J1.48, R10.1, U1.4
BOOST_EN: R29.1, U8.2, U9.25
BTN_ACTION_N: C50.1, J11.16, R42.1, U9.7, U13.2
BTN_PWR_N: C49.1, D4.1, J11.12, R41.1, U9.6, U13.1
BTN_VOLDN_N: C52.1, J11.14, R44.1, U9.11, U13.5
BTN_VOLUP_N: C51.1, J11.13, R43.1, U9.10, U13.4
CAM_GPIO0: J1.97, J4.17
CAM_GPIO1: J1.100, J4.18
CAM_I2C_SCL: J1.80, J4.20
CAM_I2C_SDA: J1.82, J4.21
CHG_INT_N: R22.1, U5.7, U9.28
CM5_3V3: C5.1, C6.1, J1.78, J1.84, J1.86, R1.2, R2.2, R3.2, R5.2, R6.2, R9.2, R32.1, R40.2, R49.2, R50.2
CM5_5V_EN: Q3.1, R35.1, U9.15
CM5_ALIVE: J1.47, U9.27
CM5_PMIC_EN: J1.99, Q5.3
CM5_PWR_BUTTON: J1.92, Q4.3
CSI_C_N: J2.127, J4.8
CSI_C_P: J2.129, J4.9
CSI_D0_N: J2.115, J4.2
CSI_D0_P: J2.117, J4.3
CSI_D1_N: J2.121, J4.5
CSI_D1_P: J2.123, J4.6
CSI_D2_N: J2.133, J4.11
CSI_D2_P: J2.135, J4.12
CSI_D3_N: J2.139, J4.14
CSI_D3_P: J2.141, J4.15
DSI_C_N: J2.187, J3.8
DSI_C_P: J2.189, J3.9
DSI_D0_N: J2.175, J3.2
DSI_D0_P: J2.177, J3.3
DSI_D1_N: J2.181, J3.5
DSI_D1_P: J2.183, J3.6
DSI_D2_N: J2.193, J3.11
DSI_D2_P: J2.195, J3.12
DSI_D3_N: J2.194, J3.14
DSI_D3_P: J2.196, J3.15
DSI_I2C_SCL: J1.35, J3.20, R6.1
DSI_I2C_SDA: J1.36, J3.21, R5.1
GAUGE_ALRT_N: R23.1, U6.8, U9.18
GND: C1.2, C2.2, C3.2, C4.2, C5.2, C6.2, C7.2, C8.2, C9.2, C10.2, C11.2, C12.2, C13.2, C14.2, C15.2, C16.2, C17.2, C18.2, C20.2, C21.2, C22.2, C23.2, C26.2, C27.2, C28.2, C29.2, C30.2, C31.2, C33.2, C34.2, C35.2, C36.2, C37.2, C38.2, C39.2, C40.2, C41.2, C42.2, C44.2, C45.2, C46.2, C47.2, C48.2, C49.2, C50.2, C51.2, C52.2, C53.2, C54.2, C55.2, C56.2, C61.2, C62.2, D2.1, D5.1, J1.1, J1.2, J1.7, J1.8, J1.13, J1.14, J1.22, J1.23, J1.32, J1.33, J1.42, J1.43, J1.52, J1.53, J1.59, J1.60, J1.65, J1.66, J1.71, J1.74, J1.98, J2.107, J2.108, J2.113, J2.114, J2.119, J2.120, J2.125, J2.126, J2.131, J2.132, J2.137, J2.138, J2.144, J2.150, J2.155, J2.156, J2.161, J2.162, J2.167, J2.168, J2.173, J2.174, J2.179, J2.180, J2.185, J2.186, J2.191, J2.192, J2.197, J2.198, J3.1, J3.4, J3.7, J3.10, J3.13, J3.16, J3.19, J4.1, J4.4, J4.7, J4.10, J4.13, J4.16, J4.19, J6.A1, J6.A12, J6.B1, J6.B12, J6.S1, J8.5, J10.2, J11.1, J11.5, J11.8, J12.2, J14.7, J14.8, J14.9, J14.12, J14.14, J14.22, Q3.2, Q4.2, Q5.2, Q6.2, R8.2, R10.2, R14.2, R16.2, R18.2, R25.2, R27.2, R29.2, R31.2, R33.2, R35.2, R36.2, R46.2, R47.2, R48.2, R57.2, TP2.1, U1.3, U1.11, U1.15, U1.17, U2.2, U3.2, U4.6, U4.10, U4.12, U4.13, U4.22, U4.25, U5.8, U5.9, U5.17, U5.18, U5.25, U6.5, U7.2, U8.11, U8.12, U8.20, U8.21, U9.16, U9.32, U9.33, U11.4, U11.8, U12.1, U13.3, U13.8, U14.2
HAPTIC_EN: J1.46, R48.1, U11.5
I2C1_SCL: J1.56, R2.1, R50.1, U11.2
I2C1_SDA: J1.58, R1.1, R49.1, U11.3
I2S_BCLK: J1.49, J11.4, U1.16
I2S_DIN: J1.27, R7.2
I2S_DOUT: J1.25, U1.1
I2S_LRCLK: J1.26, J11.6, U1.14
LTE_AP_READY: J1.41, J14.21
LTE_PWRKEY: J1.30, J14.16
LTE_PWR_EN: J1.34, J14.15, R57.1
LTE_RESET: J1.28, J14.17
LTE_RI: J1.31, J14.20
LTE_STATUS: J1.29, J14.19
LTE_USB_DM: J2.136, J14.10
LTE_USB_DP: J2.134, J14.11
LTE_W_DISABLE_N: J1.24, J14.18
MCU_I2C_SCL: J11.10, R20.1, U4.7, U5.5, U6.3, U9.29
MCU_I2C_SDA: J11.9, R19.1, U4.8, U5.6, U6.4, U9.30
MCU_IRQ_N: J1.54, R40.1, U9.26
MIC_DATA_GATED: J11.7, R7.1
MIC_FEED: C54.1, J11.3, R45.2, U14.6
MIC_SW_LIVE: C53.1, D5.2, J11.11, Q6.1, R8.1, U14.1
MUTE_STATUS_IO: J1.50, Q6.3, R9.1, U9.20
PD_ALERT_N: R21.1, U4.19, U9.19
UART0_RX: J1.51, R38.2
UART0_TX: J1.55, R39.2
USB_DM: J2.103, J6.A7, J6.B7, U2.3, U2.4
USB_DP: J2.105, J6.A6, J6.B6, U2.1, U2.6
VBAT: C23.1, C24.1, C26.1, J7.1, J7.2, U5.13, U5.14, U6.10, U7.1, U7.3
VSYS: C21.1, C22.1, C29.1, C30.1, C39.1, C40.1, C55.1, C61.1, C62.1, J14.1, J14.2, J14.3, J14.4, J14.5, J14.6, L1.2, L2.1, U5.15, U5.16, U8.9, U11.6, U11.10, U12.3
