anand2532/PocketMate/(commit log)

2026-10-21 Add .gitignore for KiCad/FreeCAD backups
2026-10-21 Add market, components and BOM research
2026-10-21 Add KiCad schematic v1 and generator
    [PocketMate.kicad_sch, audio.kicad_sch, cm5.kicad_sch, display_camera.kicad_sch, mcu.kicad_sch, power_input.kicad_sch, regulators.kicad_sch, sensors_haptics.kicad_sch]
2026-10-21 Add FreeCAD enclosure v2 and build script
    [pocketmate_enclosure_v2.FCStd]
2026-10-21 Add schematic v1 PDF
2026-10-21 Add enclosure v2 STEP exports
    [pocketmate_al_back_plate_v2.step, pocketmate_assembly_v2.step, pocketmate_back_frame_v2.step, pocketmate_front_shell_v2.step, pocketmate_inserts_v2.step]
2026-10-21 Add enclosure v2 renders
2026-10-21 Add battery RFQ research referenced by architecture v0.3.10
2026-10-21 Sync research/bom.md with latest source
2026-10-21 Re-render screens for CR1; add 09c camera translate and 22 daily summary
2026-10-21 Sync KiCad schematic to netlist v3.2; add side_flex sheet
    [PocketMate.kicad_sch, audio.kicad_sch, cm5.kicad_sch, display_camera.kicad_sch, mcu.kicad_sch, power_input.kicad_sch, regulators.kicad_sch, sensors_haptics.kicad_sch]
2026-10-21 Update schematic generator, nets and ERC report for netlist v3.2
2026-10-21 Update schematic PDF for netlist v3.2
2026-10-21 Add project footprint library referenced by schematic
2026-10-21 Add hardware power and CM5 config docs
2026-10-21 Add PCB layout and design rules
    [PocketMate.kicad_pcb]
2026-10-21 Add footprint generation and check scripts
2026-10-21 Add placement plan, layout scripts, impedance results and PCB renders
2026-10-21 Add schematic BOM export
    [PocketMate_BOM.csv]
2026-10-21 Add FreeCAD enclosure v4_22c and build script
    [pocketmate_enclosure_v4_22c.FCStd]
2026-10-21 Add enclosure v4_22c STEP exports
    [pocketmate_al_unibody_v4_22c.step, pocketmate_assembly_v4_22c.step, pocketmate_plastics_v4_22c.step, pocketmate_sidekey_flex_v4_22c.step]
2026-10-21 Add enclosure v4_22c renders
2026-10-21 Point mechanical README to v4_22c as current
2026-10-27 Add research/camera-rfq.md
2026-10-27 Update battery RFQ to Rev D
2026-10-27 Sync enclosure v4_22c model, STEP and renders with latest source
    [pocketmate_al_unibody_v4_22c.step, pocketmate_assembly_v4_22c.step, pocketmate_enclosure_v4_22c.FCStd, pocketmate_plastics_v4_22c.step, pocketmate_sidekey_flex_v4_22c.step]
2026-10-27 Add v4_22c board outline DXF and its generator
    [board_outline_v4_22c.dxf]
2026-10-27 Sync schematic with LTE link sheet (lte_link.kicad_sch), generator, nets, ERC report and PDF
    [PocketMate.kicad_sch, audio.kicad_sch, cm5.kicad_sch, display_camera.kicad_sch, lte_link.kicad_sch, mcu.kicad_sch, power_input.kicad_sch, regulators.kicad_sch]
2026-10-27 Sync PCB layout and design rules with latest source
    [PocketMate.kicad_pcb]
2026-10-27 Add kicad-lte module footprint project (EC25/EC200U pad-compatible)
    [kicad-lte.kicad_pcb]
2026-10-27 mechanical/release_v5: assembly STEP and 25 per-part STEPs
    [ActionCap_PC_release_v5.step, Al_Unibody_release_v5.step, BattPad_NTCpocket_release_v5.step, Bezel_DisplayFrame_PC_release_v5.step, CameraWindow_PC_release_v5.step, Coax_Div_release_v5.step, Coax_GNSS_release_v5.step, Coax_Main_release_v5.step]
2026-10-27 mechanical/release_v5: 12 STL meshes
    [ActionCap_PC_release_v5.stl, Al_Unibody_release_v5.stl, Bezel_DisplayFrame_PC_release_v5.stl, CameraWindow_PC_release_v5.stl, GripInlay_L_release_v5.stl, GripInlay_R_release_v5.stl, HeatSpreader_Cu_0p5_release_v5.stl, LTE_Daughterboard_PCB_release_v5.stl]
2026-10-27 mechanical/release_v5: PDF drawing set and 18 DXF profiles
    [bezel_plan_release_v5.dxf, flat_Foam_Prod_0p5_release_v5.dxf, flat_Foam_Proto_2p0_release_v5.dxf, flat_HeatSpreader_Cu_0p5_release_v5.dxf, flat_Liner_PET_Prod_release_v5.dxf, flat_Liner_PET_Proto_release_v5.dxf, flat_ThermalPad_Post_0p3_release_v5.dxf, flat_ThermalPad_Shield_0p5_release_v5.dxf]
2026-10-27 mechanical: point README to release_v5 as current enclosure
2026-10-27 research: add proto-bom-india.md (prototype BOM, qty 1, Indian stockists, v1)
2026-10-27 research/cellular-4g: add section 8 (2026-10-27 answers for Schematic, supersedes 7.2-7.4)
2026-10-27 research/battery-rfq: scope note Rev C -> Rev D
2026-10-27 mechanical/release_v5: remove diversity window and diversity coax (v5.1, diversity: none)
    [Coax_Div_release_v5.step, RFWindow_LTE_Div_BL_PC_release_v5.step, RFWindow_LTE_Div_BL_PC_release_v5.stl, window_RFWindow_LTE_Div_BL_PC_release_v5.dxf]
2026-10-27 mechanical/release_v5: v5.1 assembly and per-part STEPs (O1 fix, GNSS envelopes, 47 mm LTE board)
    [ActionCap_PC_release_v5.step, Al_Unibody_release_v5.step, BattPad_NTCpocket_release_v5.step, Bezel_DisplayFrame_PC_release_v5.step, CameraWindow_PC_release_v5.step, Coax_GNSS_release_v5.step, Coax_Main_release_v5.step, Foam_Prod_0p5_release_v5.step]
2026-10-27 mechanical/release_v5: v5.1 STLs (11)
    [Al_Unibody_release_v5.stl, LTE_Daughterboard_PCB_release_v5.stl]
2026-10-27 mechanical/release_v5: v5.1 17-sheet PDF and DXFs (47x49 LTE outline)
    [bezel_plan_release_v5.dxf, flat_Foam_Prod_0p5_release_v5.dxf, flat_Foam_Proto_2p0_release_v5.dxf, flat_HeatSpreader_Cu_0p5_release_v5.dxf, flat_Liner_PET_Prod_release_v5.dxf, flat_Liner_PET_Proto_release_v5.dxf, flat_ThermalPad_Post_0p3_release_v5.dxf, flat_ThermalPad_Shield_0p5_release_v5.dxf]
2026-10-27 mechanical/release_v5: O10 re-export of assembly (77 bodies) and 23 part STEPs (custom 22-pin FFC)
    [ActionCap_PC_release_v5.step, Al_Unibody_release_v5.step, BattPad_NTCpocket_release_v5.step, Bezel_DisplayFrame_PC_release_v5.step, CameraWindow_PC_release_v5.step, Coax_GNSS_release_v5.step, Coax_Main_release_v5.step, Foam_Prod_0p5_release_v5.step]
2026-10-27 mechanical/release_v5: O10 re-export of 17-sheet PDF and DXFs
    [bezel_plan_release_v5.dxf, flat_Foam_Prod_0p5_release_v5.dxf, flat_Foam_Proto_2p0_release_v5.dxf, flat_HeatSpreader_Cu_0p5_release_v5.dxf, flat_Liner_PET_Prod_release_v5.dxf, flat_Liner_PET_Proto_release_v5.dxf, flat_ThermalPad_Post_0p3_release_v5.dxf, flat_ThermalPad_Shield_0p5_release_v5.dxf]
2026-10-27 WIP: software os, dts overlays (+built .dtbo), firmware, lte
    [config.txt]
2026-10-27 Enclosure v5.1: add coax_geom.py/coax_probe.py, update build/check/export scripts
2026-10-27 Enclosure v5.1: regenerate STEP, STL, DXF and PDF outputs (in sync 00:07 IST)
    [ActionCap_PC_release_v5.step, Al_Unibody_release_v5.step, BattPad_NTCpocket_release_v5.step, Bezel_DisplayFrame_PC_release_v5.step, CameraWindow_PC_release_v5.step, Coax_GNSS_release_v5.step, Coax_Main_release_v5.step, Foam_Prod_0p5_release_v5.step]
2026-10-27 Enclosure v5.1: O12 resolved, main antenna feed corrected (README, interference check)
2026-10-27 Research: cellular-4g USB3-0 fix and new §8.3a antenna section
2026-10-27 Research: battery-rfq PCM trip-delay questions
2026-10-27 Research: proto-bom-india antenna row notes
2026-10-27 Enclosure v5.1 O14: add fillet_path.py, update build/check/export/key-gaps scripts
2026-10-27 Enclosure v5.1 O14: regenerate STEP/STL outputs, add slack-loop clip parts
    [ActionCap_PC_release_v5.step, Al_Unibody_release_v5.step, BattPad_NTCpocket_release_v5.step, Bezel_DisplayFrame_PC_release_v5.step, CameraWindow_PC_release_v5.step, Clip_Slack_Post_B_release_v5.step, Clip_Slack_Post_B_release_v5.stl, Clip_Slack_Saddle_A_release_v5.step]
2026-10-27 Enclosure v5.1 O14: regenerate DXF/PDF drawings, add slack_loop sheets
    [bezel_plan_release_v5.dxf, flat_Foam_Prod_0p5_release_v5.dxf, flat_Foam_Proto_2p0_release_v5.dxf, flat_HeatSpreader_Cu_0p5_release_v5.dxf, flat_Liner_PET_Prod_release_v5.dxf, flat_Liner_PET_Proto_release_v5.dxf, flat_ThermalPad_Post_0p3_release_v5.dxf, flat_ThermalPad_Shield_0p5_release_v5.dxf]
2026-10-27 Enclosure v5.1 O14: README, interference check and renders
